radxa/radxa-cm-projects/README.md

## About

Welcome to the Radxa Computer on Module projects, this repo contains the carrier board design files released by Radxa as well as the community projects.

## CM Series

| CM Series | Description | Projects |
| --- | --- | --- |
| [Radxa CM3](https://rock.sh/cm3) | Computer on Module based on RK3566, compatible with Raspberry Pi CM4 | [CM3 Projects](./cm3/README.md) |
| [Radxa CM3I](https://rock.sh/cm3i) | Computer on Module based on RK3568(J) with industrial grade options | [CM3I Projects](./cm3i/README.md) |
| [Radxa CM4](https://rock.sh/cm4) | Computer on Module based on RK3676(J), compatible with Raspberry Pi CM4 | [CM4 Projects](./cm4/README.md) |
| [Radxa CM5](https://rock.sh/cm5) | Computer on Module based on RK3588S, compatible with Raspberry Pi CM4 | [CM5 Projects](./cm5/README.md) |

## NX Series

| NX Series | Description | Projects |
| --- | --- | --- |
| [Radxa CM3S](https://rock.sh/cm3s) | Computer on Module based on RK3566 in SODIMM form factor, compatible with Raspberry Pi CM3/CM3+ | [CM3S Projects](./cm3s/README.md) |
| [Radxa NX5](https://rock.sh/nx5) | Computer on Module based on RK3588S in SODIMM form factor | [NX5 Projects](./nx5/README.md) |
