radxa/radxa-cm-projects/cm5/README.md

## Apply for Radxa CM5

Radxa is donating some free [Radxa CM5](hhttps://rock.sh/cm5) to open source hardware projects.

## How to apply

Send a new PR to this repository on GitHub, append your application table(sort Project Name). Radxa team will review/ask questions/discuss about the project detail. If the project is interesting or welcomed by the community, we will approve it. Radxa Team will contact the developer for the further sample shipping&development etc.

## CM5 projects list:

| Project Name | CM5 Model | Hardware(Carrier Board) | Software | Notes |
|---|---|---|---|---|
| Argo | Radxa CM5 Max (16GB RAM, 128GB eMMC) | Custom Raspberry Pi–focused Carrier PCB | Ubuntu/Android | For testing with custom Raspi-focused Carrier PCB |
