radxa/radxa-cm-projects/cm3i/README.md

## Apply for Radxa CM3I

Radxa is donating some free [Radxa CM3I](https://rock.sh/cm3i) to open source hardware projects.

## How to apply

Send a new PR to this repository on GitHub, append your application table(sort Project Name). Radxa team will review/ask questions/discuss about the project detail. If the project is interesting or welcomed by the community, we will approve it. Radxa Team will contact the developer for the further sample shipping&development etc.

## CM3I projects list:

| Project Name | CM3 Model | Hardware(Carrier Board) | Software | Notes |
| --- | --- | --- | --- | ----- |
| Radxa E25 | RM118-D4E32 | [E25 Carrier Board Design](./radxa-e25/README.md) | [OpenWRT](https://https://github.com/ophub/flippy-openwrt-actions) | |
| Radxa CM3I IO Board  |  | [CM3I IO Board Design](./radxa-cm3i-io-board/README.md) |  | |
