radxa/radxa-cm-projects/nx5/radxa-nx5-io-board/README.md

# HW Design for Radxa NX5 IO board

- radxa_nx5_io_board_v1.4.DSN: io board schematic, use Orcad 16.6 or later to view it. You can download a free copy viewer [here](https://www.orcad.com/downloads/orcad-viewer)(Windows only).
- radxa_nx5_io_board_v1.4.pcb: io board layout, use Pads 2.5VX or later to view it. You can find a free copy viewer [here](https://community.sw.siemens.com/s/article/PADS-Viewers)(Windows only).

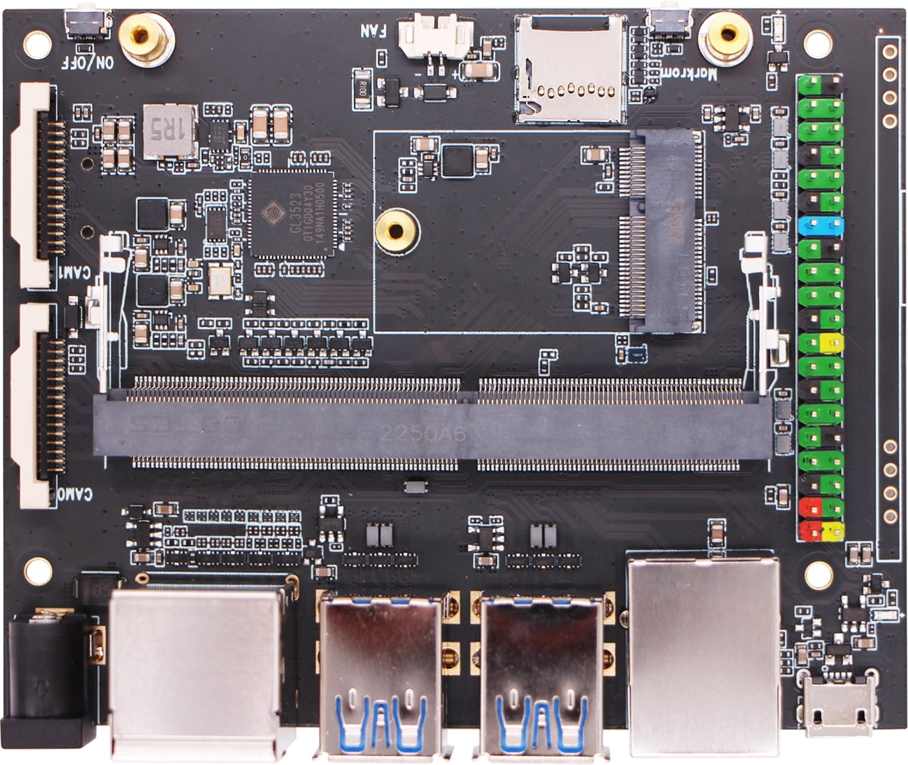
[picture p2: nx5/radxa-nx5-io-board/radxa_nx5_io_board.jpg]
Radxa NX5 IO Board
