radxa/radxa-cm-projects/cm3/radxa-cm3-io-board/README.md

# HW Design for Radxa CM3 IO board

- radxa_cm3_io_board_v1330.DSN: io board schematic, use Orcad 16.6 or later to view it. You can download a free copy viewer [here](https://www.orcad.com/downloads/orcad-viewer)(Windows only).
- radxa_cm3_io_board_v1330.pcb: io board layout, use Pads 2.5VX or later to view it. You can find a free copy viewer [here](https://community.sw.siemens.com/s/article/PADS-Viewers)(Windows only).

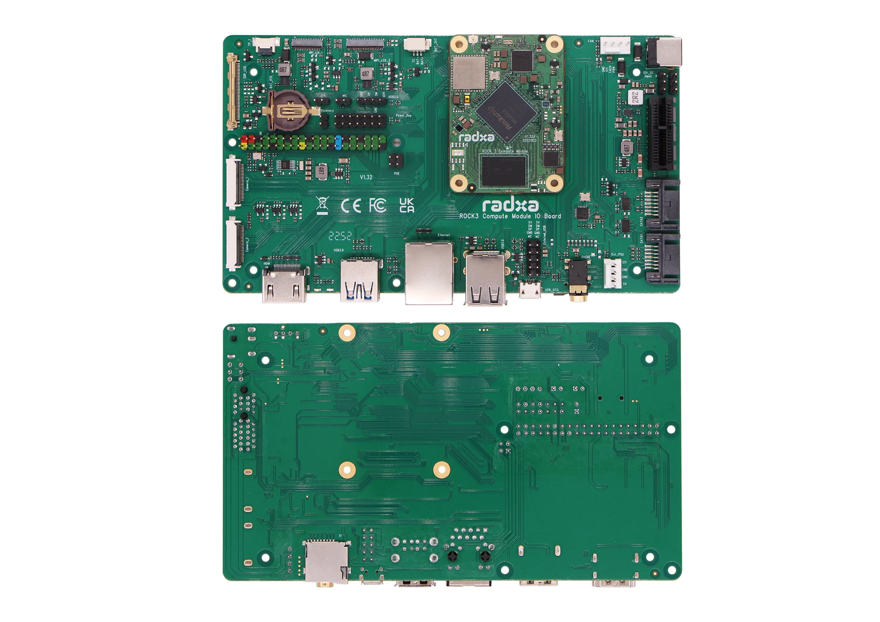
[picture p3: cm3/radxa-cm3-io-board/radxa_cm3_io_board.jpg]
Radxa CM3 IO Board
