radxa/radxa-cm-projects/cm3i/radxa-cm3i-io-board/README.md

# HW Design for Radxa CM3I IO board

- radxa_cm3i_io_board_v1.4.DSN: io board schematic, use Orcad 16.6 or later to view it. You can download a free copy viewer [here](https://www.orcad.com/downloads/orcad-viewer)(Windows only).
- radxa_cm3i_io_board_v1.4.pcb: io board layout, use Pads 2.5VX or later to view it. You can find a free copy viewer [here](https://community.sw.siemens.com/s/article/PADS-Viewers)(Windows only).

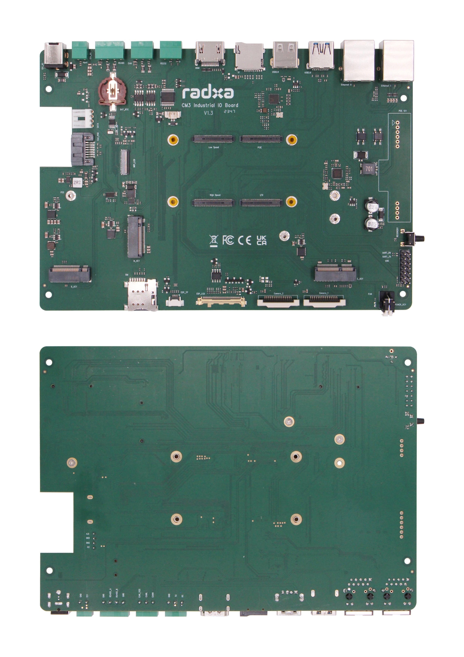
[picture p4: cm3i/radxa-cm3i-io-board/radxa_cm3i_io_board.jpg]
Radxa CM3I IO Board
