radxa/radxa-cm-projects/cm3i/radxa-e25/README.md

# HW Design for Radxa E25 Carrier Board

- Radxa_E25_V14_20220117.DSN: board schematic, use Orcad 16.6 or later to view it. You can download a free copy viewer [here](https://www.orcad.com/downloads/orcad-viewer)(Windows only).
- Radxa_E25_V1.4_20220119-padsvx.pcb: board layout PCB, use Pads 2.5VX or later to view it. You can find a free copy viewer [here](https://community.sw.siemens.com/s/article/PADS-Viewers)(Windows only).
- Radxa_E25_V1.4_20220119-pads2005.asc: board layout PCB in ASCII format, import to PADs 2005 to view it.
- Radxa_E25_V1.4_20220119.PcbDoc: board layout PCB, use Altium Designer to view it.

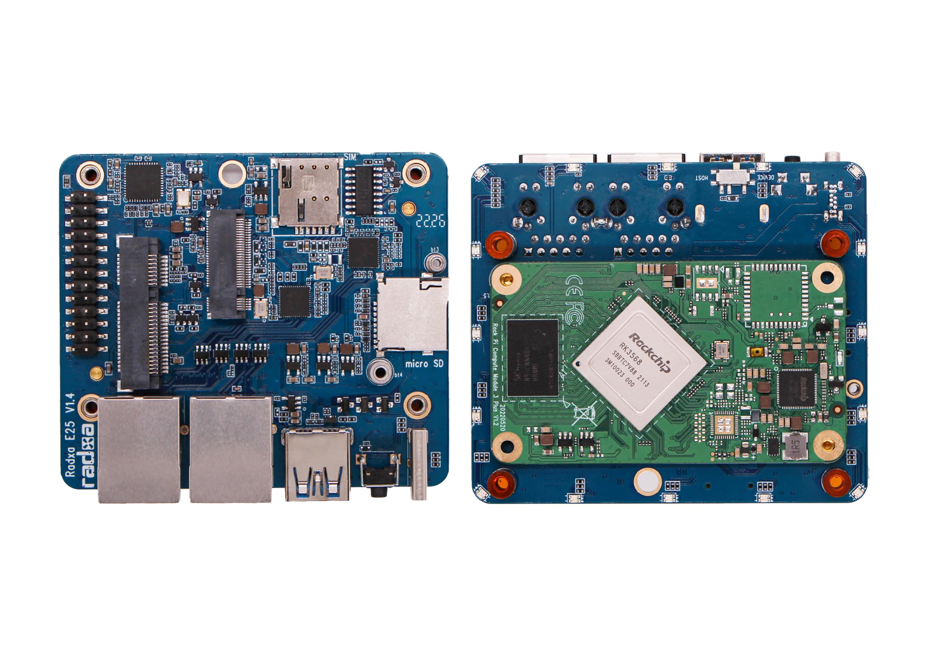
[picture p5: cm3i/radxa-e25/radxa_e25.jpg]
Radxa E25
