radxa/radxa-cm-projects/cm3s/radxa_cm3s_io_board/README.md

# HW Design for Radxa CM3S IO board

- radxa_cm3s_io_board_v1510.DSN: io board schematic, use Orcad 16.6 or later to view it. You can download a free copy viewer [here](https://www.orcad.com/downloads/orcad-viewer)(Windows only).
- radxa_cm3s_io_board_v1510.pcb: io board layout, use Pads 2.5VX or later to view it. You can find a free copy viewer [here](https://community.sw.siemens.com/s/article/PADS-Viewers)(Windows only).

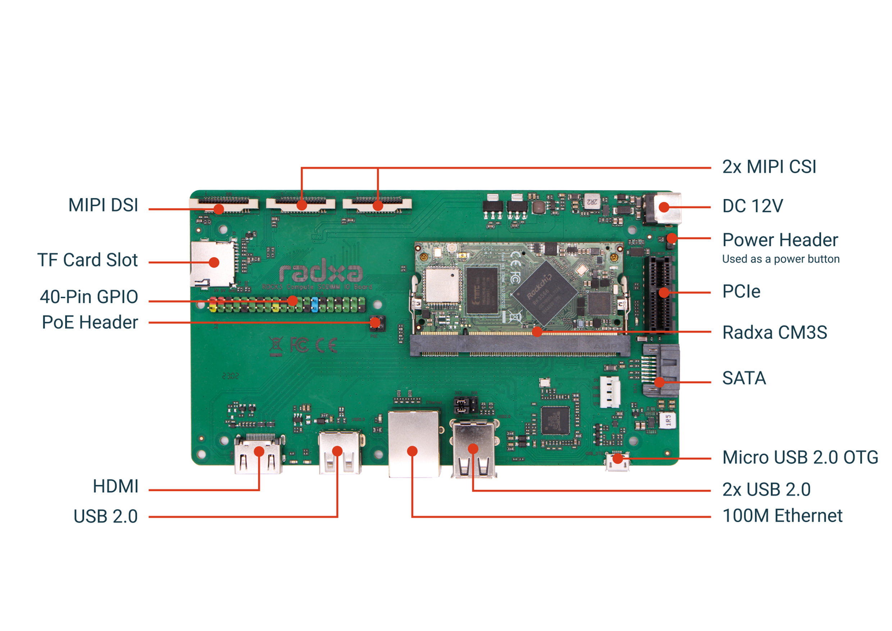
[picture p6: cm3s/radxa_cm3s_io_board/radxa_cm3s_io_board.jpg]
Radxa CM3S IO Board
