radxa/radxa-cm-projects/cm5/radxa-cm5-io-board/README.md

# HW Design for Radxa CM5 IO board

- radxa_cm5_io_board_v2200.DSN: io board schematic, use Orcad 16.6 or later to view it. You can download a free copy viewer [here](https://www.orcad.com/downloads/orcad-viewer)(Windows only).
- radxa_cm5_io_board_v2200.pcb: io board layout, use Pads 2.5VX or later to view it. You can find a free copy viewer [here](https://community.sw.siemens.com/s/article/PADS-Viewers)(Windows only).

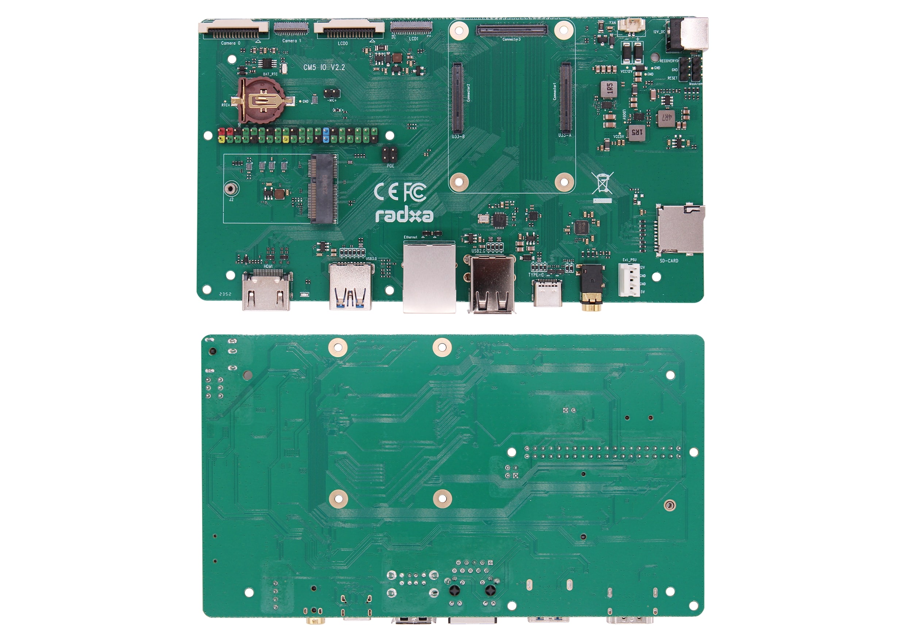
[picture p7: cm5/radxa-cm5-io-board/radxa_cm5_io_board.jpg]
Radxa CM5 IO Board
