radxa/radxa-cm-projects/cm4/README.md

## Apply for Radxa CM4

Radxa is donating some free [Radxa CM4](hhttps://rock.sh/cm4) to open source hardware projects.

## How to apply

Send a new PR to this repository on GitHub, append your application table(sort Project Name). Radxa team will review/ask questions/discuss about the project detail. If the project is interesting or welcomed by the community, we will approve it. Radxa Team will contact the developer for the further sample shipping&development etc.

## CM4 projects list:

| Project Name | CM4 Model | Hardware(Carrier Board) | Software | Notes |
| --- | --- | --- | --- | --- |
