radxa/radxa-cm-projects/cm3s/README.md

## Apply for Radxa CM3S

Radxa is donating some free [Radxa CM3S](https://rock.sh/cm3s) to open source hardware projects.

## How to apply

Send a new PR to this repository on GitHub, append your application table(sort Project Name). Radxa team will review/ask questions/discuss about the project detail. If the project is interesting or welcomed by the community, we will approve it. Radxa Team will contact the developer for the further sample shipping&development etc.

## CM3S projects list:

| Project Name | CM3S Model | Hardware(Carrier Board) | Software | Notes |
| --- | --- | --- | --- | --- |
