radxa/radxa-cm-projects/nx5/README.md

## Apply for Radxa NX5

Radxa is donating some free [Radxa NX5](https://rock.sh/nx5) to open source hardware projects.

## How to apply

Send a new PR to this repository on GitHub, append your application table(sort Project Name). Radxa team will review/ask questions/discuss about the project detail. If the project is interesting or welcomed by the community, we will approve it. Radxa Team will contact the developer for the further sample shipping&development etc.

## NX5 projects list:

| Project Name | NX5 Model | Hardware(Carrier Board) | Software | Notes |
| --- | --- | --- | --- | --- |
