radxa/radxa-cm-projects/cm4/radxa-cm4-io-board/radxa_cm4_io_bom_v1.10.xlsx

子物料名称 | 子物料规格型号描述 | 数量 | 装配位置
RJ45座 | DIP 母座 千兆网 带POE功能 18PIN 21.5*16*13.7mm HRK1-1B71PG536A1BB-1R 带指示灯 无弹片 左绿右黄 镀镍 HULYN(惠兴力) ROHS | 1 | J6
RJ45座 | DIP 母座 千兆网 带POE功能 18PIN 21.5*16*13.7MM LPJG0926HENL 带指示灯 无弹片 左绿右黄 镀镍 LINK-PP(连普) ROHS | 1 | J6
DC座 | DIP 6PIN DC-044A-A250 内孔Φ6mm 铁芯Φ2.5mm 9.93*11.7*H7.2mm XUNPU(讯普) ROHS | 1 | J24
USB2.0母座 | DIP USB2.0母座 双层 卷边无定位柱 黑色胶芯 17.5x14.6xH15.7mm 90度弯脚 弯脚固定间距15.4mm 铜壳 BUSF082B1N12438L 耐高温 BVT-LINK(兴联精密) ROHS | 1 | J13
排座 | DIP 排针座 2*2PIN 180度 2.54mm脚距 中间朔高2.5mm 针长一端6.1mm 另一端3.0mm 黑色 PH2.54 2*02P L=11.6/3.0 S/T 国意英 ROHS | 1 | J7
排座 | DIP 排针座 1*2PIN 180度 2.0mm脚距 中间朔高2.0mm 针长一端3.9mm 另一端2.8mm 方针 黑色 ZX-PZ2.0-1-2PZZ Megastar(兆星) ROHS | 2 | J18,J19
排座 | DIP 排针座 1*2PIN 180度 2.54mm脚距 中间朔高2.5mm 针长一端6.1mm 另一端3.0mm 黑色 PH2.54 1*2P L=11.6/3.0 国意英 ROHS | 1 | J2
排座 | DIP 排针座 1*3PIN 180度 2.54mm脚距 中间朔高2.5mm 针长一端6.1mm 另一端3.0mm 材质LCP 黑色 PH2.54 1*3P L=11.6/3.0 国意英 ROHS | 1 | J22
排座 | DIP 排针座 1*4PIN 180度 无定位柱 2.54mm脚距 针长一端8.3mm 另一端3.5mm 小4PIN 白色 M2545V-4P XFCN(兴飞) ROHS | 1 | J4
排座 | DIP 排针座 2*20PIN 180度 2.54mm脚距 中间朔高2.5mm 针长一端6.1mm 另一端3.0mm 彩色 PH-A-40D-A6C3-D-RGB 闻川 ROHS | 1 | J11
排座 | DIP 排针座 2*20PIN 180度 2.54mm脚距 中间朔高2.5mm 针长一端6.1mm 另一端3.0mm 彩色 PH2.54 2*20P 彩印 L=11.6/3.0 国意英 ROHS | 1 | J11
排座 | DIP 排针座 2*7PIN 180度 2.54mm脚距 中间朔高2.5mm 针长一端6.1mm 另一端3.0mm 黑色 PH2.54 2*7P L=11.6/3.0 S/T 国意英 ROHS | 1 | J17
PCBA | RC126 V1.104 Radxa CM4 IO Board | 1
PCB板 | RC126 V1.10 160*90*1.6mm FR-4 4层板 表面沉金处理 哑光绿油 白色丝印 ROHS | 1
贴片电阻 | SMD 0201 0R 1/20W ±5% ROHS | 29 | R26,R27,R178,R214,R223,R231,R233,R237,R252,R273,R274,R276,R284,R293,R294,R295,R296,R297,R320,R328,R346,R347,R348,R349,R279,R357,R226,R217,R232
贴片电阻 | SMD 0201 100K 1/20W ±1% ROHS | 26 | R5,R6,R176,R182,R185,R202,R206,R236,R257,R305,R315,R319,R321,R329,R330,R331,R332,R333,R334,R335,R336,R337,R338,R339,R344,R355
贴片电阻 | SMD 0201 100R 1/20W ±5% ROHS | 1 | R304
贴片电阻 | SMD 0201 10K 1/20W ±1% ROHS | 21 | R8,R9,R11,R12,R209,R211,R212,R240,R250,R251,R261,R262,R270,R271,R303,R323,R351,R358,R72,R327,R210
贴片电阻 | SMD 0201 150K 1/20W ±1% ROHS | 1 | R249
贴片电阻 | SMD 0201 15K 1/20W ±1% ROHS | 1 | R247
贴片电阻 | SMD 0201 1K 1/20W ±1% ROHS | 6 | R14,R19,R208,R246,R322,R350
贴片电阻 | SMD 0201 2.2K 1/20W ±5% ROHS | 1 | R291
贴片电阻 | SMD 0201 22R 1/20W ±1% ROHS | 10 | R2,R29,R109,R228,R234,R256,R258,R259,R260,R265
贴片电阻 | SMD 0201 232K 1/20W ±1% ROHS | 3 | R187,R285,R287
贴片电阻 | SMD 0201 2M 1/20W ±5% ROHS | 2 | R340,R341
贴片电阻 | SMD 0201 3.3K 1/20W ±1% ROHS | 1 | R281
贴片电阻 | SMD 0201 3.3R 1/20W ±5% ROHS | 1 | R115
贴片电阻 | SMD 0201 340R 1/20W ±1% ROHS | 1 | R354
贴片电阻 | SMD 0201 4.7K 1/20W ±5% ROHS | 2 | R3,R7
贴片电阻 | SMD 0201 470R 1/20W ±5% ROHS | 2 | R316,R317
贴片电阻 | SMD 0201 49.9K 1/20W ±1% ROHS | 2 | R290,R318
贴片电阻 | SMD 0201 5.1K 1/20W ±5% ROHS | 1 | R177
贴片电阻 | SMD 0201 510K 1/20W ±1% ROHS | 1 | R289
贴片电阻 | SMD 0201 510R 1/20W ±5% ROHS | 4 | R238,R253,R221,R227
贴片电阻 | SMD 0201 51K 1/20W ±1% ROHS | 1 | R205
贴片电阻 | SMD 0201 7.5K 1/20W ±5% ROHS | 1 | R175
贴片电阻 | SMD 0201 75R 1/20W ±5% ROHS | 1 | R201
贴片电阻 | SMD 0201 8.2K 1/20W ±1% ROHS | 1 | R179
贴片电阻 | SMD 0402 0R 1/16W ±5% ROHS | 1 | R254
贴片电阻 | SMD 0603 2R 1/10W ±5% ROHS | 2 | R244,R245
陶瓷电容 | SMD 0201 100NF 25V X5R ±20% ROHS | 61 | C1,C79,C90,C144,C146,C148,C152,C154,C158,C159,C163,C168,C169,C171,C174,C175,C178,C180,C181,C184,C186,C188,C191,C193,C194,C197,C199,C204,C205,C206,C208,C210,C212,C214,C215,C218,C220,C221,C222,C225,C226,C228,C230,C231,C235,C236,C238,C240,C243,C249,C250,C251,C252,C253,C254,C269,C271,C282,C298,C83,C162
陶瓷电容 | SMD 0201 100PF 50V NPO ±5% ROHS | 4 | C286,C293,C201,C242
陶瓷电容 | SMD 0201 10NF 10V X5R ±20% ROHS | 4 | C284,C289,C291,C296
陶瓷电容 | SMD 0201 12PF 50V COG ±5% ROHS | 1 | C187
陶瓷电容 | SMD 0201 1UF 10V X5R ±20% ROHS | 9 | C150,C151,C196,C247,C248,C270,C277,C283,C290
陶瓷电容 | SMD 0201 2.2NF 25V X7R ±10% ROHS | 1 | C155
陶瓷电容 | SMD 0201 220NF 25V X5R ±10% ROHS | 1 | C77
陶瓷电容 | SMD 0201 220PF 50V NPO ±5% ROHS | 2 | C257,C258
陶瓷电容 | SMD 0201 22PF 50V NPO ±5% ROHS | 2 | C160,C217
陶瓷电容 | SMD 0201 680PF 50V X7R ±10% ROHS | 4 | C287,C288,C294,C295
陶瓷电容 | SMD 0201 82PF 50V COG ±2% ROHS | 2 | C279,C280
陶瓷电容 | SMD 0402 10UF 10V X5R ±20% ROHS | 11 | C190,C192,C203,C207,C209,C227,C229,C233,C234,C237,C239
陶瓷电容 | SMD 0402 4.7UF 10V X5R ±20% ROHS | 6 | C202,C241,C244,C272,C273,C274
陶瓷电容 | SMD 0603 10UF 10V X5R ±10% ROHS | 9 | C167,C176,C179,C182,C183,C185,C172,C285,C292
陶瓷电容 | SMD 0603 2.2UF 50V X5R ±10% ROHS | 1 | C177
陶瓷电容 | SMD 0603 22UF 10V X5R ±20% ROHS | 19 | C78,C106,C107,C153,C156,C157,C164,C198,C200,C213,C216,C255,C275,C278,C297,C211,C219,C223,C224
陶瓷电容 | SMD 0805 22UF 25V X5R ±20% ROHS | 4 | C84,C89,C161,C256
肖特基二极管 | SMD 编带 DO-214AC SS34 CJ(江苏长电/长晶) ROHS | 1 | D24
肖特基二极管 | SMD 编带 DO-214AC SS54 晶导微电子 ROHS | 1 | D4
肖特基二极管 | SMD 编带 SOD-323 B5819WS CJ(江苏长电/长晶) ROHS | 1 | D6
肖特基二极管 | SMD 编带 SOD-523 SD103AX CJ(江苏长电/长晶) ROHS | 1 | D8
肖特基二极管 | SMD 编带 SOT-23 BAT54C 30V 0.2A CJ(江苏长电/长晶) ROHS | 1 | D29
发光二极管 | SMD 编带 0603 发绿光 单色 mcd=150 IF=20mA 无色散光 EY-TB0603GC-010F 恩域光电 ROHS | 1 | LED3
发光二极管 | SMD 编带 0603 发红光 单色 mcd=150 IF=20mA 无色散光 EY-PB0603RC-010F 恩域光电 ROHS | 1 | LED2
三极管 | SMD 编带 SOT-23 S8050 NPN CJ(江苏长电/长晶) ROHS | 2 | Q18,Q23
MOS管 | SMD 编带 SOT23-3 AO3401A P沟道 AOS ROHS | 2 | Q12,Q24
MOS管 | SMD 编带 SOT-23-3L AO3416 N沟道 AOS ROHS | 1 | Q21
MOS管 | SMD 编带 SOT-323 2SK3018 N沟道 CJ(江苏长电/长晶) ROHS | 4 | Q2,Q3,Q19,Q20
MOS管 | SMD 编带 SOT-23 WPM2083-3/TR P沟道 WILLSEMI(韦尔) ROHS | 3 | Q1,Q17,Q22
MOS管 | SMD 编带 SOT-23 WPM2015-3/TR P沟道 WILLSEMI(韦尔) ROHS | 3 | Q1,Q17,Q22
MOS管 | SMD 编带 SOT-323 WNM2021-3/TR N沟道 WILLSEMI(韦尔) ROHS | 2 | Q13,Q25
ESD管 | SMD 编带 DFN2510-10L BTRD10A01 4Line 0.1pF B-TRON(比创达) ROHS | 4 | U34,U35,U18,U19
ESD管 | SMD 编带 0402 BTR04G02 B-TRON(比创达) ROHS | 43 | D2,D3,D7,D9,D10,D11,D12,D14,D15,D16,D17,D18,D19,D20,D21,D22,D23,D25,D26,D27,D28,D31,D32,D33,D34,D35,D36,D37,D38,D39,D40,D41,D42,D43,D44,D45,D46,D47,D48,D49,D50,D51,D52
TVS管 | SMD 编带 SOD-123 SMF18A 晶导微电子 ROHS | 1 | D5
TVS管 | SMD SOD-123FL SMF5.0CA 晶导微电子 ROHS | 1 | D1
贴片功率电感 | SMD 带屏蔽 2.5x2x1.2mm 1UH 4A ±20% RHP252012T-1R0MT 仁芯微 ROHS | 2 | L22,L29
贴片功率电感 | SMD 带屏蔽 2.5x2.0x1.26mm 1UH 3.4A ±30% RXWHJ252012-1R0NT 仁芯微 ROHS | 2 | L22,L29
贴片功率电感 | SMD 带屏蔽 3x3x1.5mm 4.7UH 3.5A ±20% RHP3015T-4R7MT 仁芯微 ROHS | 1 | L20
贴片功率电感 | SMD 带屏蔽 3x3x1.55mm 4.7UH 1.9A ±20% RXWHJ3015-4R7MT 仁芯微 ROHS | 1 | L20
贴片功率电感 | SMD 带屏蔽 4x4x2mm 4.7UH 3.3A ±20% RXWHJ4020-4R7MT 仁芯微 ROHS | 1 | L21
贴片功率电感 | SMD 带屏蔽 5.4*5.2*1.8mm 4.7UH 3.5A ±20% RXWSHC0520-4R7M 仁芯微 ROHS | 1 | L15
贴片功率电感 | SMD 带屏蔽 7.2x6.6x5mm 2.2UH 8A ±20% RXWSHC0650-2R2M 仁芯微 ROHS | 1 | L2
共模电感 | SMD BCMEF122P900H 90R 6PIN 带ESD ±25% B-TRON(比创达) ROHS | 4 | L16,L17,L18,L19
共模电感 | SMD BCMF122P900H 90R 4PIN 不带ESD ±5% B-TRON(比创达) ROHS | 4 | FB8,L23,L24,L31
贴片磁珠 | SMD 0201 FB120R 1A MPZ0603S121HT000 ±25% ROHS | 6 | FB14,FB15,FB16,FB17,FB21,R31
贴片磁珠 | SMD 0402 FB120R 2A ±25% BLM15PX121SN1D muRata(村田) ROHS | 10 | FB1,FB3,FB4,FB5,FB9,FB22,FB23,FB24,FB25,FB26
贴片磁珠 | SMD 0603 FB120R 2A ±25% PZ1608U121-2R0TF Sunlord(顺络) ROHS | 1 | FB2
贴片磁珠 | SMD 1206 FB60R 5A ±25% HCB3216KF-600T50 TAI-TECH(台庆) ROHS | 2 | R17,R18
IC | SMD ADC/DAC-专用型 ES8388 QFN-28 Everest-semi(顺芯) ROHS | 1 | U27
IC | SMD DC-DC NB679GD-Z QFN-12 MPS(芯源) ROHS | 1 | U10
IC | SMD DC-DC SY8113BADC TSOT23-6 silergy(矽力杰) ROHS | 2 | U13,U29
IC | SMD USB限流 SY6280AAC 2A SOT23-5 silergy(矽力杰) ROHS | 1 | U25
IC | SMD USB转换芯片 FUSB302MPX MLP-14 onsemi(安森美) ROHS | 1 | U36
IC | SMD 功率电子开关 FPF2595UCX WLCSP12 onsemi(安森美) ROHS | 1 | U37
IC | SMD 降压转换器 TMI3112H SOT23-5 TMI(拓尔微) ROHS | 2 | U26,U30
IC | SMD 升压 SY7203DBC DFN-10(3x3) silergy(矽力杰) ROHS | 1 | U21
IC | SMD 实时时钟(RTC) TCS8563-MH MSOP-8 TCS(汤诚) ROHS | 1 | U22
IC | SMD 音频功率放大器 TCS7191A_MH MSOP-8 TCS(汤诚) ROHS | 2 | U31,U32
石英晶振 | SMD 编带 无源 3215 32.768KHz 12.5PF ±20ppm TAITIEN XDMCZLNDDD-32.768KHz ROHS | 1 | Y3
石英晶振 | SMD 有源 3225 27MHz 3.3V ±10ppm 晶灏 3N27.000E33YCG ROHS | 1 | Y1
电池座 | SMD 电池座 2PIN 15.4*14.2*4.1mm BS-12-B2AA002 MYOUNG(美阳) ROHS | 1 | J23
TYPEC座 | SMD 母座 2*12PIN 双排 8.94x7.9xH3.2mm 带定位柱 不锈钢 BUSF242B3N11677 BVT-LINK(兴联精密) ROHS | 1 | J15
USB3.0母座 | SMD USB3.0母座 单层 直边无定位柱 蓝色胶芯 14.5*13*H6.8mm 90度直边 直脚固定间距12.6mm U231-091N-4BLRA00-F 星坤 鱼叉脚 脚长2.7mm ROHS | 1 | USB1
TF卡座 | SMD XKTF-N02-N 14.7*14.8*H1.95mm 9PIN 不锈钢 XKB(星坤) ROHS | 1 | J8
HDMI座 | SMD A座 19PIN 180度 卧贴 12.1*15*6.05mm 镀镍 脚距14.5mm 长款 短脚1.2mm 916000-000004 闻川 ROHS | 1 | J5
HDMI座 | SMD A座 19PIN 180度 卧贴 12.1*15*6.05mm 镀镍 脚距14.5mm 长款 常规2.2mm BHDF192B1N11361SR BVT-LINK(兴联精密) ROHS | 1 | J5
耳机插座 | SMD PJ-342CB-TG-SMT 6PIN 外孔Φ6.0mm 内孔Φ3.6mm 前插后贴 14*6.4*H4.5MM 黑色 镀金铜头 XKB(星坤) ROHS | 1 | J25
FPC座 | SMD 翻盖式下接触 卧式 15PIN 180度 1.0mm脚距 H2.0 FPC-1.0FX-15PWCR-H20 XUNPU(讯普) ROHS | 2 | J9,J10
FPC座 | SMD 上下接触 卧式 31PIN 0.3mm脚距 后翻盖H1.0 FH35C-31S-0.3SHW(50) 镀金 广濑 ROHS | 1 | J16
FPC座 | SMD 下接触 卧式 39PIN 0.3mm脚距 后翻盖H1.0 FH35C-39S-0.3SHW(50) 镀金 广濑 ROHS | 1 | U20
连接座 | SMD 公座 2*15PIN 180度 7.5*2.7mm 0.4mm脚距 GY0037P030 黑色 闻川 ROHS | 1 | J12_1
连接座 | SMD 公座 2*17PIN 180度 8.3*2.7 0.4mm脚距 GY0037P034 黑色 闻川 ROHS | 1 | J12
连接座 | SMD 母座 1*2PIN 90度 立贴 1.25mm脚距 白色 12508-2AB 闻川 ROHS | 1 | J14
连接座 | SMD 母座 2*50PIN 180度 0.4mm脚距 黑色 DF40C-100DS-0.4V(51) HRS(广濑) ROHS | 3 | J3,connector_2,connector_1
连接座 | SMD 母座 75PIN 180度 0.5mm脚距 M.2 M KEY H8.5 黑色 APCI0164-P001A LOTES ROHS | 1 | J30
表贴螺母 | SMD 编带 M2 通孔 一端∅5mm 高6.6mm 另一端∅2.5mm 高1.5mm 总高8.8mm (带定位台阶φ2.5mm 高度0.7mm 贴高温胶纸) 适配H8.5高M.2座 铜 镀锡 DDSMT20241011288 ROHS | 1 | HOLE2
