radxa/radxa-cm-projects/nx5/radxa-nx5-io-board/radxa_nx5_io_board_v1.4_BOM.xlsx

BOM层级 | 子项物料编码 | 物料名称 | 规格型号 | 标准用量 | 位置号 | 原厂料号 | 品牌 | 原厂料号2 | 品牌2
0 | HHH01.00078 | 机板 | RC121 NX5 IO V1.401 电子物料清单 (RC121-V1.401) | 1
.1 | A1J04.00001 | HDMI座 | DIP DP+HDMI座 BVT-LINK BHDM39B1N1289 38PIN 18.05*18.10*H19.30mm 有定位柱 不锈钢 无卷边 针长2.5mm ROHS | 1 | J6 | BHDM39B1N1289 | BVT-LINK
.1 | A1J11.00001 | DC座 | DIP 3PIN DS-210-B 内孔Φ6.3mm 铁芯Φ2.0mm 10.9*9.0*14.2mm 协佳 ROHS | 1 | J13 | DS-210-B | 协佳
.1 | A1J02.00007 | USB3.0母座 | DIP USB3.0母座 双层 卷边无定位柱 蓝色胶芯 17.5*14.5*H15.5mm 90度弯脚 弯脚固定间距15.6mm 不锈钢 5001-C01010013 文章济美 ROHS | 2 | J11,J12 | 5001-C01010013 | 文章济美
.1 | A1J03.00002 | RJ45座 | DIP 母座 千兆网 带POE功能 18PIN 21.5*16*13.7MM LPJG0926HENL 镀镍 带指示灯 无弹片 左绿右黄 LP ROHS | 1 | J4 | LPJG0926HENL | LP
.1 | A1J01.00012 | 排座 | DIP 排针座 2*20PIN 180度 2.54mm脚距 中间朔高2.5mm 针长一端6.1mm 另一端3mm 彩色 PH2.54 2*20P 彩印 L=11.6/3.0 ROHS | 1 | CON1 | PH2.54 2*20P 彩印 L=11.6/3.0 | 国意英
.1 | TPT01.00117 | PCBA | RC121 NX5 IO V1.401 电子物料清单 (RC121-V1.401) | 1
..2 | A1P01.00256 | PCB板 | RC121 V1.4 110.00*160.10 /2 H1.6mm TG150 FR-4 6层板 沉金1U" 内外铜厚1oz 哑光黑油 白色丝印 ROHS | 1
..2 | A1R01.00027 | 贴片电阻 | SMD 0201 0R 1/20W ±5% ROHS | 2 | R145，R953 | RTT01000JTH | RALEC
..2 | A1R01.00024 | 贴片电阻 | SMD 0201 22R 1/20W ±5% ROHS | 5 | R138,R139,R140,R141,R142 | RC-01W220JT | FH
..2 | A1R01.00073 | 贴片电阻 | SMD 0201 499R 1/20W ±1% ROHS | 8 | R95101,R95102,R95103,R95104,R95106,R95107,R95108,R95109 | RC-01W4990FT | FH
..2 | A1R01.00074 | 贴片电阻 | SMD 0201 4.53K 1/20W ±1% ROHS | 2 | R114,R116 | RTT014531FTH | RALEC
..2 | A1R01.00014 | 贴片电阻 | SMD 0201 4.7K 1/20W ±5% ROHS | 1 | R95121 | RC-01W472JT | FH
..2 | A1R01.00075 | 贴片电阻 | SMD 0201 6.8K 1/20W ±5% ROHS | 1 | R95195 | RC-01W682JT | FH
..2 | A1R01.00086 | 贴片电阻 | SMD 0201 8.2K 1/20W ±1% ROHS | 1 | R95055 | RC-01W8201FT | FH
..2 | A1R01.00012 | 贴片电阻 | SMD 0201 10K 1/20W ±5% ROHS | 11 | R102,R104,R105,R106,R107,R108，R124,R127，R99，R144，R951 | RTT01103JTH | RALEC | RC-01W103JT | FH
..2 | A1R01.00087 | 贴片电阻 | SMD 0201 20K 1/20W ±5% ROHS | 1 | R103 | RC-01W203JT | FH
..2 | A1R01.00061 | 贴片电阻 | SMD 0201 47K 1/20W ±1% ROHS | 1 | R95051 | RC0201FR-0747KL | YAGEO | RTT014702FTH | RALEC
..2 | A1R01.00006 | 贴片电阻 | SMD 0201 100K 1/20W ±5% ROHS | 6 | R95,R96,R97,R98，R95056,R95057 | RC-01W104JT | FH | RTT01104JTH | RALEC
..2 | A1R01.00088 | 贴片电阻 | SMD 0201 390K 1/20W ±5% ROHS | 1 | R95054 | RC-01W394JT | FH
..2 | A1R01.00089 | 贴片电阻 | SMD 0201 510K 1/20W ±5% ROHS | 1 | R95048 | RC-01W514JT | FH
..2 | A1R01.00090 | 贴片电阻 | SMD 0201 1M 1/20W ±5% ROHS | 1 | R101 | RTT01105JTH | RALEC
..2 | A1R01.00030 | 贴片电阻 | SMD 0402 0R 1/16W ±5% ROHS | 9 | R126,R95180,R95204，R75,R78，R95202，R95059,R95206,R95207 | RC-02000JT | FH
..2 | A1R01.00049 | 贴片电阻 | SMD 0402 3.3R 1/16W ±5% ROHS | 1 | R95046 | RHC-02U3R3JT | FH
..2 | A1R01.00078 | 贴片电阻 | SMD 0402 330R 1/16W ±5% ROHS | 2 | R76,R77 | RC-02W331JT | FH
..2 | A1R01.00067 | 贴片电阻 | SMD 0402 1K 1/16W ±5% ROHS | 1 | R95097 | RC-02K102JT | FH | 0402WGJ0102TCE | UNIOHM
..2 | A1R01.00079 | 贴片电阻 | SMD 0402 1.2K 1/16W ±5% ROHS | 2 | R95105,R95116 | RTT02122JTH | RALEC
..2 | A1R01.00080 | 贴片电阻 | SMD 0402 1.8K 1/16W ±5% ROHS | 2 | R95095,R95098 | 0402WGJ0182TCE | UNI-ROYAL
..2 | A1R01.00041 | 贴片电阻 | SMD 0402 2.2K 1/16W ±5% ROHS | 1 | R95203 | RTT02222JTH | RALEC
..2 | A1R01.00051 | 贴片电阻 | SMD 0402 4.7K 1/16W ±5% ROHS | 12 | R5,R6,R7,R8,R61,R65,R66,R132,R133,R95189,R95190,R95227 | 0402WGJ0472TCE | UNI-ROYAL
..2 | A1R01.00034 | 贴片电阻 | SMD 0402 10K 1/16W ±5% ROHS | 6 | R9,R95094,R95096，R95191，R95198，R95205 | RC-02W103JT | FH
..2 | A1R01.00039 | 贴片电阻 | SMD 0402 18K 1/16W ±5% ROHS | 1 | R95192 | RTT02183JTH | RALEC
..2 | A1R01.00082 | 贴片电阻 | SMD 0402 20K 1/16W ±5% ROHS | 1 | R110 | RC-02K203JT | FH
..2 | A1R01.00083 | 贴片电阻 | SMD 0402 22K 1/16W ±1% ROHS | 2 | R125,R95200 | RC-02W2202FT | FH
..2 | A1R01.00047 | 贴片电阻 | SMD 0402 27K 1/16W ±5% ROHS | 2 | R95111,R95112 | RC-02W273JT | FH
..2 | A1R01.00053 | 贴片电阻 | SMD 0402 47K 1/16W ±5% ROHS | 7 | R95100,R95110,R95115,R95117,R95118，R57,R60 | RTT02473JTH | RALEC
..2 | A1R01.00032 | 贴片电阻 | SMD 0402 100K 1/16W ±5% ROHS | 4 | R95119,R95120，R95171,R95197 | RC-02W104JT | FH
..2 | A1R01.00031 | 贴片电阻 | SMD 0402 100K 1/16W ±1% ROHS | 4 | R111,R123,R95199，R112 | RTT021003FTH | RALEC | RC-02W1003FT | FH
..2 | A1R01.00084 | 贴片电阻 | SMD 0402 1M 1/16W ±5% ROHS | 1 | R500 | RC-02W105JT | FH
..2 | A1R01.00058 | 贴片电阻 | SMD 0603 0R 1/10W ±5% ROHS | 1 | R94 | RS-03000JT | FH | RTT03000JTP | RALEC
..2 | A1R01.00085 | 贴片电阻 | SMD 1206 0.1R 1/4W ±5% ROHS | 1 | R95060 | RTT06R10JTP | RALEC
..2 | A1C01.00141 | 陶瓷电容 | SMD 0201 10PF 50V NPO ±5% ROHS | 2 | C83,C84 | 0201N100J500CT | Walsin(华新科)
..2 | A1C01.00044 | 陶瓷电容 | SMD 0201 100NF 16V X7R ±10% ROHS | 40 | C68,C69,C70,C71,C72,C73,C74,C75,C77,C78,C79,C80,C85,C86,C87,C88,C89,C93,C94,C95,C96,C97,C98,C99,C100，C54,C55，C90495，C81,C90425,C300,C90473,C90476,C90477,C90478,C90479,C90485,C90486,C90526,C90527 | GRM033Z71C104KE14D | muRata
..2 | A1C01.00082 | 陶瓷电容 | SMD 0201 220NF 16V X5R ±20% ROHS | 8 | C90461,C90462,C90463,C90464,C90465,C90466,C90467,C90468 | C0201X5R224M160NTJ | EYANG
..2 | A1C01.00020 | 陶瓷电容 | SMD 0201 1UF 16V X5R ±20% ROHS | 3 | C76,C82，C101 | CL03A105MO3NRNH | SAMSUNG
..2 | A1C01.00174 | 陶瓷电容 | SMD 0201 1UF 10V X5R ±10% ROHS | 1 | C90426 | C0603X5R105KDTS | DARFON(达方)
..2 | A1C01.00156 | 陶瓷电容 | SMD 0402 100PF 50V NPO ±5% ROHS | 4 | C104,C119,C90529，C90472 | CC0402JRNPO9BN101 | YAGEO
..2 | A1C01.00001 | 陶瓷电容 | SMD 0402 100NF 16V X5R ±20% ROHS | 19 | C106,C121,C90422,C90533，C103,C118,C90428,C90531，C124,C90195，C2,C3,C4,C5,C6,C10,C53，C56,C57 | CL05A104MO5NNNC | SAMSUNG
..2 | A1C01.00048 | 陶瓷电容 | SMD 0402 220NF 16V X5R ±10% ROHS | 1 | C90523 | 0402X224K160NT | FH
..2 | A1C01.00002 | 陶瓷电容 | SMD 0402 1UF 16V X5R ±20% ROHS | 3 | C90418,C90419，C90469 | CL05A105MO5NNNC | SAMSUNG | CL05A105KO5NNNC | SAMSUNG
..2 | A1C01.00049 | 陶瓷电容 | SMD 0402 1UF 6.3V X5R ±20% ROHS | 1 | C90482 | 0402X105M6R3NT | FH
..2 | A1C01.00031 | 陶瓷电容 | SMD 0402 4.7UF 16V X5R ±20% ROHS | 2 | C122,C123 | CL05A475MO5NUNC | SAMSUNG(三星)
..2 | A1C01.00025 | 陶瓷电容 | SMD 0402 10UF 10V X5R ±20% ROHS | 3 | C90,C91,C92 | CL05A106MP5NUNC | SAMSUNG
..2 | A1C01.00051 | 陶瓷电容 | SMD 0603 100NF 50V X7R ±10% ROHS | 1 | C90521 | 0603B104K500CT | Walsin
..2 | A1C01.00016 | 陶瓷电容 | SMD 0603 10UF 16V X5R ±20% ROHS | 10 | C7,C8,C9,C107,C108,C90194,C90483,C90484,C90528，C90496 | CL10A106MO8NQNC | SAMSUNG
..2 | A1C01.00052 | 陶瓷电容 | SMD 0805 100NF 16V X7R ±10% ROHS | 1 | C63 | CC0805KRX7R7BB104 | YAGEO
..2 | A1C01.00053 | 陶瓷电容 | SMD 0805 22UF 16V X5R ±20% ROHS | 4 | C90474,C90475,C90522,C90524 | CL21A226MOQNNNE | SAMSUNG
..2 | A1C01.00054 | 陶瓷电容 | SMD 0805 22UF 6.3V X5R ±20% ROHS | 7 | C105,C120,C90532，C102,C117,C90530，C58 | CL21A226MQQNNNE | SAMSUNG
..2 | A1C01.00055 | 陶瓷电容 | SMD 1206 10UF 25V X5R ±20% ROHS | 2 | C90414,C90415 | CL31A106KAHNNNE | SAMSUNG
..2 | A1C01.00056 | 陶瓷电容 | SMD 1206 10UF 16V X5R ±10% ROHS | 1 | C90427 | 1206X106K160NT | FH
..2 | A1D03.00002 | 发光二极管 | SMD编带 0603 发绿光 单色 mcd=150 IF=20mA 无色散光 ROHS | 1 | LED705 | EY-TB0603GC-010F | 恩域光电
..2 | A1D03.00001 | 发光二极管 | SMD 编带 0603 发蓝光 单色 mcd=150 IF=20mA 无色散光 EY-TB0603BC-010F 恩域光电 ROHS | 1 | LED706 | EY-TB0603BC-010F | 恩域光电
..2 | A1D02.00010 | 肖特基二极管 | SMD 编带 SOD-123 B5819W 长电 ROHS | 2 | D5001,D1 | B5819W | 长电
..2 | A1D02.00005 | 肖特基二极管 | SMD 编带 SOD-323 B5819WS 晶导微 ROHS | 3 | D5005,D5007，D90010 | B5819WS | 晶导微
..2 | A1D02.00012 | 肖特基二极管 | SMD 编带 DO-214AA SMBJ5A 晶导微 ROHS | 1 | D90007 | SMBJ5A | 晶导微
..2 | A1D02.00015 | ESD管 | SMD 编带 SON10 ESD73034D-10/TR 4Line 双向TVS VRWM=3.3V 0.2pF 33W WILLSEMI(韦尔) ROHS | 5 | ED4815,ED4816,ED8124,ED8125,ED8126 | ESD73034D-10/TR | WILLSEMI(韦尔)
..2 | A1D02.00014 | ESD管 | SMD 编带 DFN1006-2L ESD5451N-2/TR 双向 VRWM=5V 17.5pF 80W WILLSEMI(韦尔) ROHS | 7 | ED4817,ED4818,ED4819,ED4820,ED8127，ED4807,ED8128 | ESD5451N-2/TR | WILLSEMI(韦尔)
..2 | A1D02.00016 | ESD管 | SMD 编带 DFN1006-2L ESD5341N USB,HDMI,±20kv(接触放电),峰值脉冲电流4A Will(韦尔) ROHS | 7 | D6,D7,D8,D9,D10,D11,D12 | ESD5341N | Will(韦尔)
..2 | A1D02.00017 | ESD管 | SMD 编带 SOT-23 ESD5302F WILLSEMI(韦尔) ROHS | 1 | U90030 | ESD5302F | WILLSEMI(韦尔)
..2 | A1D02.00018 | ESD管 | SMD 编带 SON10 TPD4E05U06DQAR 4Line VRWM=5V 0.5pF 40W TI ROHS | 6 | U27,U28,U29,U31,U32,U33 | TPD4E05U06DQAR | TI
..2 | A1D01.00007 | MOS管 | SMD 编带 SOT-323 2SK3018 N沟道 长晶 ROHS | 11 | Q18,Q19,Q9529,Q9530,Q9532,Q9533,Q9538,Q9539,Q9554,Q9556，Q9557 | 2SK3018 | 长晶
..2 | A1D01.00002 | 三极管 | SMD编带 SOT-723 MMBT3904M NPN ROHS | 1 | Q955 | MMBT3904M | CJ
..2 | A1D01.00010 | MOS管 | SMD编带 SOT23-3 AOS AO3416 N沟道 ROHS | 1 | Q9518 | AO3416 | AOS
..2 | A1D01.00011 | MOS管 | SMD编带 SOT-323 WNM6002-3/TR N沟道 ROHS | 1 | Q9534 | WNM6002-3/TR | WILLSEMI(韦尔)
..2 | A1L01.00011 | 贴片功率电感 | SMD 带屏蔽 3*3*1.2mm 1UH 5.4A ±20% WPN3012H1R0MT Sunlord(顺络) ROHS | 3 | L2,L4,L90015 | WPN3012H1R0MT | Sunlord(顺络)
..2 | A1L01.00029 | 贴片功率电感 | SMD 带屏蔽 5.4*5.2*1.8mm 1.5UH 10A ±20% SICP0520N-1R5M-AN1W 联振 ROHS | 1 | L5001 | SICP0520N-1R5M-AN1W | 联振
..2 | A1L09.00007 | 贴片磁珠 | SMD 0402 FB120R 1.3A UPZ1005D121-1R3TF ±25% ROHS | 1 | FB1 | UPZ1005D121-1R3TF | Sunlord
..2 | A1L03.00002 | 共模电感 | SMD WCM2012F2SF-900T04 90R 4PIN ±5% TAI-TECH(台庆) ROHS | 5 | FB2,FB3,FB4,FB5，FB6605 | WCM2012F2SF-900T04 | TAI-TECH(台庆)
..2 | A1L03.00014 | 共模电感 | SMD TCM0605T-080-2P-T201 8Ω 4PIN 100MHZ ±5% TDK ROHS | 9 | U4106,U90104,U90105,U90106,U90107,U90108,U90109,U90110,U90111 | TCM0605T-080-2P-T201 | TDK
..2 | A1I01.00037 | IC | SMD DCDC MP8759GD-Z MPS QFN12 ROHS | 1 | U90086 | MP8759GD-Z | MPS
..2 | A1I01.00022 | IC | SMD 电平转换 UM3204H CSP-12 ROHS | 7 | U3,U4,U5,U6,U7,U8,U14 | UM3204H | 上海英联
..2 | A1I01.00038 | IC | SMD 3.0HUB GL3523_OTY30 QFN76 GENESYS(创惟) ROHS | 1 | U24 | GL3523_OTY30 | GENESYS(创惟)
..2 | A1I01.00133 | IC | SMD Flash MX25L4006EZUI-12G 4Mb 3V 8-USON 2*3*0.6mm MXIC ROHS | 1 | U25 | MX25L4006EZUI-12G | MXIC
..2 | A1I01.00040 | IC | SMD 降压 ETA3521 SOT563 钰泰 ROHS | 3 | U26,U37,U90103 | ETA3521 | 钰泰
..2 | A1I01.00017 | IC | SMD USB限流 SY6280AAC SOT23-5 ROHS | 4 | U30,U34,U90094,U90096 | SY6280AAC | silergy(矽力杰)
..2 | A1I01.00016 | IC | SMD LDO PT5108E23E-18 SOT23-5 Powtech ROHS | 1 | U36 | PT5108E23E-18 | Powtech
..2 | A1Y01.00005 | 石英晶振 | SMD编带 无源 3225 25MHz 12PF ±10ppm ROHS | 1 | X2 | 3S25.000E12UCG | 晶灏
..2 | A1J08.00013 | Micro USB座 | SMD Micro USB座 单层 无定位柱 黑色胶芯 8*6.6*H2.6mm 90度 7.75mm脚距 2UB2141－000111F 信音 前插后贴 ROHS | 1 | J9803 | 2UB2141－000111F | 信音
..2 | A1J01.00008 | FPC座 | SMD 下接触 立式 2*15PIN 180度 1.0mm脚距 胶厚3mm 白色卡扣 FPC1030-15S-TAG ROHS | 2 | J9809,J9810 | FPC1030-15S-TAG | 金胜博业
..2 | A1J01.00042 | 连接座 | SMD 母座 75PIN 180度 M.2 E KEY H4.2mm 0.5mm脚距 APCI0108-P001A 黑色 LOTES ROHS | 1 | U13 | APCI0108-P001A | LOTES
..2 | A1J02.00008 | TF卡座 | SMD 碩方 TF-008 11.25*11.35*H1.35mm 不锈钢 ROHS | 1 | J9813 | TF-008 | 碩方
..2 | A1J01.00015 | 连接座 | SMD Foxconn AS0AA826-EASB0-7H 260PIN 0.5mm脚距 DDR4-SODIMM-socket 9.2H STD ROHS | 1 | U1 | AS0AA826-EASB0-7H | Foxconn
..2 | A1K01.00003 | 轻触开关 | SMD 3PIN 1档 带定位柱 4.5*3.35*H3.4mm TS-018B ROHS | 2 | SW9208,SW9209 | TS45AB535A20 | 超洋电子
..2 | A1J01.00028 | 连接座 | SMD 母座 1*2PIN 90度 立贴 1.25mm脚距 5001—WF0125B—02R1-00 白色 文章济美 ROHS | 1 | U90087 | 5001—WF0125B—02R1-00 | 文章济美
..2 | A2S02.00104 | 铜柱 | 铜柱 M2.5*∮4.0*2+1.5*∮2.5 铜镀镍 编带 | 1 | U13-H
