radxa/radxa-cm-projects/cm3/radxa-cm3-io-board/radxa_cm3_io_board_v1330_BOM.xlsx

Sheet: 树形单据体
BOM层级 | 子项物料编码 | 物料名称 | 规格型号 | 标准用量 | 位置号 | 原厂料号 | 品牌
0 | HHH01.00013 | 机板 | RC119 CM3 IO 电子物料清单_V1.33 无WIFI蓝牙 无EMMC 无DDR (RC119-V1.33-R0D0E0W0S0) | 1
.1 | TPT01.00026 | PCBA | RC119 CM3 IO 电子物料清单_V1.33 无WIFI蓝牙 无EMMC 无DDR (RC119-V1.33-R0D0E0W0S0) | 1
..2 | A1P01.00145 | PCB板 | RC119 CM3 IO V1.33 160*90*1.6mm FR-4 4层板 表面沉金处理 哑光绿油 白色丝印 ROHS | 1
..2 | 1.1R.0402000R161J | 贴片电阻 | SMD 0402 0R 1/16W ±5% ROHS | 26 | R1，R5，R7，R25，R28，R35，R82，R98，R114，R120，R132，R135，R142，R143，R177，R207，R209，R222，R223，R9210,R220, R179 ,R183, R87,R88,R79 | RC-02000JT | FH
..2 | 1.1R.040203R3161J | 贴片电阻 | SMD 0402 3.3R 1/16W ±5% ROHS | 1 | R147 | RHC-02U3R3JT | FH
..2 | 1.1R.0402022R161J | 贴片电阻 | SMD 0402 22R 1/16W ±5% ROHS | 12 | R11,R21,R22,R23,R24,R50,R66,R140,R141,R214,R215,R99 | RC-02W220JT | FH
..2 | 1.1R.0402100R161J | 贴片电阻 | SMD 0402 100R 1/16W ±5% ROHS | 6 | R45,R46,R48,R49,R167,R168 | RC-02W101JT / RTT02101JTH | FH / RALEC
..2 | 1.1R.0402510R161J | 贴片电阻 | SMD 0402 510R 1/16W ±5% ROHS | 2 | R3，R9 | RC-02W511JT | FH
..2 | 1.1R.0402001K161J | 贴片电阻 | SMD 0402 1K 1/16W ±5% ROHS | 4 | R54,R91,R164, ,R191 | RC-02W102JT / 0402WGJ0102TCE | FH / UNIOHM
..2 | 1.1R.040202K2161J | 贴片电阻 | SMD 0402 2.2K 1/16W ±5% ROHS | 5 | R100，R101,R34，R175，R180 | RTT02222JTH | RALEC
..2 | 1.1R.040202R7161F | 贴片电阻 | SMD 0402 2.7K 1/16W ±1% ROHS | 1 | R102 | 0402WGF2701TCE | 厚声
..2 | 1.1R.040203K3161J | 贴片电阻 | SMD 0402 3.3K 1/16W ±5% ROHS | 4 | R42,R115,R119,R127 | 0402WGJ0332TCE | 厚声
..2 | 1.1R.040204K7161J | 贴片电阻 | SMD 0402 4.7K 1/16W ±5% ROHS | 3 | R84,R89,R90 | RC-02W472JT / 0402WGJ0472TCE | FH / UNIOHM
..2 | 1.1R.040205K1161F | 贴片电阻 | SMD 0402 5.1K 1/16W ±1% ROHS | 1 | R152 | 0402WGF5101TCE | 厚声
..2 | 1.1R.040208K2161J | 贴片电阻 | SMD 0402 8.2K 1/16W ±5% ROHS | 1 | R154 | 0402WGJ0822TCE | 厚声
..2 | 1.1R.0402010K161J | 贴片电阻 | SMD 0402 10K 1/16W ±5% ROHS | 35 | R13,R32,R33,R39,R41,R47,R51,R53,R59,R60,R63,R68,R69,R70,R71,R72,R73,R74,R94,R96,R107,R113,R118,R149,R165,R173,R181,R188,R194,R195,R203,R204,R205,R210,R212 | RC-02W103JT / RTT02103JTH | FH / RALEC
..2 | 1.1R.0402012K161J | 贴片电阻 | SMD 0402 12K 1/16W ±5% ROHS | 4 | R75,R76,R77,R78 | RC-02W123JT | FH
..2 | 1.1R.0402015K161J | 贴片电阻 | SMD 0402 15K 1/16W ±5% ROHS | 2 | R57,R193 | 0402WGJ0153TCE | 厚声
..2 | 1.1R.0402022K161J | 贴片电阻 | SMD 0402 22K 1/16W ±5% ROHS | 2 | R144,R213 | 0402WGJ0223TCE | 厚声
..2 | 1.1R.0402024K161J | 贴片电阻 | SMD 0402 24K 1/16W ±5% ROHS | 2 | R17,R160 | RC-02W243JT | FH(风华)
..2 | 1.1R.040249K9161F | 贴片电阻 | SMD 0402 49.9K 1/16W ±1% ROHS | 1 | R18 | RTT024992FTH | RALEC
..2 | 1.1R.0402051K161J | 贴片电阻 | SMD 0402 51K 1/16W ±5% ROHS | 1 | R161 | RC-02W513JT | FH
..2 | 1.1R.0402100K161F | 贴片电阻 | SMD 0402 100K 1/16W ±1% ROHS | 1 | R151 | RC-02W1003FT | FH
..2 | 1.1R.0402100K161J | 贴片电阻 | SMD 0402 100K 1/16W ±5% ROHS | 13 | R12,R14,R37,R43,R52,R65,R105,R106,R156,R158,R163,R187,R200 | RC-02W104JT | FH
..2 | 1.1R.0402150K161F | 贴片电阻 | SMD 0402 150K 1/16W ±1% ROHS | 2 | R58,R190 | RC-02W1503FT | FH(风华)
..2 | 1.1R.0402232K161F | 贴片电阻 | SMD 0402 232K 1/16W ±1% ROHS | 2 | R15,R157 | RC-02W2323FT | FH
..2 | 1.1R.0402001M161J | 贴片电阻 | SMD 0402 1M 1/16W ±5% ROHS | 1 | R221 | RC-02W105JT | FH
..2 | 1.1R.0603000R101J | 贴片电阻 | SMD 0603 0R 1/10W ±5% ROHS | 5 | R162，R170，R197,R62,R9212 | RS-03000JT | FH
..2 | 1.1R.0805002R081J | 贴片电阻 | SMD 0805 2R 1/8W ±5% ROHS | 4 | R55,R56,R189,R192 | 0805W8J020JT5E | 厚声
..2 | 1.1R.0402022R164J | 贴片排阻 | SMD 0402*4 22R 1/16W ±5% ROHS | 1 | RP1 | 4D02WGJ0220TCE | 厚声
..2 | 1.1C.0402120050AJ | 陶瓷电容 | SMD 0402 12PF 50V NPO ±5% ROHS | 1 | C123 | 0402CG120J500NT | FH
..2 | 1.1C.0402220050AJ | 陶瓷电容 | SMD 0402 22PF 50V NPO ±5% ROHS | 2 | C12,C148 | C0402C0G220J500NTB | EYANG
..2 | 1.1C.0402560050AJ | 陶瓷电容 | SMD 0402 56PF 50V NPO ±5% ROHS | 2 | C84,C85 | 0402CG560J500NT | 风华
..2 | 1.1C.0402103025MM | 陶瓷电容 | SMD 0402 10NF 25V X5R ±20% ROHS | 9 | C31,C32,C33,C34,C110,C112,C113,C114,C35 | 0402B103K250NT | FH
..2 | 1.1C.0402104016MM | 陶瓷电容 | SMD 0402 100NF 16V X5R ±20% ROHS | 59 | C3，C5，C6，C8，C9，C11，C14，C19，C28，C30，C38，C39，C42，C43，C44，C47，C63，C68，C69，C75，C76，C79，C80，C86，C87，C88，C94，C98，C101，C106，C107，C111，C125，C126，C131，C135，C138，C139，C141，C145，C146，C150，C153，C158，C173,C36,C52,C49，C53，C55，C57，C62，C89，C159，C164，C165，C167，C172, C70 | CL05B104KO5NNNC | SAMSUNG
..2 | 1.1C.0402104050MM | 陶瓷电容 | SMD 0402 100NF 50V X5R ±20% ROHS | 3 | C133,C140,C152 | CL05B104KB54PNC | 三星
..2 | 1.1C.0402224025MM | 陶瓷电容 | SMD 0402 220NF 25V X5R ±20% ROHS | 1 | C129 | CC0402KRX5R8BB224 | YAGEO
..2 | 1.1C.040201U010MM | 陶瓷电容 | SMD 0402 1UF 10V X5R ±20% ROHS | 14 | C1,C45,C48,C64,C65,C71,C81,C82,C91,C95,C99,C143,C144,C176 | CL05A105KP5NNNC | 三星
..2 | 1.1C.06034U7010MM | 陶瓷电容 | SMD 0603 4.7UF 10V X5R ±20% ROHS | 4 | C59,C60,C169,C170 | 0603X475K100NT | FH
..2 | 1.1C.060322U010MM | 陶瓷电容 | SMD 0603 22UF 10V X5R ±20% ROHS | 11 | C127,C130,C136,C137,C157,C83,C92,C93,C96,C97,C100 | CL10A226MP8NUNE | SAMSUNG
..2 | 1.1C.080522U010MM | 陶瓷电容 | SMD 0805 22UF 10V X5R ±20% ROHS | 10 | C7,C13,C20,C21,C22,C37,C149,C154,C155,C156 | CL21A226MPQNNNE | 三星
..2 | 1.1C.080522U025MM | 陶瓷电容 | SMD 0805 22UF 25V X5R ±20% ROHS | 4 | C132,C134,C142,C151 | CL21A226MAYNNNE | SAMSUNG
..2 | 1.1C.08052U2050MK | 陶瓷电容 | SMD 0805 2.2UF 50V X5R ±10% ROHS | 2 | C51,C161 | GRM21BR61H225KA73L | muRata(村田)
..2 | 1.1C.120610U025MM | 陶瓷电容 | SMD 1206 10UF 25V X5R ±20% ROHS | 3 | C10,C27,C147 | CL31A106KAHNNNE | 三星
..2 | 1.1D.A0631010DW00 | 发光二极管 | SMD 编带 0603 发红光 单色 mcd=150 IF=20mA 无色散光 ROHS | 1 | LED3 | EY-PB0603RC-010F | 恩域光电
..2 | 1.1D.A0633010DW00 | 发光二极管 | SMD 编带 0603 发绿光 单色 mcd=150 IF=20mA 无色散光 ROHS | 1 | LED4 | EY-TB0603GC-010F | 恩域光电
..2 | 1.1D.EAEBTR04G020 | ESD管 | SMD 编带 0402 BTR04G02 ROHS | 51 | D3,D4,D5,D6,D7,D8,D9,D10,D11,D12,D14,D15,D16,D17,D18,D19,D20,D21,D22,D23,D24,D25,D26,D27,D30,D31,D32,D33,D34,D35,D36,D37,D38,D39,D40,D41,D48,D49,ED1,ED2,ED3,ED4,ED8197,ED8198,ED9,ED10,ED11,ED12,ED13,ED14,ED15 | BTR04G02 | B-tron
..2 | 1.1D.EAEBTR04D300 | ESD管 | SMD 编带 0402 BTR04D3 ROHS | 4 | ED16,ED17,ED18,ED19 | BTR04D3 | B-tron
..2 | 1.1D.EAEESD5344D0 | ESD管 | SMD 编带 DFN2510-10L ESD5344D ROHS | 4 | U1,U2,U5,U6 | ESD5344D | WILLSEMI(韦尔)
..2 | 1.1D.9ALB5819WS00 | 肖特基二极管 | SMD 编带 SOD-323 B5819WS ROHS | 2 | D1,D42 | B5819WS | 晶导微
..2 | 1.1D.9ADSS3400000 | 肖特基二极管 | SMD 编带 DO_214AC SS34 ROHS | 2 | D13,D50 | SS34 | CJ
..2 | 1.1D.9ADSS5400000 | 肖特基二极管 | SMD 编带 DO_214AC SS54 ROHS | 2 | D45,D46 | SS54 | 晶导微
..2 | 1.1D.TAGSMFJ18A00 | TVS管 | SMD 编带 SOD123 SMFJ18A ROHS | 1 | D47 | SMFJ18A | 晶导微
..2 | 1.1D.8AFBAT54C000 | 双向二极管 | SMD 编带 SOT-23 BAT54C ROHS | 1 | D43 | BAT54C | CJ
..2 | 1.1D.VA1S8050000N | 三极管 | SMD 编带 SOT23 S8050 NPN ROHS | 4 | Q3,Q8,Q14,Q5 | S8050 | 长晶
..2 | 1.1D.MA72SK30180N | MOS管 | SMD 编带 SOT-323 2SK3018 N沟道 ROHS | 2 | Q15,Q16 | 2SK3018T106 | 罗姆
..2 | 1.1D.MAAWPM23010P | MOS管 | SMD 编带 SOT23-3 WPM2301-3/TR P沟道 ROHS | 1 | Q2 | WPM2301-3/TR | WILLSEMI(韦尔)
..2 | 1.1D.MAAWPM23413P | MOS管 | SMD 编带 SOT23-3 WPM2341-3/TR P沟道 ROHS | 1 | Q17 | WPM2341-3/TR | WILLSEMI(韦尔)
..2 | 1.1D.MA1WPM20153P | MOS管 | SMD 编带 SOT-23 WPM2015-3/TR P沟道 ROHS | 4 | Q4,Q6,Q7,Q13 | WPM2015-3/TR | WILLSEMI(韦尔)
..2 | 1.1D.MA7WNM20213N | MOS管 | SMD 编带 SOT-323 WNM2021-3/TR N沟道 ROHS | 1 | Q9 | WNM2021-3/TR | WILLSEMI(韦尔)
..2 | 1.1L.P04021211A0Y | 贴片磁珠 | SMD 0402 FB120R 1A 25% ROHS | 8 | FB2,FB3,FB4,L3,L4，R30，R31，R95 | PZ1005U121-1R0TF | Sunlord(顺络)
..2 | 1.1L.P06031212A0Y | 贴片磁珠 | SMD 0603 FB120R 2A 25% ROHS | 2 | FB1,FB5 | PZ1608U121-2R0TF | 顺络
..2 | 1.1L.P12060605A0Y | 贴片磁珠 | SMD 1206 FB60R 5A 25% ROHS | 2 | R148,R150 | HCB3216KF-600T50 | TAI-TECH(台庆)
..2 | 1.1L.I12P90H0914J | 共模电感 | SMD BCMF122P900H 90R 4PIN 不带ESD ±5% ROHS | 7 | L5,L6,L7,L8,L10,L11,L15 | BCMF122P900H | B-tron
..2 | 1.1L.A444114U730M | 功率电感 | SMD 带屏蔽 4.0*4.0*2.6mm 4.7UH 8A ±20% RXWSHC0420-4R7M ROHS | 4 | L2,L14,L1,L13 | RXWSHC0420-4R7M | 深圳仁芯微电子
..2 | 1.1L.A505022U2A0M | 功率电感 | SMD 带屏蔽 5*5*2mm 2.2UH 10A ±20% RXWSHC0520T-2R2M ROHS | 1 | L12 | RXWSHC0520T-2R2M | 深圳仁芯微电子
..2 | 1.1I.HYM8563TS000 | IC | SMD 时钟 HYM8563TS MSOP8 ROHS | 1 | U24 | HYM8563TS / TCS8563-HM | 武汉昊昱微 / 芯源
..2 | 1.1I.FE11S0000000 | IC | SMD HUB FE1.1S_QFN QFN24 ROHS | 1 | U17 | FE1.1S | Terminus
..2 | 1.1I.AP733112QL00 | IC | SMD LDO AP7331-12WG-7 1.2V SOT25 ROHS | 1 | U14 | AP7331-12WG-7 | DIODES(美台)
..2 | 1.1I.AP733118QN00 | IC | SMD LDO AP7331-18WG-7 1.8V SOT25 ROHS | 1 | U12 | AP7331-18WG-7 | DIODES(美台)
..2 | 1.1I.AP733128QQ00 | IC | SMD LDO AP7331-28WG-7 2.8V SOT25 ROHS | 1 | U15 | AP7331-28WG-7 | DIODES(美台)
..2 | 1.1I.PT5108E23E18 | IC | SMD LDO PT5108E23E-18 SOT-23-5 ROHS | 2 | U11,U35 | PT5108E23E-18 | Powtech
..2 | 1.1I.NB679GD00000 | IC | SMD DCDC NB679GD QFN12 ROHS | 1 | U27 | NB679GD | MPS
..2 | 1.1I.SY7203DBC000 | IC | SMD 升压 SY7203DBC DFN3X3-10 ROHS | 2 | U10,U34 | SY7203DBC | silergy(矽力杰)
..2 | 1.1I.SYB113B00000 | IC | SMD DCDC SY8113B SOT-23-6 ROHS | 2 | U7,U29 | SY8113B | silergy(矽力杰)
..2 | 1.1I.SY6280AAC000 | IC | SMD 限流 SY6280AAC SOT23-5 ROHS | 4 | U9,U18,U19,U20 | SY6280AAC | silergy(矽力杰)
..2 | 1.1I.FL72011Q0000 | IC | SMD USB3.0 SW FL7201-1Q0 WQFN20 ROHS | 2 | U8,U22 | FL7201-1Q0 | Fresco Logic
..2 | 1.1Y.K30932K712P2 | 石英晶振 | SMD 编带 无源 3215 32.768KHz 12.5PF ±20ppm ROHS | 1 | Y2 | SF32WK32768D31T002 | 泰晶
..2 | 1.1Y.K31012M00202 | 石英晶振 | SMD 编带 无源 3225 12MHz 20PF ±20ppm ROHS | 1 | Y1 | 3S12.000E20UCG | 晶灏
..2 | 1.1Y.K31027M00002 | 石英晶振 | SMD编带 有源 3225 27MHz 1.8V ±20ppm ROHS | 1 | U13 | 3N27.000F18YCG | 晶灏
..2 | 1.1J.B41R20000170 | 连接座 | SMD 母座 1*3PIN 90度 立贴 1.25MM脚距 白色 ROHS | 1 | BAT1 | 5001—WF0125B—3R1-00 | 文章济美
..2 | 1.1J.E6PJ3423R601 | 耳机插座 | SMD 6PIN 型号PJ-342B 内孔Φ3.6mm 外孔Φ6mm 14*6.4*H4.5MM 黑色 镀金铜头 前插后贴 ROHS | 1 | J8 | XJ-DR-PJ342B-00 | 协佳
..2 | 1.1J.H31912150654 | HDMI座 | SMD 19PIN A座 180度 卧贴 12.1*15*6.05mm 脚距14.5mm 度镍 ROHS | 1 | J1 | 916000-000004 | 闻川科技
..2 | 1.1J.733100567100 | USB座 | SMD 卷边 MICRO_USB 带定位柱 牛角型 脚间距6.6/7.2mm ROHS | 1 | J16 | 1131036CP | 协佳
..2 | 1.1J.K70R500000AB | FPC座 | SMD 上下接触 卧式 6PIN 0.5mm脚距 后翻盖H2.0 ROHS | 1 | J12 | 21-024-00601-5 | 协佳
..2 | 1.1J.K70R500011AB | FPC座 | SMD 上下接触 卧式 26PIN 0.5mm脚距 后翻盖H2.0 ROHS | 2 | J14,J15 | 5001-FCB0520-26R1-00 | 文章济美
..2 | 1.1J.K10R331PINAB | 连接座 | SMD FPC 上下接触 卧式 31PIN 0.3mm脚距 后翻盖H1.0镀金 FH35C-31S-0.3SHW(50) ROHS | 1 | LCD1 | FH35C-31S-0.3SHW(50) | 广濑
..2 | 1.1J.K10R339PINAB | 连接座 | SMD FPC 下接触 卧式 39PIN 0.3mm脚距 后翻盖H1.0镀金 FH35C-39S-0.3SHW(50) ROHS | 1 | U90074 | FH35C-39S-0.3SHW(50) | 广濑
..2 | 1.1J.K10R5IPEX0BB | 连接座 | SMD FPC 母座 下接触 卧式 40PIN 0.5mm间距 IPEX_20455-040E_receptacle 镀金 ROHS | 1 | J11 | 20455-040E | I-PEX
..2 | 1.1J.634050141251 | USB3.0母座 | SMD 单层 直边 无定位柱 90度弯角 蓝胶芯 鱼叉脚 14.5*13*H6.8mm 脚长2.7MM 直脚固定间距12.6mm ROHS | 1 | USB6 | 5001-01010011A | 文章济美
..2 | 1.1J.Z11R2SATA000 | 连接座 | SMD SATA公座 1*7PIN 三面包 卧贴 1.27mm脚距 带鱼叉插脚 ROHS | 2 | J7,J20 | BL-C07M-A2M1A2-G2L | 博隆
..2 | 1.1J.130000ZTF002 | TF卡座 | SMD 型号TFW09-HRJ-68B 14.75*14.5*H1.85mm ROHS | 1 | CN14A1 | TFW09-HRJ-68B | 文章济美
..2 | 1.1J.B20R4100DS01 | 连接座 | SMD 母座 2*50PIN 180度 0.4mm脚距 22.6x1.88x1.14mm DF40C-100DS-0.4V(51) 黑色 ROHS | 3 | J24,Connector1,Connector2 | DF40C-100DS-0.4V(51) | 广濑
..2 | 1.1J.ZCR12203V000 | 电池座 | SMD 母座 型号：CR1220-3V ROHS | 1 | U23 | CR1220-3V | 文章济美
.1 | 1.1J.G12R5M254500 | 连接座 | DIP 排针座 1*4PIN 180度 2.54MM脚距 不带定位柱 针长一端8.3mm 另一端3.5mm 型号:M2545V-4P ROHS | 1 | U28 | M2545V-4P | 兴飞
.1 | 1.1J.G12R54705300 | 连接座 | DIP 排针座 1*4PIN 180度 2.54MM脚距 带定位柱 针长一端7.5mm 另一端3.5mm 型号:470531000 ROHS | 1 | U26 | 470531000 | Molex
.1 | 1.1J.V10012507100 | 连接座 | DIP PCIE座 36PIN 180度直插 1MM脚距 25*7.4*H11.25mm 带定位柱 ROHS | 1 | J6 | WLPC-037D | 兴万联电子
.1 | 1.1J.G12R50603201 | 连接座 | DIP 排针座 1*2PIN 180度 2.54mm脚距 中间朔高2.5mm 针长一端6.1mm 另一端3mm 黑色 ROHS | 3 | J9,J10,J22 | PH2.54 1*2P L=11.6/3.0 180度 | 国意英
.1 | 1.1J.G12R56030201 | 连接座 | DIP 排针座 1*3PIN 180度 2.54MM脚距 中间朔高2.5mm 针长一端6.1mm 另一端3mm 黑色 ROHS | 2 | U31,U32 | PH2.54 1*3P L=11.6/3.0 | 国意英
.1 | 1.1J.G12R56030202 | 连接座 | DIP 排针座 1*4PIN 180度 2.54MM脚距 中间朔高2.5mm 针长一端6.1mm 另一端3mm 黑色 ROHS | 1 | U36 | PH2.54 1*4P L=11.6/3.0 | 国意英
.1 | 1.1J.G22R56030200 | 连接座 | DIP 排针座 2*5PIN 180度 2.54MM脚距 中间朔高2.5mm 针长一端6.1mm 另一端3mm ROHS | 1 | J18 | PH2.54 2*5P L=11.6/3.0 S/T | 国意英
.1 | 1.1J.G22R56030201 | 连接座 | DIP 排针座 2*7PIN 180度 2.54MM脚距 中间朔高2.5mm 针长一端6.1mm 另一端3mm ROHS | 1 | U30 | PH2.54 2*7P L=11.6/3.0 S/T | 国意英
.1 | 1.1J.D5044BS00620 | DC座 | DIP 5PIN DS-044BS 内孔Φ6mm 铁芯Φ2MM 11.6*10.2*H7.3mm ROHS | 1 | U37 | DS-044BS | 协佳
.1 | 1.1J.522101171415 | USB2.0母座 | DIP 双层 卷边 无定位柱 90度弯角 黑胶芯 17.5*14.4*H15.6mm 弯脚固定间距15.6mm 铜壳 ROHS | 1 | J17 | XJ-DR-USB2.0AF90-02 | 协佳电子
.1 | 1.1J.G22R50603200 | 连接座 | DIP 排针座 2*2PIN 180度 2.54MM脚距 中间朔高2.5mm 针长一端6.1mm 另一端3mm 黑色 ROHS | 1 | J4 | PH2.54 2*2P L=11.6/3.0 S/T | 深圳国意英电子
.1 | 1.1J.G22R506032AX | 连接座 | DIP 排针座 2*20PIN 180度 2.54MM脚距 中间朔高2.5mm 针长一端6.1mm 另一端3mm 彩色 ROHS | 1 | CON1 | PH2.54 2*20P 彩印 L=11.6/3.0 S/T | 深圳国意英电子
.1 | 1.1J.R40821161374 | RJ45座 | DIP 18PIN 21.5*16*13.7MM 镀镍 千兆网 带POE功能 带灯 无弹片 ROHS | 1 | J3 | LPJG0926HENL | LINK-PP

Sheet: BOM联副产品信息
序号 | 主产品物料编码 | 主产品物料名称 | 类型 | 联副产品编码 | 物料名称 | 辅助属性 | BOM版本 | 单位 | 数量 | 倒冲领料 | 成本权重 | 生效日期 | 失效日期
