radxa/radxa-cm-projects/cm5/radxa-cm5-io-board/radxa_cm5_io_board_v2200_2d_bottom.dxf

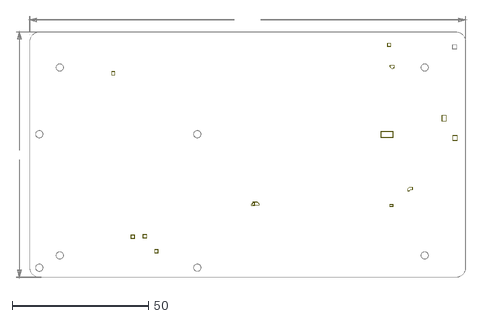
[picture p8: CAD file, 2024-03-13]
cm5/radxa-cm5-io-board/radxa_cm5_io_board_v2200_2d_bottom.dxf
165.6 x 96.3
