radxa/radxa-cm-projects/nx5/radxa-nx5-io-board/radxa_nx5_io_board_v1.4_2d_top.dxf

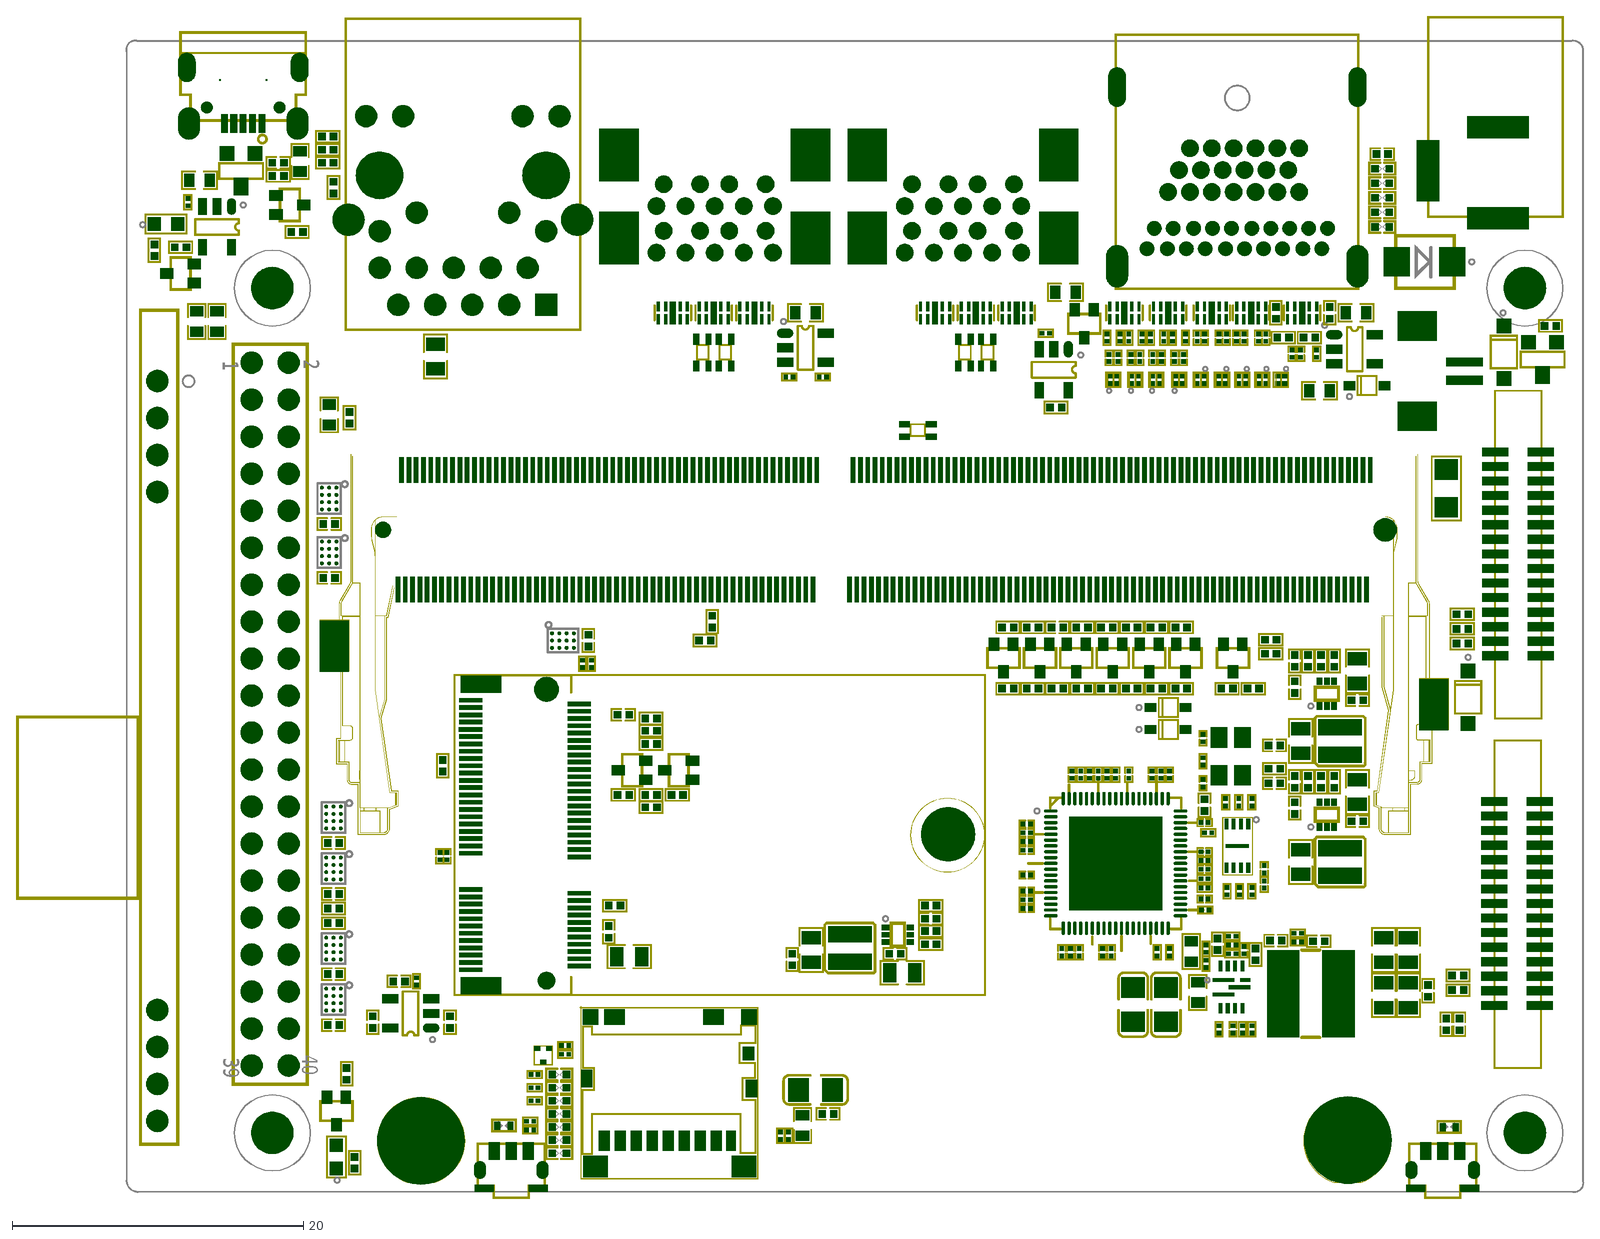
[picture p9: CAD file, 2024-05-17]
nx5/radxa-nx5-io-board/radxa_nx5_io_board_v1.4_2d_top.dxf
1
2
39
40
