radxa/radxa-cm-projects/(list of files, cad)

Other CAD files:
cm3/radxa-cm3-io-board/radxa_cm3_io_board_v1330_bottom_2d.dxf
cm3i/radxa-cm3i-io-board/radxa_cm3i_io_board_bottom_v1.4.dxf
cm4/radxa-cm4-io-board/radxa_cm4_io_2d_dxf_bottom_v1.10.dxf
