radxa/radxa-cm-projects/(threads)

Thread 21 (2022-01-30):

Cannot make ethernet to work

bfgelectronics, 2022-01-30:
Ive got my Radxa CM3 and i flashed on a sd card the debian and ubuntu servers images for the E23 board.
When i power up the E23 carrier board with the CM3 attached , the led from the CM3 starts blinking up , but when i connect the ethernet cable on one of the ethernet ports, the amber let lights up and blinks, but it isnt detected by my router. If i insert the same cable on the other ethernet port , the green led lights up and same beheaviour.
I tryed connecting directly a ethernet port to my laptop and it seems that it the laptop tryes to connect , but after a few seconds, it disconects and the process repeats.

TLDR: I tryed using the images for the e23 boards and ethernet is not working

tomek-szczesny, 2022-01-30:
The fact your laptop tries to connect but it fails might either mean misconfiguration (or lack of sane configuration), or something wrong with a cable.
I'd assume the drivers are fine, and since it's not a prototype carrier board anymore (I think?), I'd rule out design errors.

bfgelectronics, 2022-01-30:
Thanks for the answer @tomek-szczesny the cable is fine. Also since the e23 board has no video out, i couldnt make any configuration, i just downloaded the 2 mentioned images, burned them to a sd card, and tryed them.

tomek-szczesny, 2022-01-30:
I can't help you any more than that, I'm still waiting for my unit, and the carrier board I'm designing isn't ready yet :)

Perhaps it'd be better idea to ask for directions on Radxa forum instead.

Good luck with your project! :)

Thread 22 (2022-01-31):

Cannot open PCB

yaqwsx, 2022-01-31:
When I try to open the file `CM3_IO_V1.1_20211208.pcb` in PADs Viewer, I get error message: "Unable to load design, cannot open "Downloads/Layout/Layout.lyt". The layout file is missing - it has the extension .lyt".

Note that Downloads is the directory where I downloaded the PCB. I don't know PADs, but is it possible that you omit to include some files? The same problem appears when I clone the repository.

jack-ma, 2022-02-02:
I will check this after the holiday(8th, Feb).

yaqwsx, 2022-02-10:
Hi, any update on this?

jack-ma, 2022-02-10:
I just downloaded the VX viewer standard version.

PADSViewerVX.2.10.zip

Extract and install it, find

`C:\MentorGraphics\PADSVX.2.10Viewer\SDD_HOME\Programs\powerpcbviewer.exe`

and open it. You will see the viewer.

User the viewer and open the `CM3_IO_V1.1_20211208.pcb`, I have no problem opening it.

tomek-szczesny, 2022-02-10:
Perhaps a pdf export of pcb layout could be possible? For us Linux users, you know. :)

tomek-szczesny, 2022-02-28:
> Am I the only one who cannot open the schematics? If you can open it, could you tell me what I do wrong?

You mean the PCB layout, right? Schematics work for me, as these are available in pdf. The PCB layout is not that important to me, but it would be a nice touch to export that to pdf as well.

jack-ma, 2022-02-28:
@yaqwsx I reproduced on a clean installation Windows 10 PC. I have no problem opening the .pcb file with `C:\MentorGraphics\PADSVX.2.10Viewer\SDD_HOME\Programs\powerpcbviewer.exe`. First double click to launch powerpcbviewer, then use File->Open to open the .pcb file. It works just fine.

yaqwsx, 2022-03-01:
My bad; I was using Pads Browser instead of Pads Viewer. Thank you for your assistance.

Closed 2022-03-01.

Thread 23 (2022-02-26):

Update using RPI CM4 carrier

Consti10, 2022-02-26:
Hello,

The radxca cm3 has finally arrived (thank you !). As a first step, I've tried updating the firmware.
I installed the board into my rpi carrier and try to follow these steps:
https://wiki.radxa.com/Rock3/installusb-install-radxa-cm3-rpi-cm4-io

But so far to no success. RKDevTool fails with the following message:
"Download boot fail":
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

Any ideas ? Maybe the board shipped without bootloader ?
The print on the board says Rock3 compute module  v1.1

Consti10, 2022-02-26:
I have no Idea why, but after clicking some buttons and trying it a couple of times following the tutorial, the flashing seems to have worked:
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

Now the green LED on the radxca CM3 is blinking, and the LEDs from the CM4 carrier board are
1) Red, solid on
2) green, blinking,
2 times fast, then a break.
aka ON pause OFF pause ON pasue OFF long pause

Consti10, 2022-02-26:
Any instructions how I can now access the cm4 either via ssh or adb shell ?

Consti10, 2022-02-26:
It would be generally nice to document:
If radxca cm3 is installed on CM4 carrier:

1) How to boot from sd card
2) How to boot from eMMC ( I assume the board has eMMC, any way to find out)

3) How to boot into bootloader & maskrom ( I think this is done using the buttons on the radxca cm3 itself)

Consti10, 2022-02-26:
4) What exactly is the effect of jumping
GLOBAL_EN

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

on rpi cm4 carrier and why is it generally needed o get any activity when Radxca CM3 is installed onto RPI CM4 carrier.

yaqwsx, 2022-02-28:
I was able to flash the CM3 successfully. To be honest, first-time flashing failed, but all consecutive flashes were successful (I use rktool on Linux). The picture with the jumper is misleading, you need to press the button on the board. No jumpers are needed.

jack-ma, 2022-02-28:
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

Boot order for RK356x maskrom is fixed: SPI -> eMMC -> SD/MMC0. In u-boot SPL, the default boot order is:

    u-boot,spl-boot-order = &sdmmc0, &sdhci, &nandc0, &spi_nand, &spi_nor

So after u-boot SPL is loaded, u-boot in microSD card is first to load and run, then emmc.

> 4. What exactly is the effect of jumping GLOBAL_EN

GLOBAL_EN is to trigger boot(like power button) for CM3 v1.1 version. It connects to pwr_on signal of PMU. For future CM3 version(v1.2 and later), an automatic trigger circuit is added to the CM, so manual trigger is no longer required in the future.

Consti10, 2022-02-28:
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

Thanks for the info.
So this means if I want to boot from SD Card, I just need to put the SD card (with flashed image) in and trigger.
And to boot from eMMC, just remove the SD card and trigger ?

Still wondering why I don't get anything from the board once it is running. Aka the green LED on the board is flashing constantly, and I cannot access the typical adb shell.

jack-ma, 2022-02-28:
> So this means if I want to boot from SD Card, I just need to put the SD card (with flashed image) in and trigger. And to boot from eMMC, just remove the SD card and trigger ?

Yes.

> Still wondering why I don't get anything from the board once it is running. Aka the green LED on the board is flashing constantly, and I cannot access the typical adb shell.

Is there anything on the HDMI? I just checked, adb is not enabled by default.

Consti10, 2022-02-28:
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

I have not. Is ssh enabled by default ?

jack-ma, 2022-03-01:
Yes, ssh is enabled by default.

Consti10, 2022-03-30:
Now that I have a display at hand, I can confirm my board is working. As well as ethernet in the rpi official cm4 carrier.

Closed 2022-03-30.

Thread 24 (2022-04-27):

Cockpit NAS server

StuartIanNaylor, 2022-04-27:
Cockpit https://cockpit-project.org/ can make a great webconsole and basic NAS setup with container support.
It would be so great to get a carrier that has 1x Sata onboard as with the 5x m.2 sata boards avail x6 sata provides some interesting options for raid 0, 0+1, 10, 5, 6

The pcie2.1 m.2 is not really of interest as 2.5gb ethernet will still likely bottleneck throughput where it would be great to see 5gbe but wifi can be routed as its very likely many networks will already contain a router.
As said even though just 1 sata that does increase valid RAID options considerably if no 5gbe then 2.5gbe with a single USB3 OTG.

Also would be great to be powered by standard 12v barrel than PD with onboard connectors for a couple of SATA power strings.
Maybe the USB2.0 are of interest but apart from that a minimal NAS focused carrier where a collection of cockpit modules can be configured ready in images for ubuntu/debian.

Thread 44 (2023-10-12):

Radxa Rock3 Compute Module IO board in Altium

daverathbone, 2023-10-12:
Hi Radxa team,

You have kindly placed the schematic and PCB layout for the Radxa Rock3 Compute Module IO board Ver1.3 in Altium
In this repro. You gave the schematic with the schematic lib and the PCB layout without the PCB lib?
Please is there any chance of having the PCB lib as it would be ideal to use your design with the footprints.
For new Radxa projects based on your I/O board as working reference.
Many thanks if you could do this.

Thread 56 (2025-07-30):

Altium CM3 IO pcbdoc file is actually the CM3 Industrial

thurstinn, 2025-07-30:
cm3\radxa-cm3-io-board\altium\radxa_cm3_io_board_v1330_pcb_layout.PrjPcb\radxa_cm3_io_board_v1330_pcb_layout.PcbDoc

The above file when opened in Altium contains the PCB layout of the CM3 Industrial IO board not the standard one. I can't find the files for the standard IO board.

Also there are only schematic library files in the folder: cm3\radxa-cm3-io-board\altium\radxa_cm3_io_board_v1330_schematic.PrjPcb
There are no footprint libraries to be found.
