radxa/radxa-cm-projects/cm4/radxa-cm4-io-board/radxa_cm4_io_schematic_v1.10.pdf

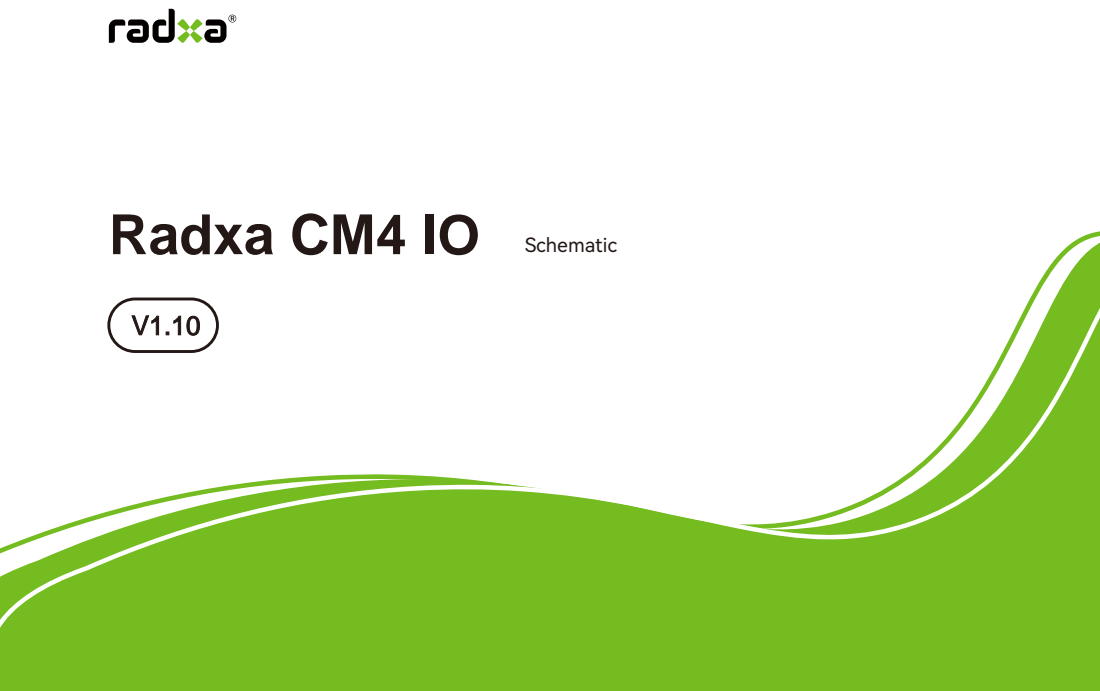
[picture p10: page 1]
Radxa CM4 IO; Schematic

# 02 Table of Content 03 Block Diagram

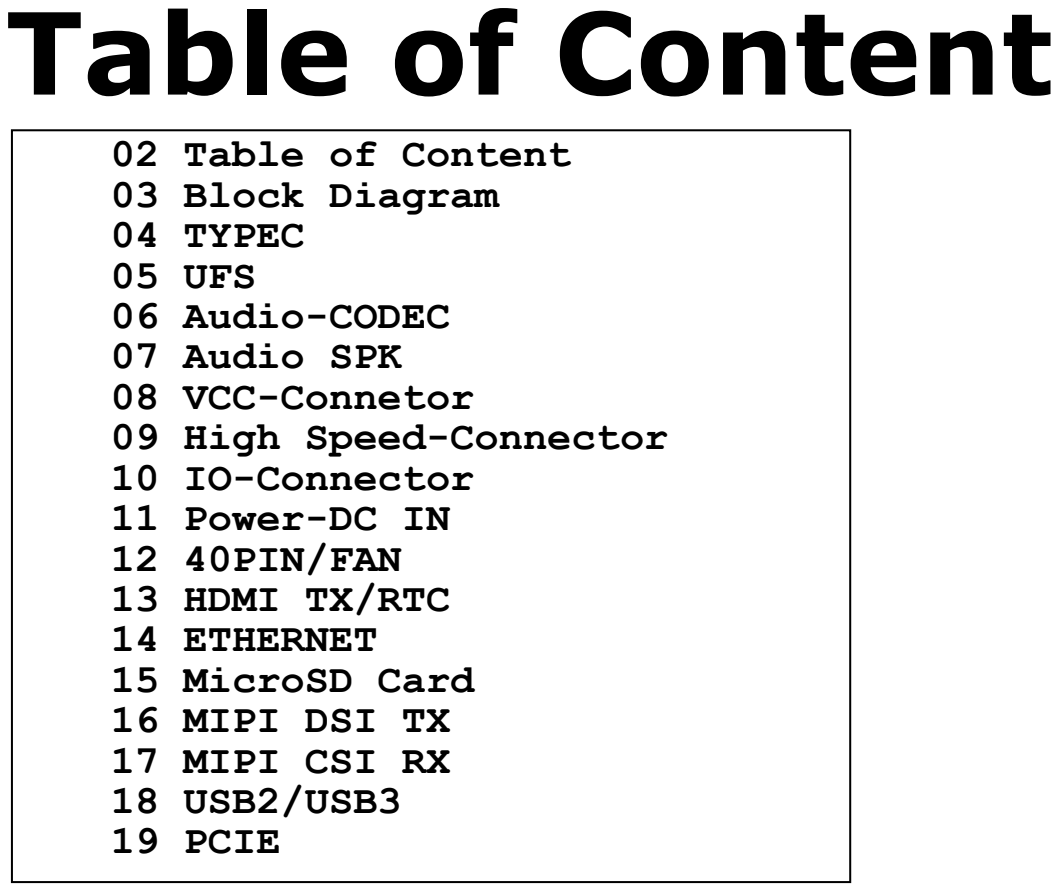
[picture p11: page 2]
Size; REV; Date:; Sheet; Title:; Page Name:; 02 Table of Content; Wednesday, August 06, 2025; 19 Size

Table of Content

04 TYPEC
05 UFS
06 Audio-CODEC
07 Audio SPK
08 VCC-Connetor
09 High Speed-Connector
10 IO-Connector
11 Power-DC IN
12 40PIN/FAN
13 HDMI TX/RTC
14 ETHERNET
15 MicroSD Card
16 MIPI DSI TX
17 MIPI CSI RX
18 USB2/USB3
19 PCIE

# 12V_OUT 5V_OUT

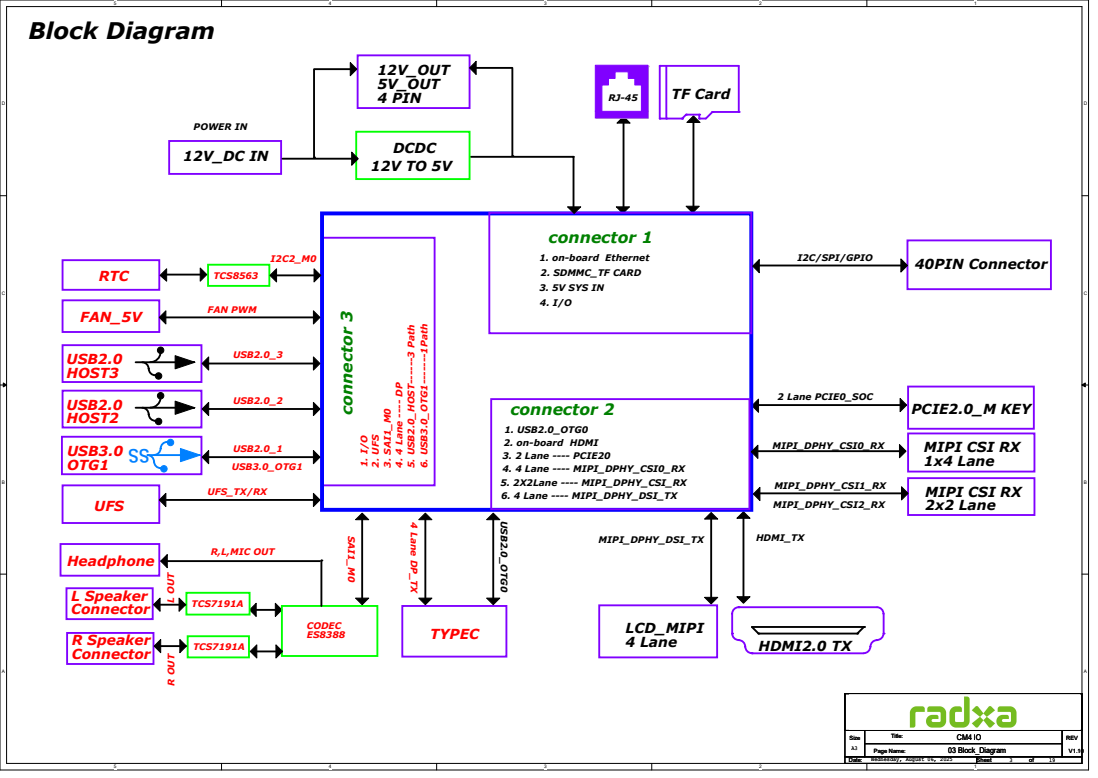
[picture p12: page 3]
HDMI2.0 TX; 4 PIN; 1. I/O 2. UFS; 4. 4 Lane ⁻⁻⁻⁻ DP 5. USB2.0_HOST⁻⁻⁻⁻⁻⁻3 Path 6. USB3.0_OTG¹⁻⁻⁻⁻⁻⁻⁻¹Path connector 3; 3. SAI1_M⁰; FAN_5V; USB3.0; OTG1; Block Diagram; 1. USB2.0_OTG0; 4. 4 Lane ---- MIPI_DPHY_CSI0_RX; connector 1; 5. 2X2Lane ---- MIPI_DPHY_CSI_RX 6. 4 Lane ---- MIPI_DPHY_DSI_TX; 2. on-board HDMI; connector 2; 3. 2 Lane ---- PCIE20; TF Card; DCDC; RTC; LCD_MIPI 4 Lane; 40PIN Connector; TYPEC; PCIE2.0_M KEY; Headphone; R Speaker Connector; UFS; MIPI_DPHY_DSI_TX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

1. on-board Ethernet
2. SDMMC_TF CARD
3. 5V SYS IN

MIPI CSI RX
1x4 Lane
2x2 Lane

R,L,MIC OUT R OUT L OUT

# Type-C PORT

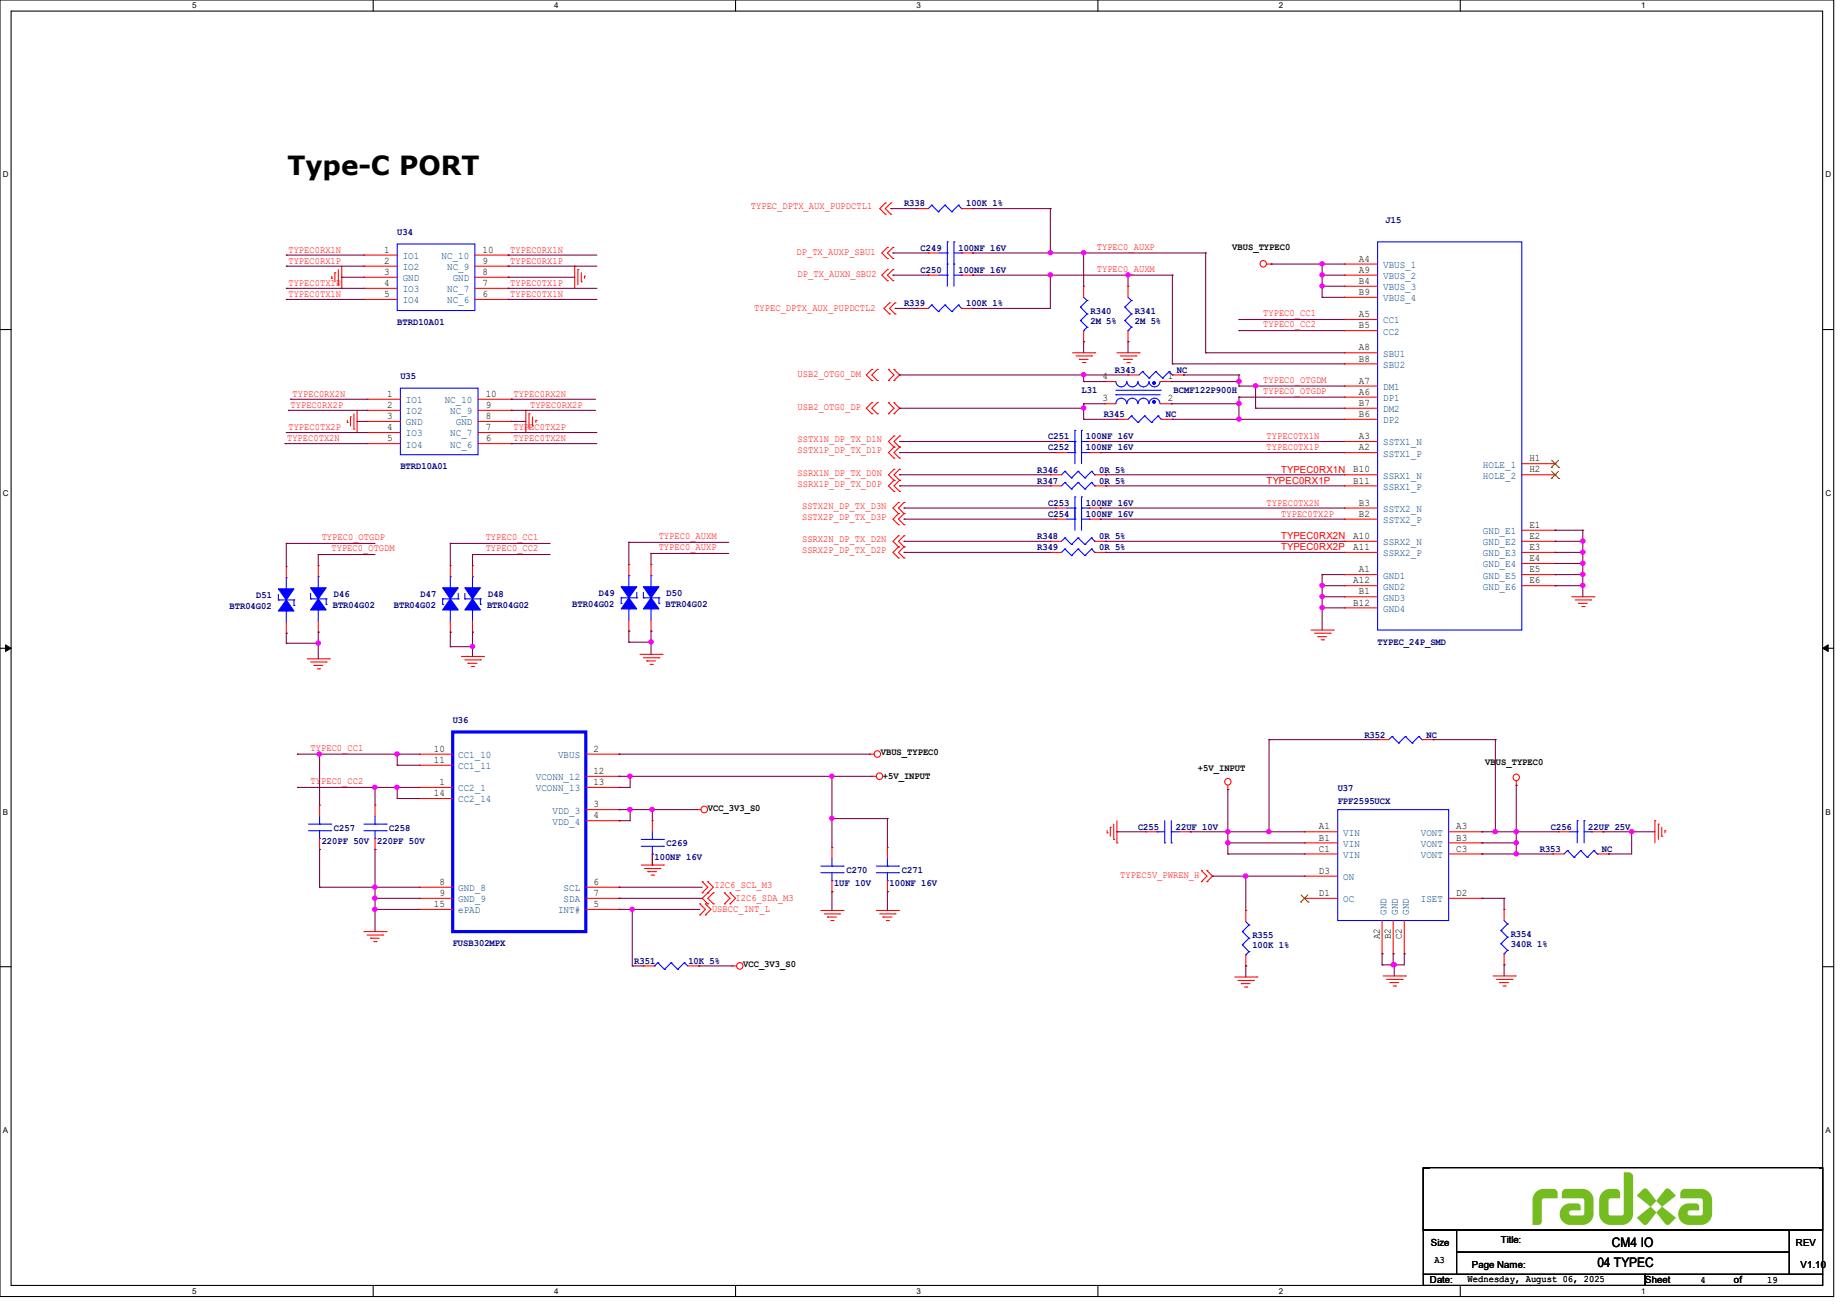
[picture p13: page 4]

# UFS

# UFS POWER

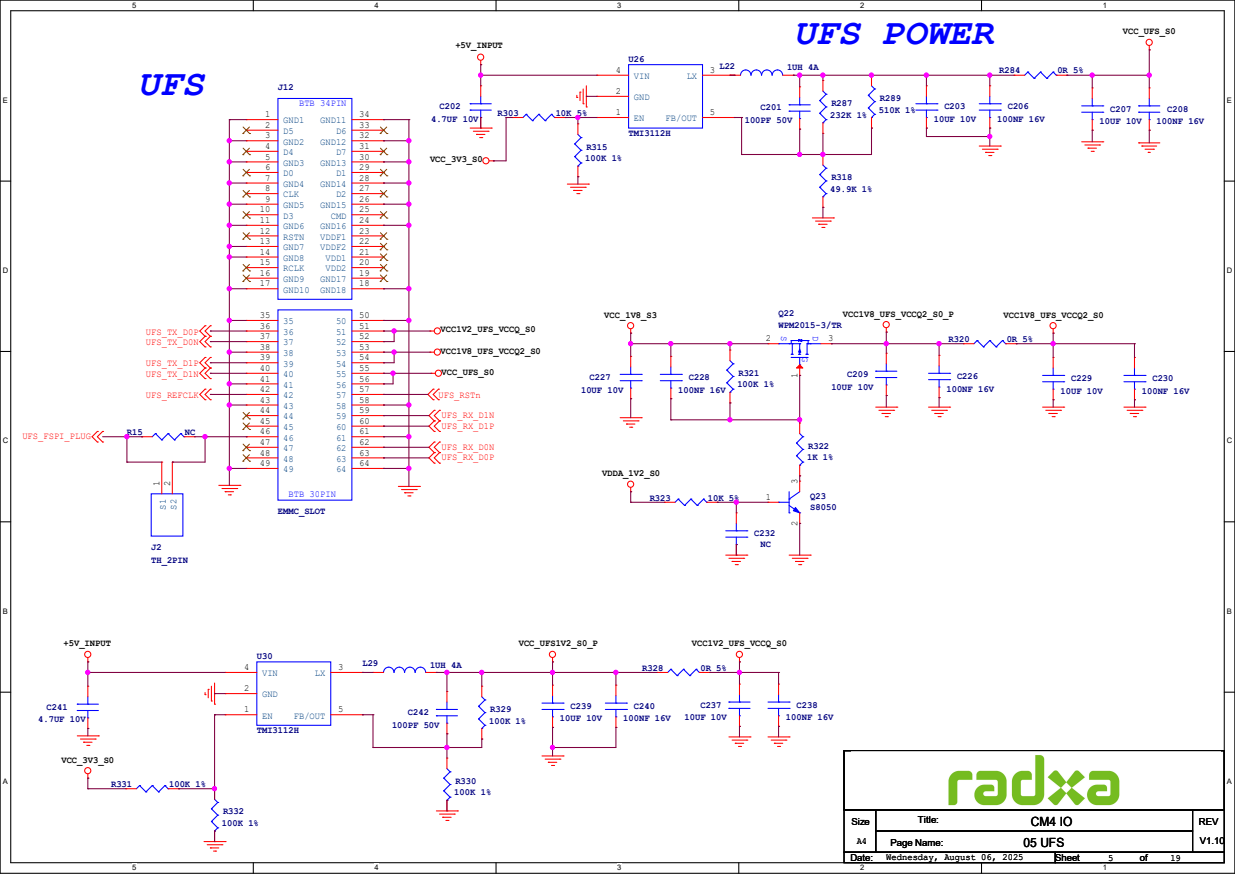
[picture p14: page 5]

# CODEC

3V3_S0 | VCCIO_CODEC | VCCA3V3_CODEC | 3V3_S0

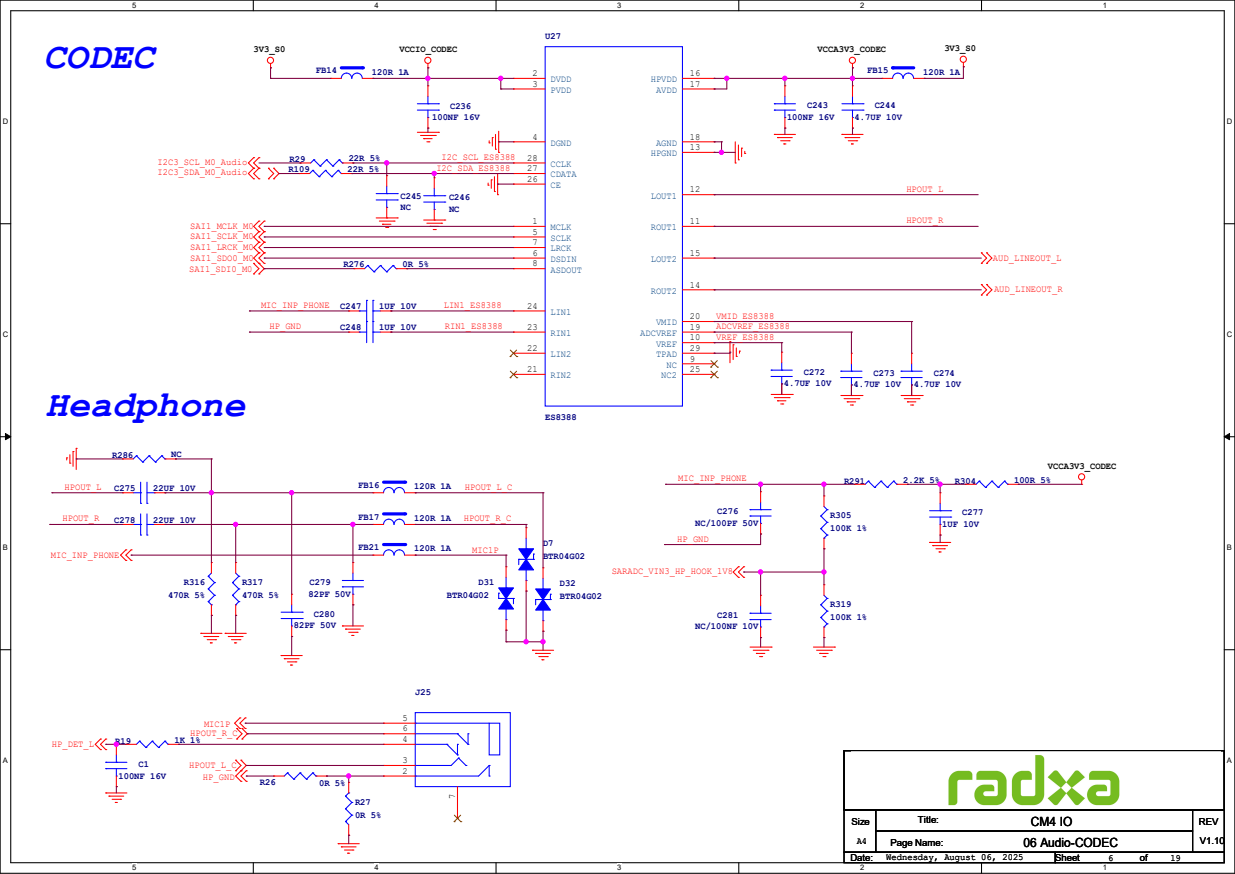
[picture p15: page 6]

# Speaker Output

5V_S0 | 5V_SPK_AMP

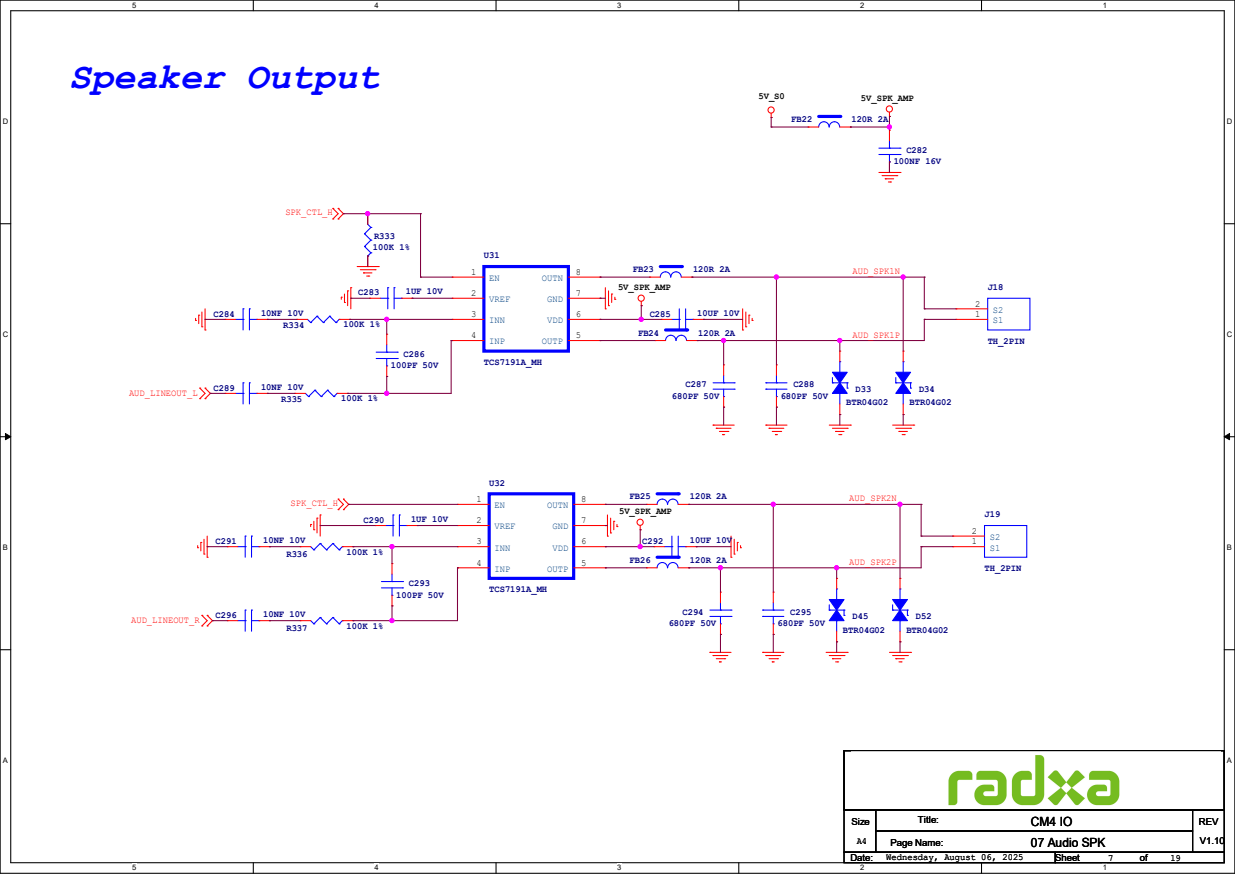
[picture p16: page 7]

AUD_SPK1P

AUD_SPK2N

AUD_SPK2P

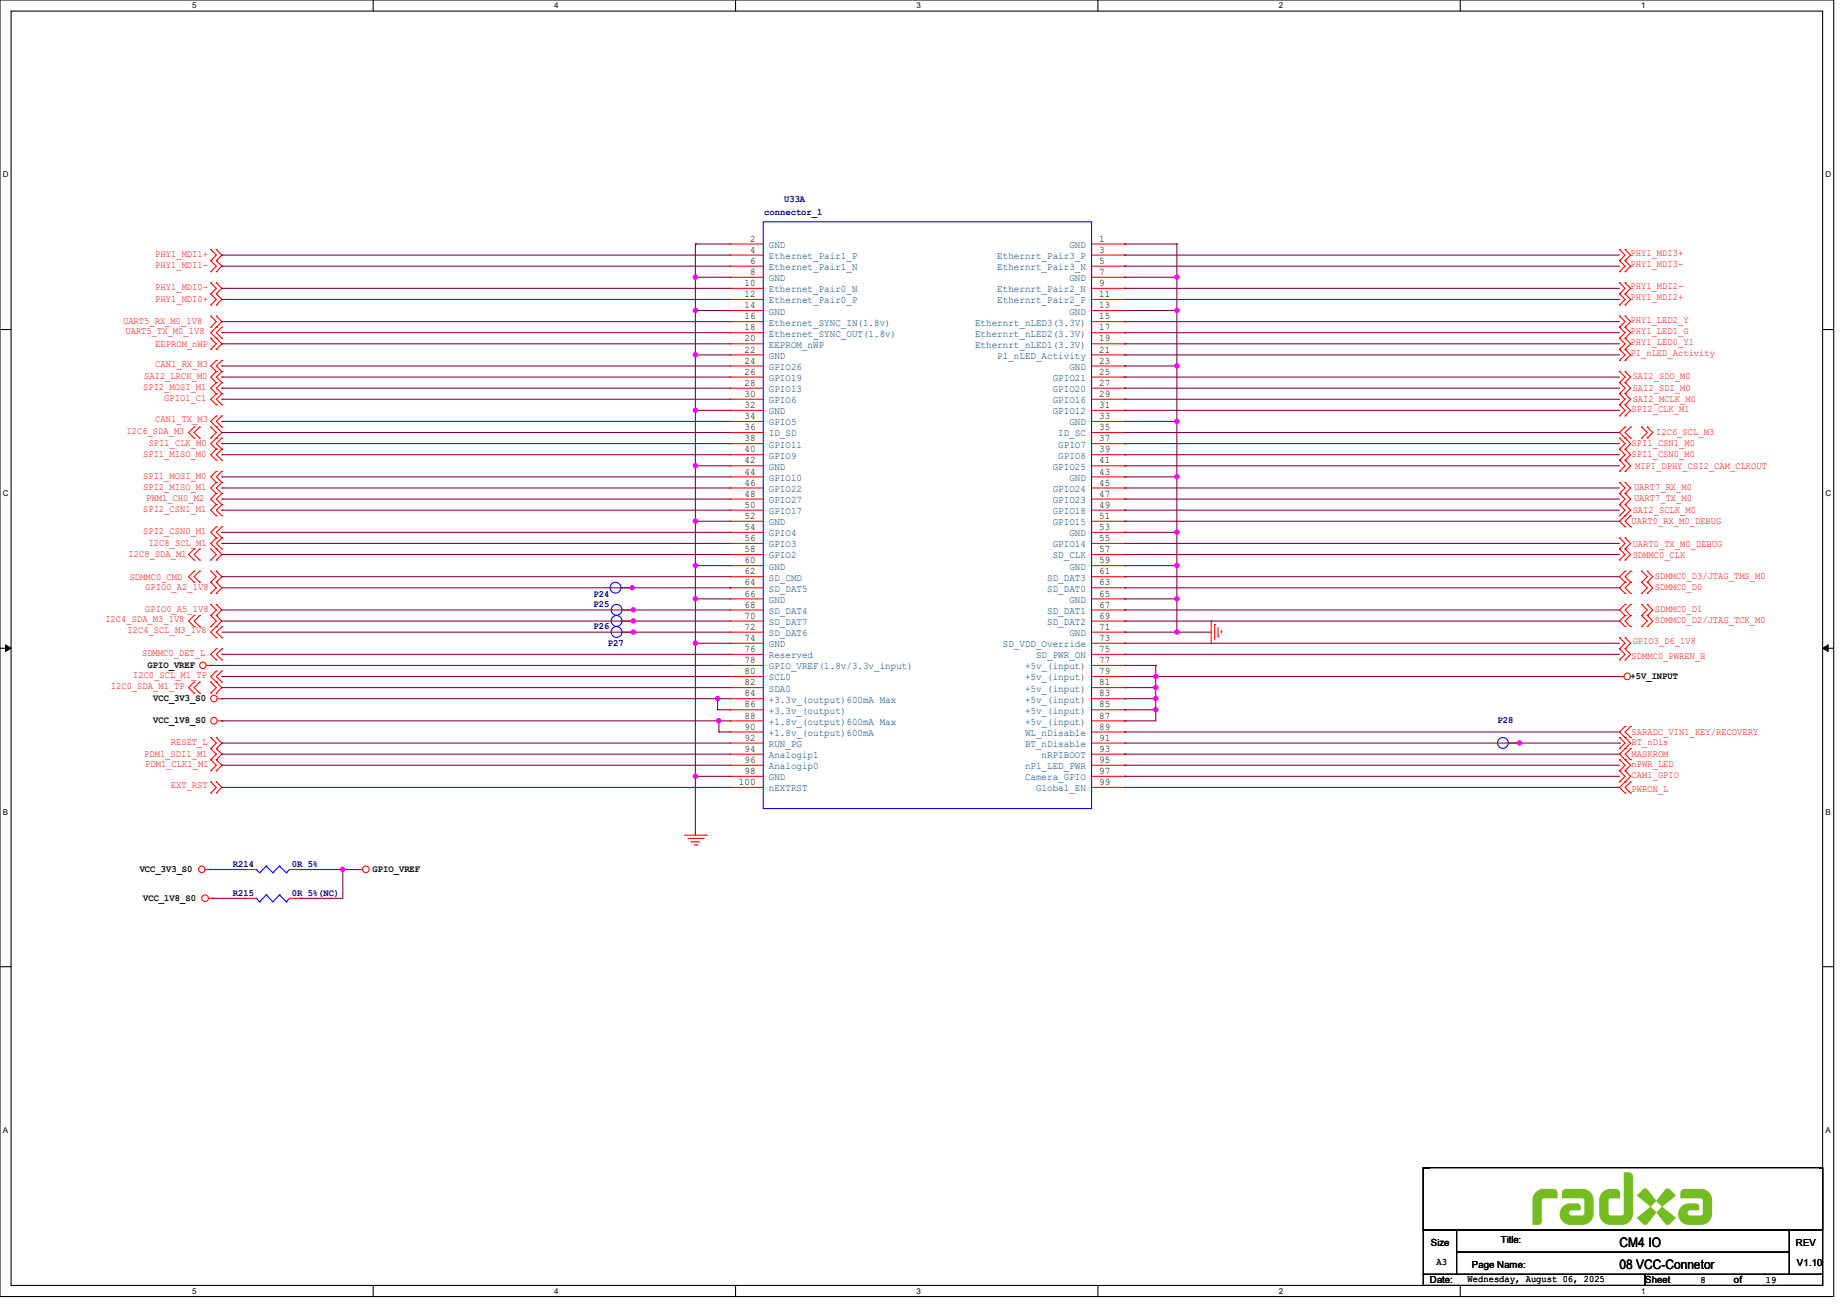
[picture p17: page 8]

Pcie_CLK_nREQ 102 | HOLE 201 | HOLE 202 | HOLE 203 | HOLE 204

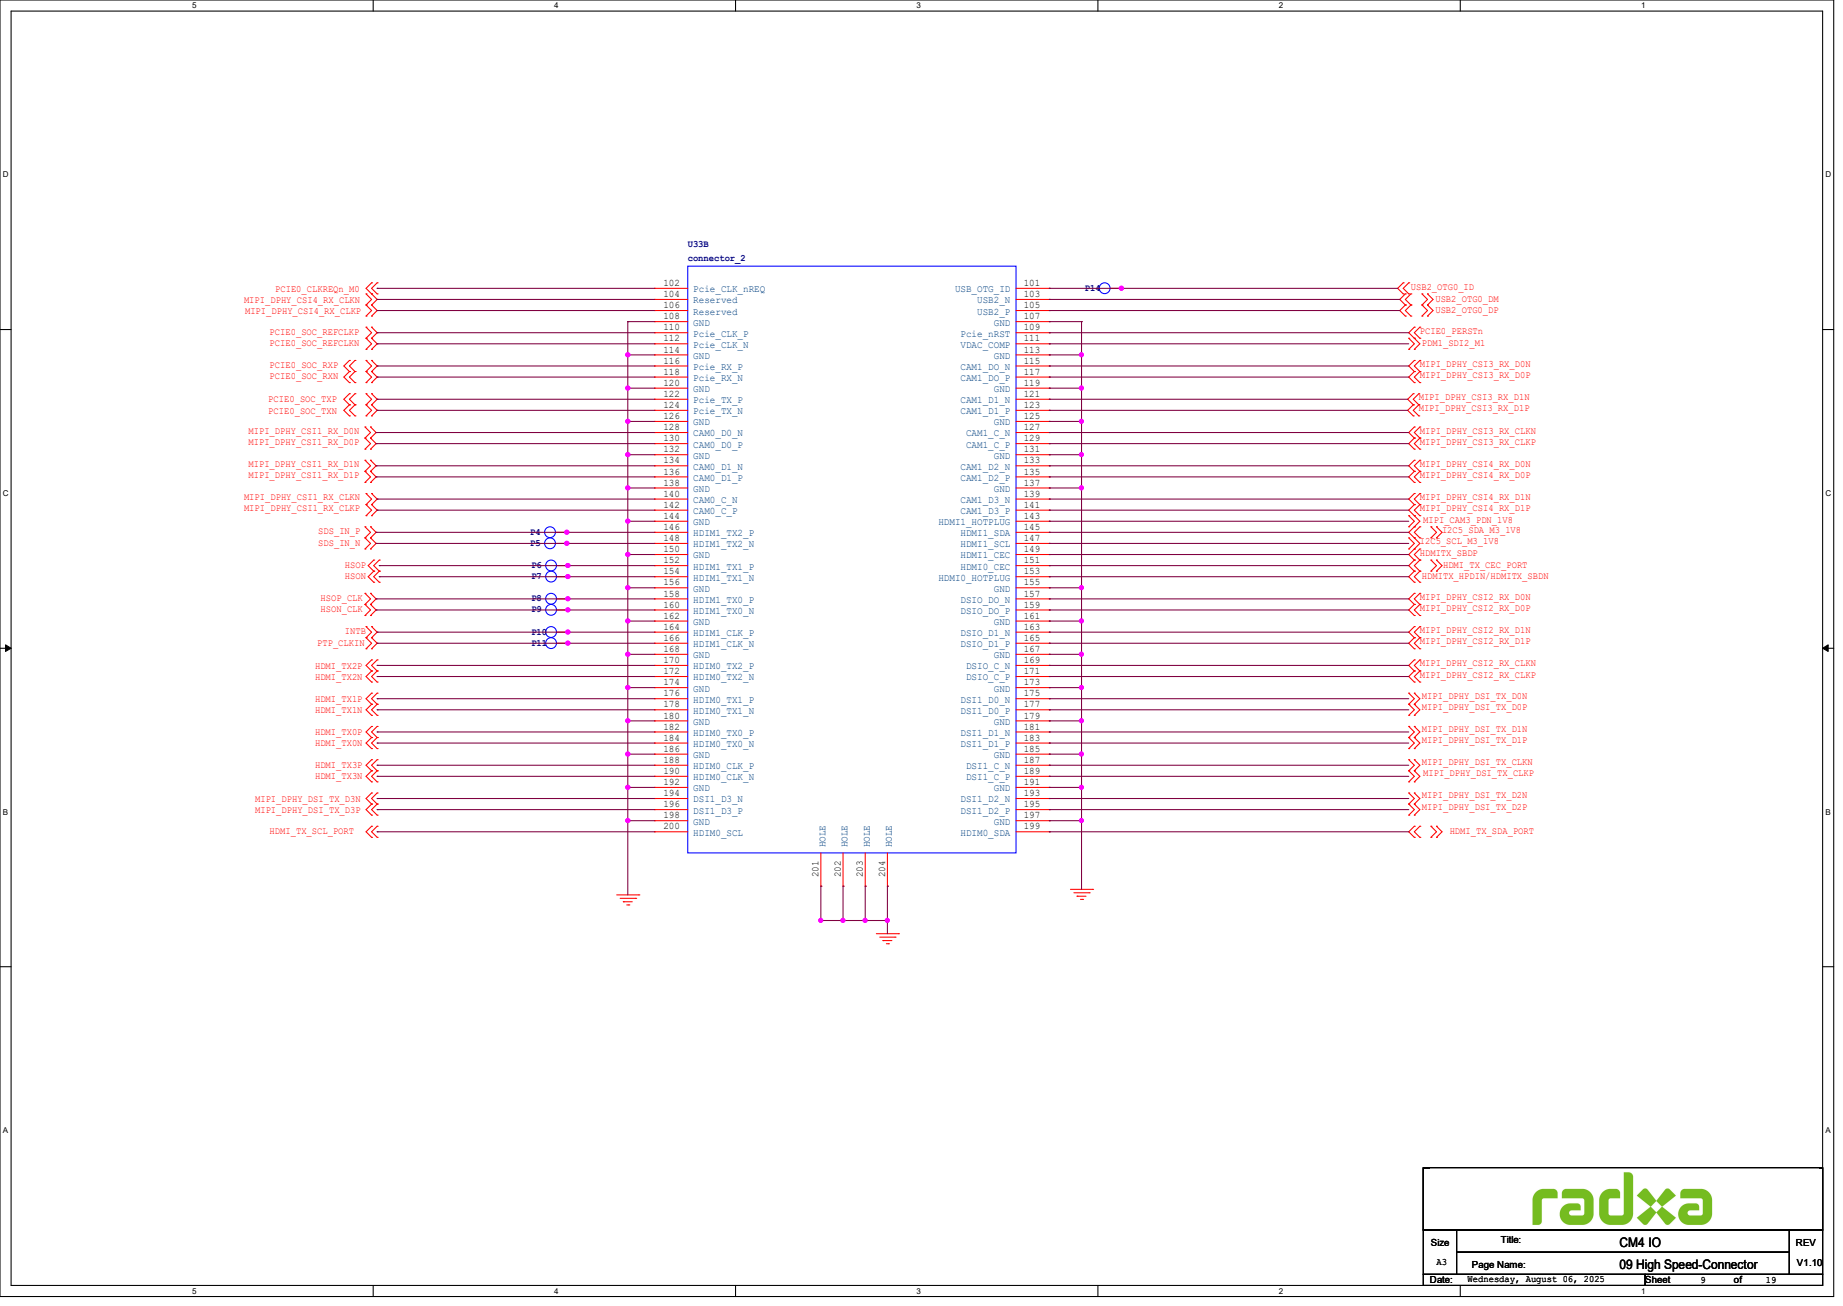
[picture p18: page 9]

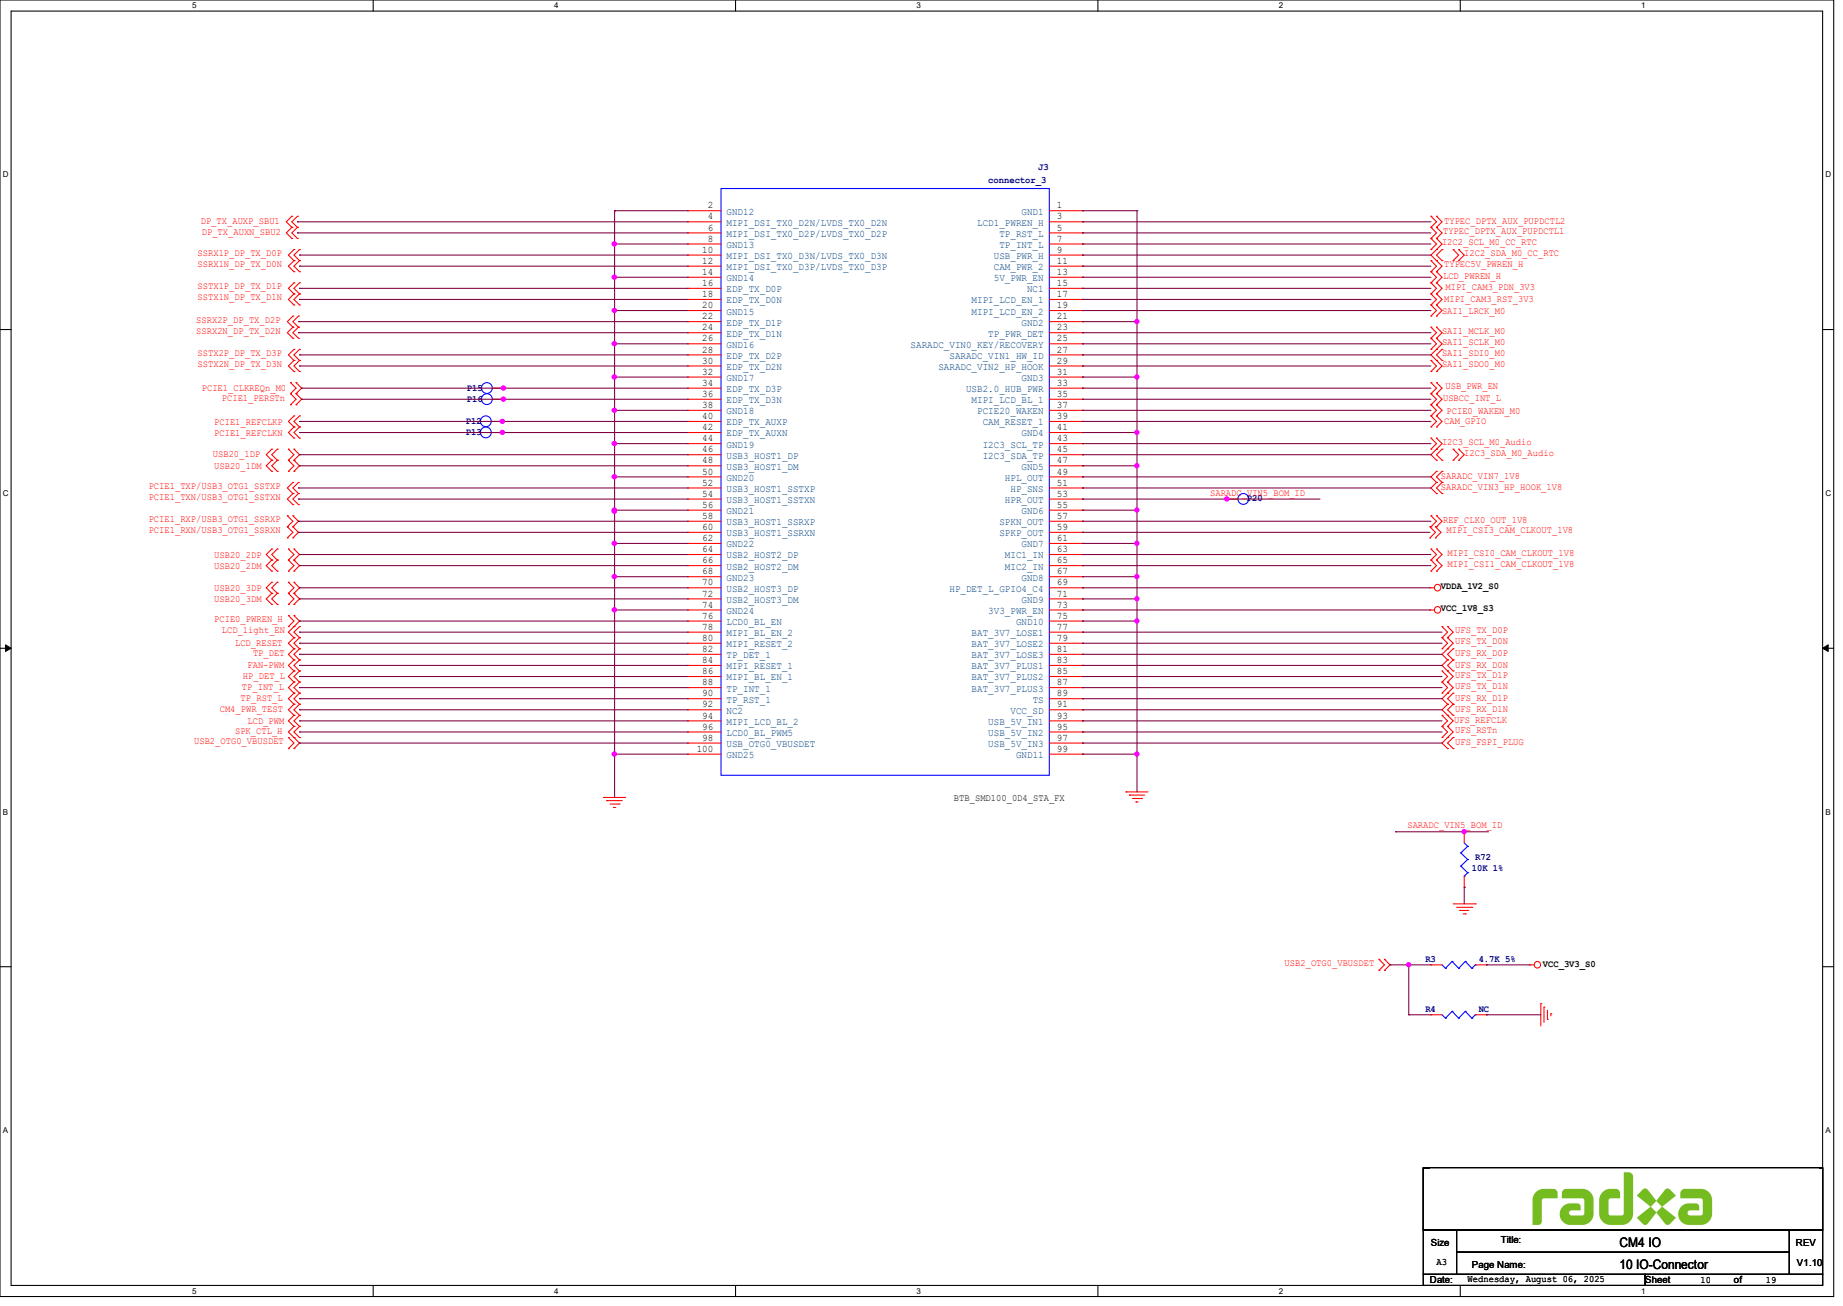
[picture p19: page 10]

# DC IN&SYSTEM Power

# 1 PG

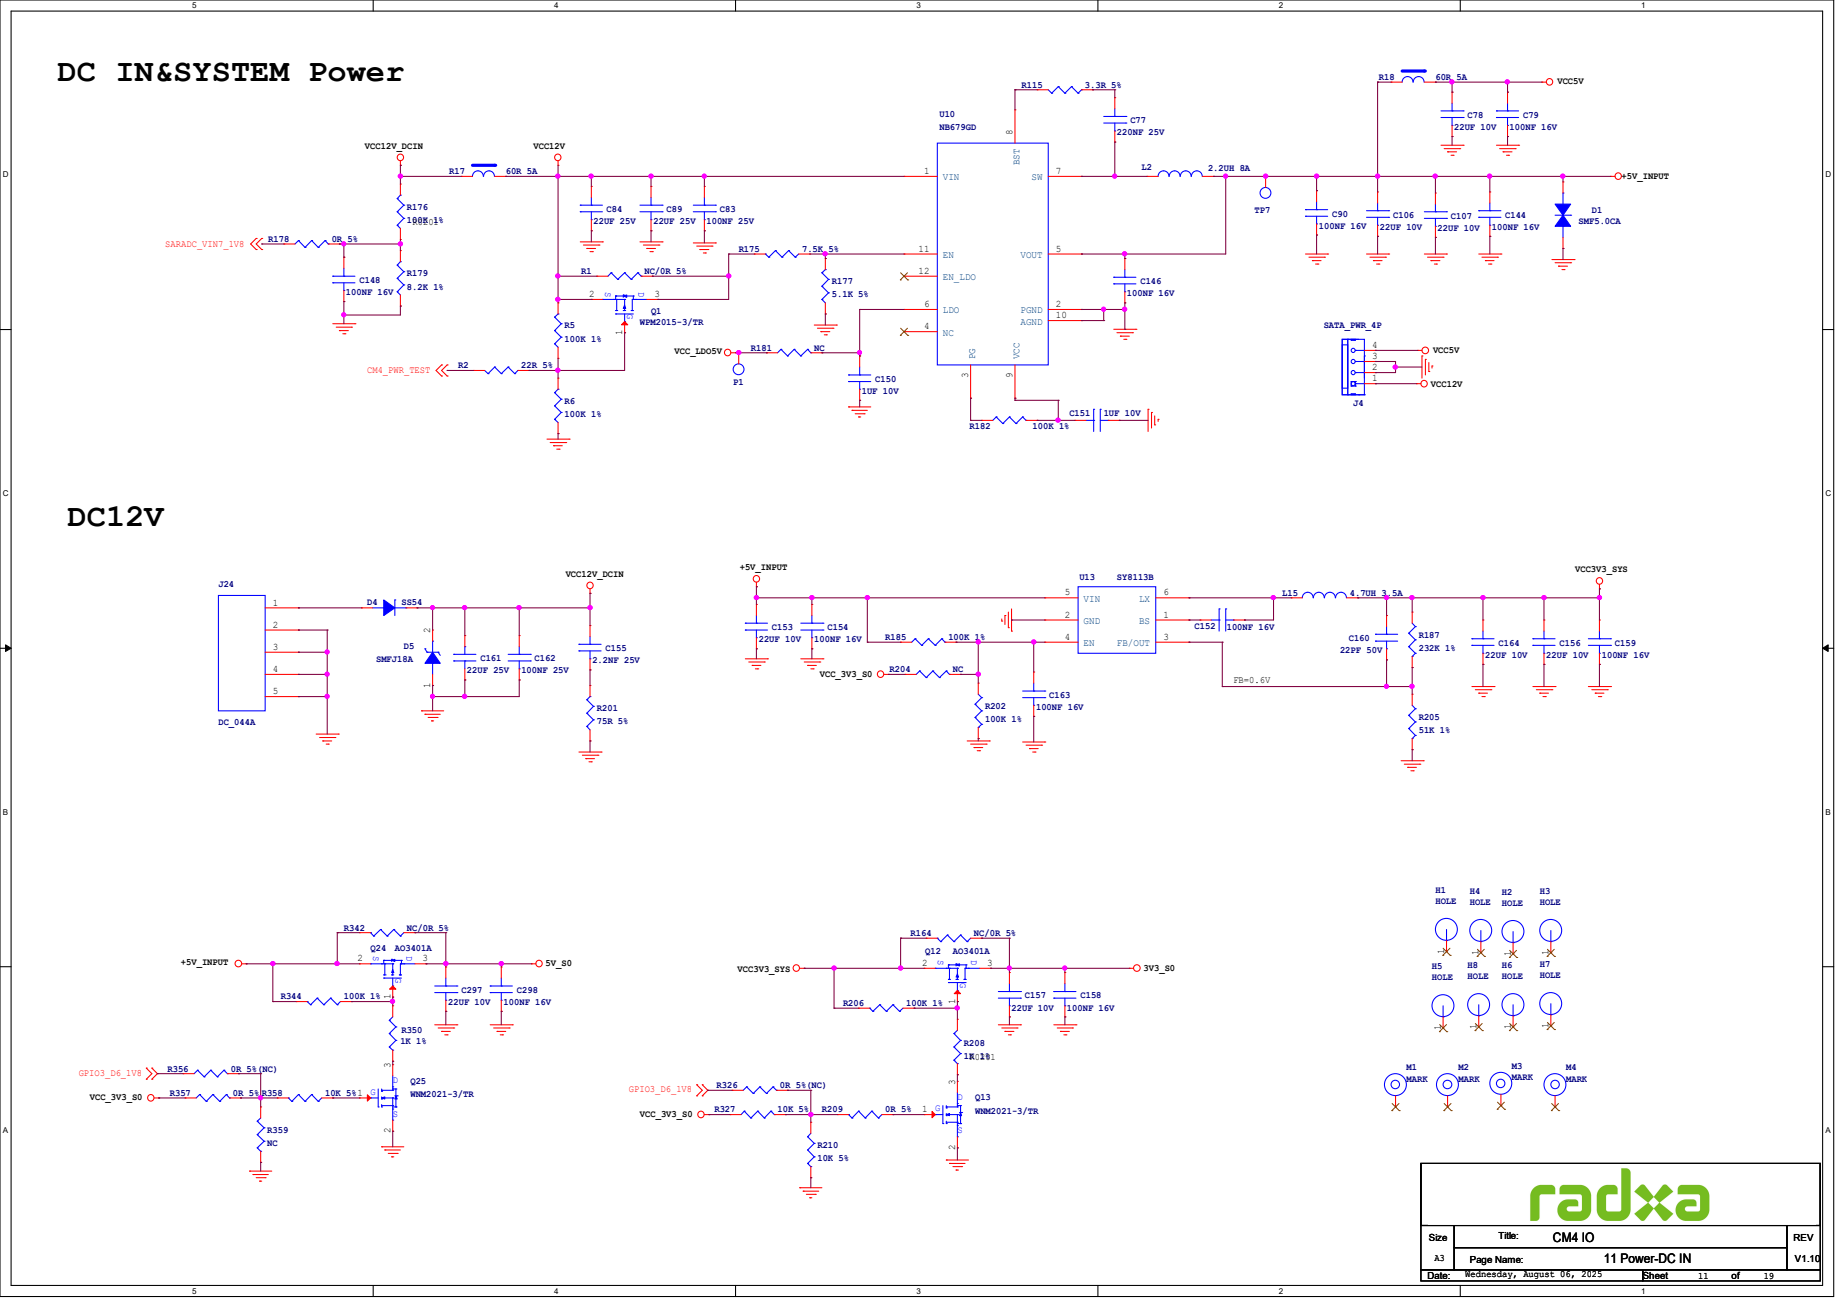
[picture p20: page 11]

# 40 PIN

VCC3V3_SYS | VCC5V

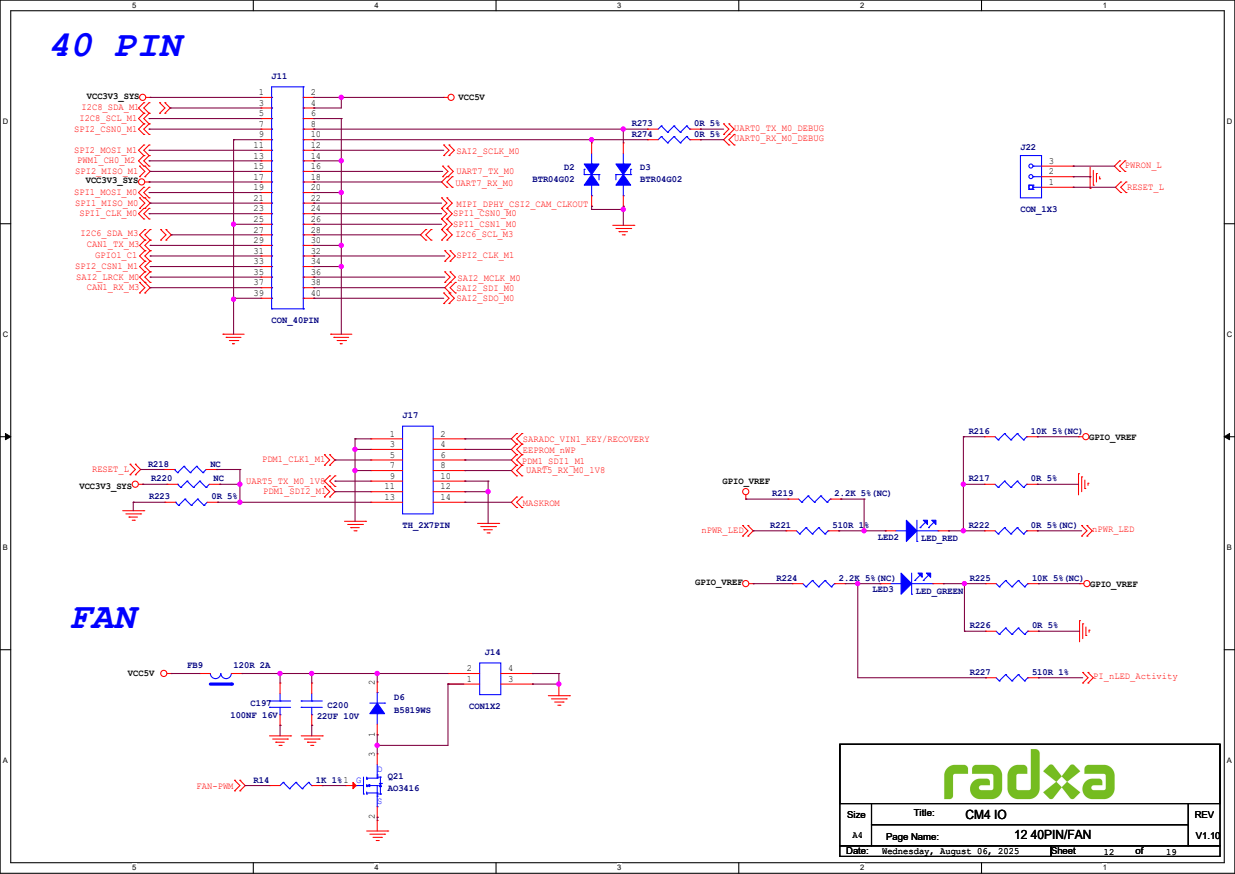
[picture p21: page 12]

# HDMI TX ARC/HPD HDMI

## HDMI_TX1N

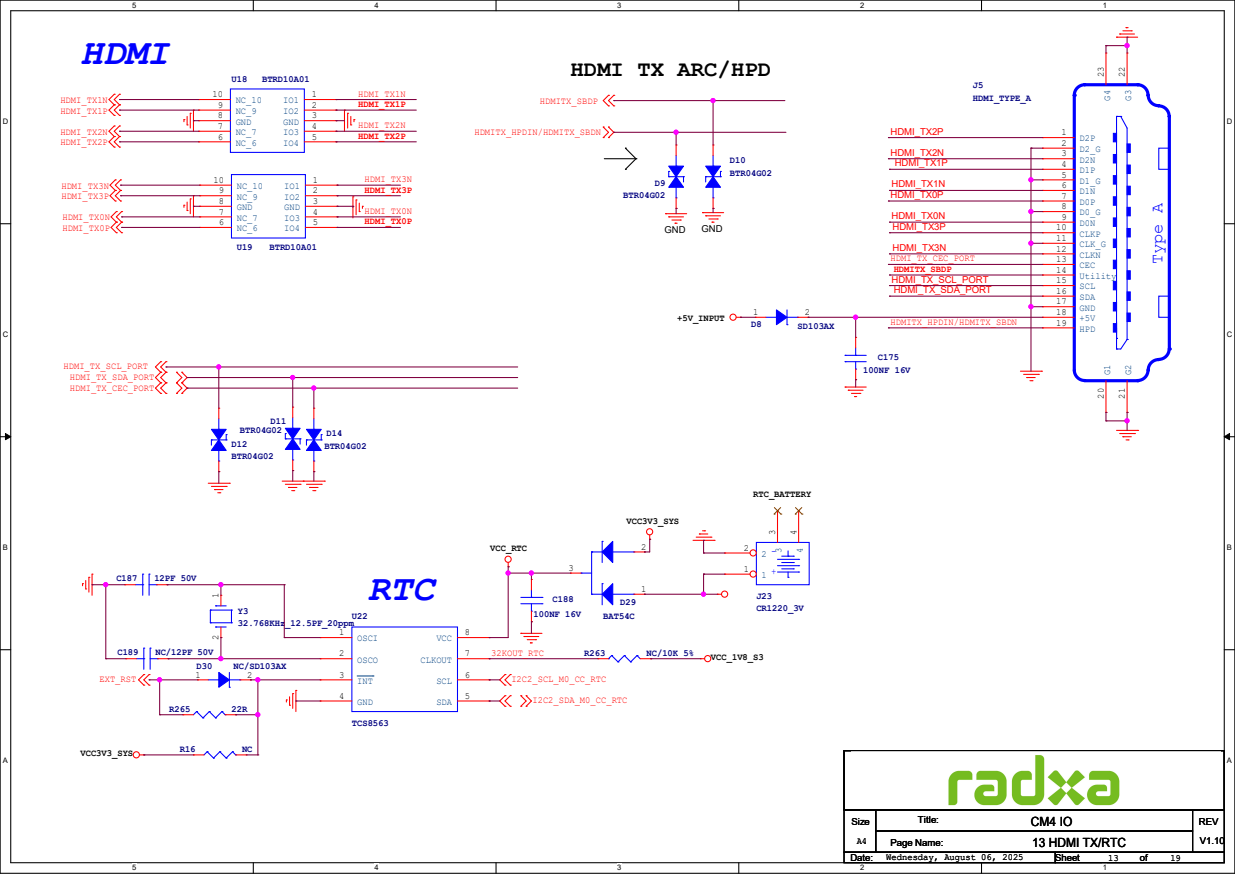
[picture p22: page 13]

# ETHERNET

## PHY_G_LED+

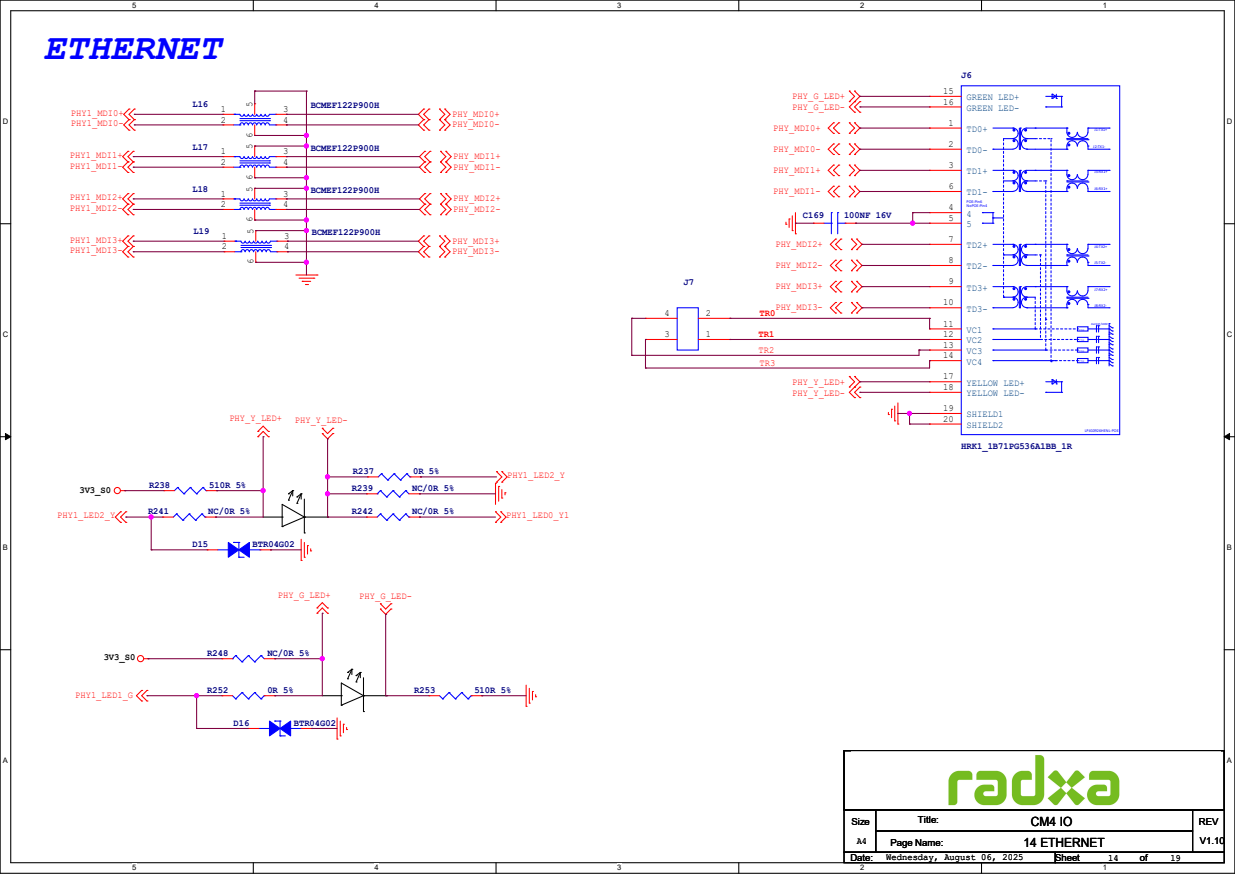
[picture p23: page 14]

# MicroSD Card

## SD_3V3

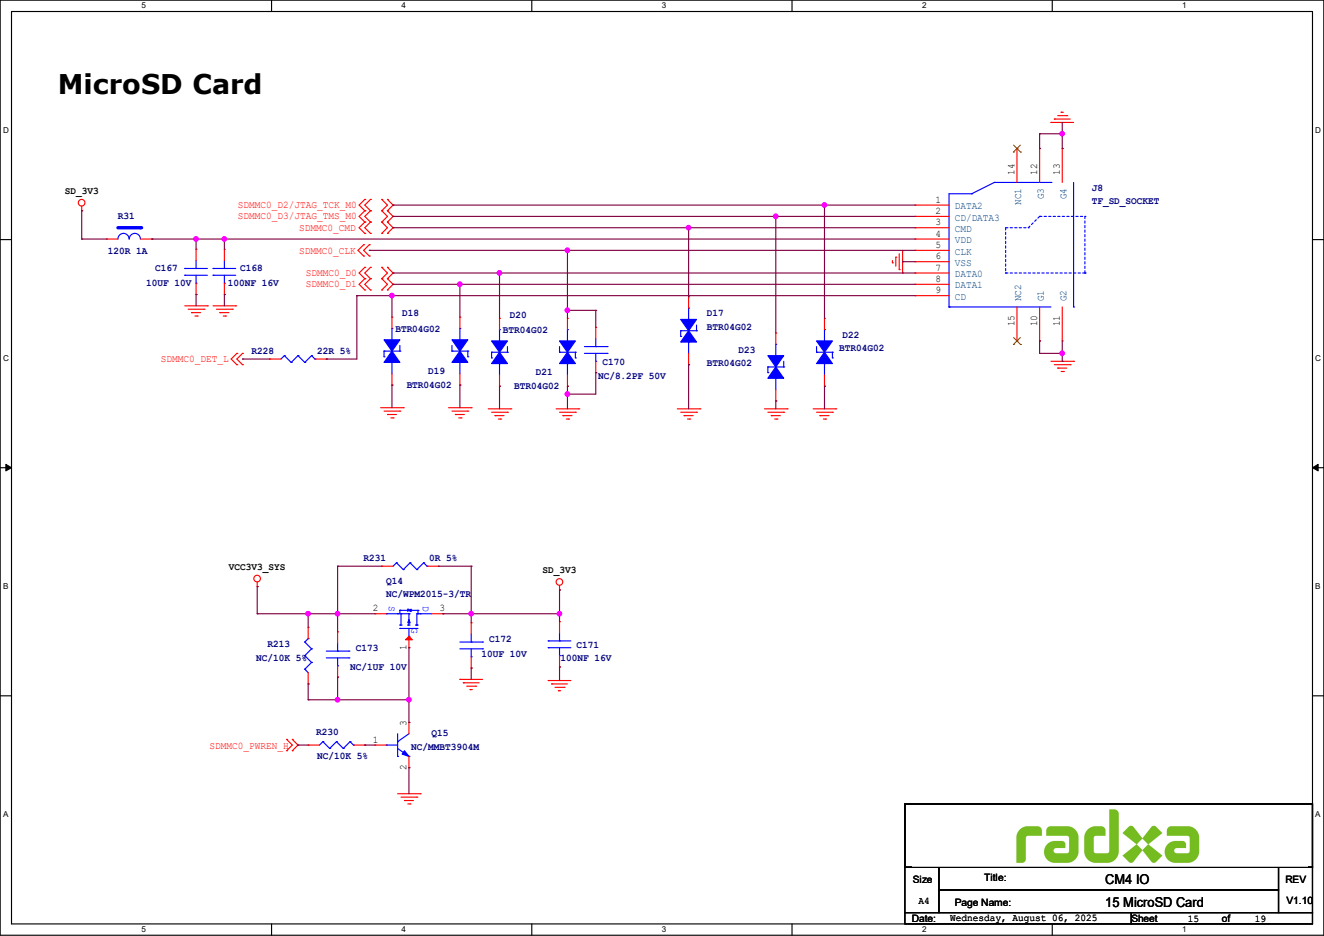
[picture p24: page 15]

4 5

# MIPI_LCD

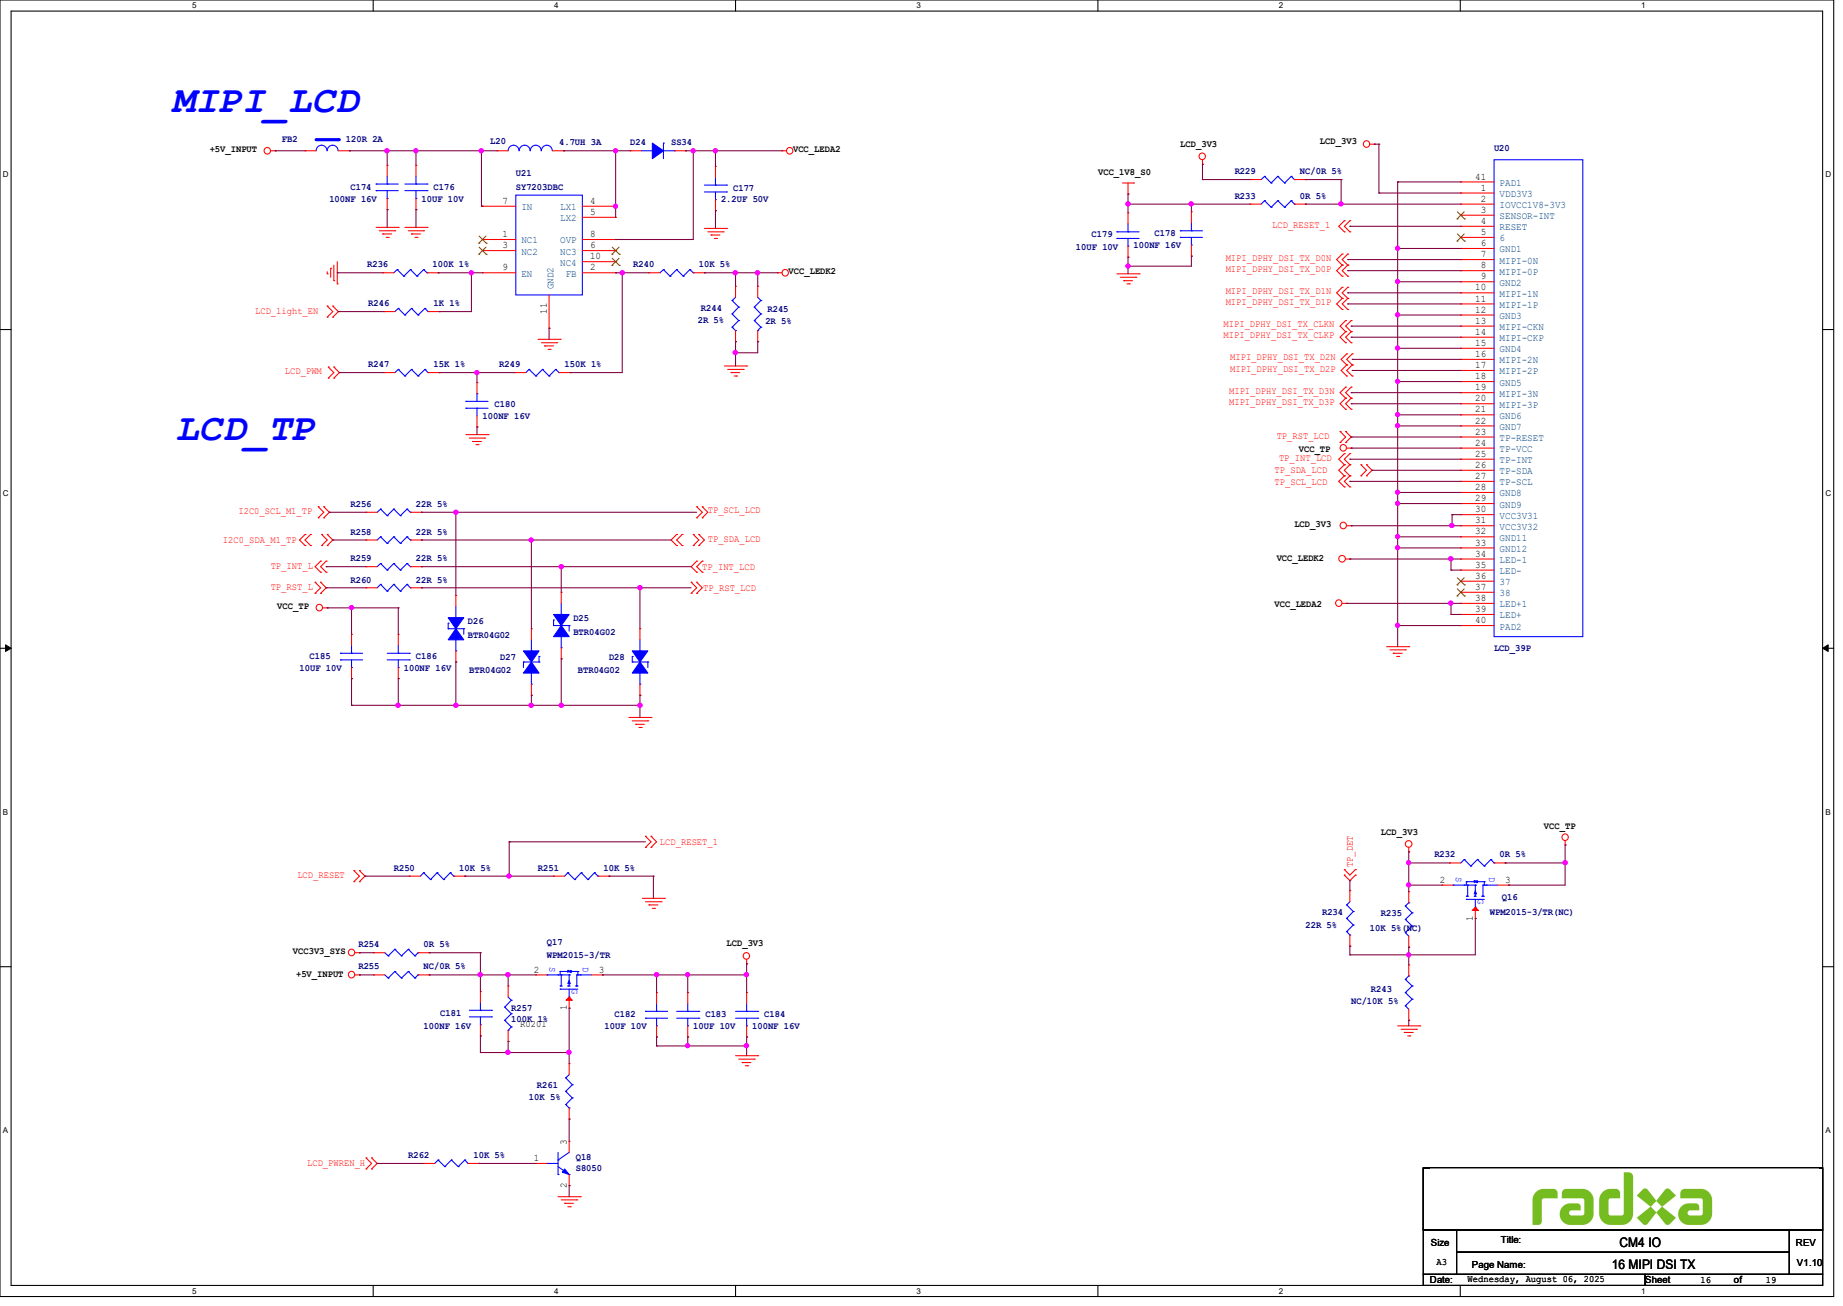
[picture p25: page 16]

MIPI_CSI2_RX 2Lanes | MIPI_CSI1_RX 2Lanes

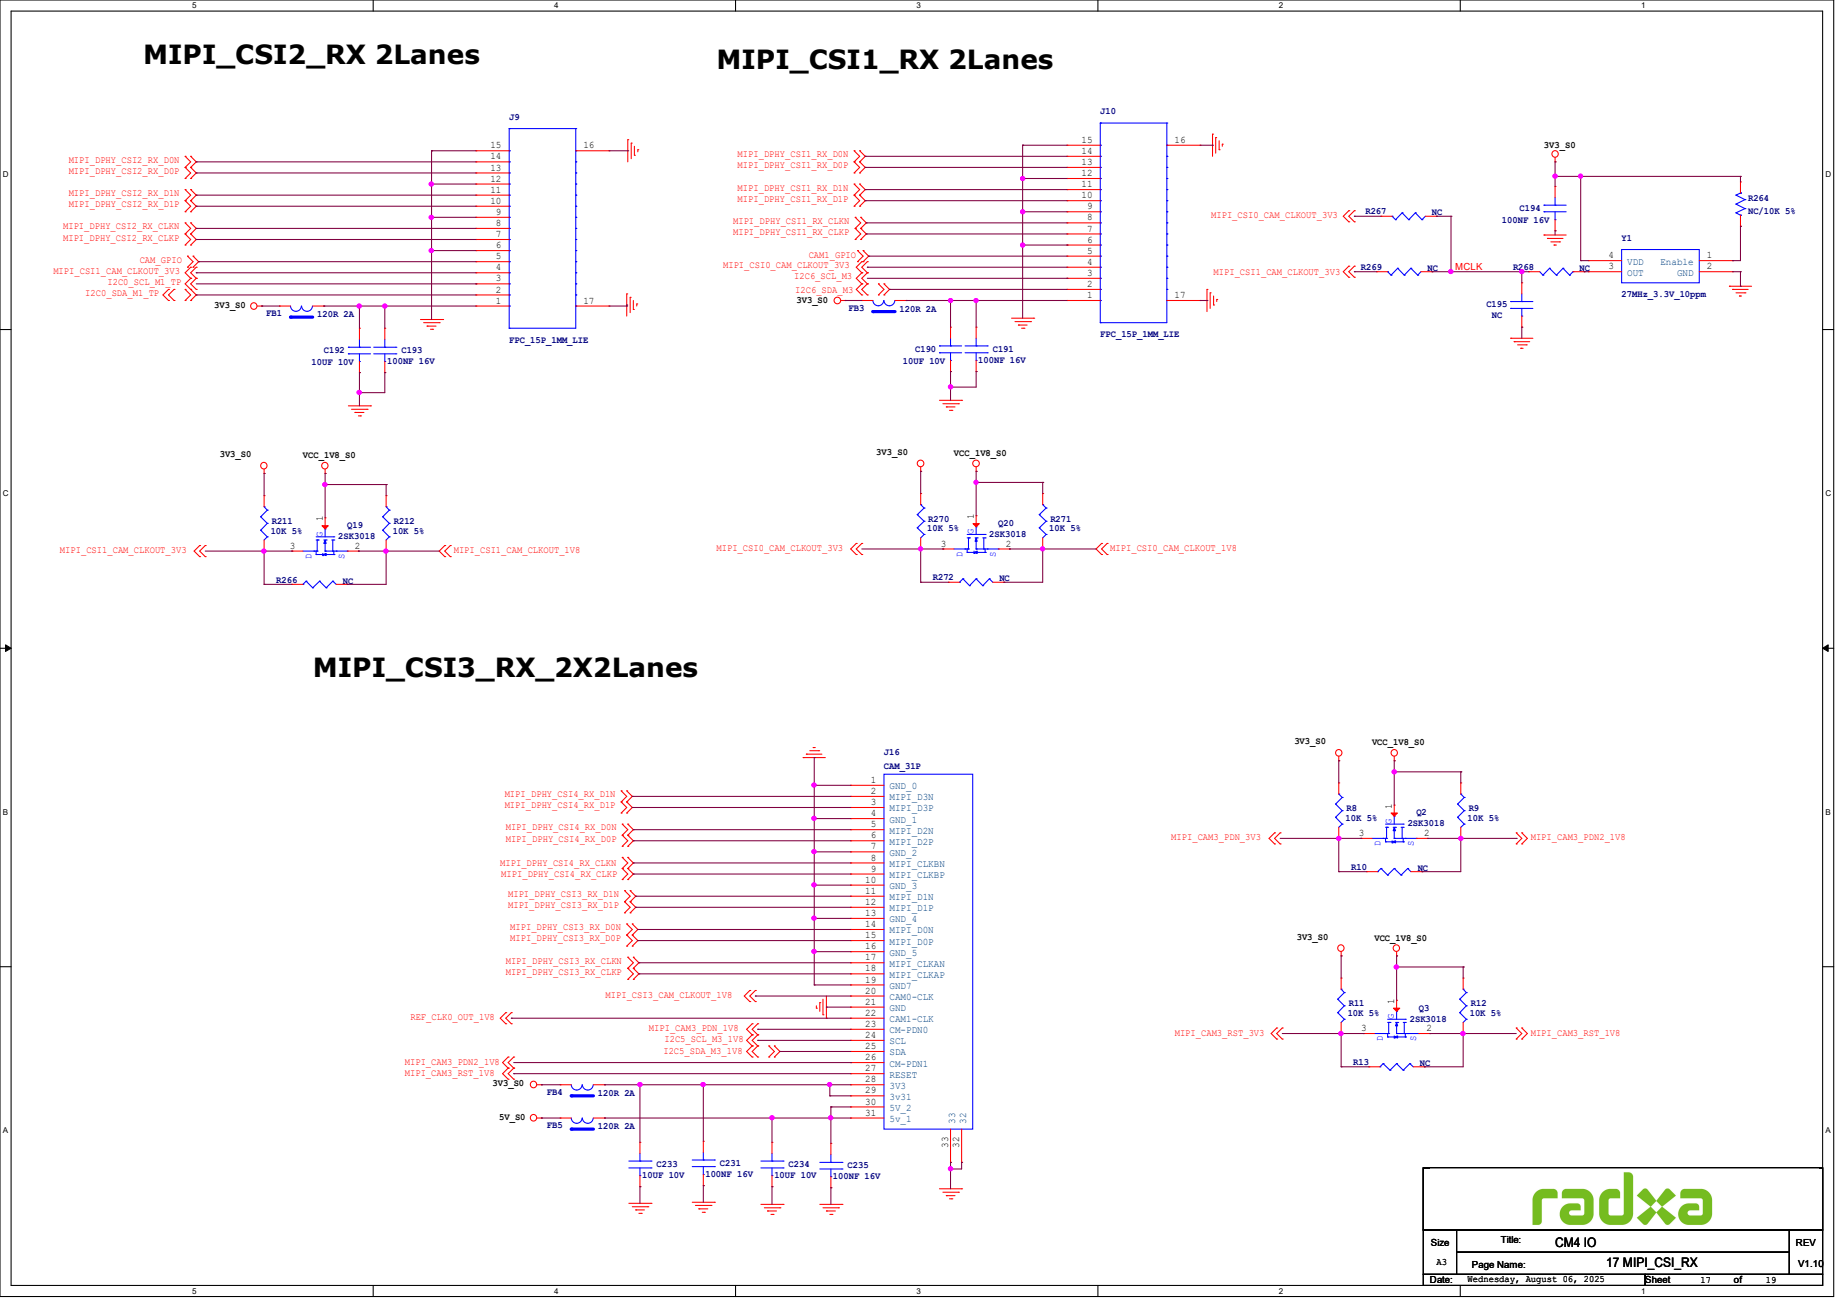
[picture p26: page 17]

# USB3.0

+5V_INPUT | 5V_USB_HOST

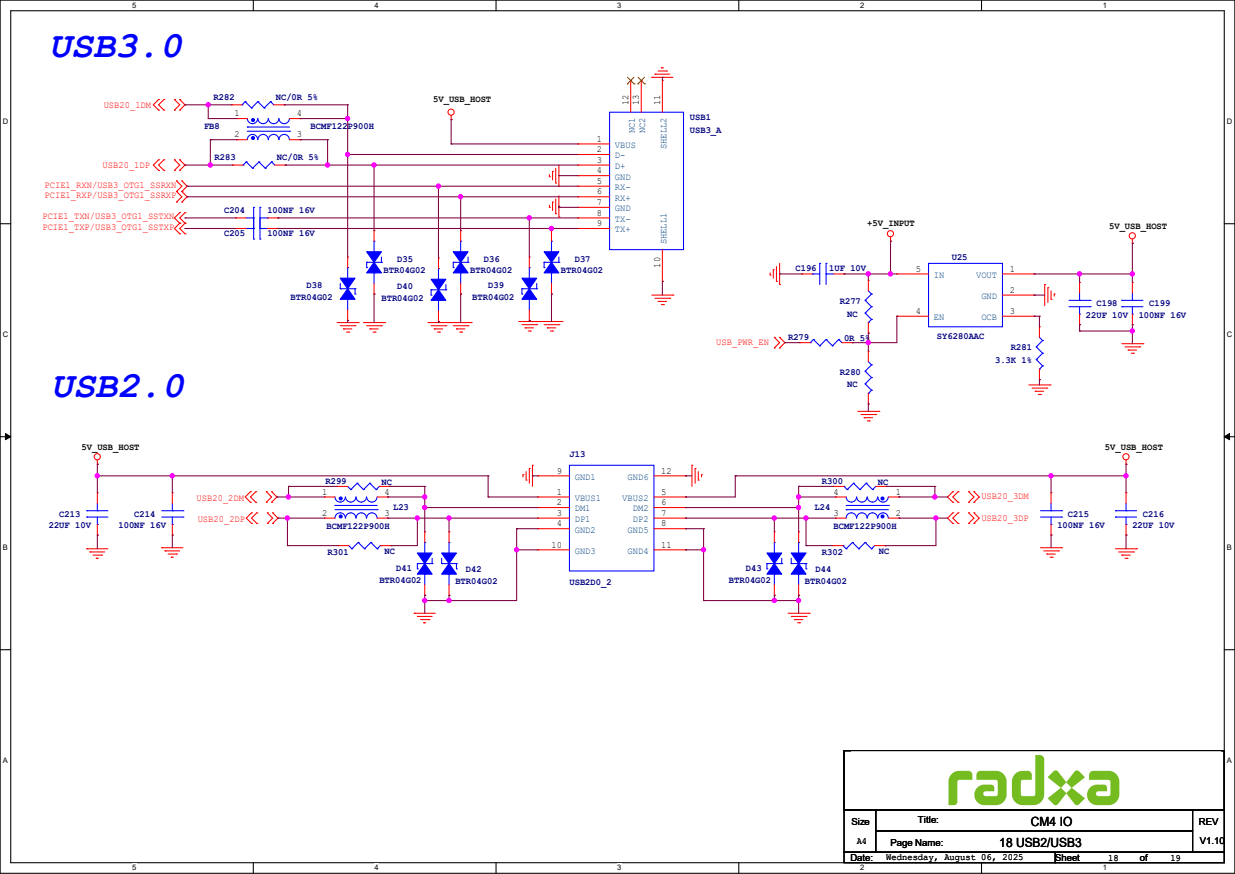
[picture p27: page 18]

# PCIe2.0 x 1 Lane

## 3V3_PCIE

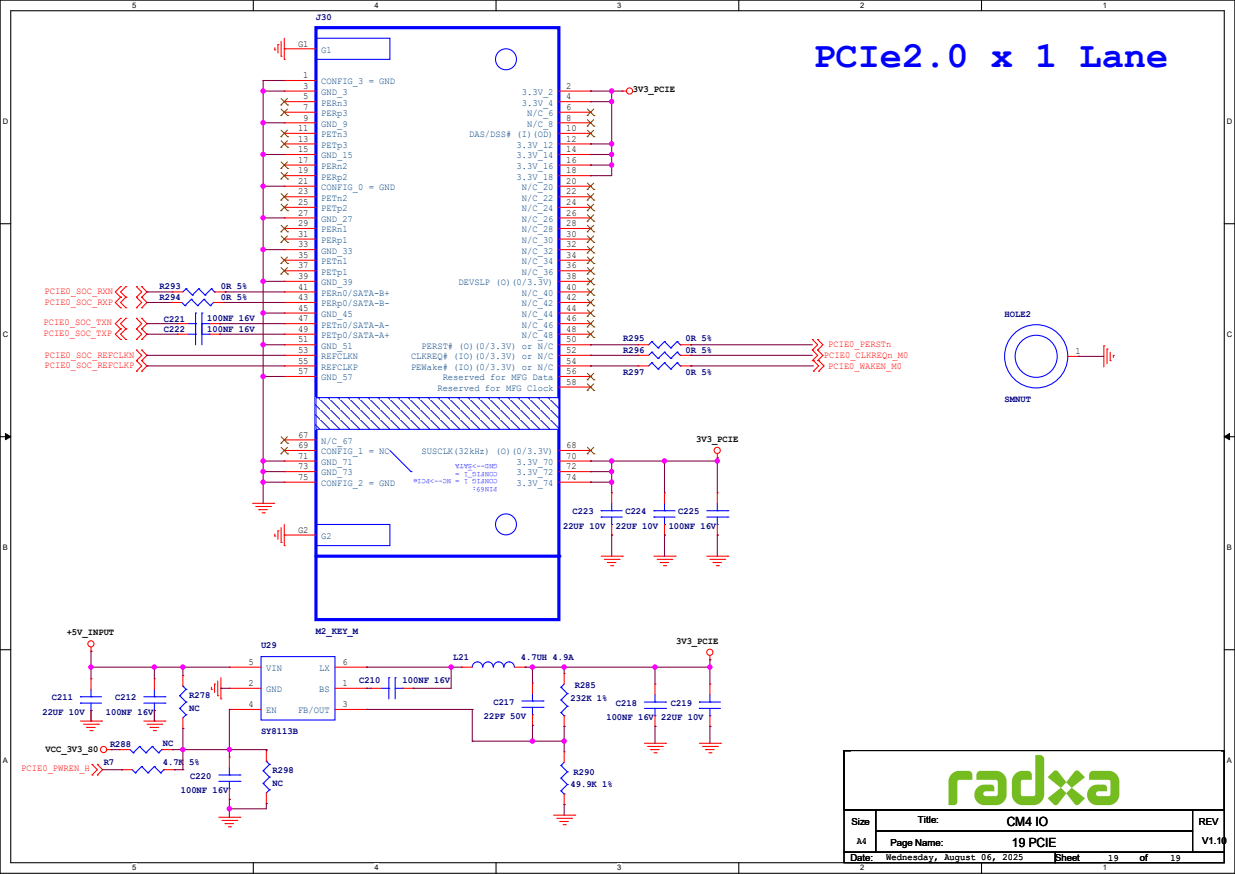
[picture p28: page 19]

PERST# (O)(0/3.3V) or N/C 50
CLKREQ# (IO)(0/3.3V) or N/C 52
PEWake# (IO)(0/3.3V) or N/C 54
Reserved for MFG Data
Reserved for MFG Clock
