radxa/radxa-cm-projects/nx5/radxa-nx5-io-board/radxa_nx5_io_board_v1.4_schematic.pdf

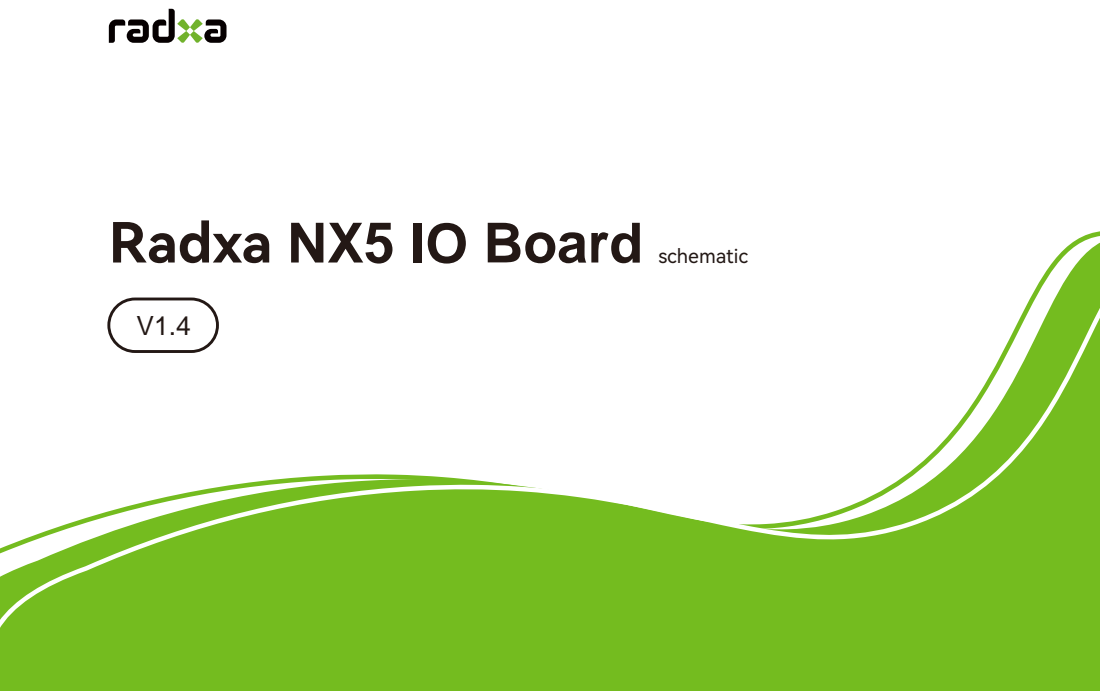
[picture p29: page 1]

Radxa NX5 IO Board schematic

5

4

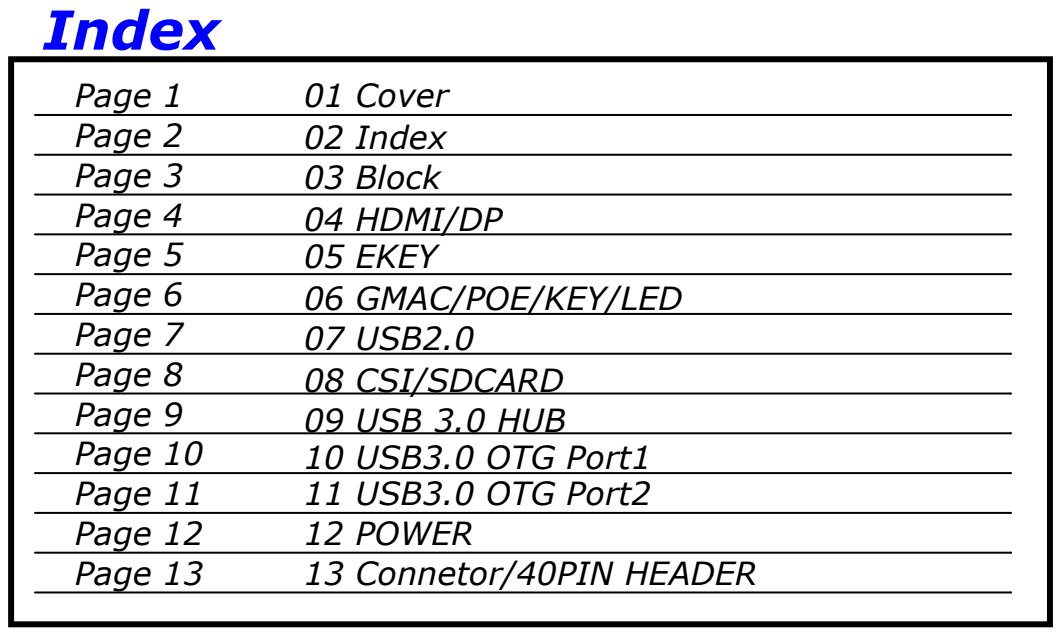
[picture p30: page 2]
Index; 01 Cover; Page 9; Page 5; 02 Index 03 Block; Page 1; 10 USB3.0 OTG Port1; Page 8; Page 7; Page 10; 11 USB3.0 OTG Port2; Page 6; Page 11; 06 GMAC/POE/KEY/LED; 04 HDMI/DP; Page 13; Page 2; Page 4; 12 POWER; 05 EKEY; 07 USB2.0; 09 USB 3.0 HUB; 13 Connetor/40PIN HEADER; Page 3; Page 12; 08 CSI/SDCARD; Size; REV; Date:; Sheet; Title:; Page Name:; 02.Index; Wednesday, May 15, 2024

Radxa NX5 IO Board

D D

# Block

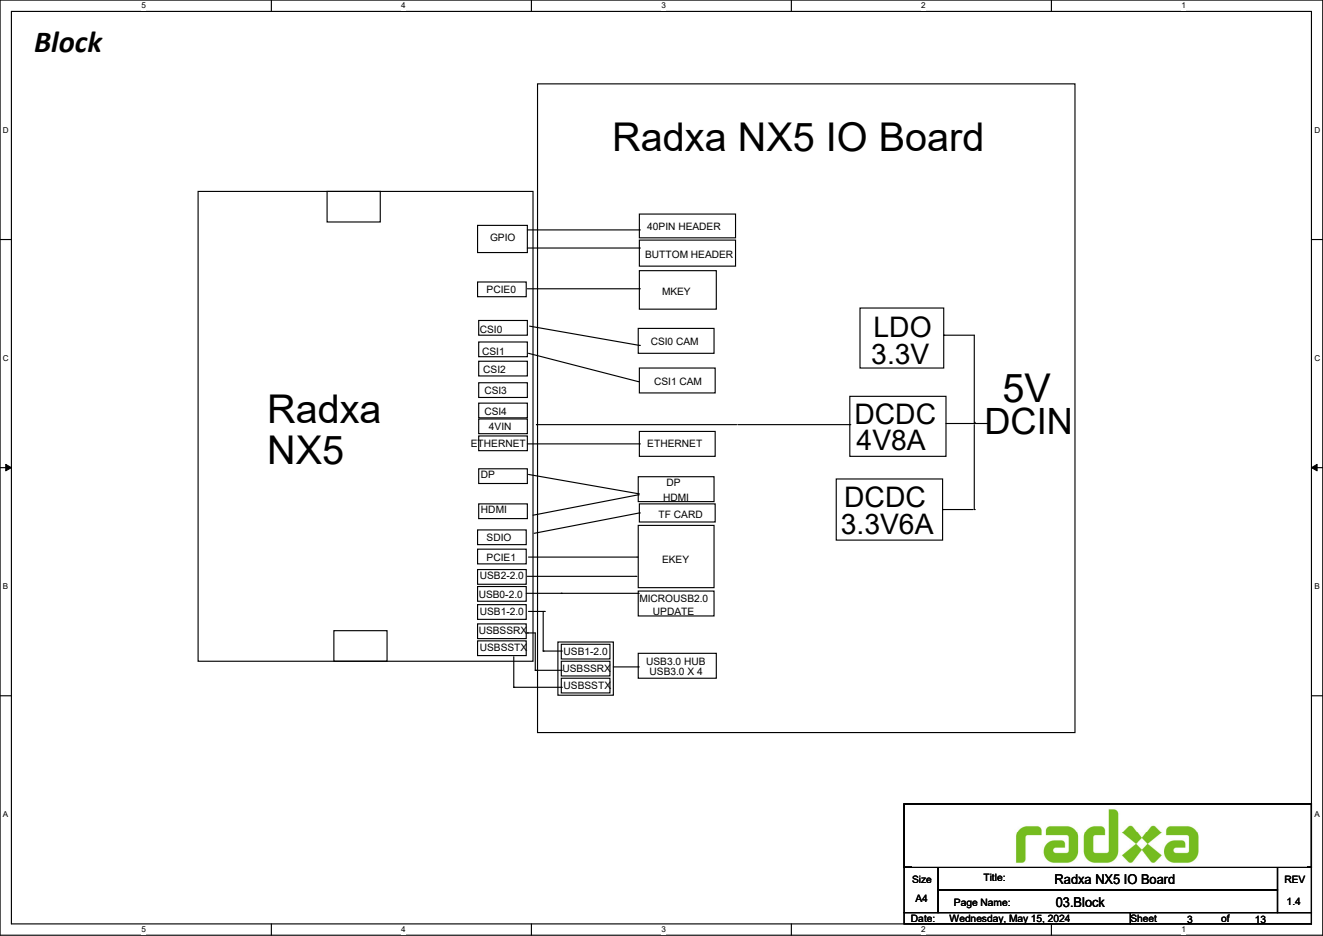
[picture p31: page 3]
USB0-2.0; USB1-2.0; USB2-2.0; MICROUSB2.0 UPDATE; USBSSRX; USBSSTX; USB3.0 HUB USB3.0 X 4; EKEY; Radxa NX5; HDMI; ETHERNET; CSI0; CSI1; CSI2; CSI3; CSI4; PCIE0; PCIE1; DCDC; DCIN 4V8A; DCDC 3.3V6A; DP HDMI; CSI1 CAM; CSI0 CAM; MKEY; BUTTOM HEADER; 40PIN HEADER; GPIO; SDIO; LDO 3.3V; TF CARD; 4VIN; Page Name:; 03.Block; Wednesday, May 15, 2024

Radxa NX5 IO Board

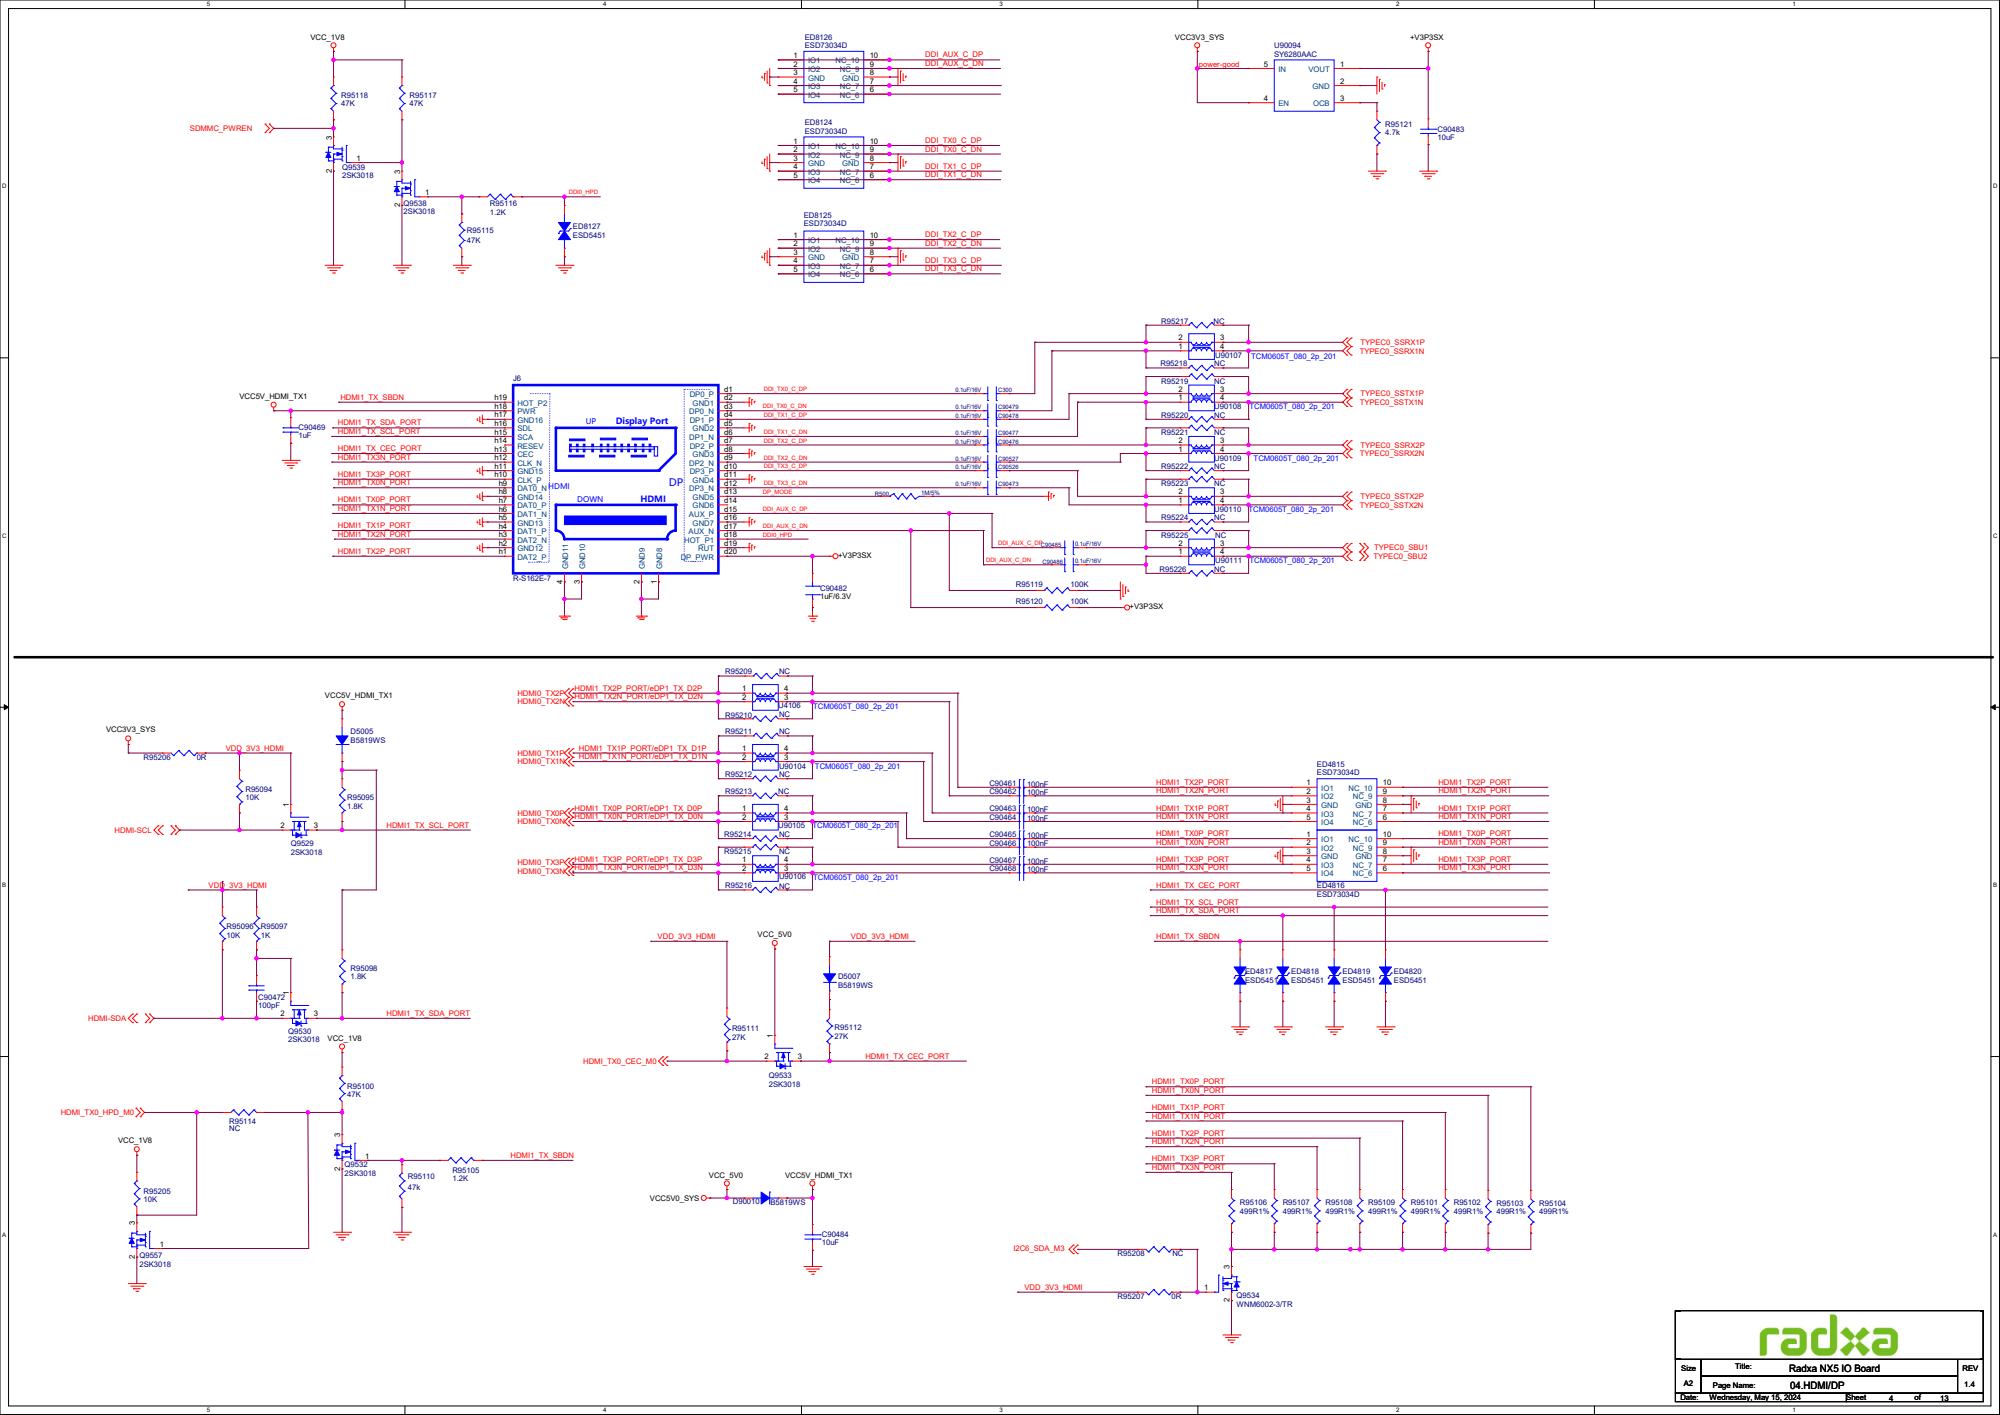
[picture p32: page 4]

D D

# VCC3V3_WF

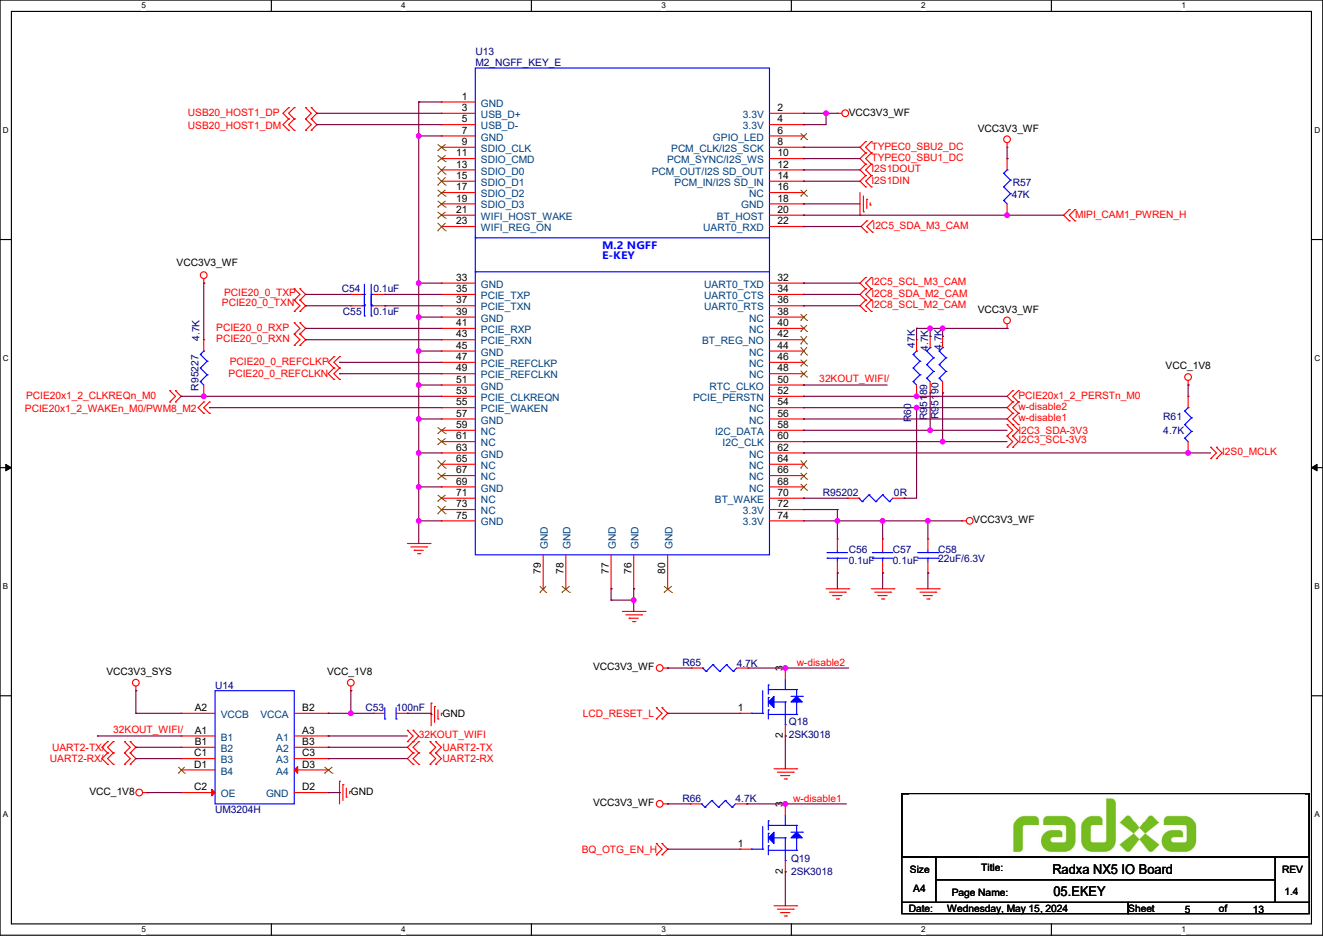
[picture p33: page 5]

D D

# VCC3V3_SYS

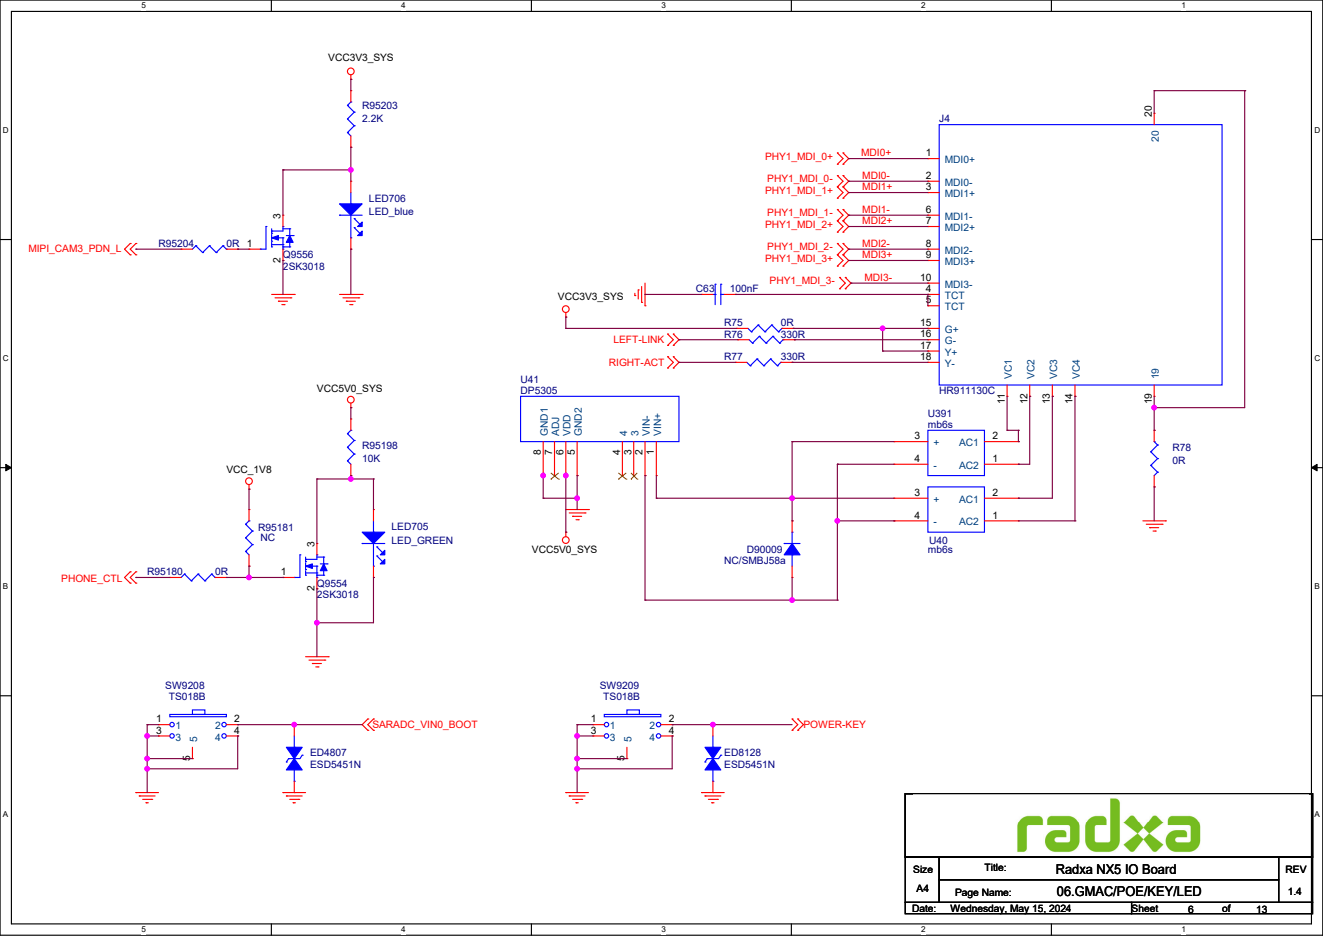
[picture p34: page 6]

D D

# VBUS VCC5V0_SYS

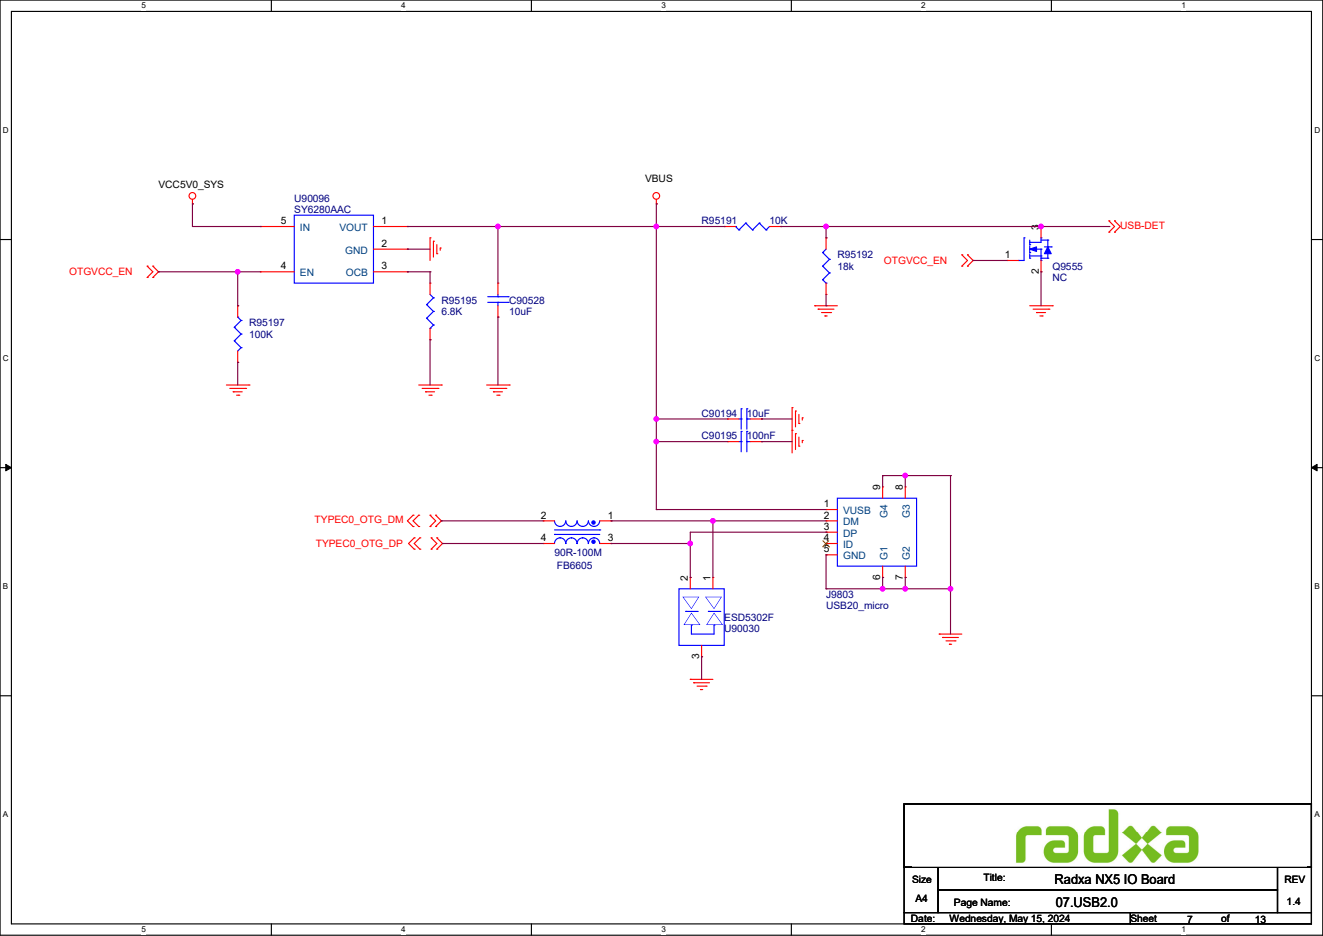
[picture p35: page 7]
TYPEC0_OTG_DM; TYPEC0_OTG_DP; USB-DET; OTGVCC_EN; Page Name:; 07.USB2.0; Wednesday, May 15, 2024; ESD5302F; U90096 SY6280AAC; OCB 3; GND 2; VOUT; J9803 USB20_micro; VUSB 1 DM 2 DP 3 ID 4 GND 5

D D

## VCC3V3_SYS

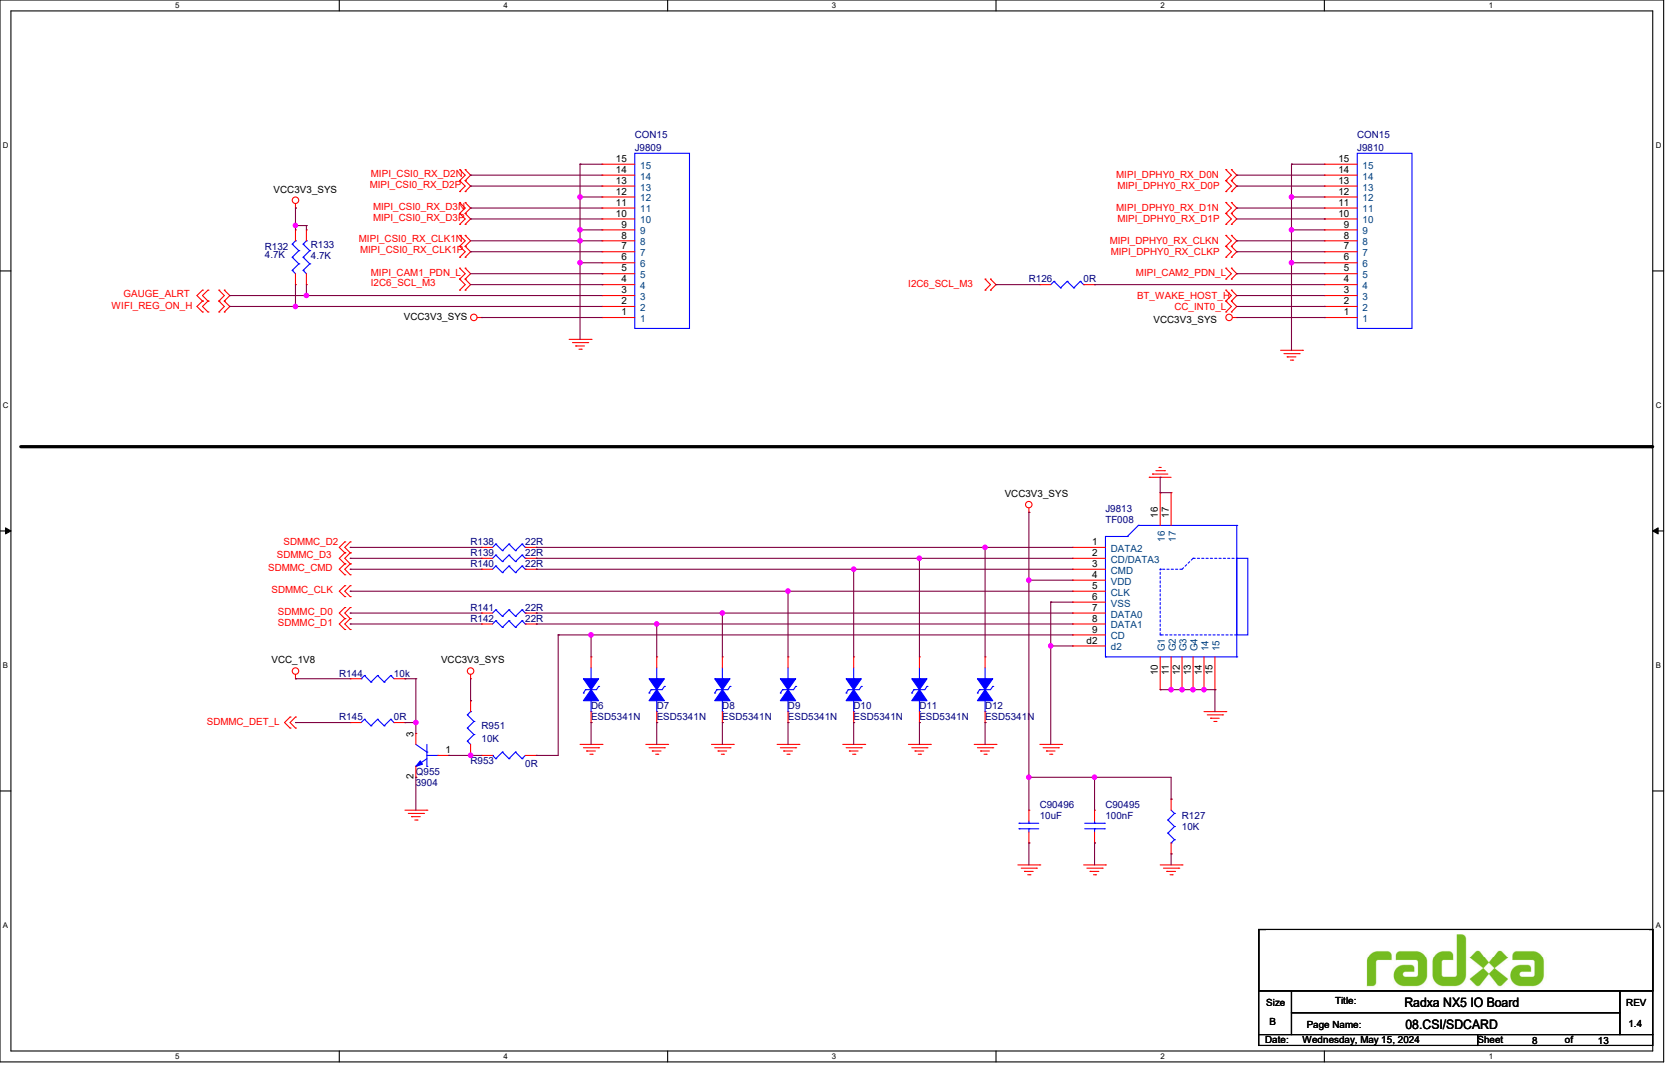
[picture p36: page 8]

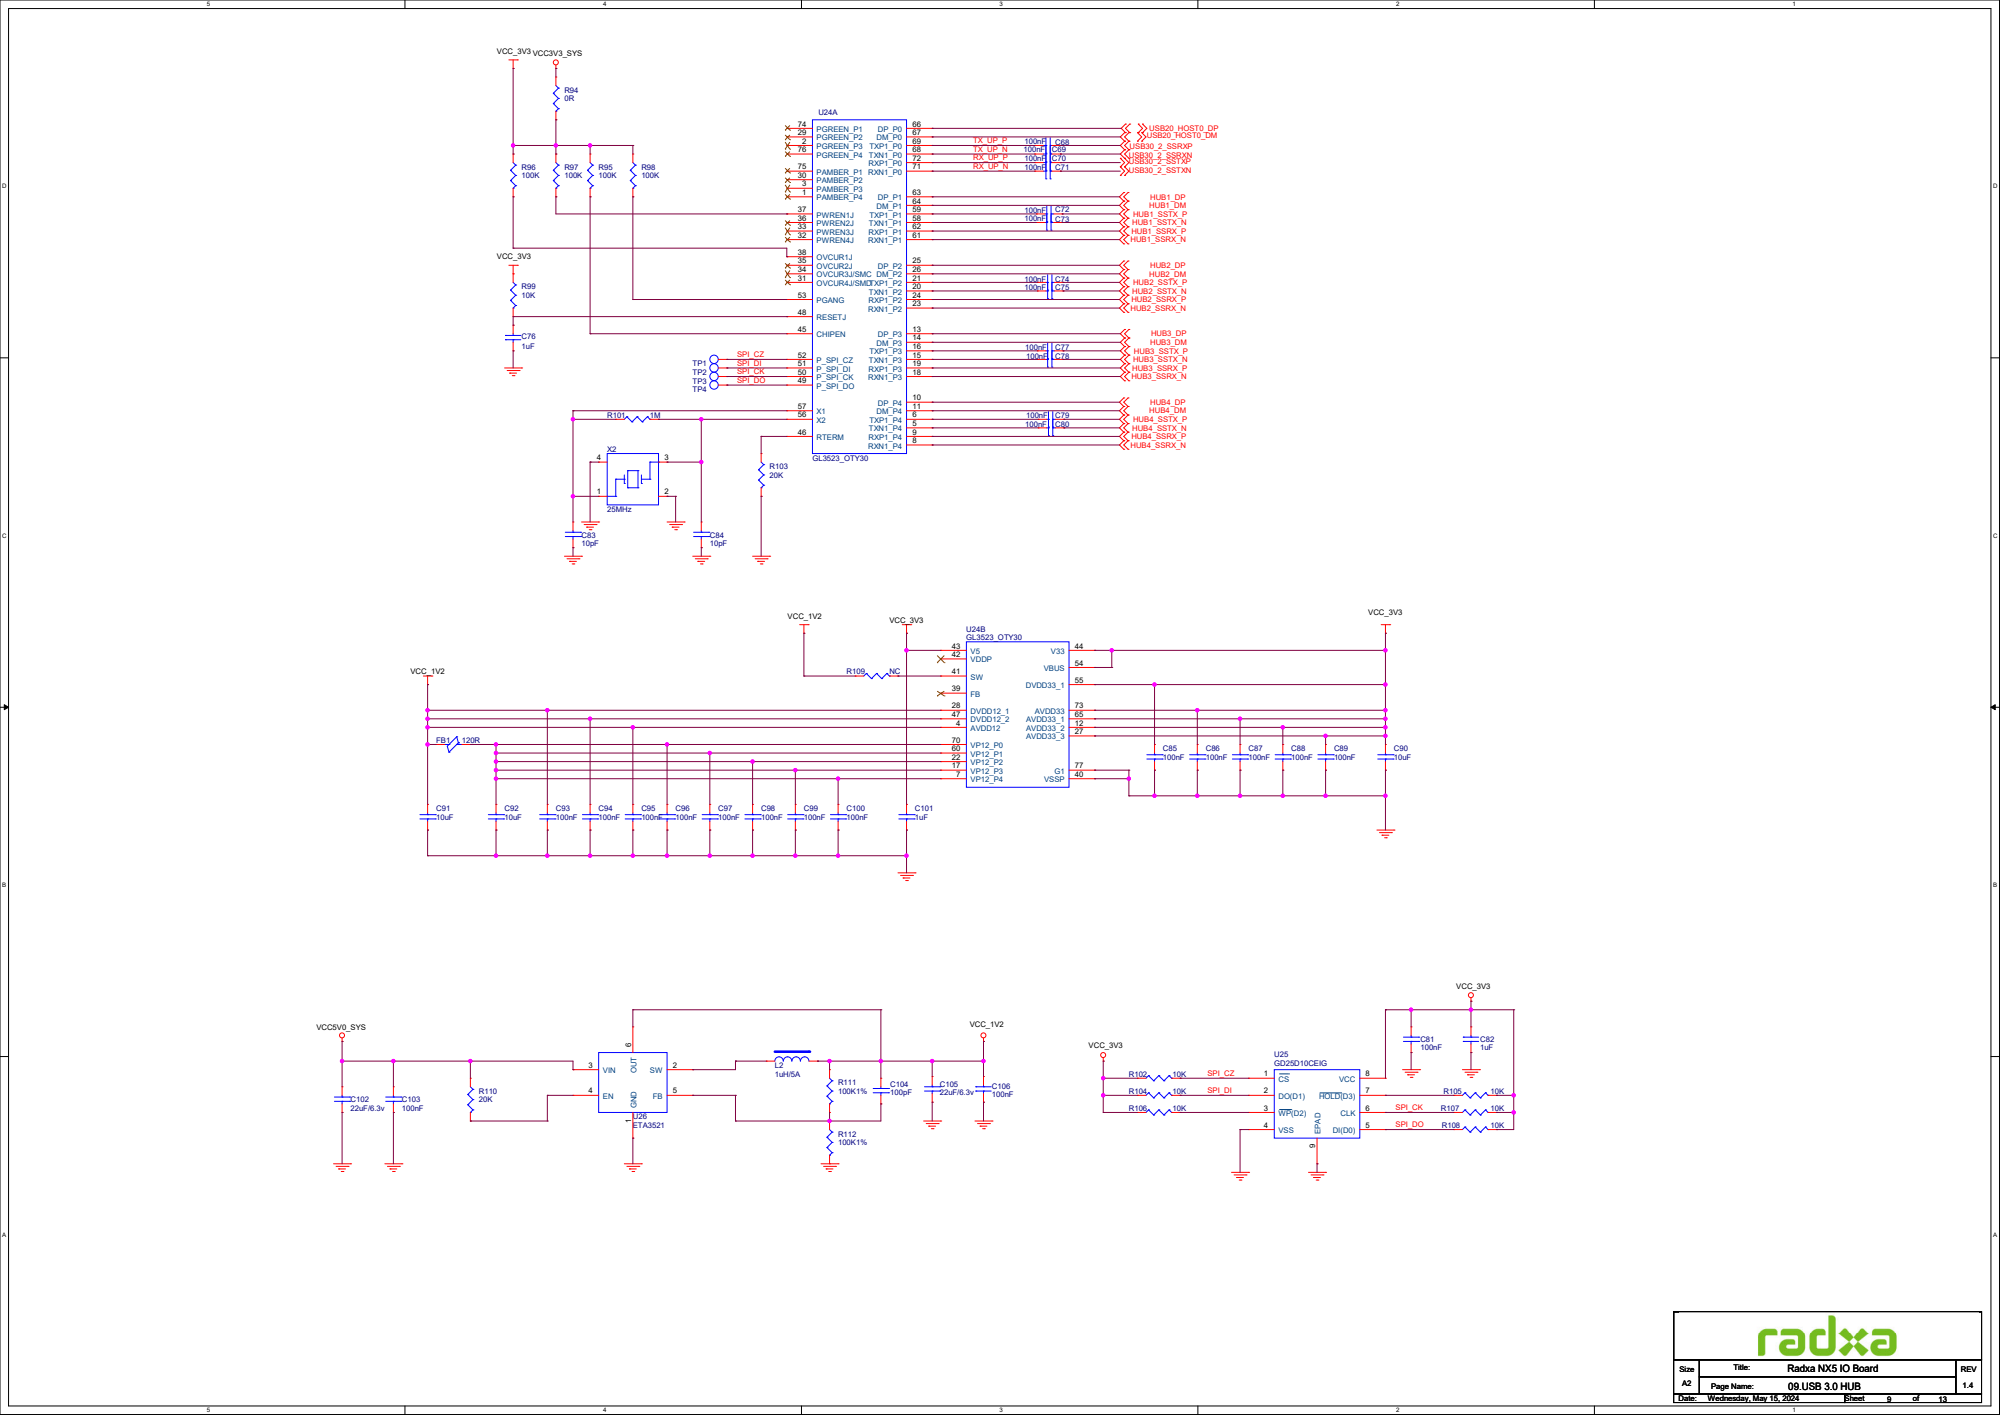
[picture p37: page 9]

D D

VCC5V0_SYS | USB5V_CON1

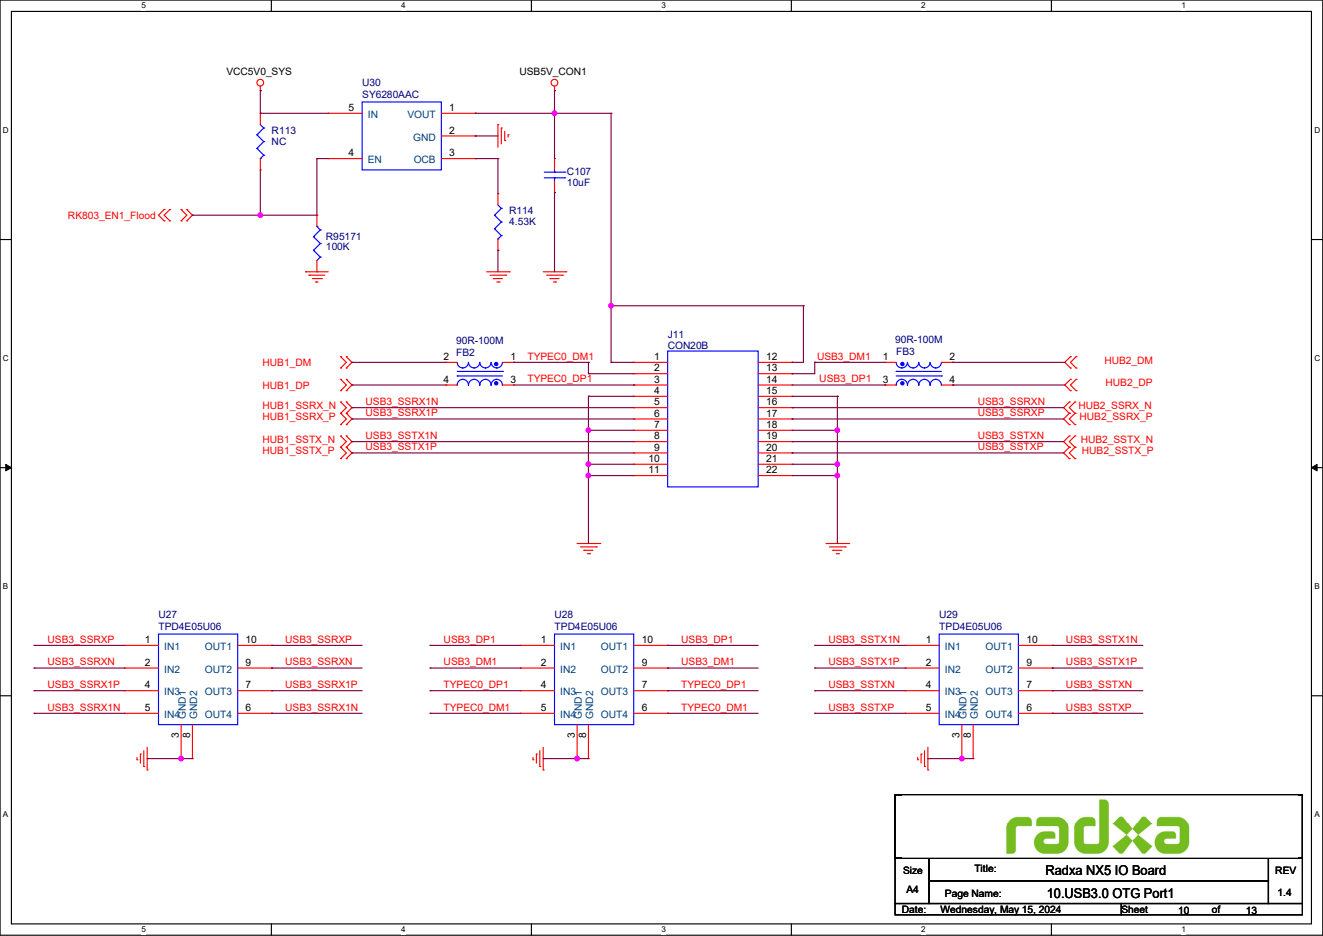
[picture p38: page 10]

D D

VCC5V0_SYS | USB5V-CON2

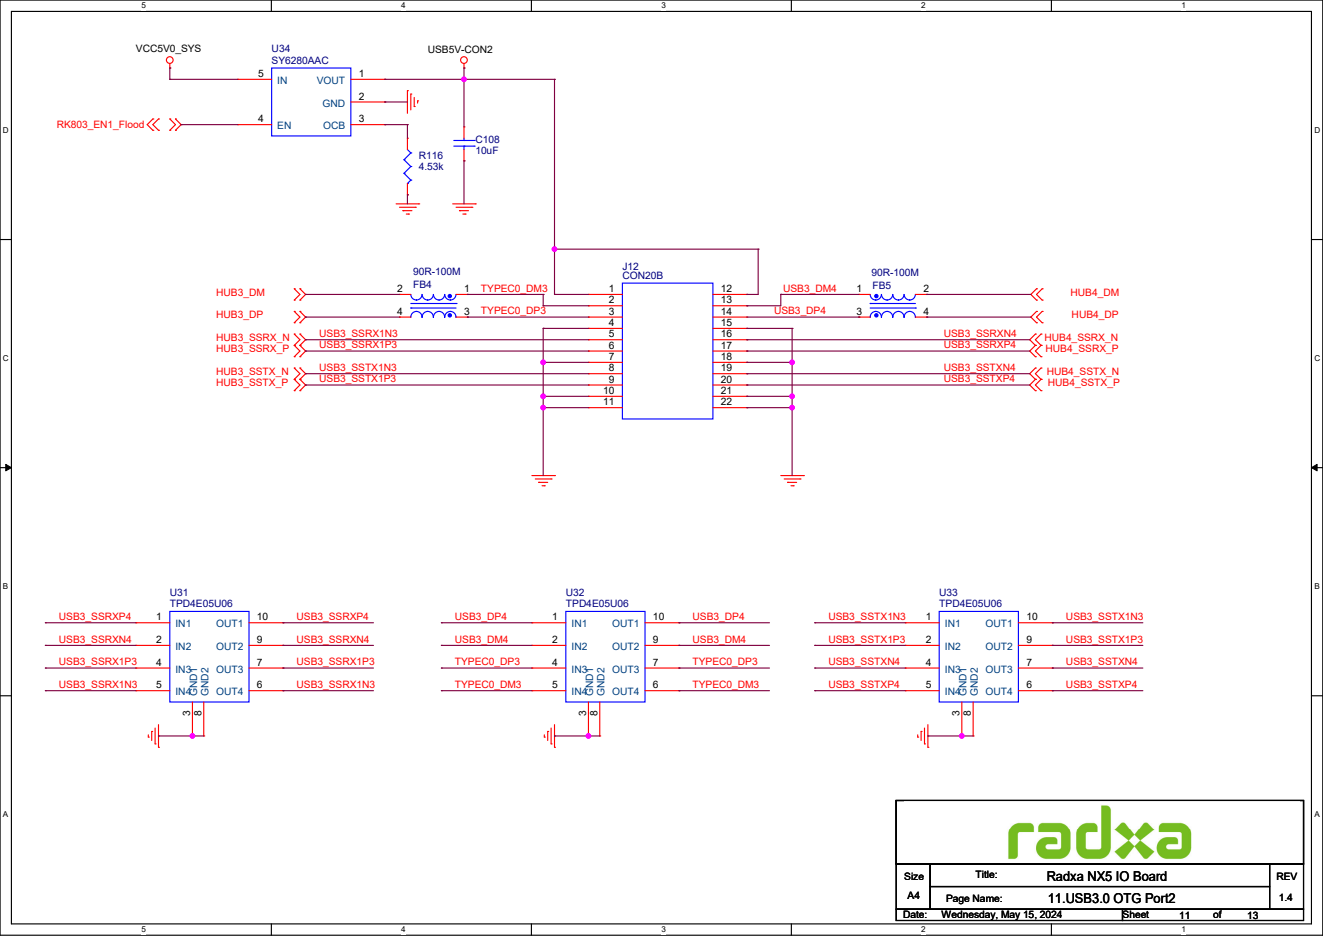
[picture p39: page 11]

## VCC5V0_SYS

## VCC5V0_SYS

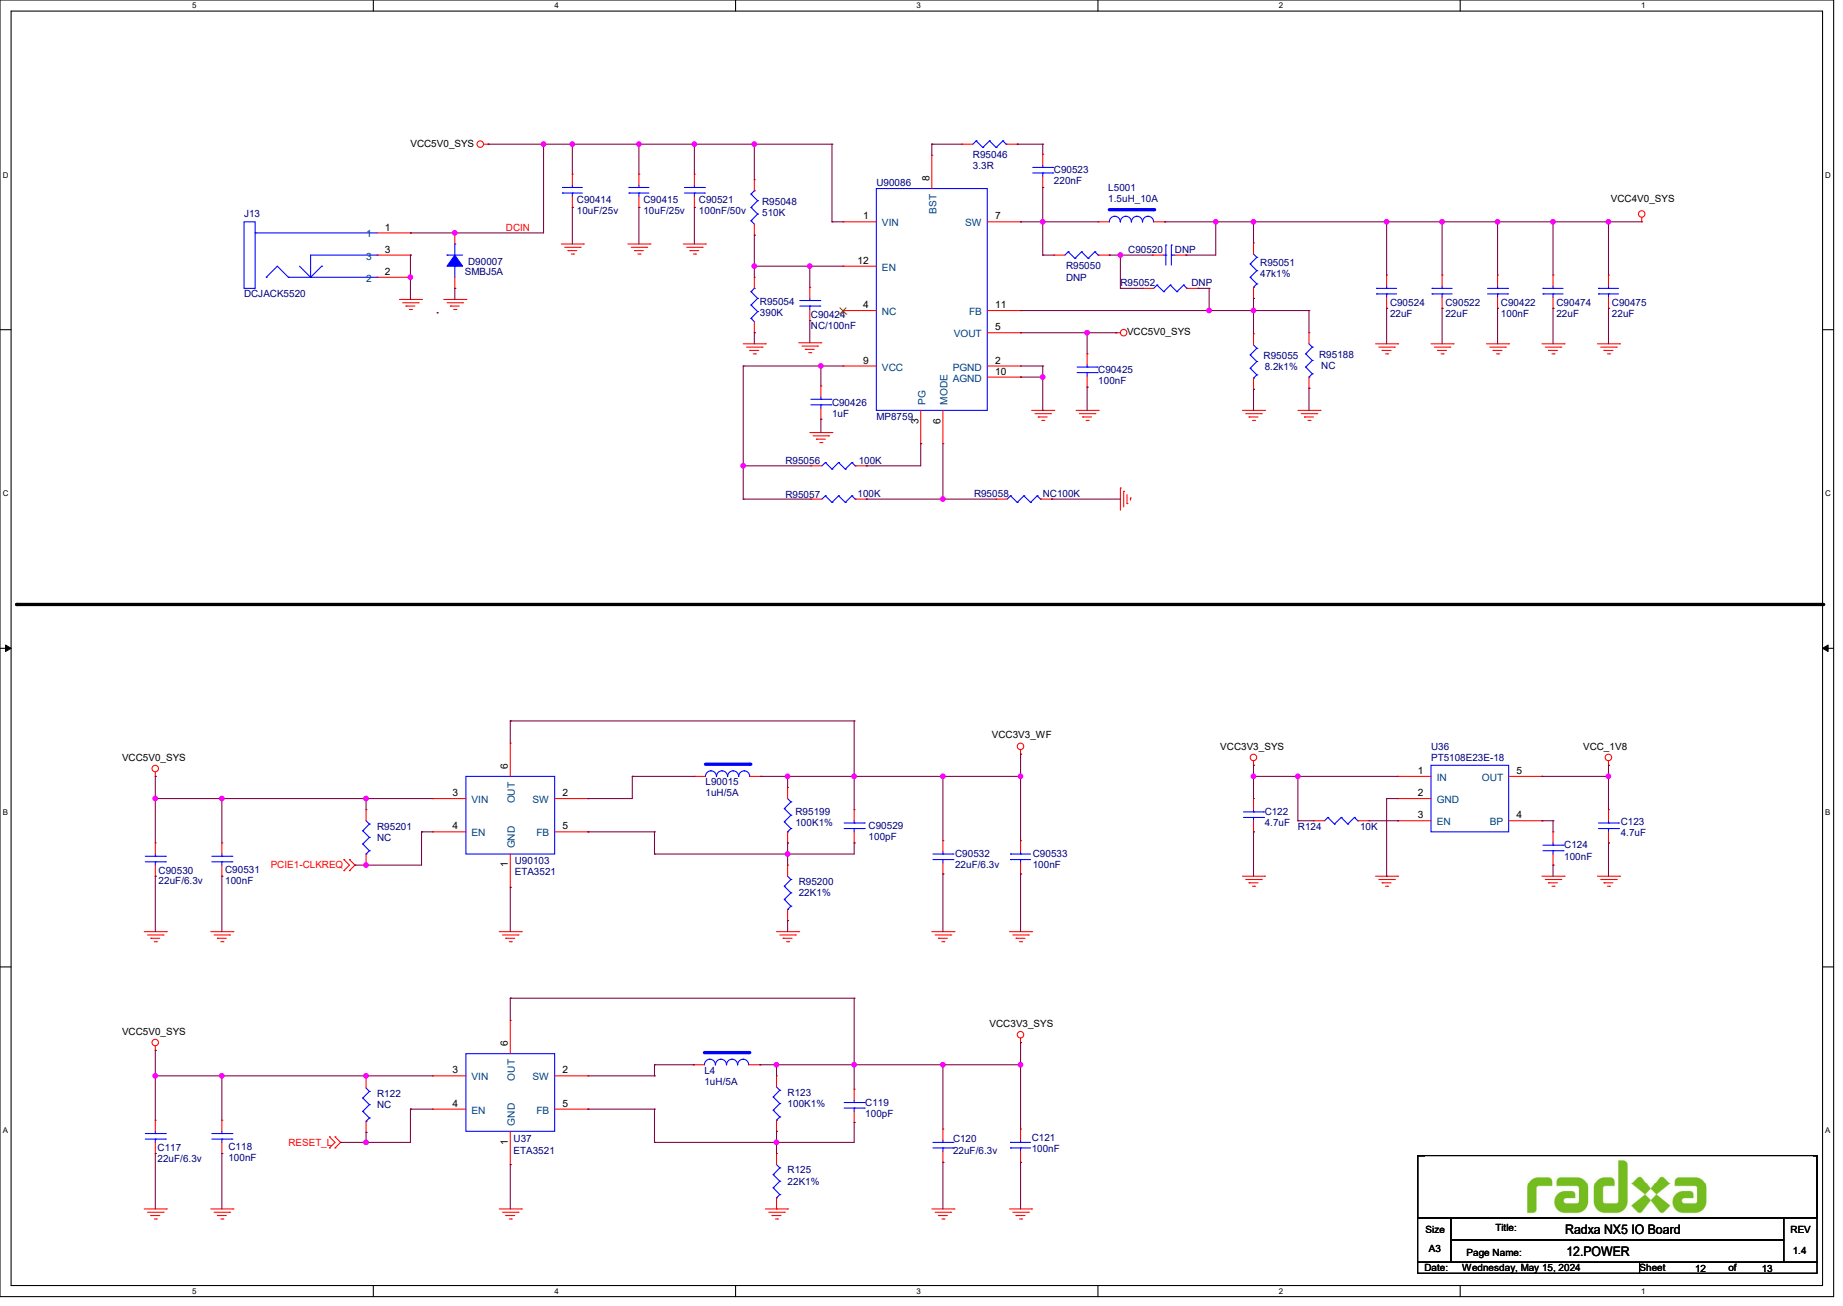
[picture p40: page 12]

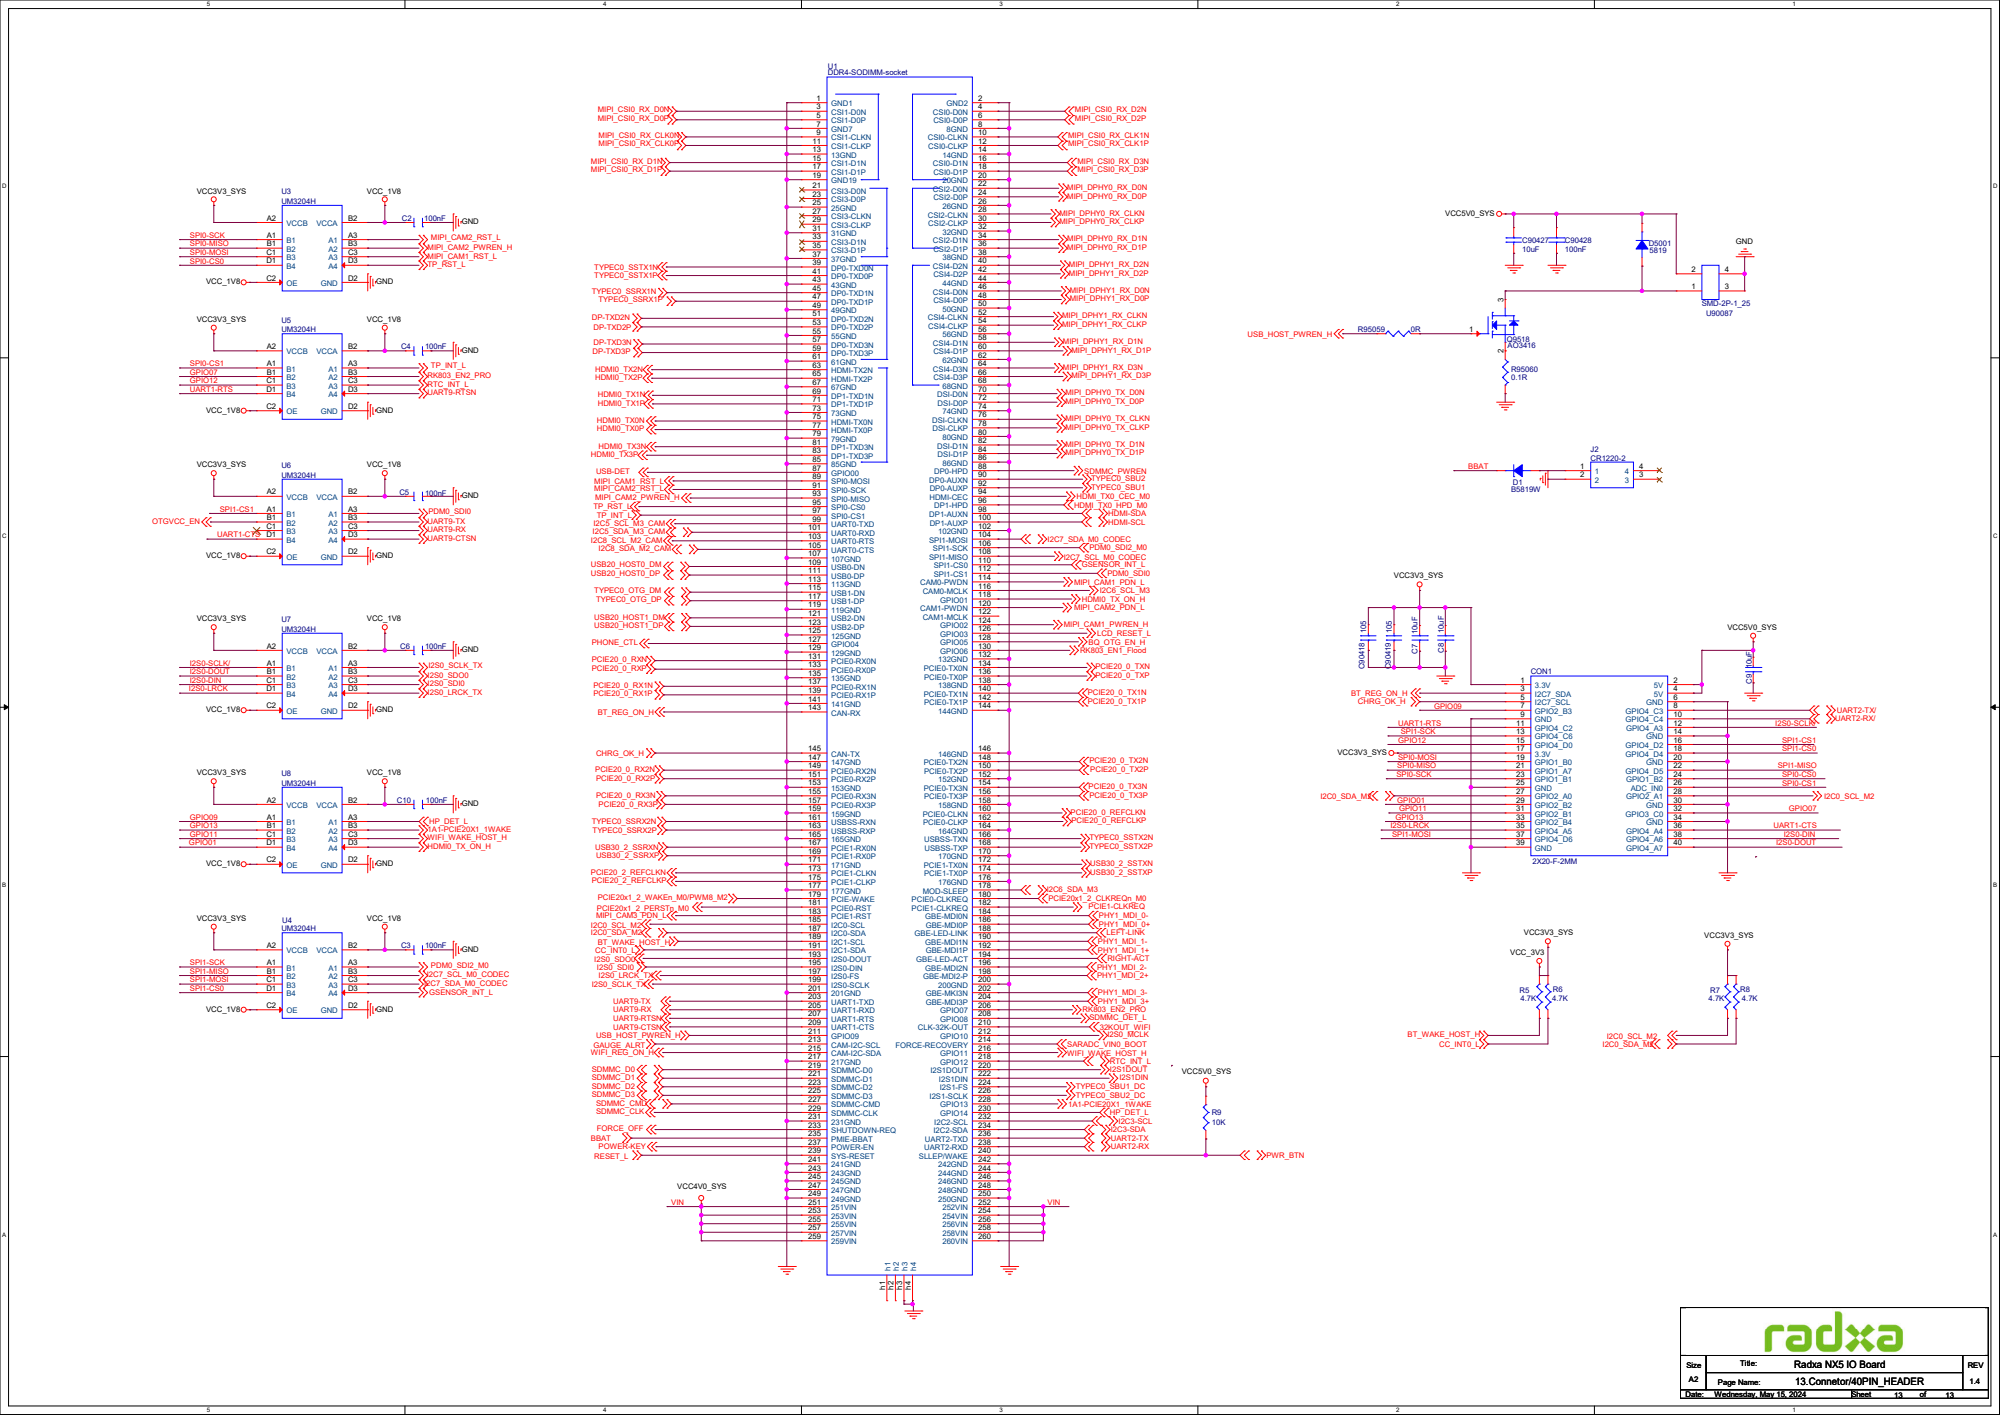
[picture p41: page 13]
