radxa/radxa-cm-projects/cm3i/radxa-cm3i-io-board/radxa_cm3i_io_board_schematic_v1.4.pdf

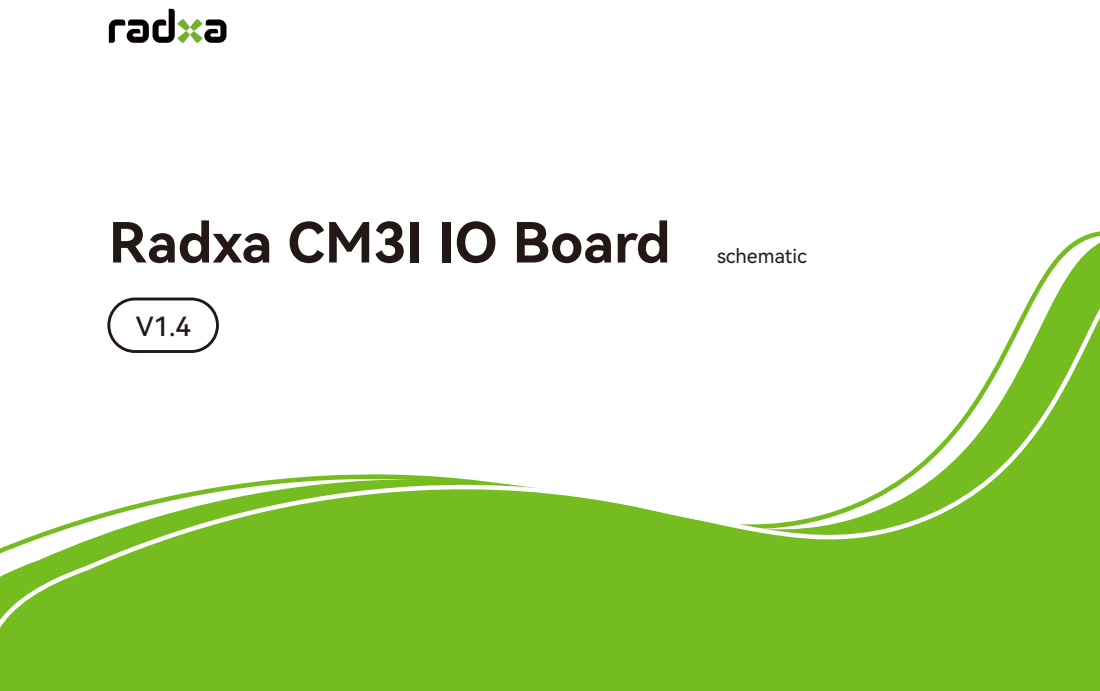
[picture p42: page 1]
schematic

Radxa CM3I IO Board

# 01.cover 02.Index and Notes

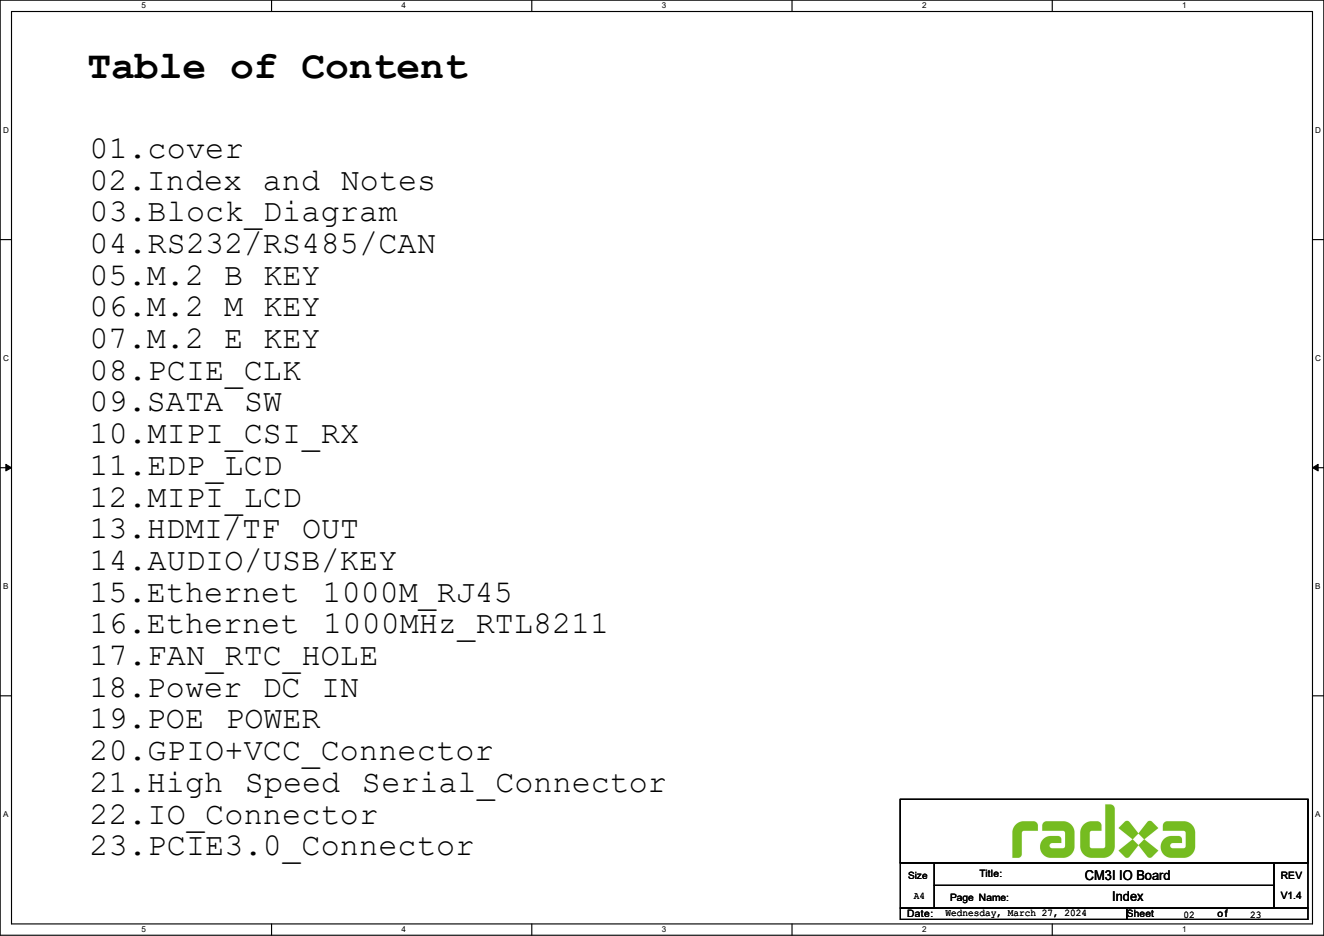
[picture p43: page 2]
03.Block_Diagram 04.RS232/RS485/CAN 05.M.2 B KEY 06.M.2 M KEY 07.M.2 E KEY 08.PCIE_CLK 09.SATA SW 10.MIPI_CSI_RX 11.EDP_LCD 12.MIPI_LCD 13.HDMI/TF OUT 14.AUDIO/USB/KEY 15.Ethernet 1000M_RJ45 16.Ethernet 1000MHz_RTL8211 17.FAN_RTC_HOLE 18.Power DC IN 19.POE POWER 20.GPIO+VCC_Connector 21.High Speed Serial_Connector 22.IO_Connector 23.PCIE3.0_Connector; Size; REV; Date:; Sheet; Title:; Page Name:; Index; CM3I IO Board A4; Wednesday, March 27, 2024

Table of Content

## SATA POWER

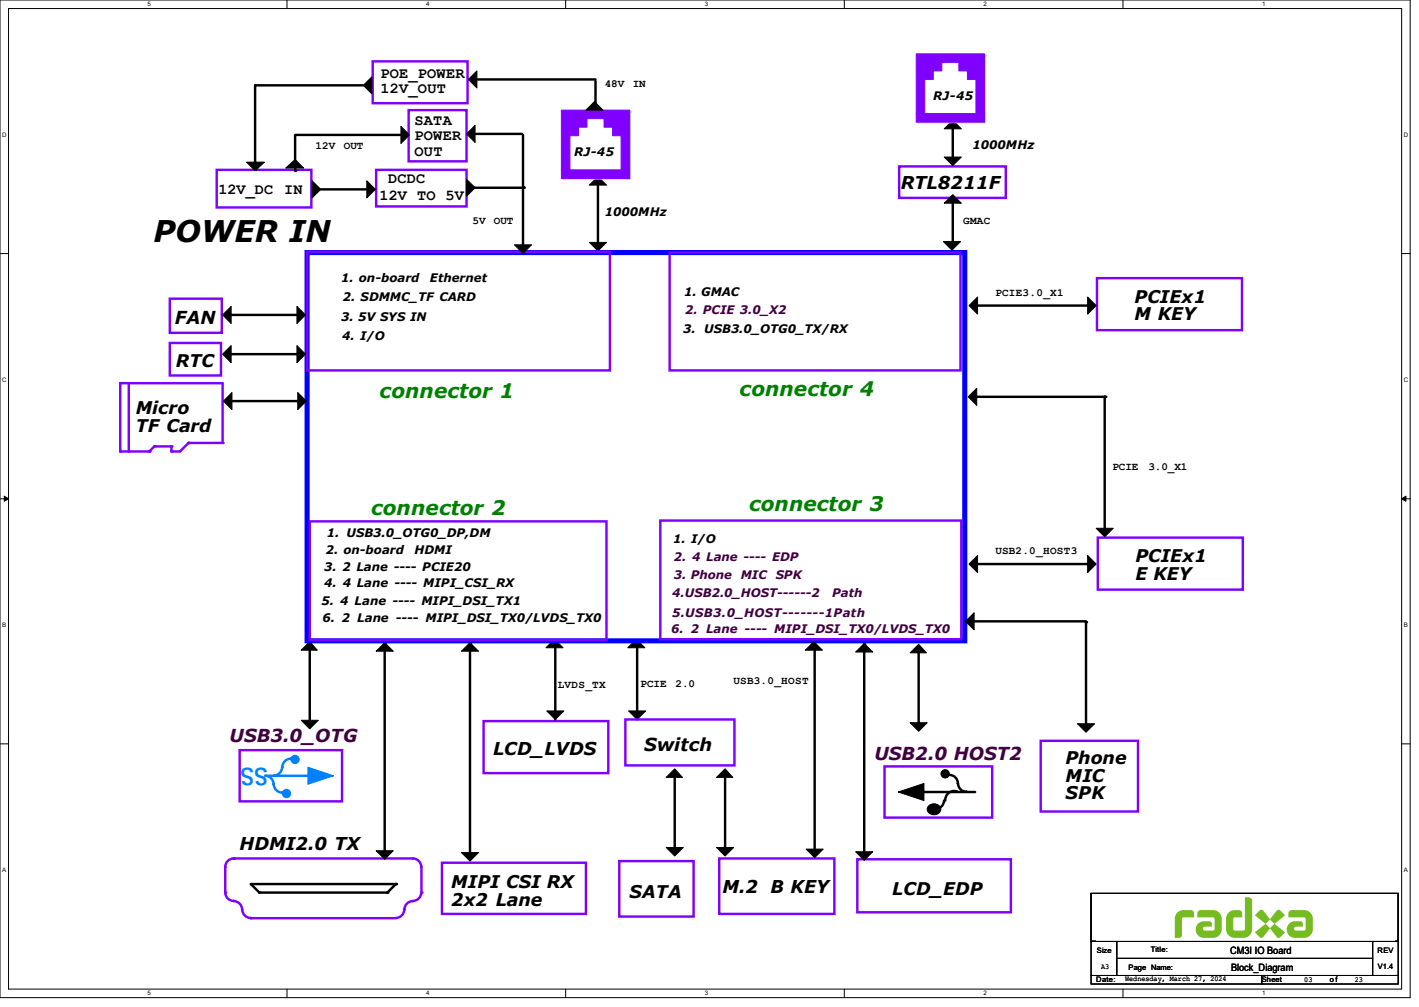
[picture p44: page 3]
HDMI2.0 TX; OUT; RTC; 4.USB2.0_HOST------2 Path; 1. I/O 2. 4 Lane ---- EDP; 6. 2 Lane ---- MIPI_DSI_TX0/LVDS_TX0; 5.USB3.0_HOST-------1Path; connector 3; 3. Phone MIC SPK; USB3.0_OTG; 1. USB3.0_OTG0_DP,DM; 4. 4 Lane ---- MIPI_CSI_RX; connector 1; 5. 4 Lane ---- MIPI_DSI_TX1 6. 2 Lane ---- MIPI_DSI_TX0/LVDS_TX0; 2. on-board HDMI; connector 2; 3. 2 Lane ---- PCIE20; Micro TF Card; DCDC; POWER IN; connector 4; LCD_LVDS; M.2 B KEY; LCD_EDP; PCIE 2.0; USB3.0_HOST LVDS_TX; USB2.0 HOST2; Phone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

1. on-board Ethernet
2. SDMMC_TF CARD
3. 5V SYS IN

MIPI CSI RX
2x2 Lane

RS232

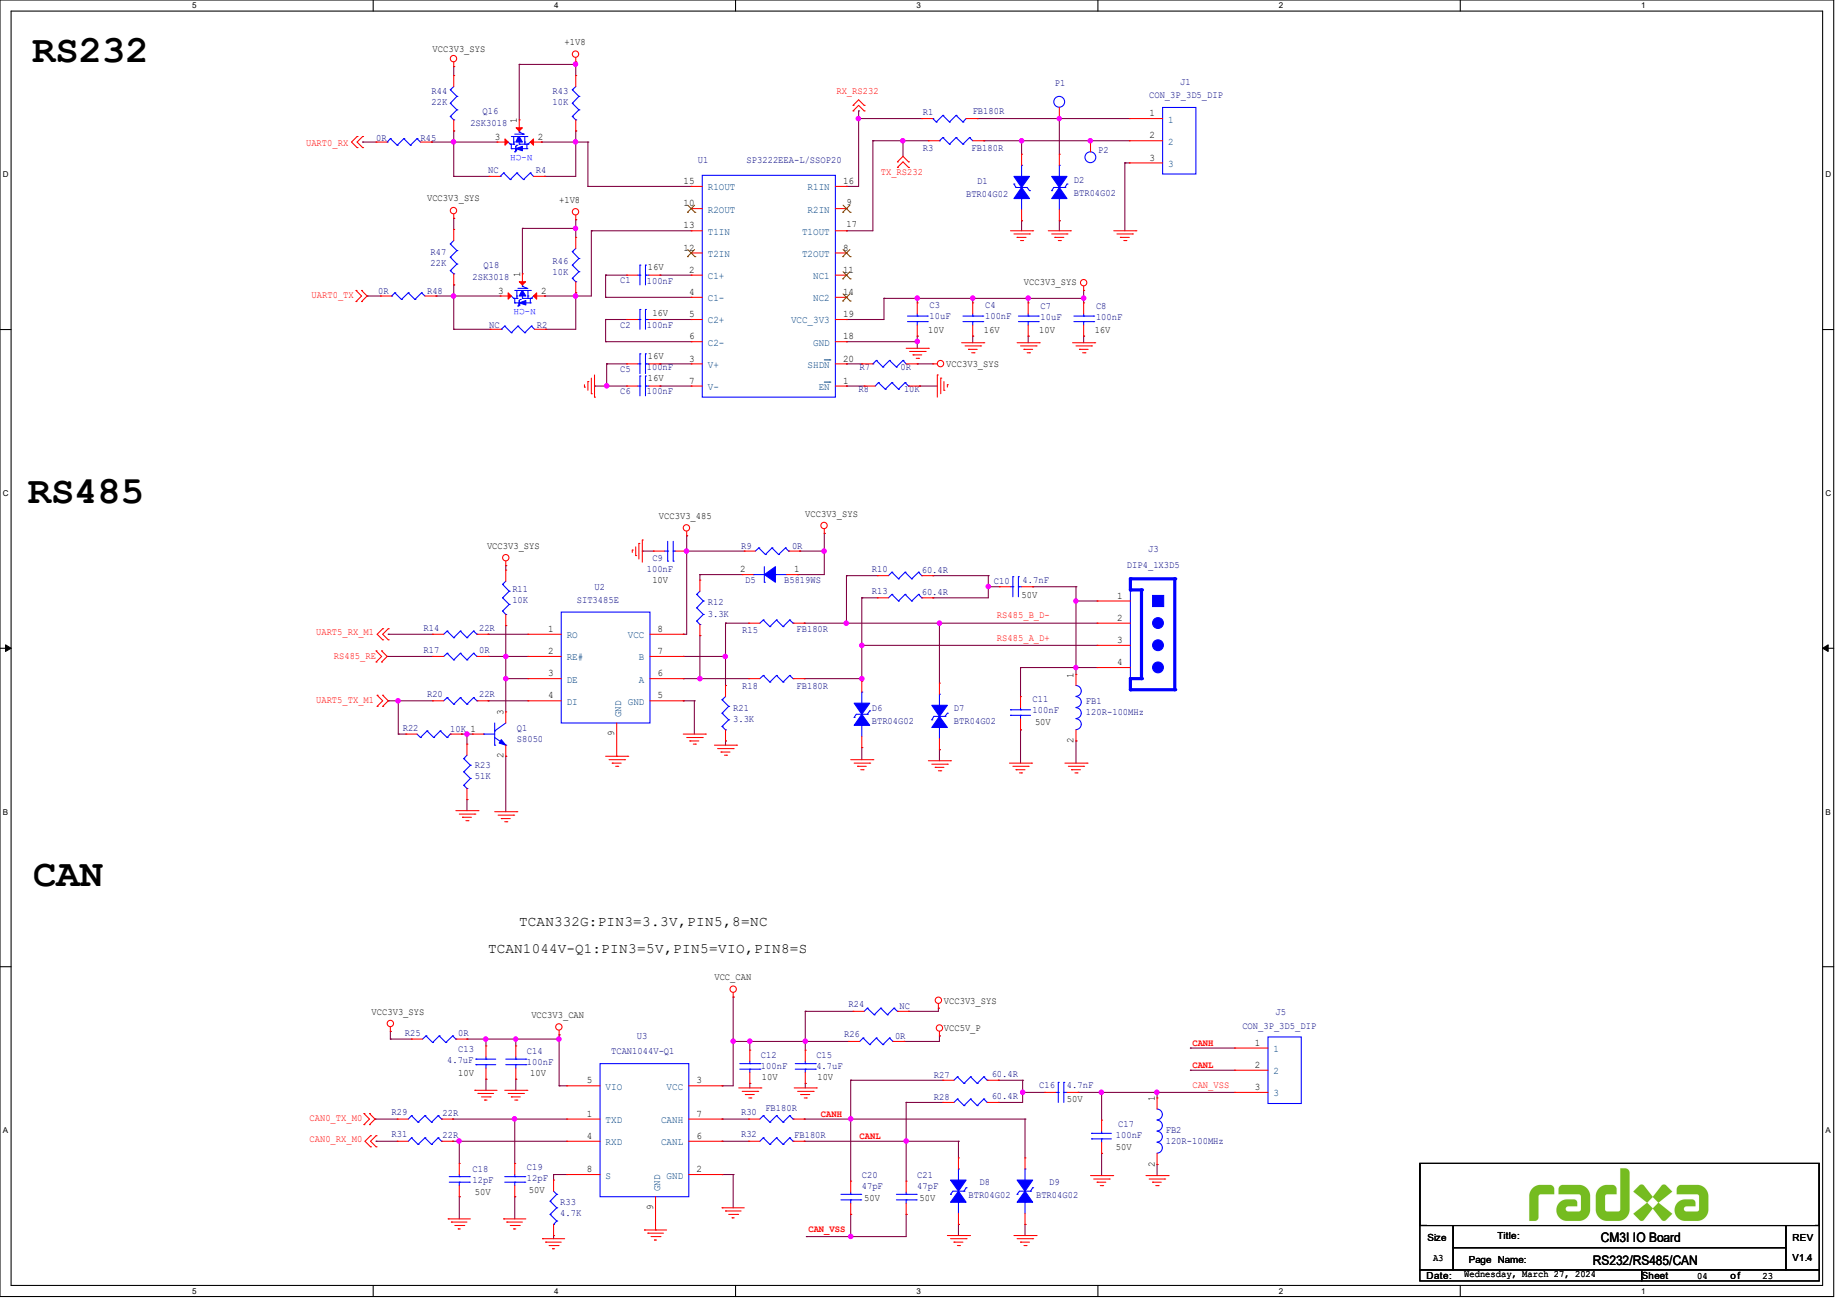
[picture p45: page 4]

# KEY B

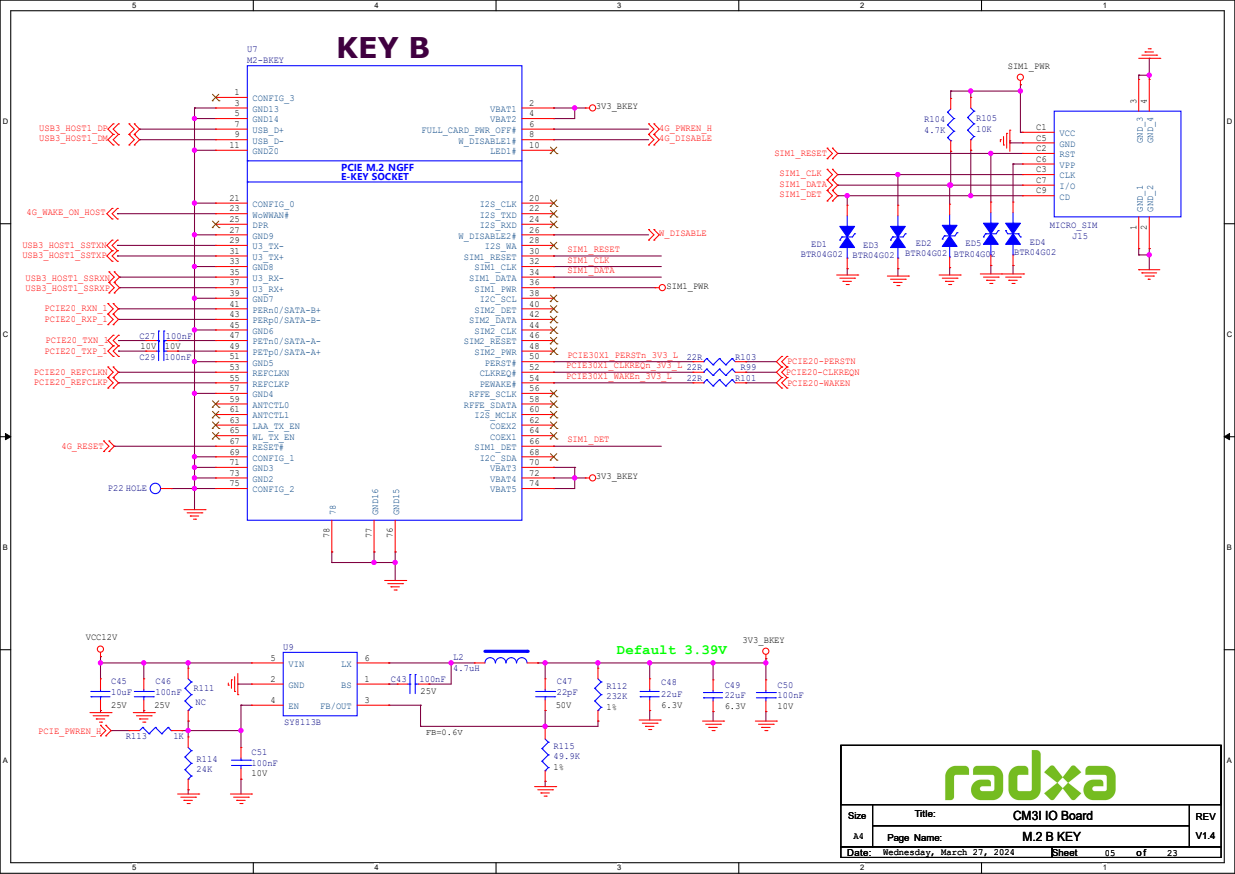
[picture p46: page 5]

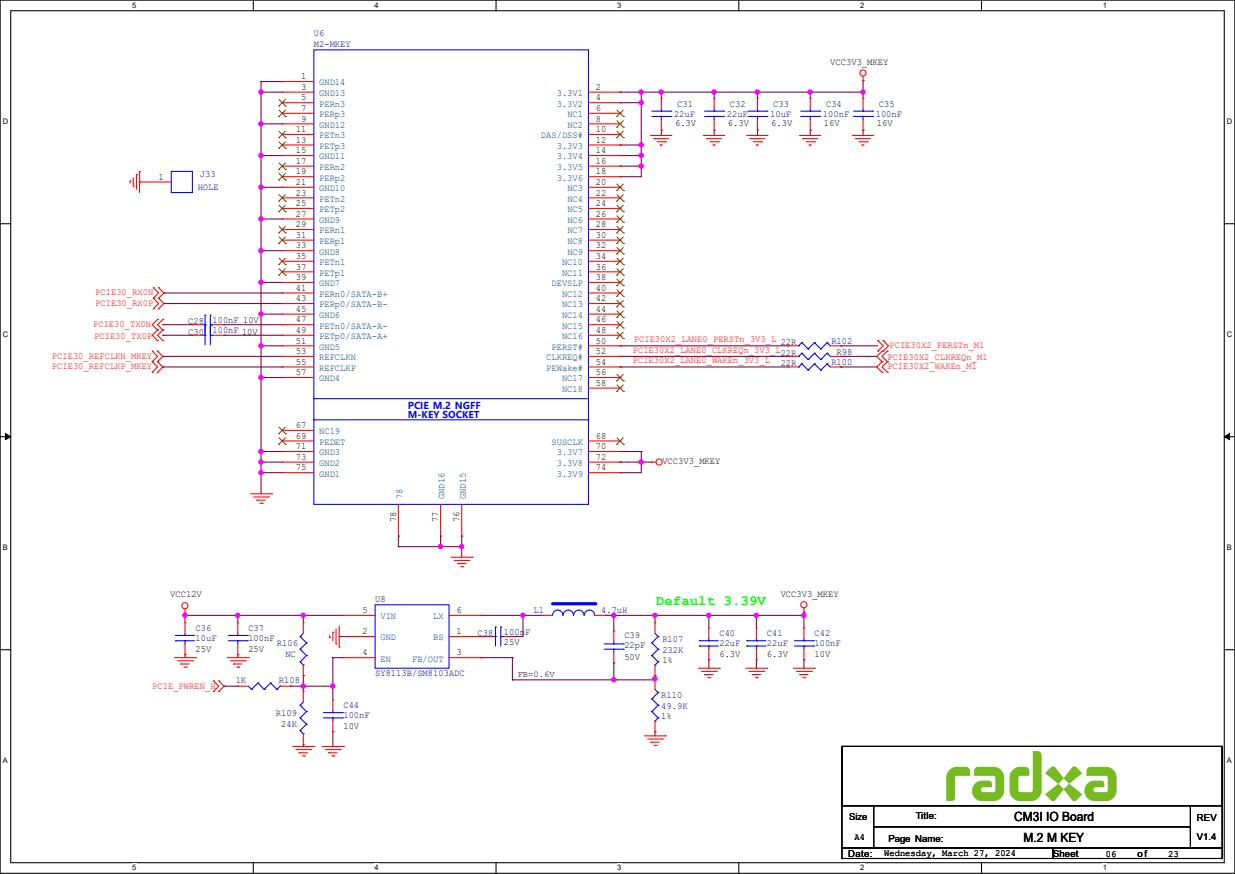
[picture p47: page 6]

# E KEY

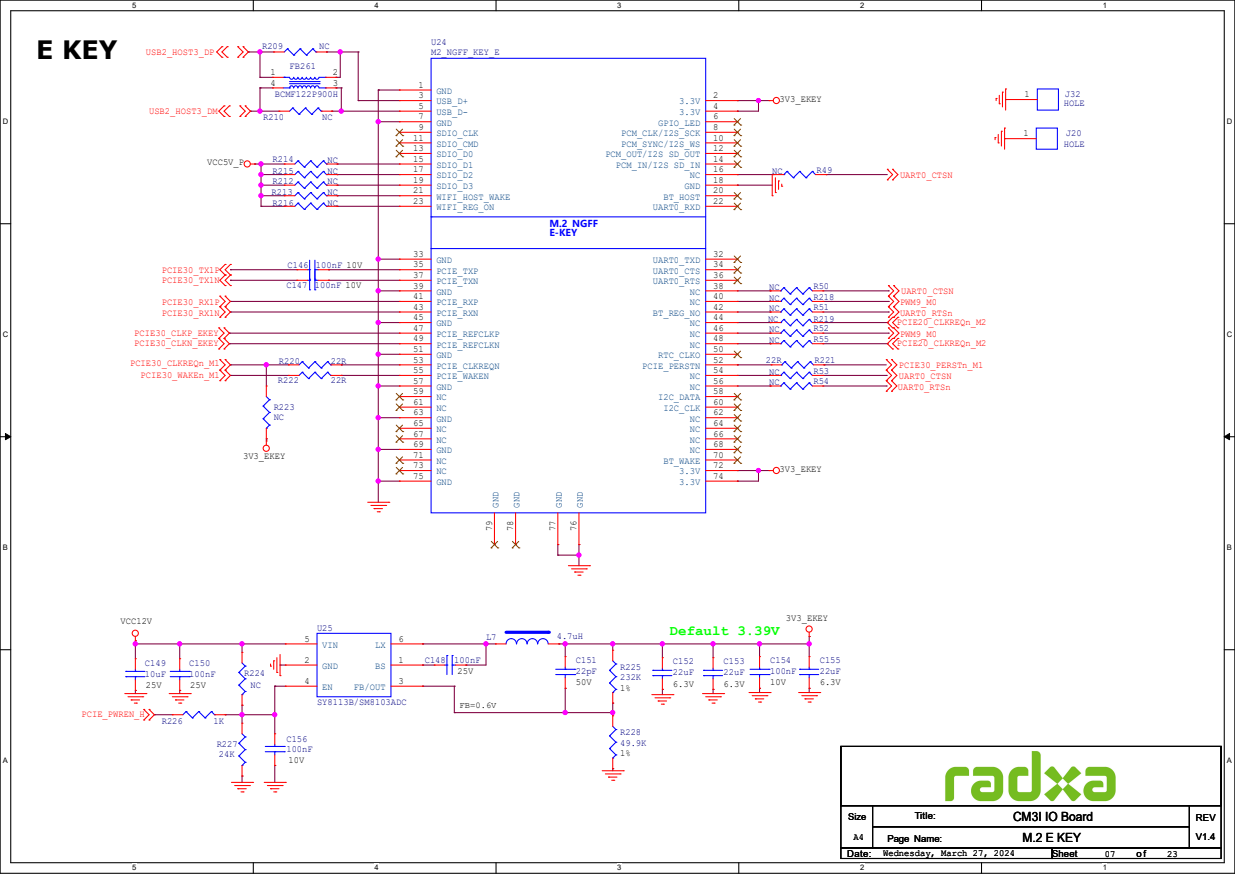
[picture p48: page 7]

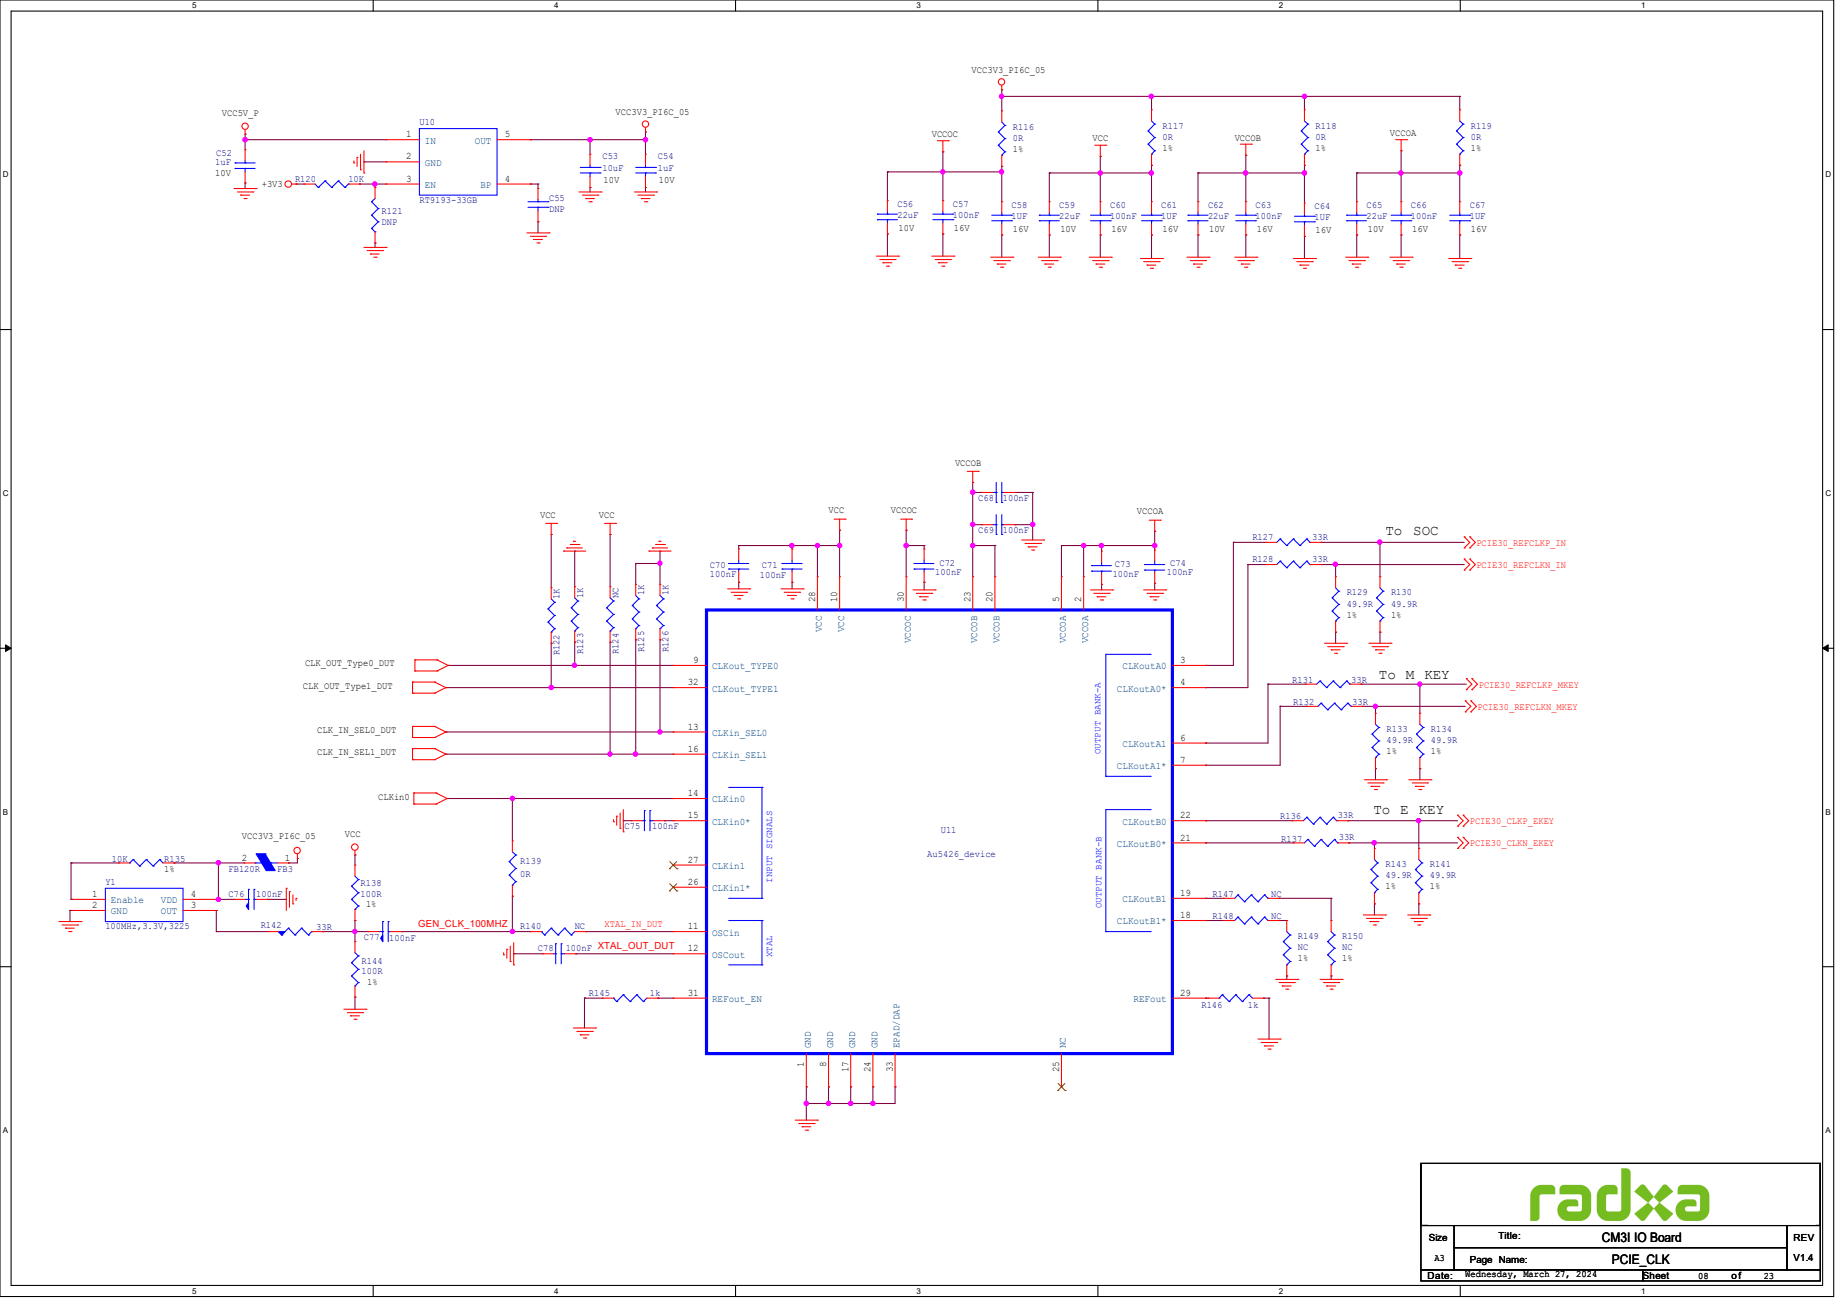
[picture p49: page 8]

# SATA3.0

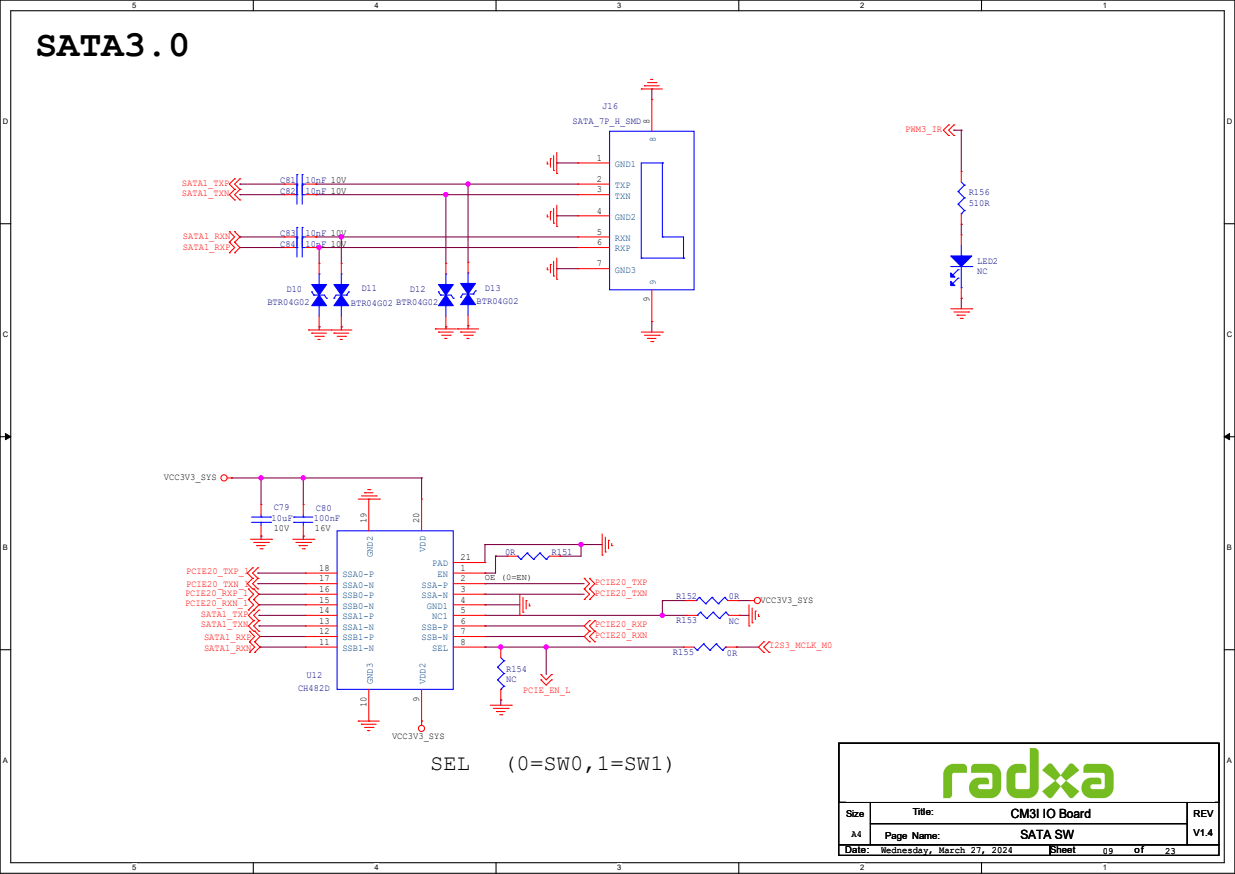
[picture p50: page 9]

MIPI_CSI_RX 2Lanes | MIPI_CSI_RX 2Lanes

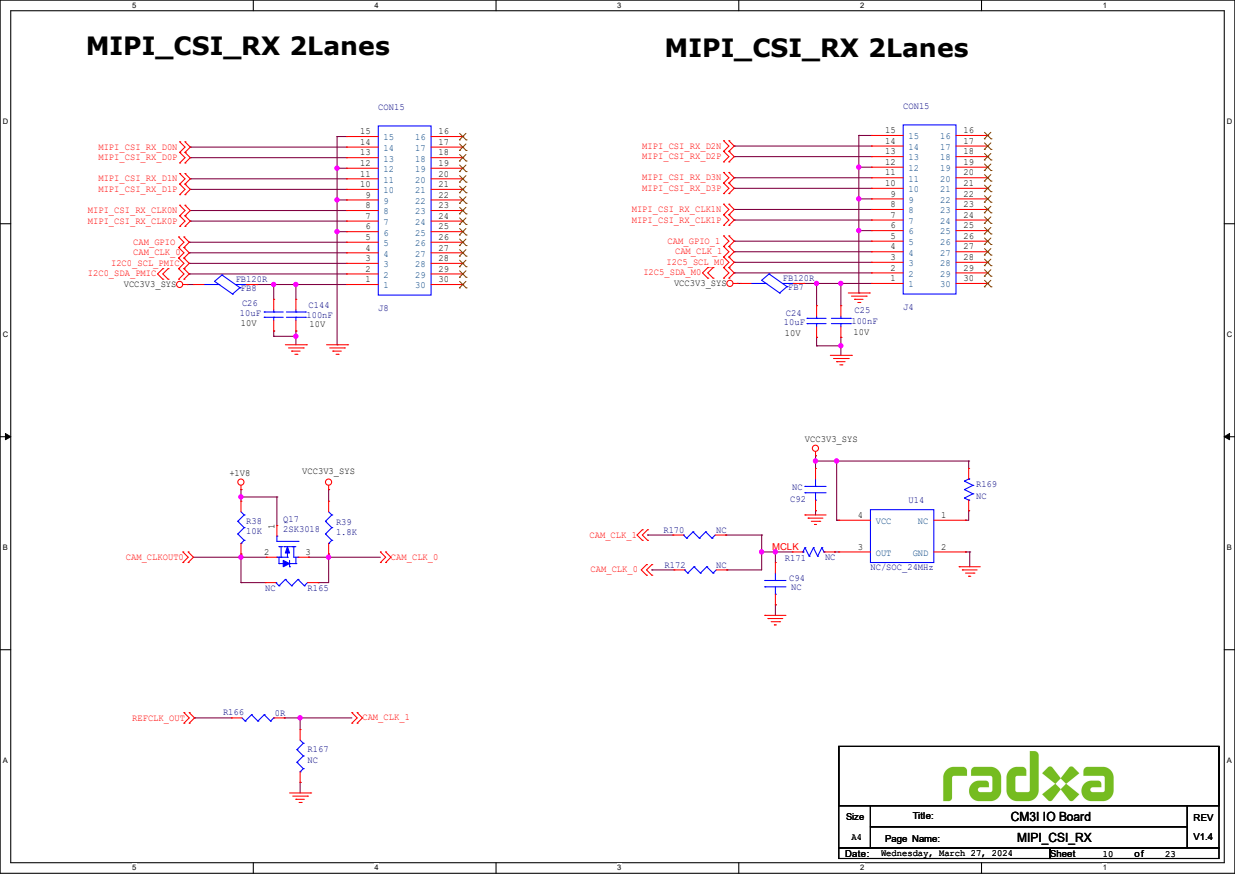
[picture p51: page 10]

# EDP40PIN EDP30PIN

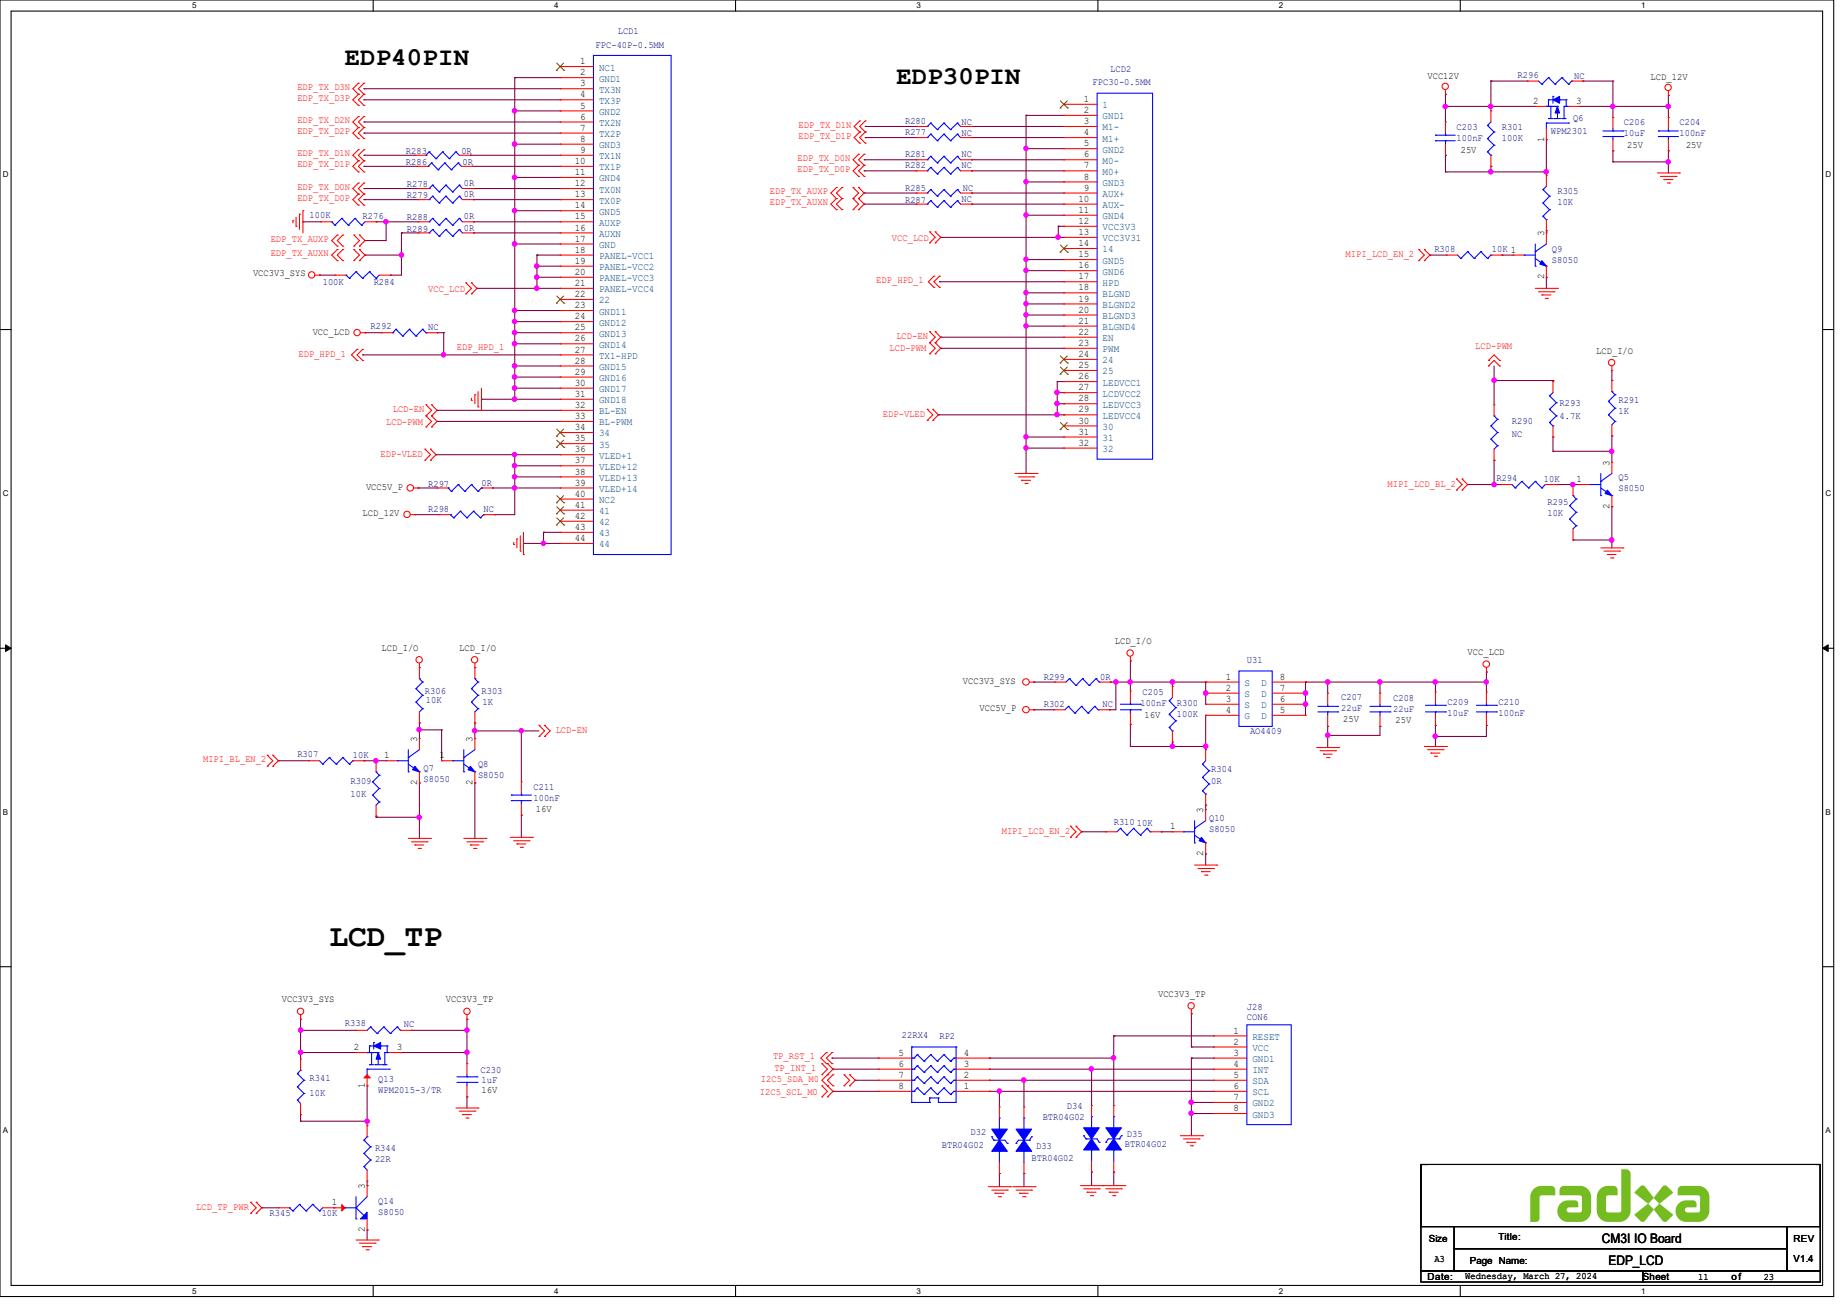
[picture p52: page 11]

# MIPI_LCD_TX0

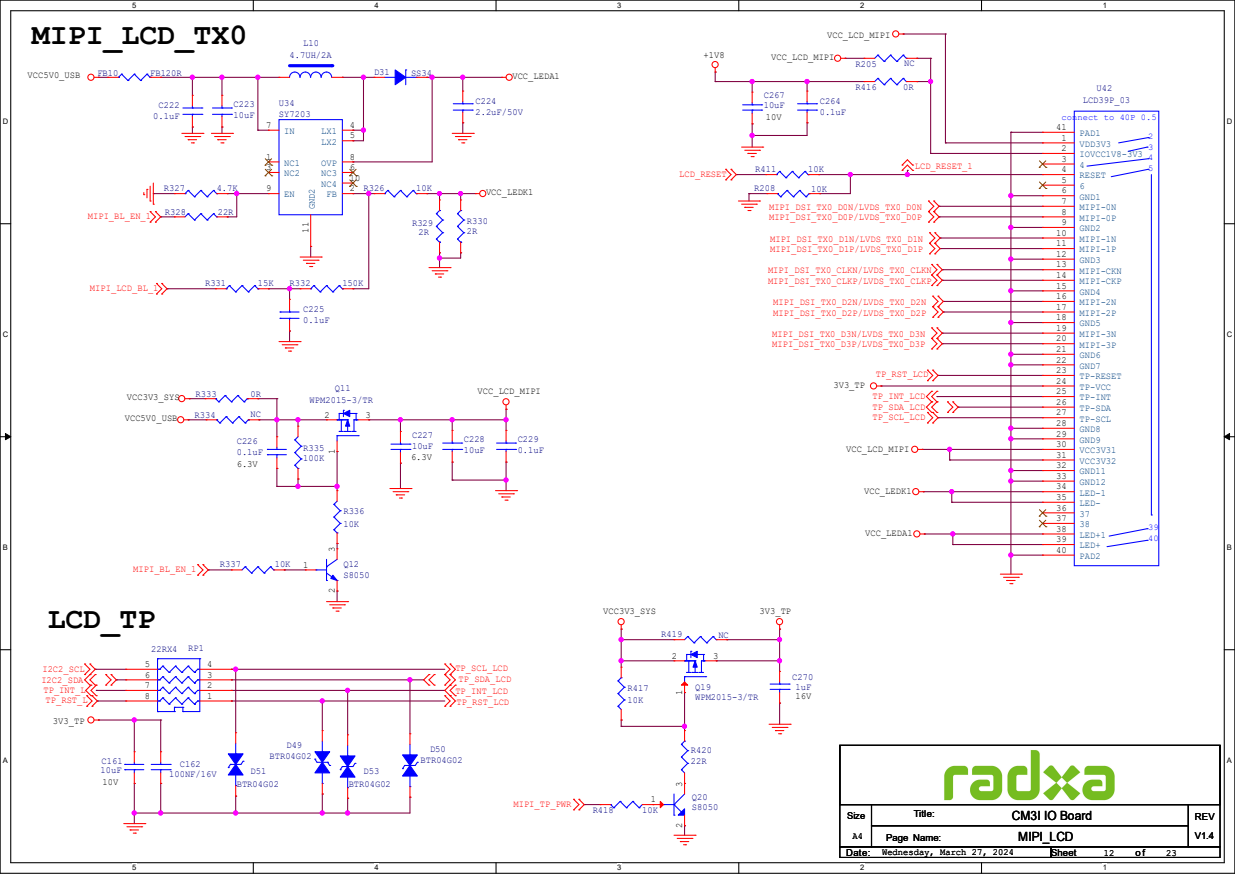
[picture p53: page 12]

HDMI2.0 TX | Cj<=0.4pF
19 20 | 21 23 | 22

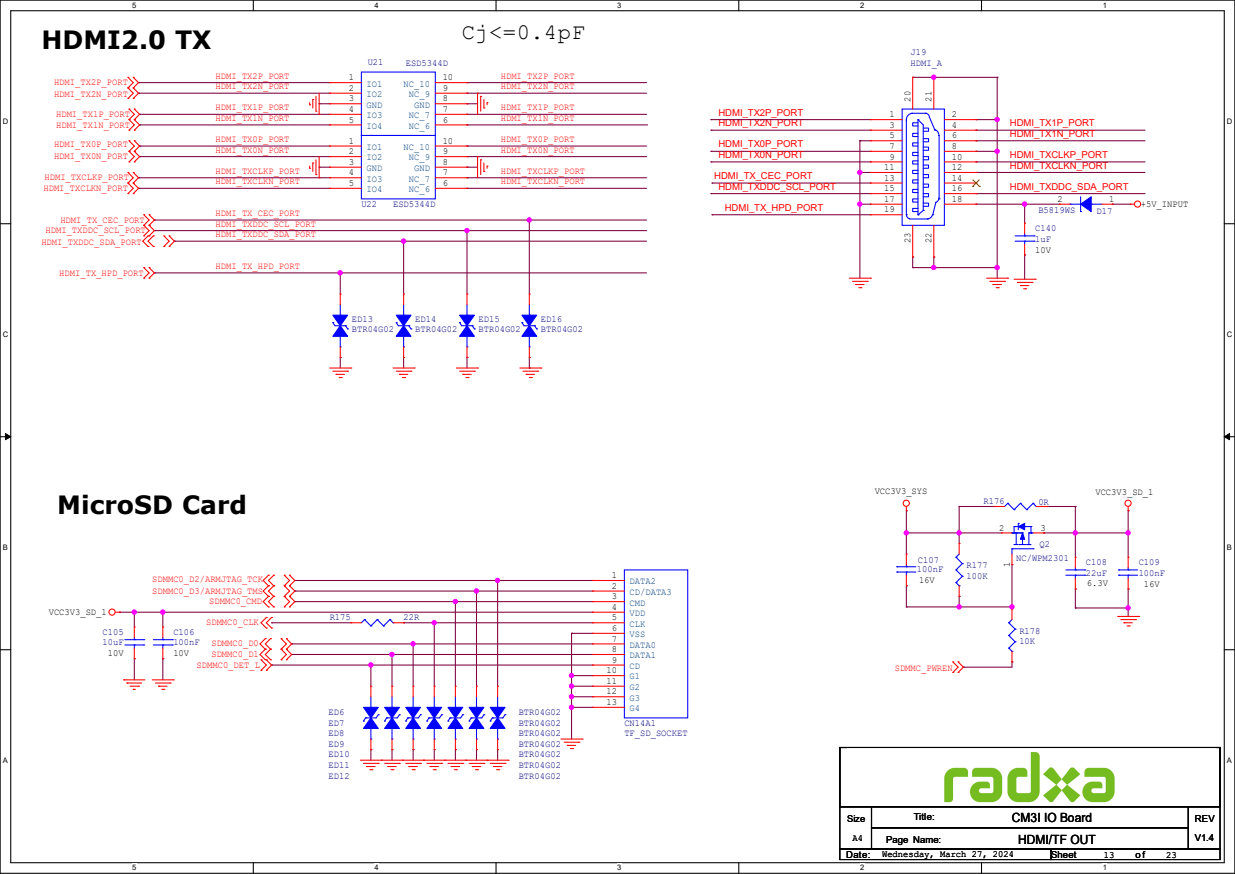
[picture p54: page 13]

# USB

# 9 SHELL1 10 SHELL2 11

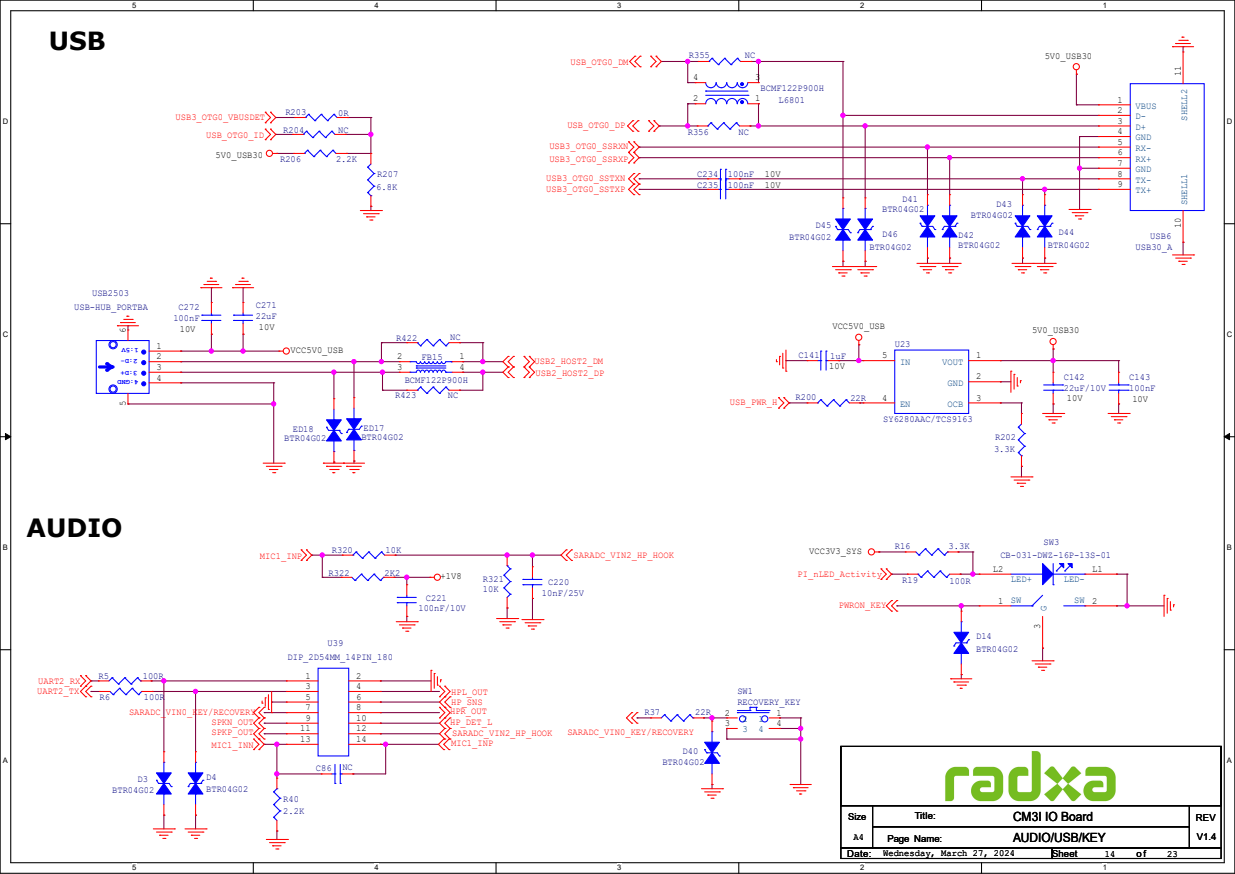
[picture p55: page 14]

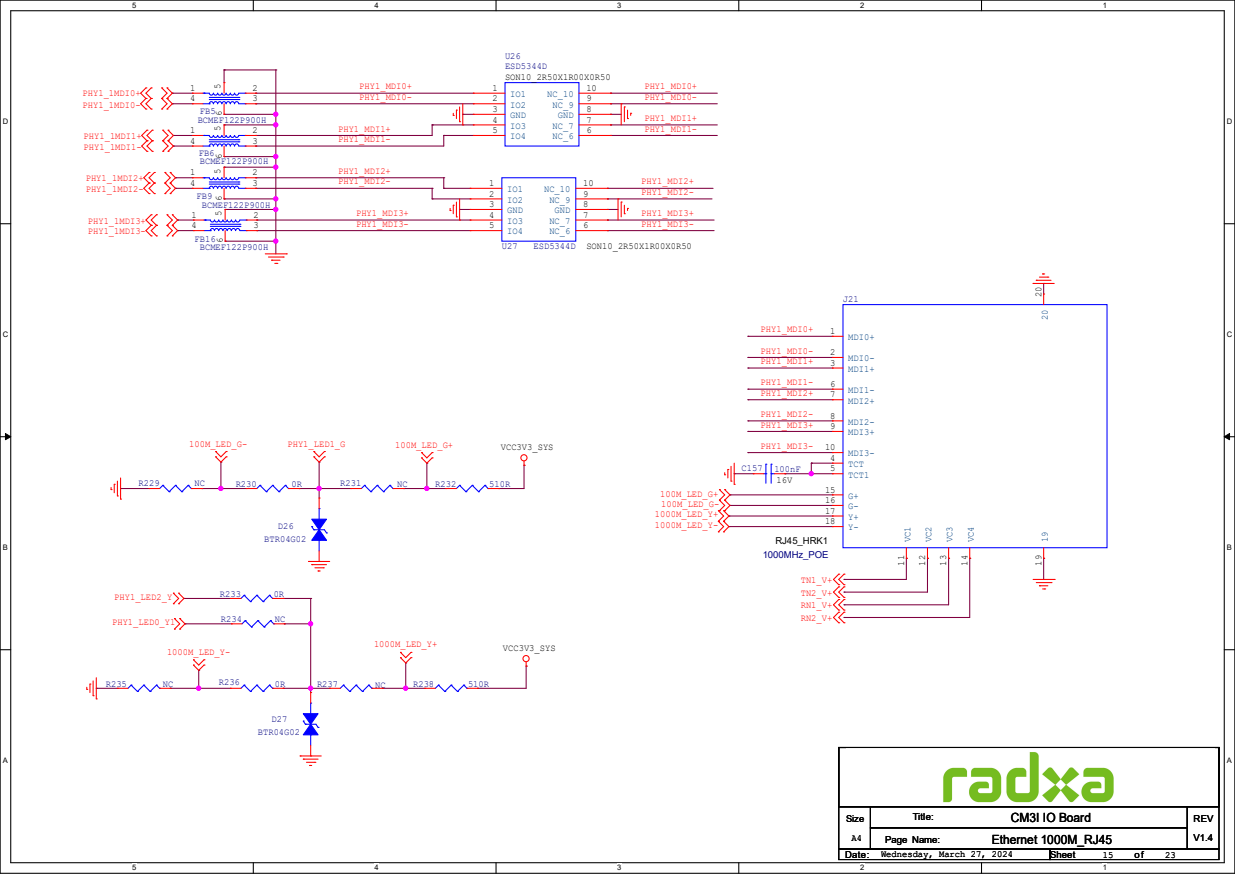
[picture p56: page 15]

# Giga PHY0

# PHY1_XTALIN PHY1_XTALIN

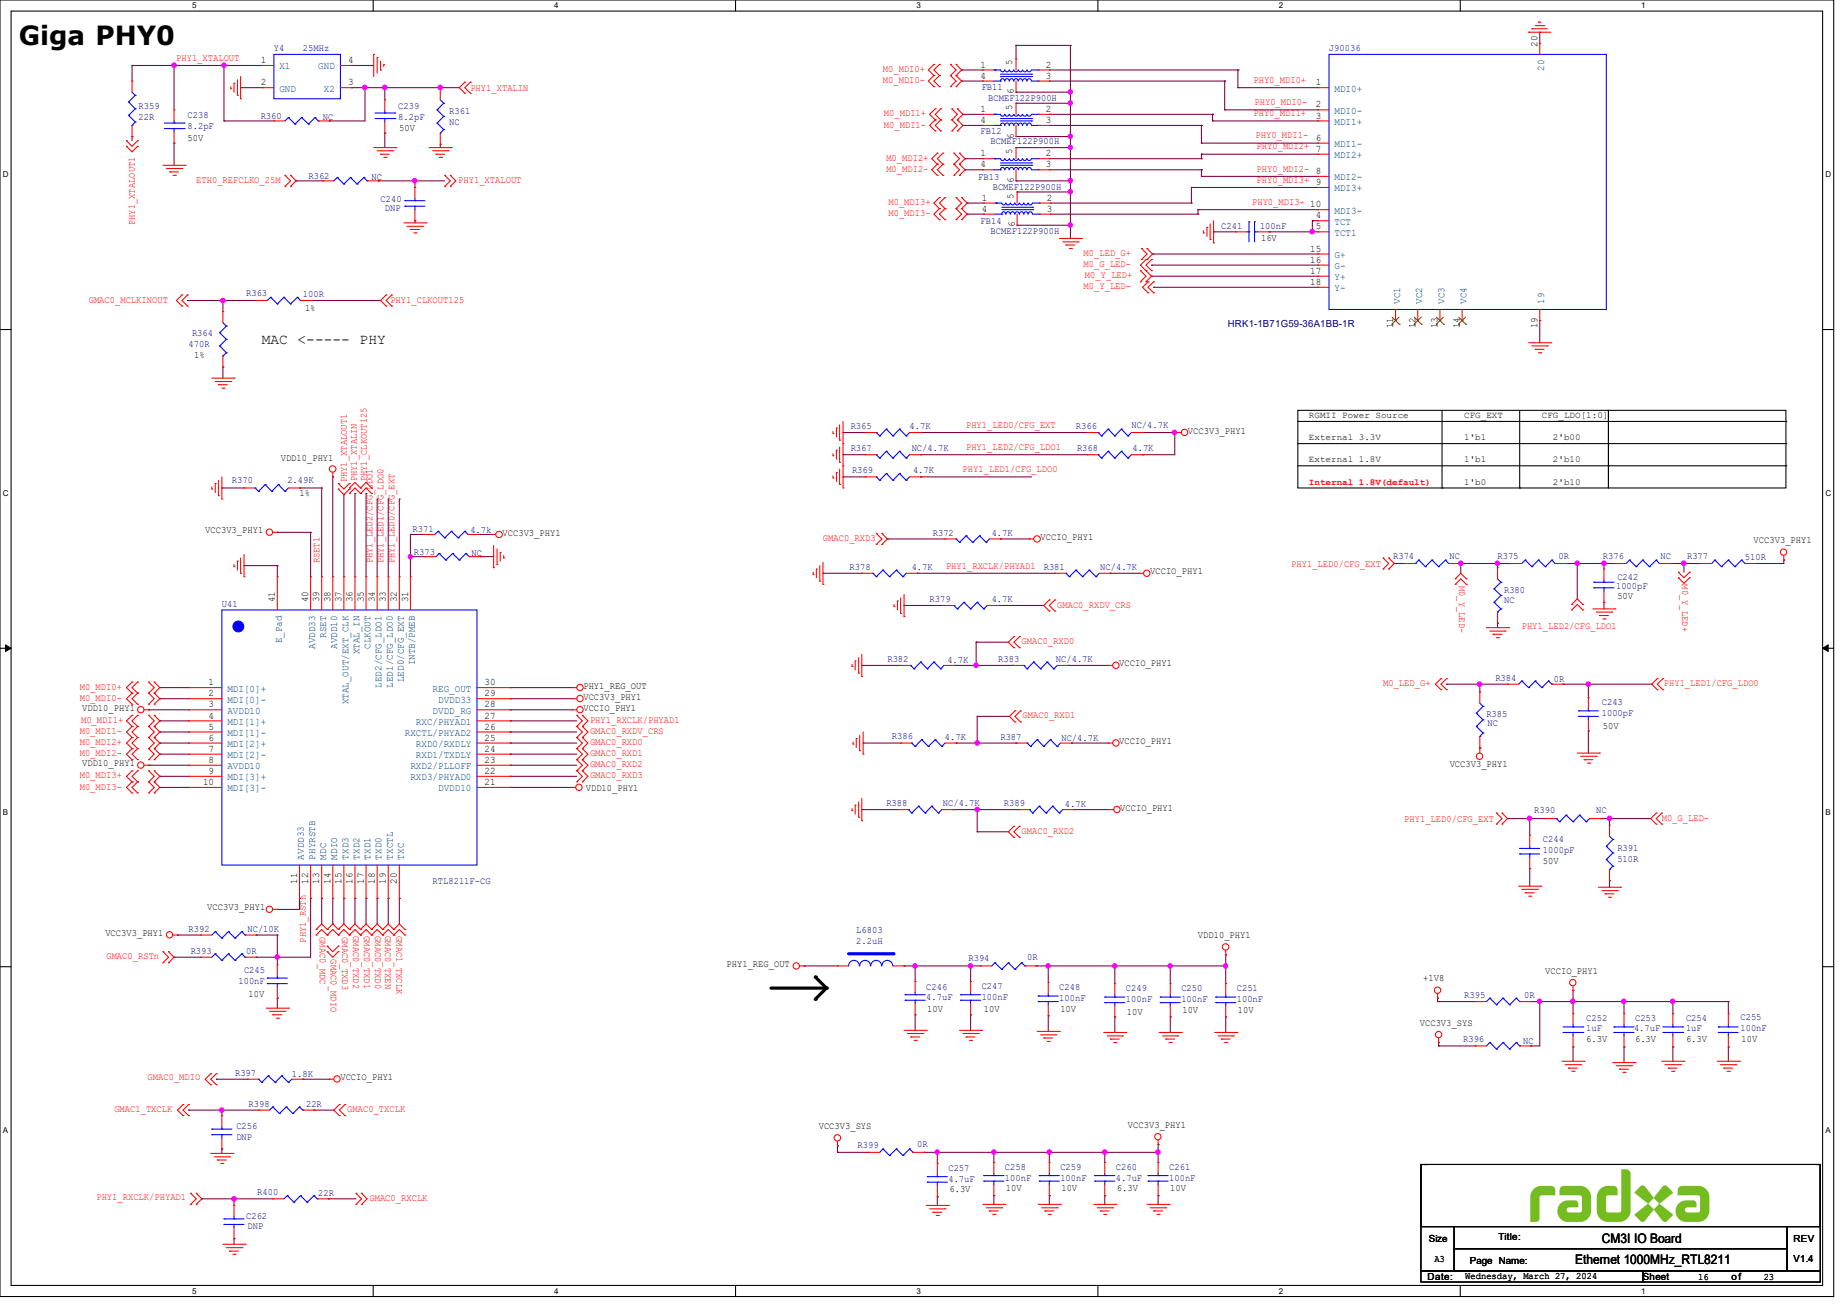
[picture p57: page 16]

30 INTB/PMEB 31 LED0/CFG_EXT 32 LED1/CFG_LDO0 33 LED2/CFG_LDO1 34 CLKOUT 35 XTAL_IN 36 XTAL_OUT/EXT_CLK 37 AVDD10 38 RSET 39 AVDD33 40 E_Pad 41

DVDD10 21 RXD3/PHYAD0 22 RXD2/PLLOFF 23 RXD1/TXDLY 24 RXD0/RXDLY 25 RXCTL/PHYAD2 26 RXC/PHYAD1 27 DVDD_RG

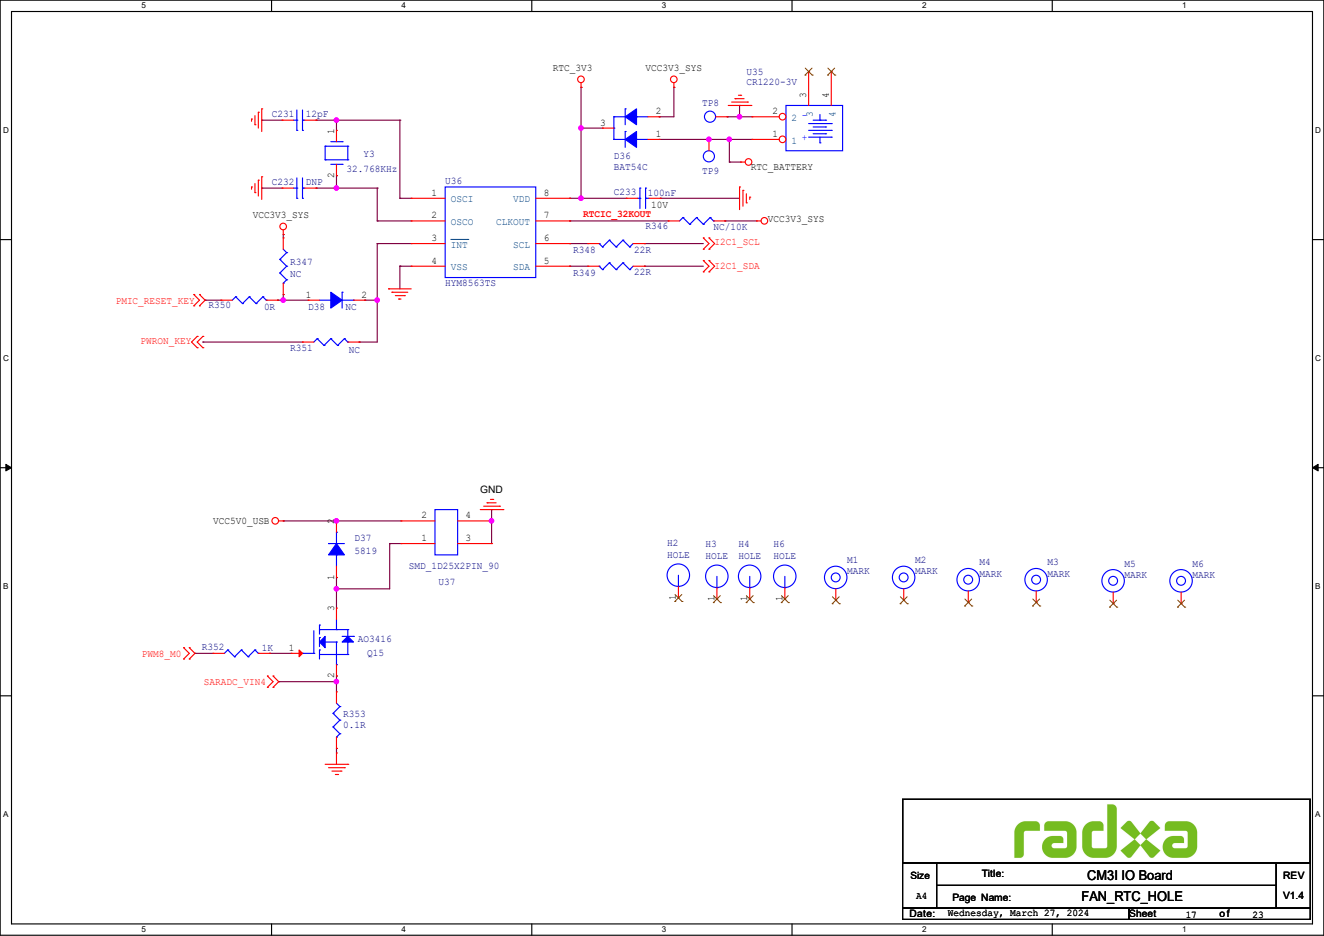
[picture p58: page 17]

# SYS Power

# 1 PG

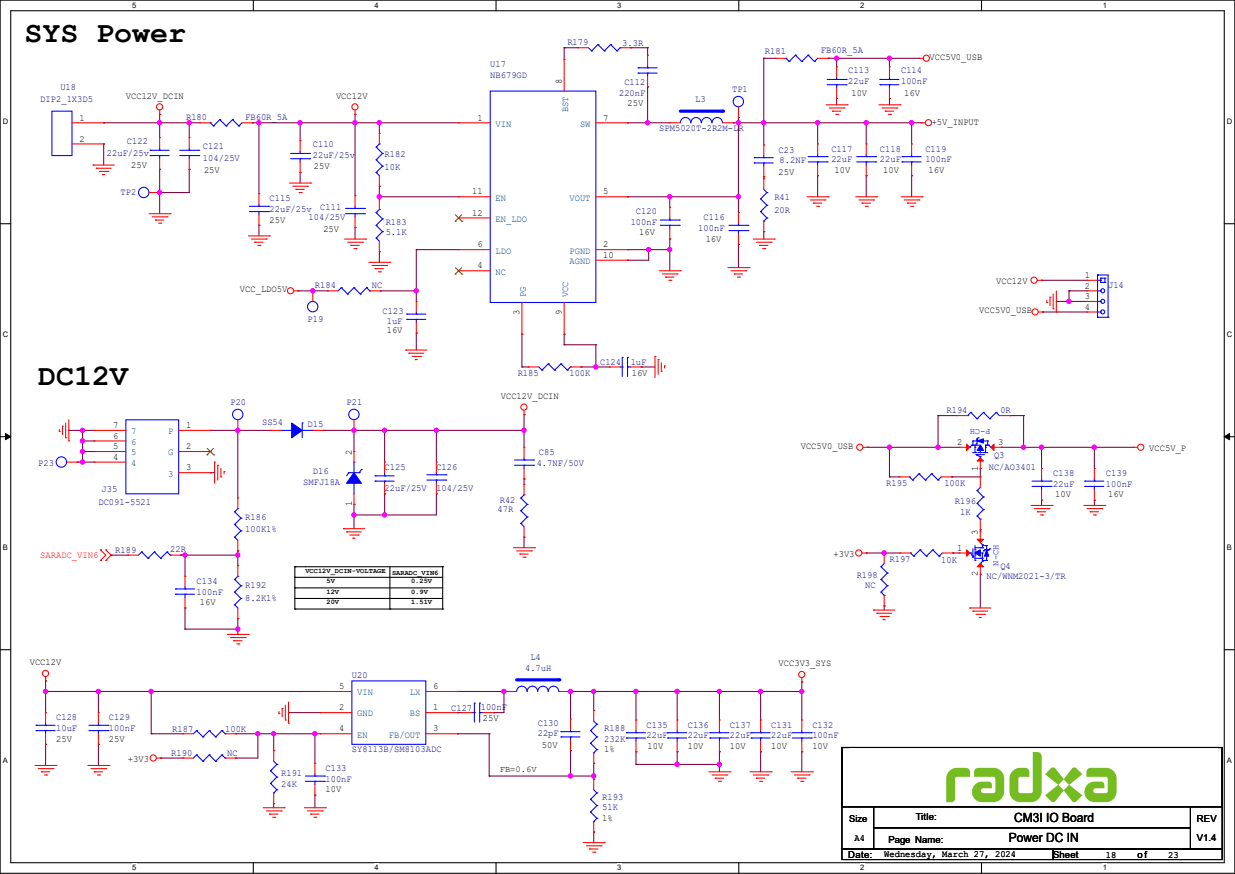
[picture p59: page 18]

SARADC_VIN6 VCC12V_DCIN-VOLTAGE
5V | 0.25V
12V | 0.9V
20V | 1.51V

## D28SMBJ58A

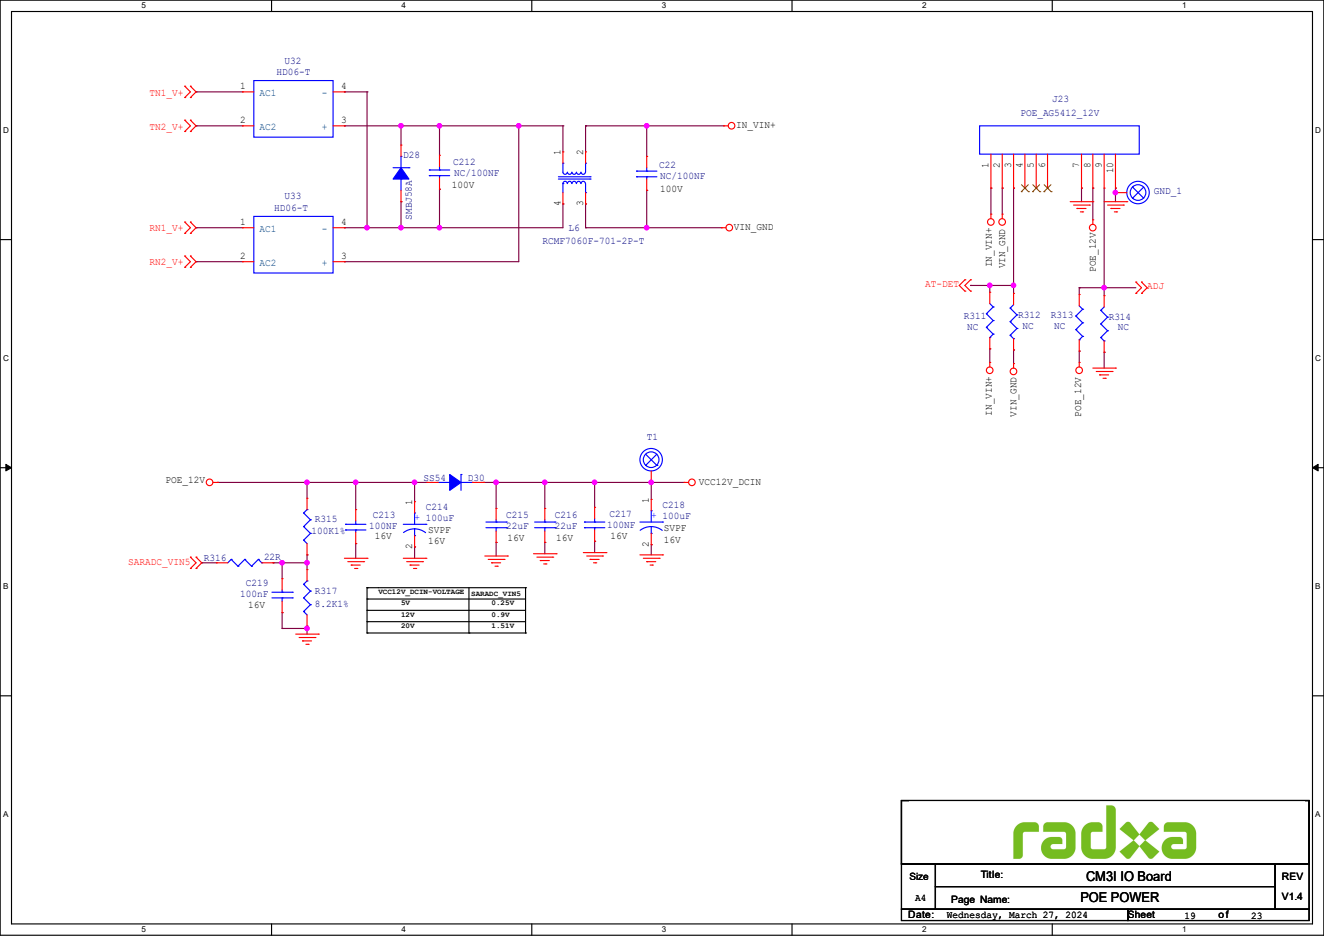
[picture p60: page 19]

SARADC_VIN5 VCC12V_DCIN-VOLTAGE
5V | 0.25V
12V | 0.9V
20V | 1.51V

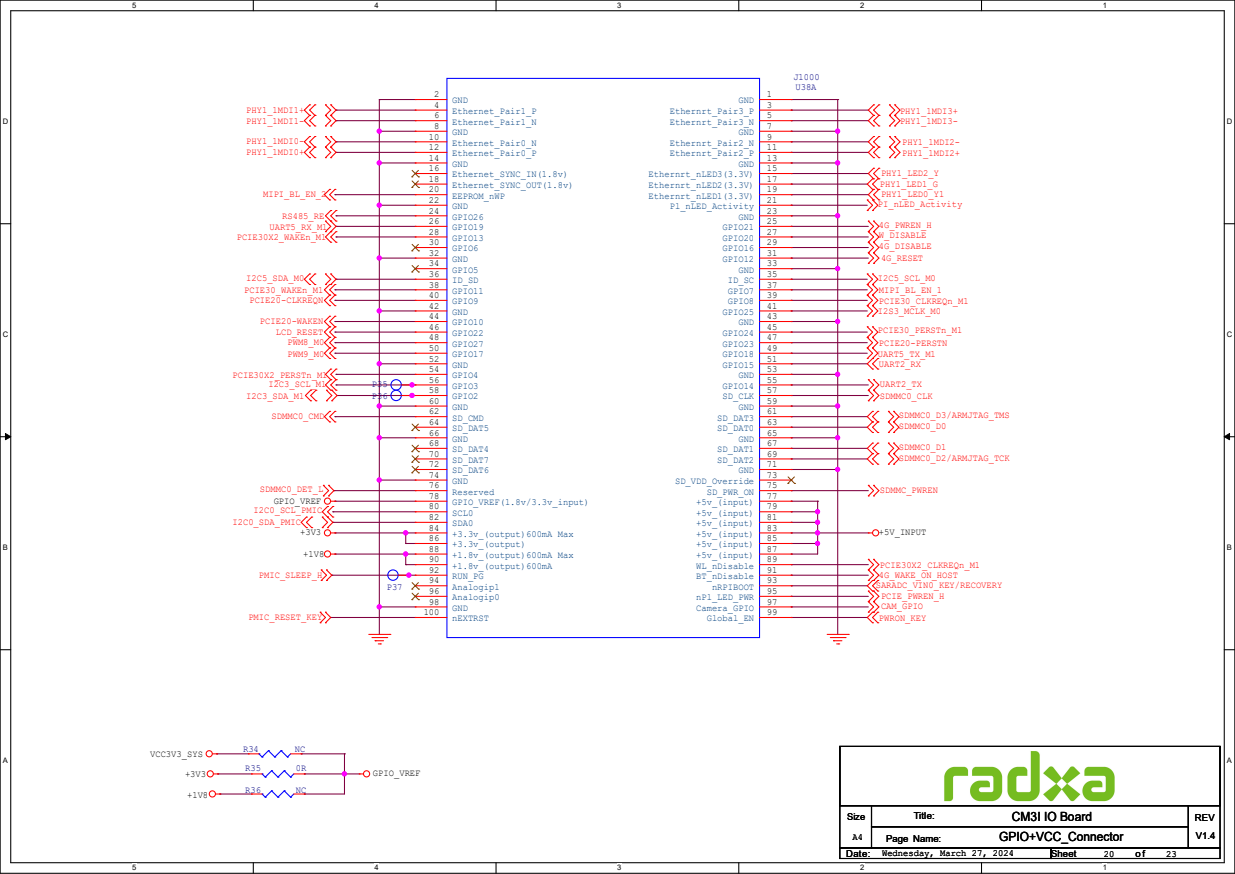
[picture p61: page 20]

102 | HOLE 201 | HOLE 202 | HOLE 203 | HOLE 204

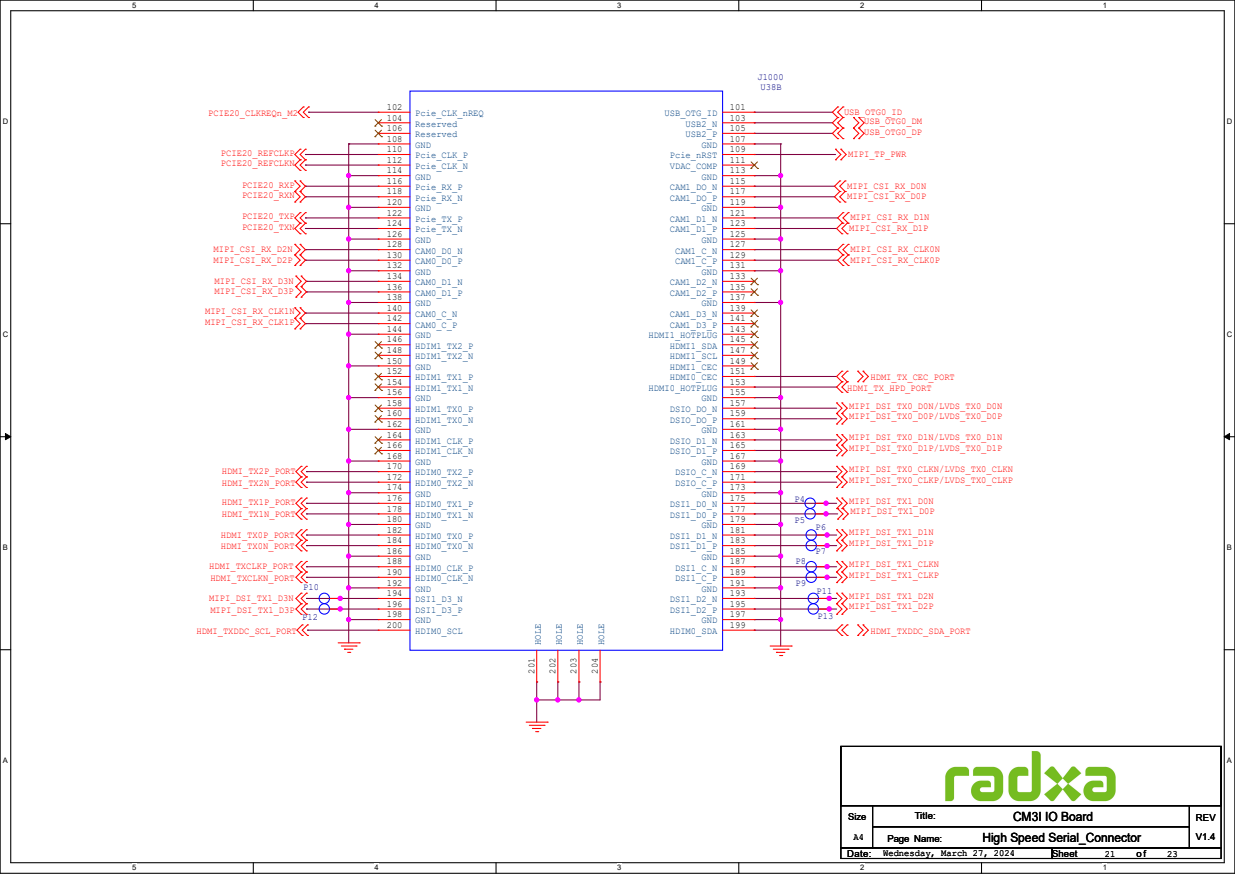
[picture p62: page 21]

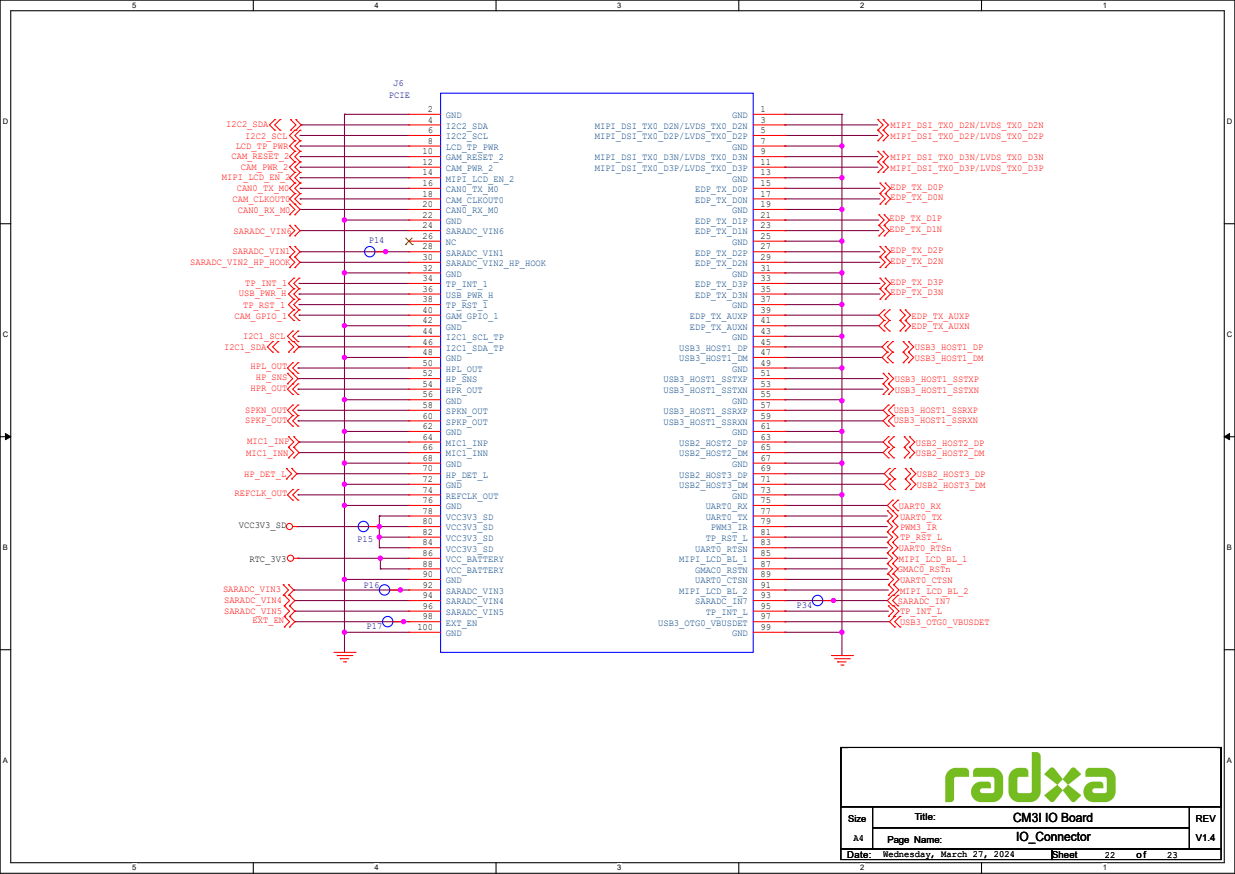
[picture p63: page 22]
RTC_3V3; VCC3V3_SD; MIPI_DSI_TX0_D2P/LVDS_TX0_D2P; MIPI_DSI_TX0_D2N/LVDS_TX0_D2N; MIPI_DSI_TX0_D3P/LVDS_TX0_D3P; MIPI_DSI_TX0_D3N/LVDS_TX0_D3N; USB3_HOST1_DP; USB3_HOST1_SSTXP USB3_HOST1_SSTXN; USB3_HOST1_DM; USB3_HOST1_SSRXP USB3_HOST1_SSRXN; USB2_HOST2_DP USB2_HOST2_DM; USB2_HOST3_DP USB2_HOST3_DM; EDP_TX_D0P EDP_TX_D0N; EDP_TX_D1P EDP_TX_D1N; EDP_TX_D2P EDP_TX_D2N; EDP_TX_D3P EDP_TX_D3N; EDP_TX_AUXP EDP_TX_AUXN; SARADC_VIN2_HP_HOOK; HPL_OUT HP_SNS HPR_OUT; SPKN_OUT SPKP_OUT; MIC1_INN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

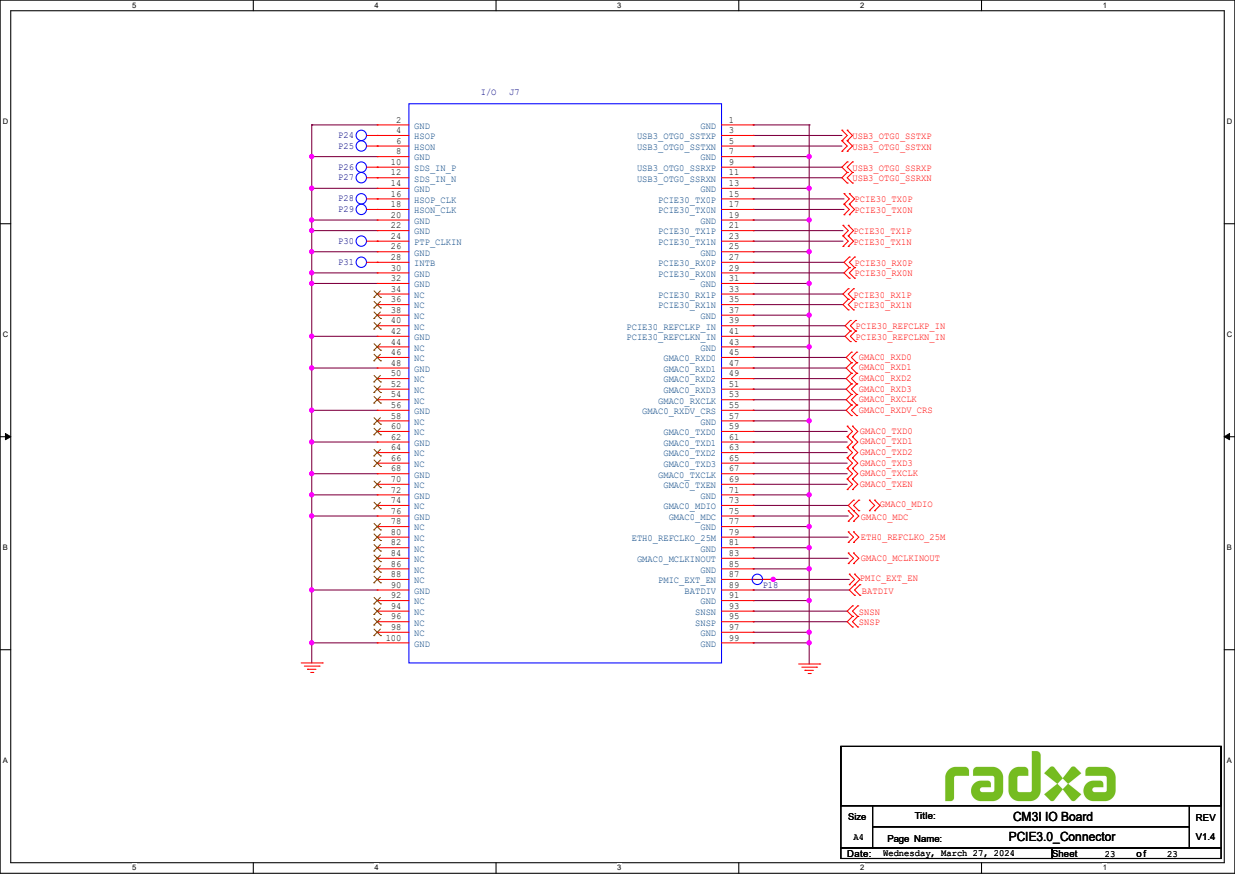
[picture p64: page 23]
