radxa/radxa-cm-projects/cm5/radxa-cm5-io-board/radxa_cm5_io_board_v2200_schematic.pdf

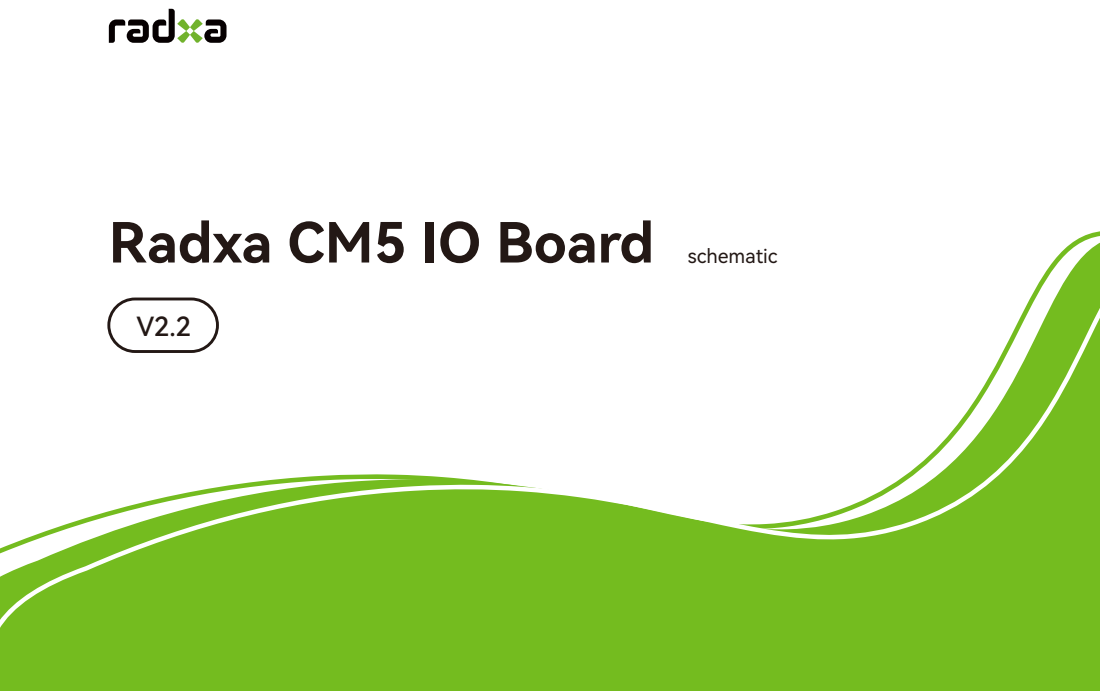
[picture p65: page 1]
schematic

Radxa CM5 IO Board

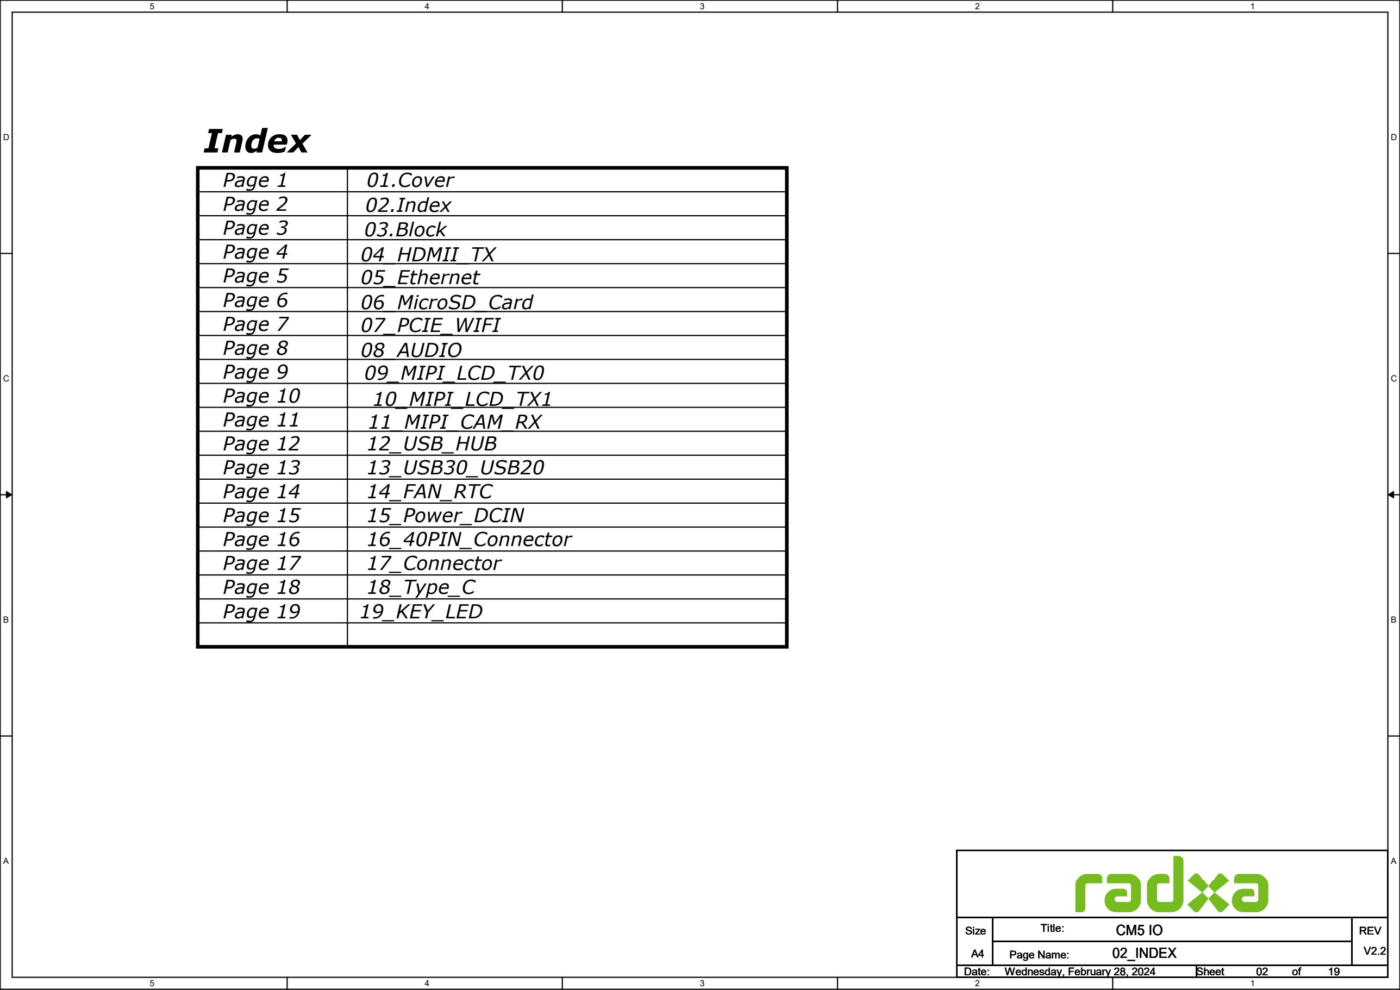
[picture p66: figure]
CIE_; WIFI; MIPI_; MII_; CIN; PIN_; Typ; Siz; Title

# Block Diagram

## DCDC

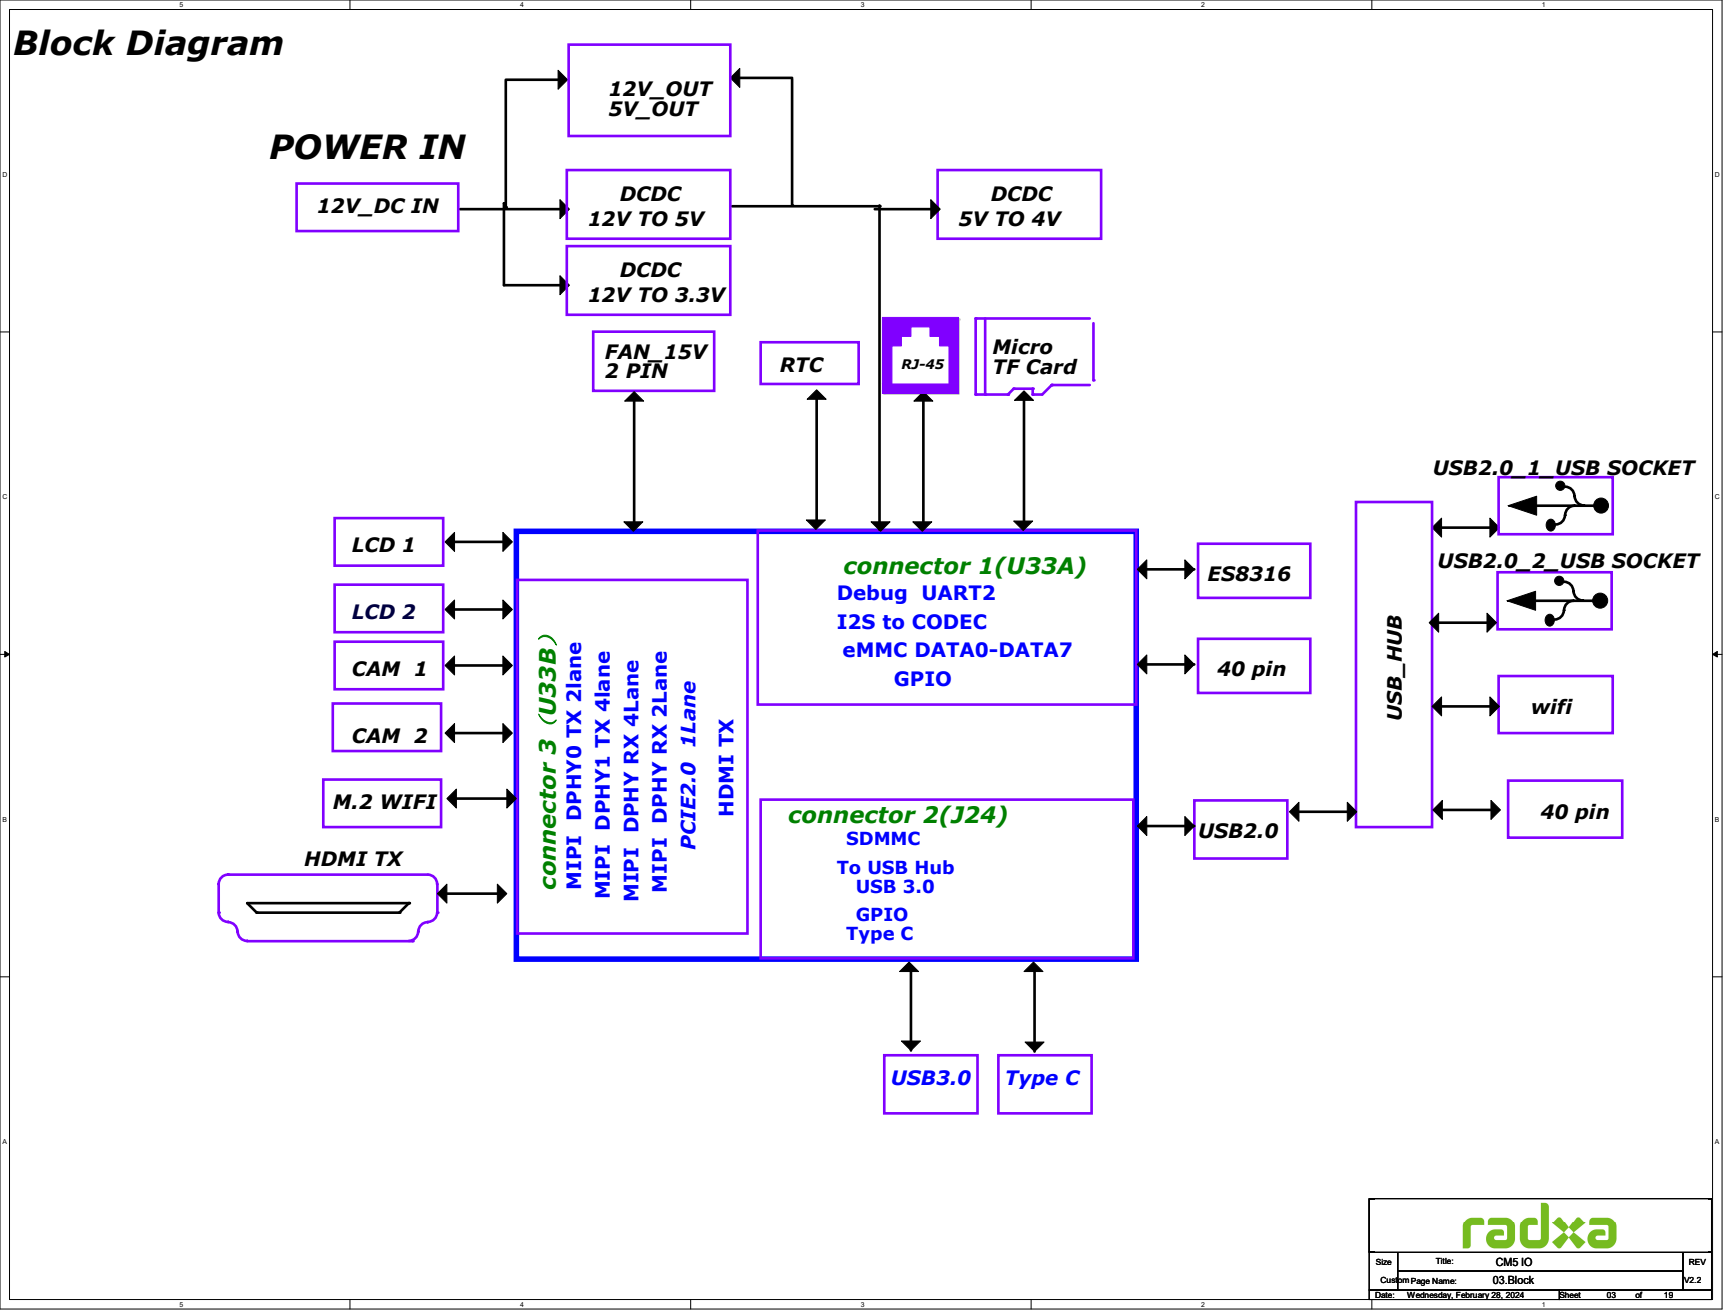
[picture p67: page 3]
M.2 WIFI; connector 1(U33A); LCD 1; USB2.0_1_USB SOCKET; HDMI TX; POWER IN; wifi; connector 2(J24); CAM 1; RTC; USB2.0; FAN_15V 2 PIN; USB2.0_2_USB SOCKET; CAM 2; 12V_OUT 5V_OUT; 40 pin; LCD 2; CIE2.0; MIPI D; eMMC DATA0-DATA7; Debug UART2 I2S to CODEC; GPIO; Type C; USB 3.0 GPIO; To USB Hub; SDMMC; USB3.0; DCDC; Micro; TF Card; Size; REV; Date:; Sheet; Title:; Page Name:; 03.Block; Custom; Wednesday, February 28, 2024

# HDMI TX

HDMI0_TX1P_PORT | HDMI0_TX1P_PORT | HDMI0_TX1P_PORT_C

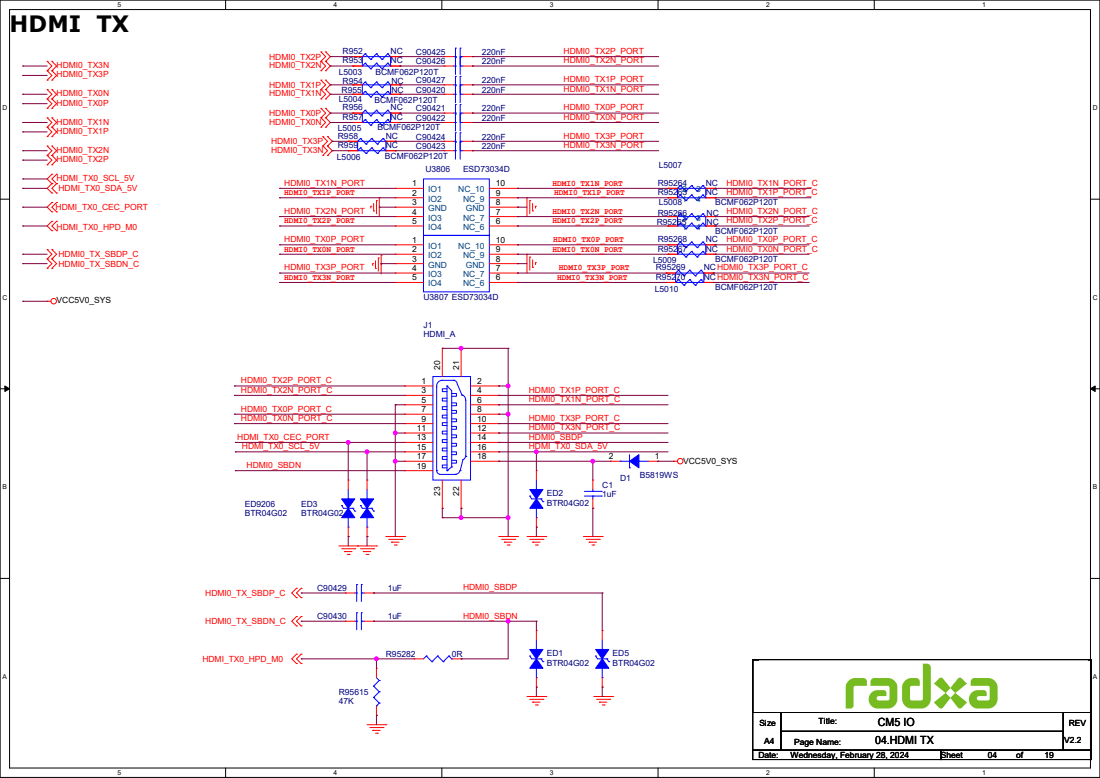
[picture p68: page 4]

RJ45

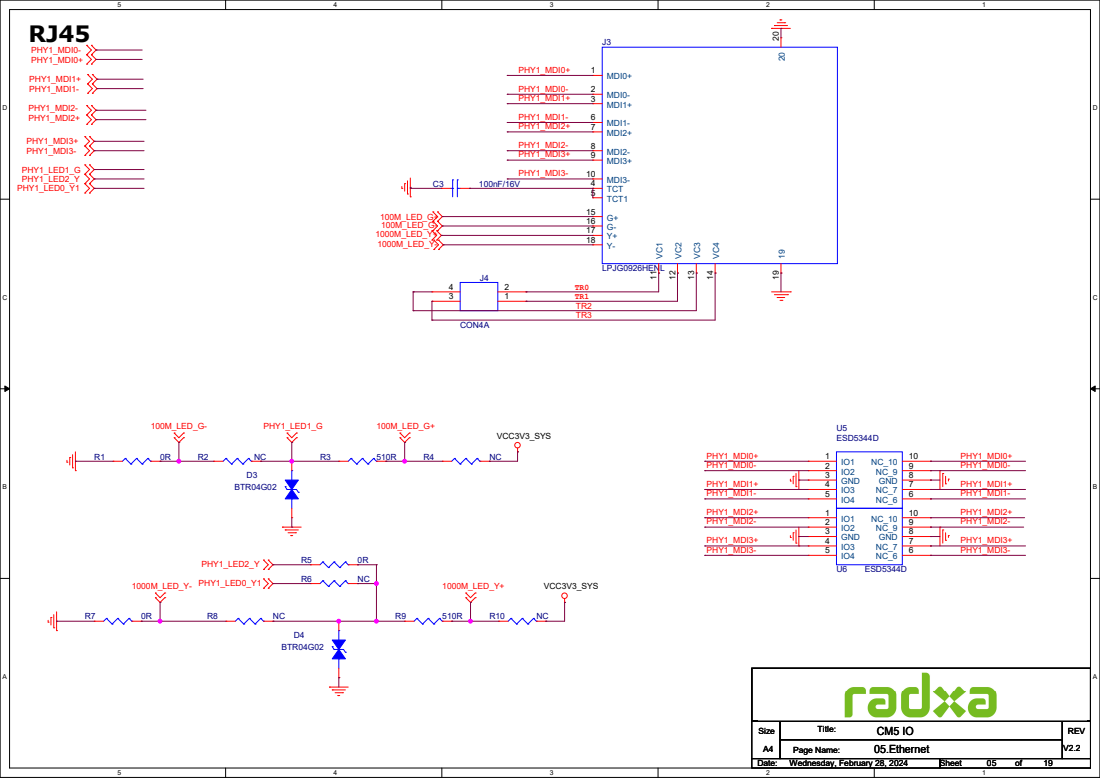
[picture p69: page 5]

# MicroSD Card

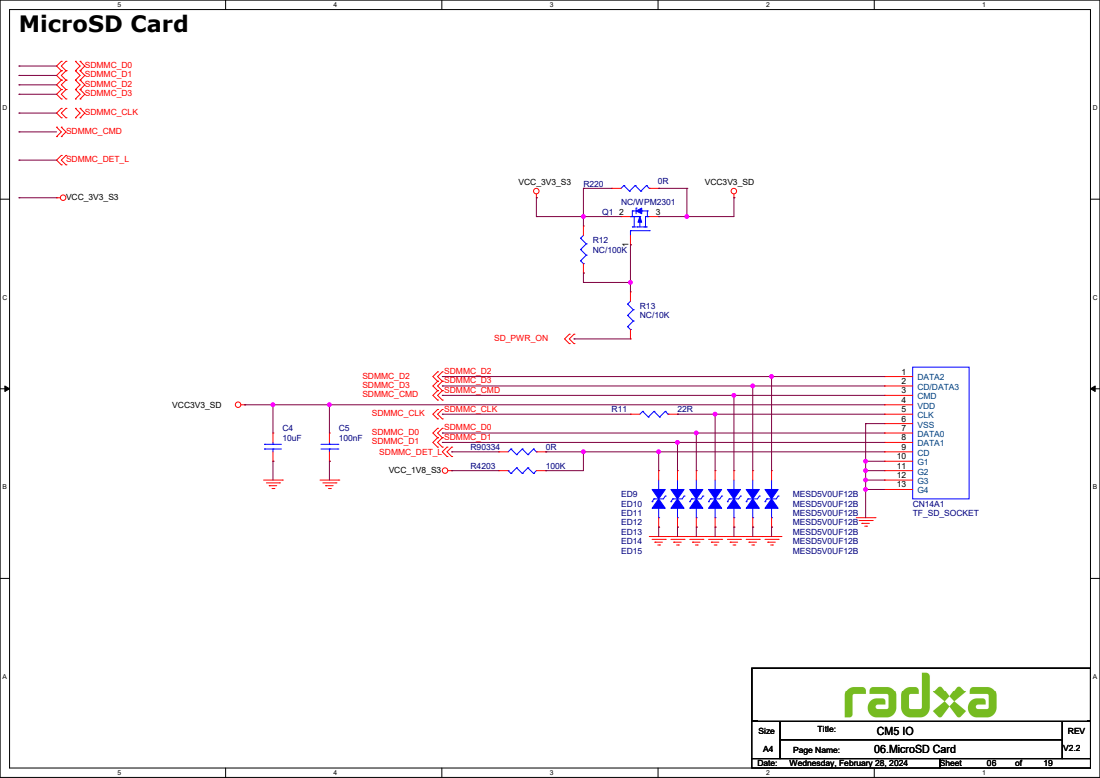
[picture p70: page 6]

# PCIE WIFI/BT MODULE

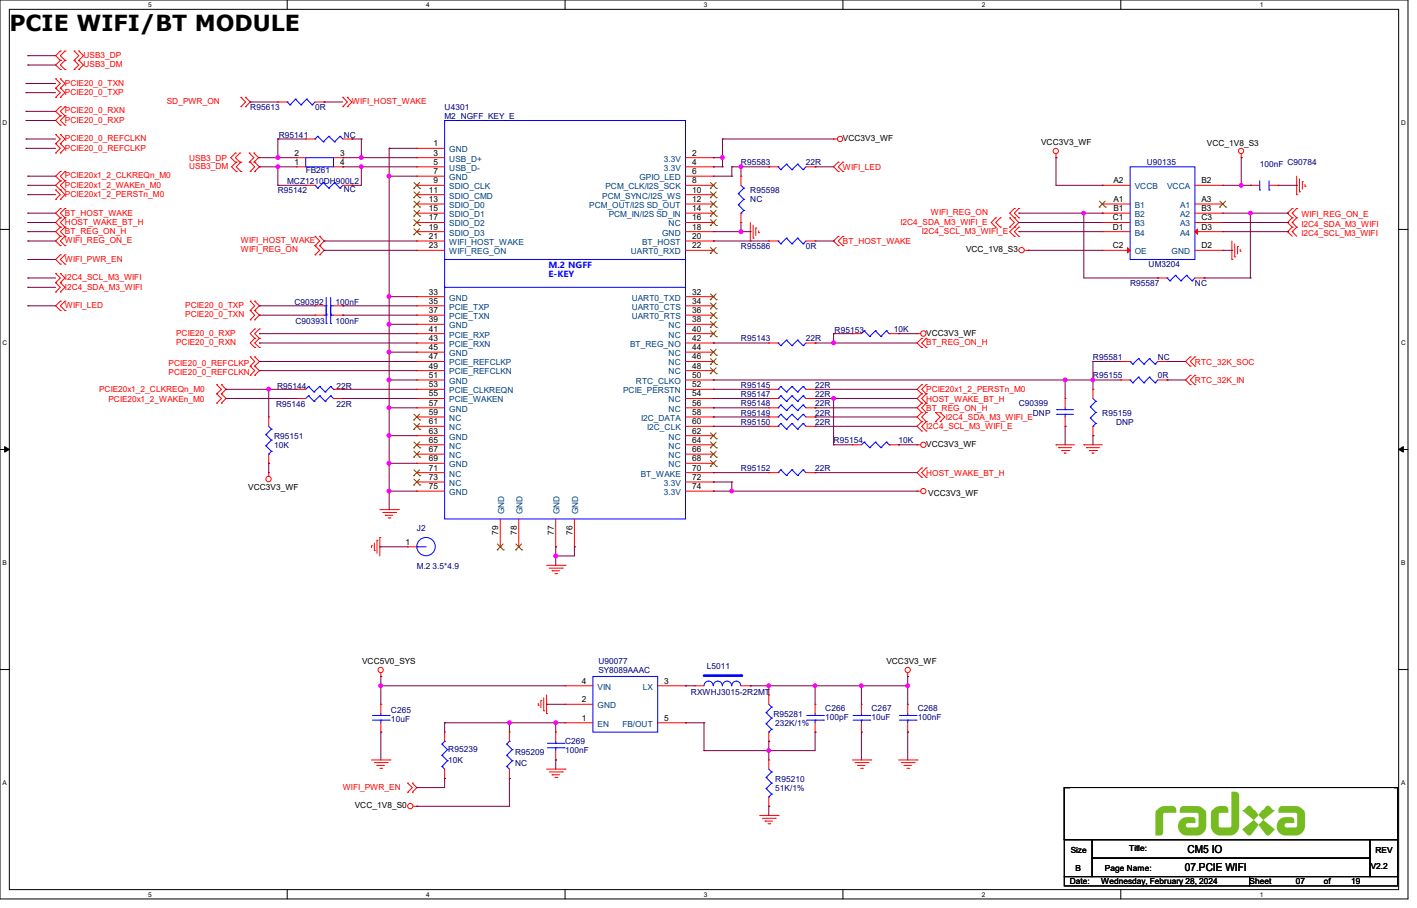
[picture p71: page 7]

# CODEC ES8316

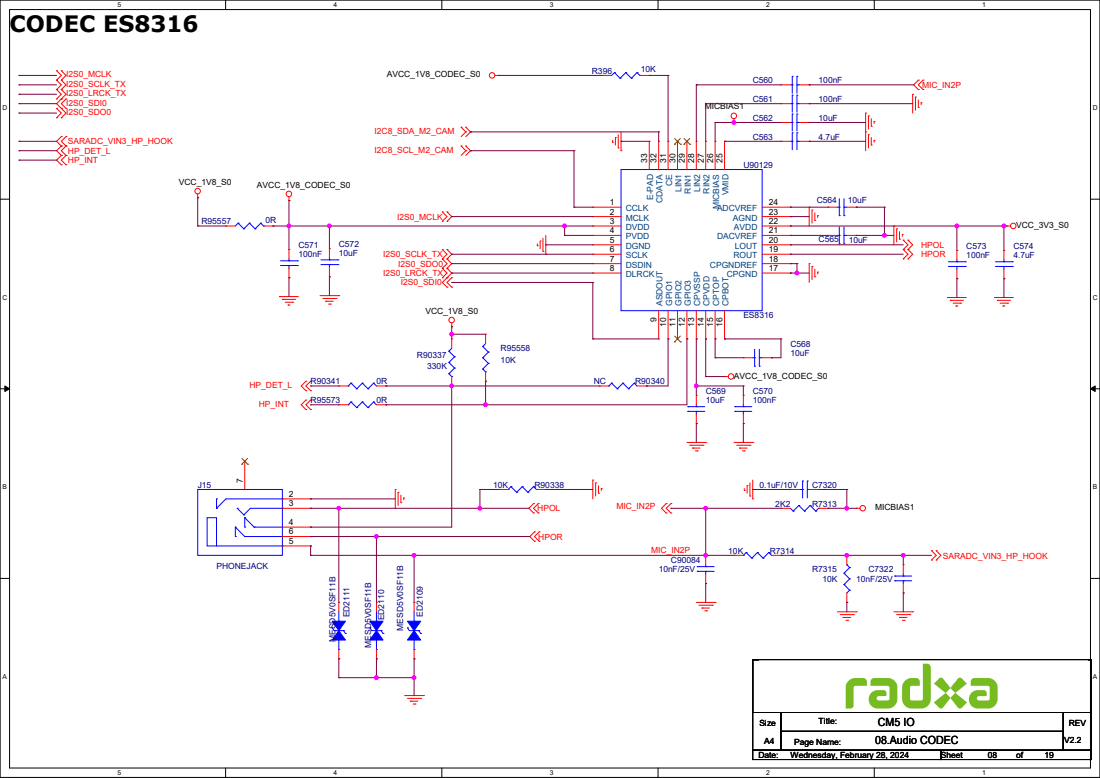
[picture p72: page 8]

# MIPI_DSI_TX 1

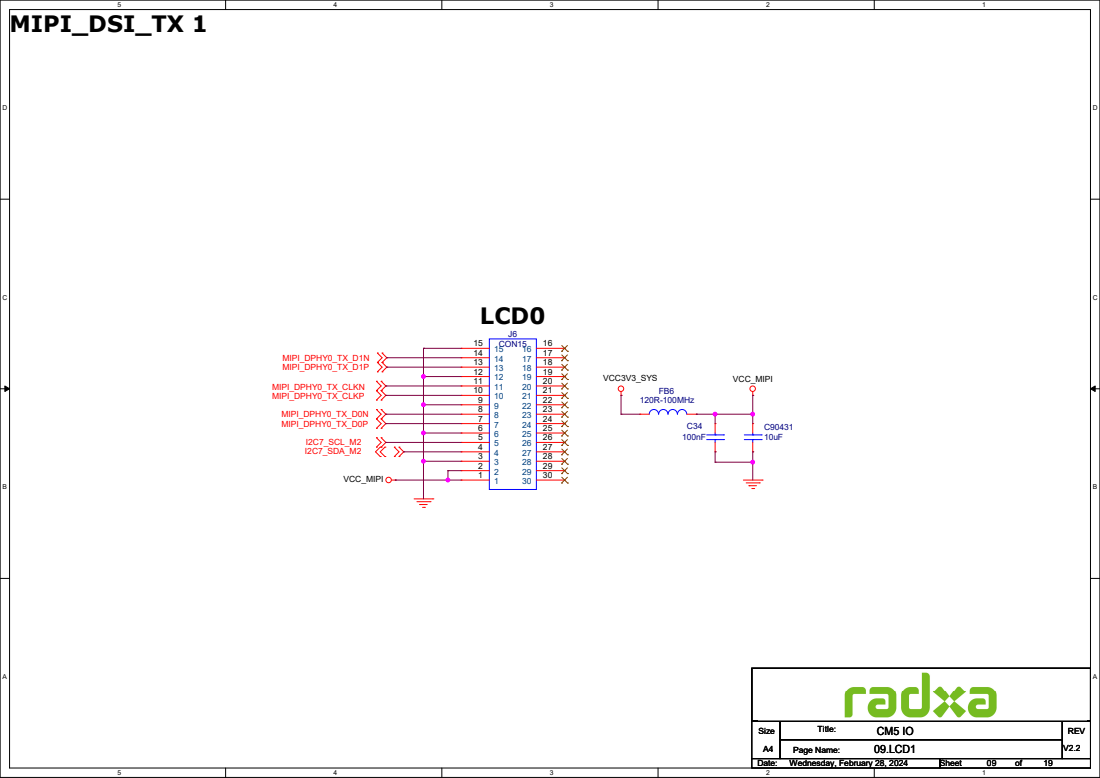
[picture p73: page 9]
LCD0; VCC3V3_SYS; VCC_MIPI; MIPI_DPHY0_TX_D1N MIPI_DPHY0_TX_D1P; MIPI_DPHY0_TX_CLKN MIPI_DPHY0_TX_CLKP; MIPI_DPHY0_TX_D0N MIPI_DPHY0_TX_D0P; I2C7_SCL_M2 I2C7_SDA_M2; Page Name:; 09.LCD1; Wednesday, February 28, 2024; J6 CON15; FB6 120R-100MHz

MIPI DPHY1 TX2 | LCD1

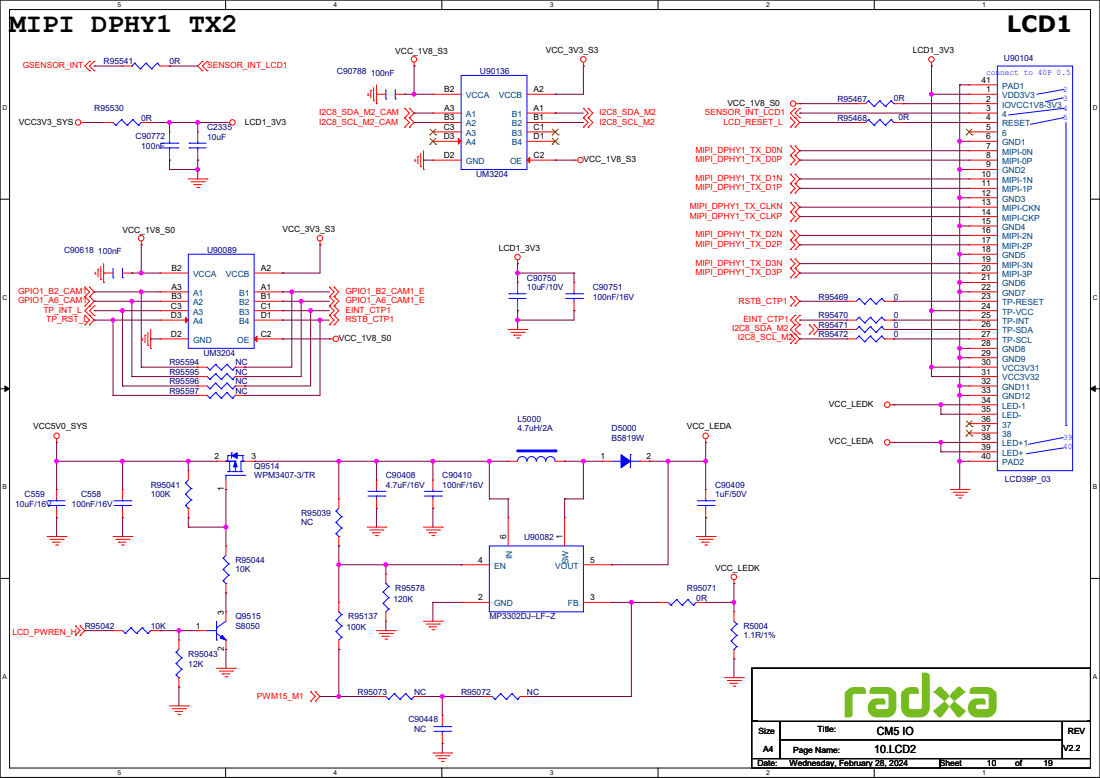
[picture p74: page 10]

# MIPI_CSI_RX

# Camera 1

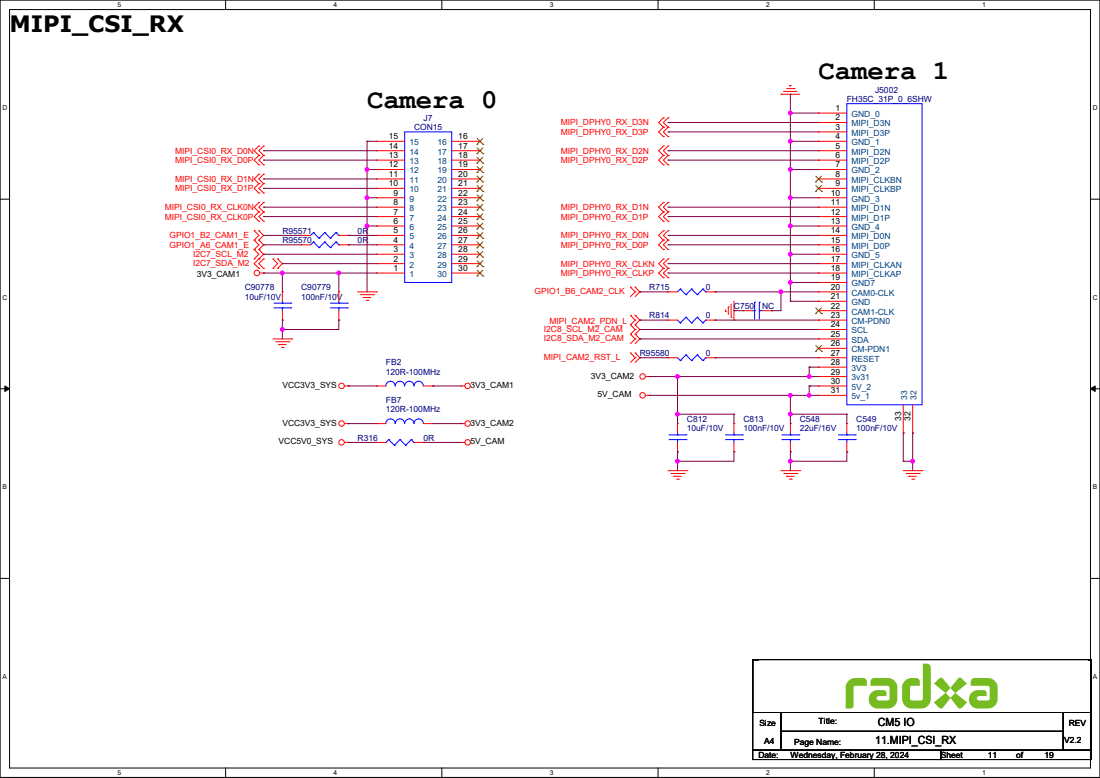
[picture p75: page 11]

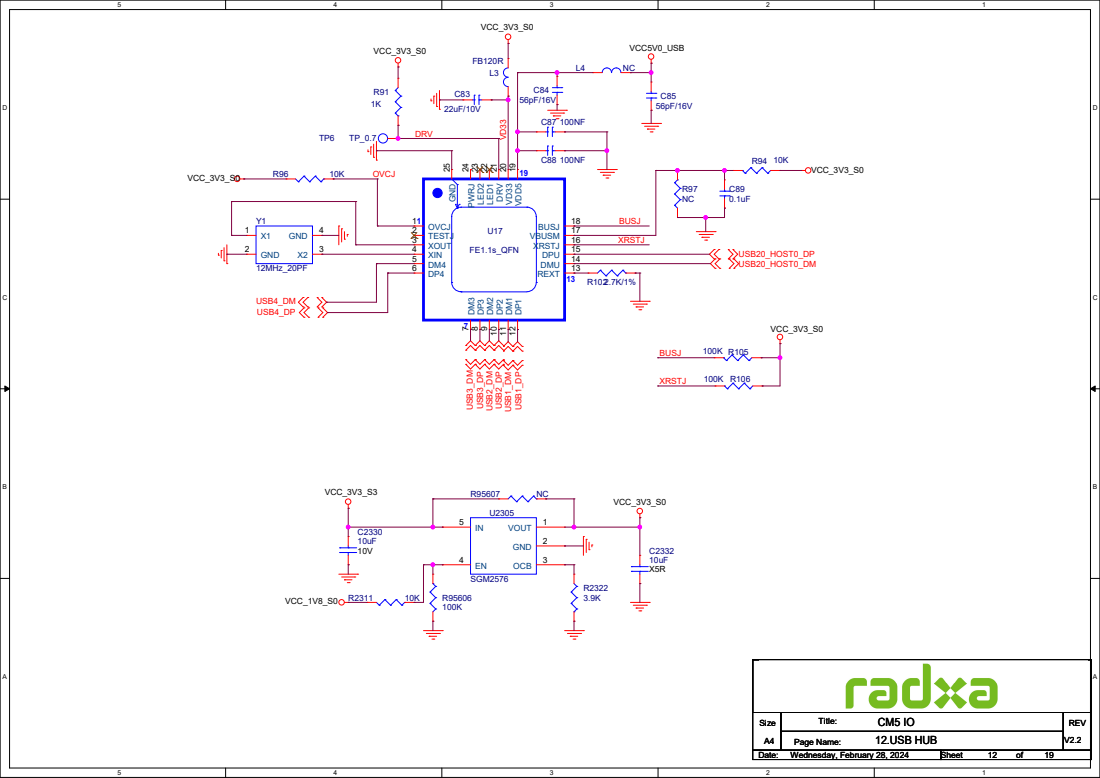
[picture p76: page 12]

# USB 3.0

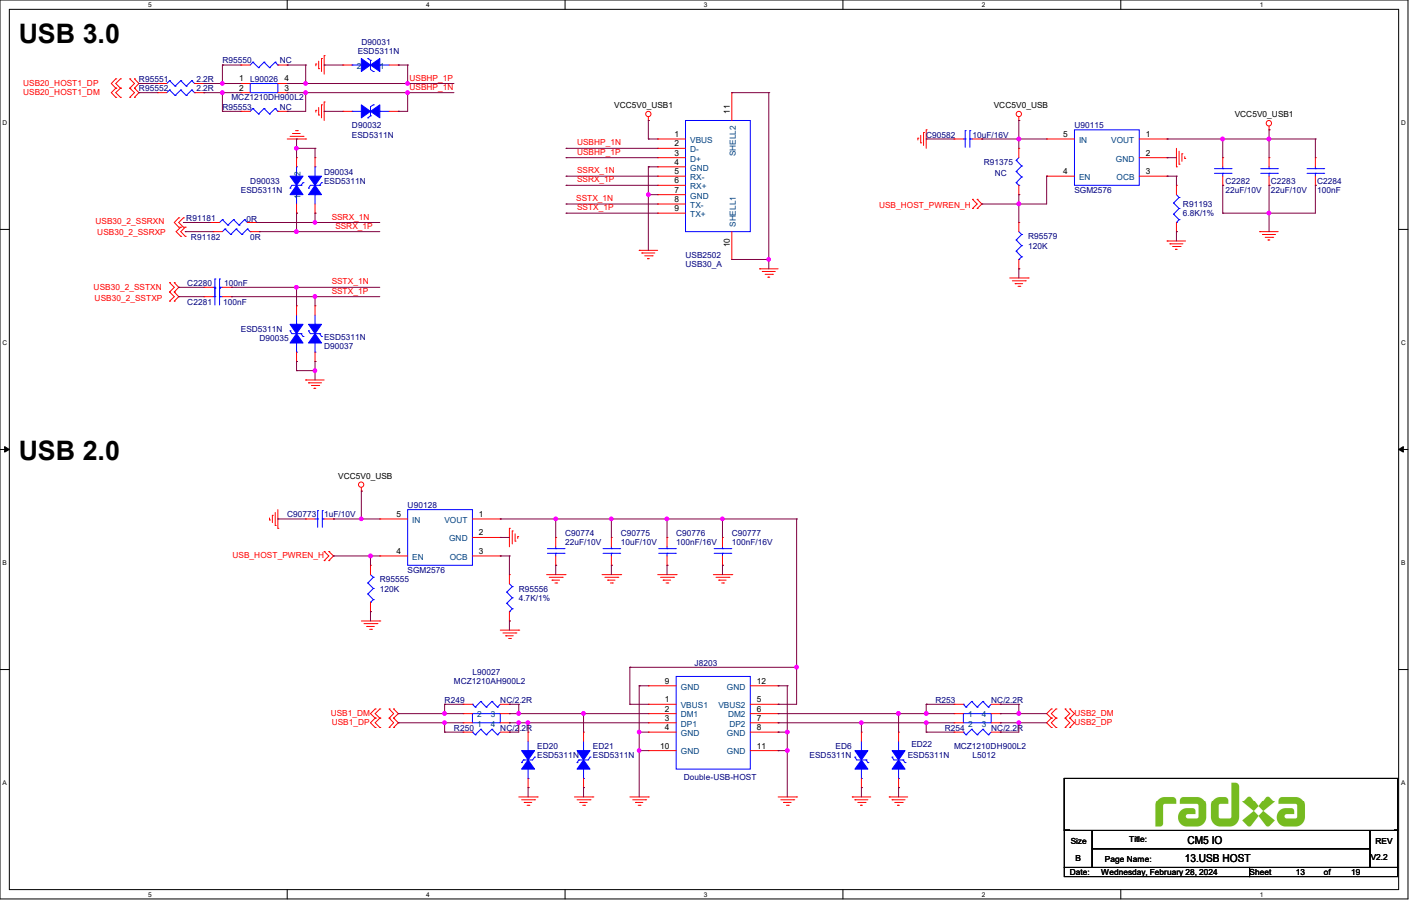
[picture p77: page 13]

# RTC

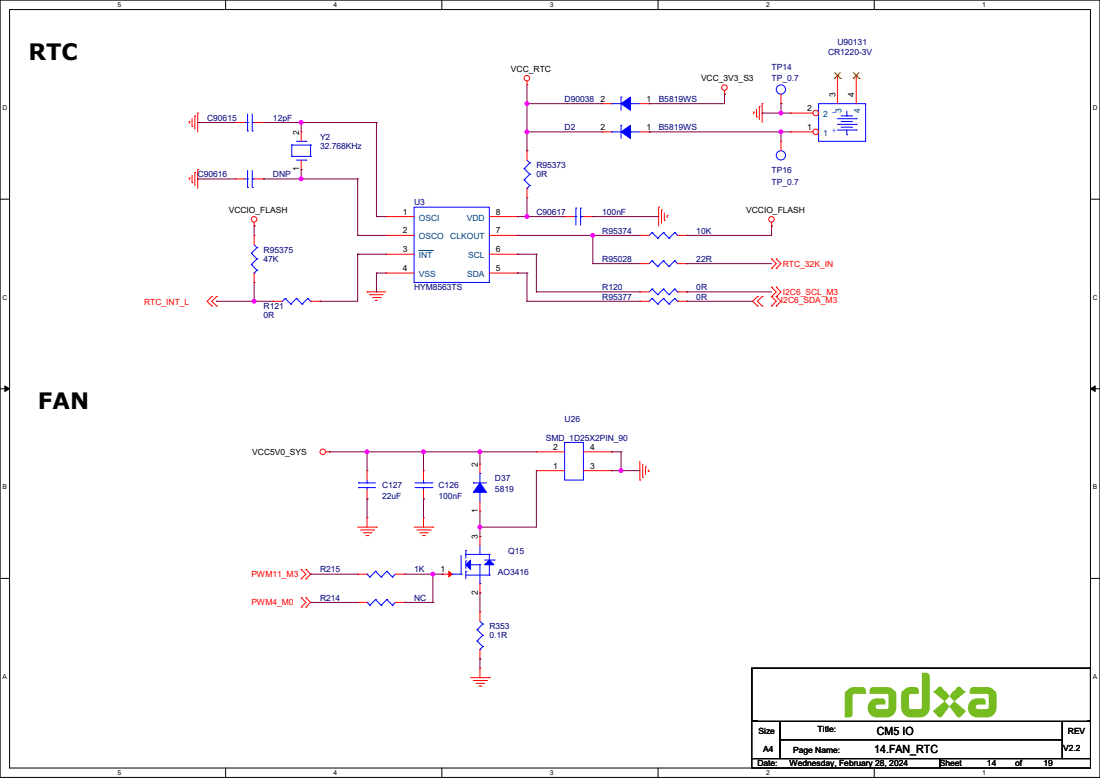
[picture p78: page 14]

# DC IN&SYSTEM Power

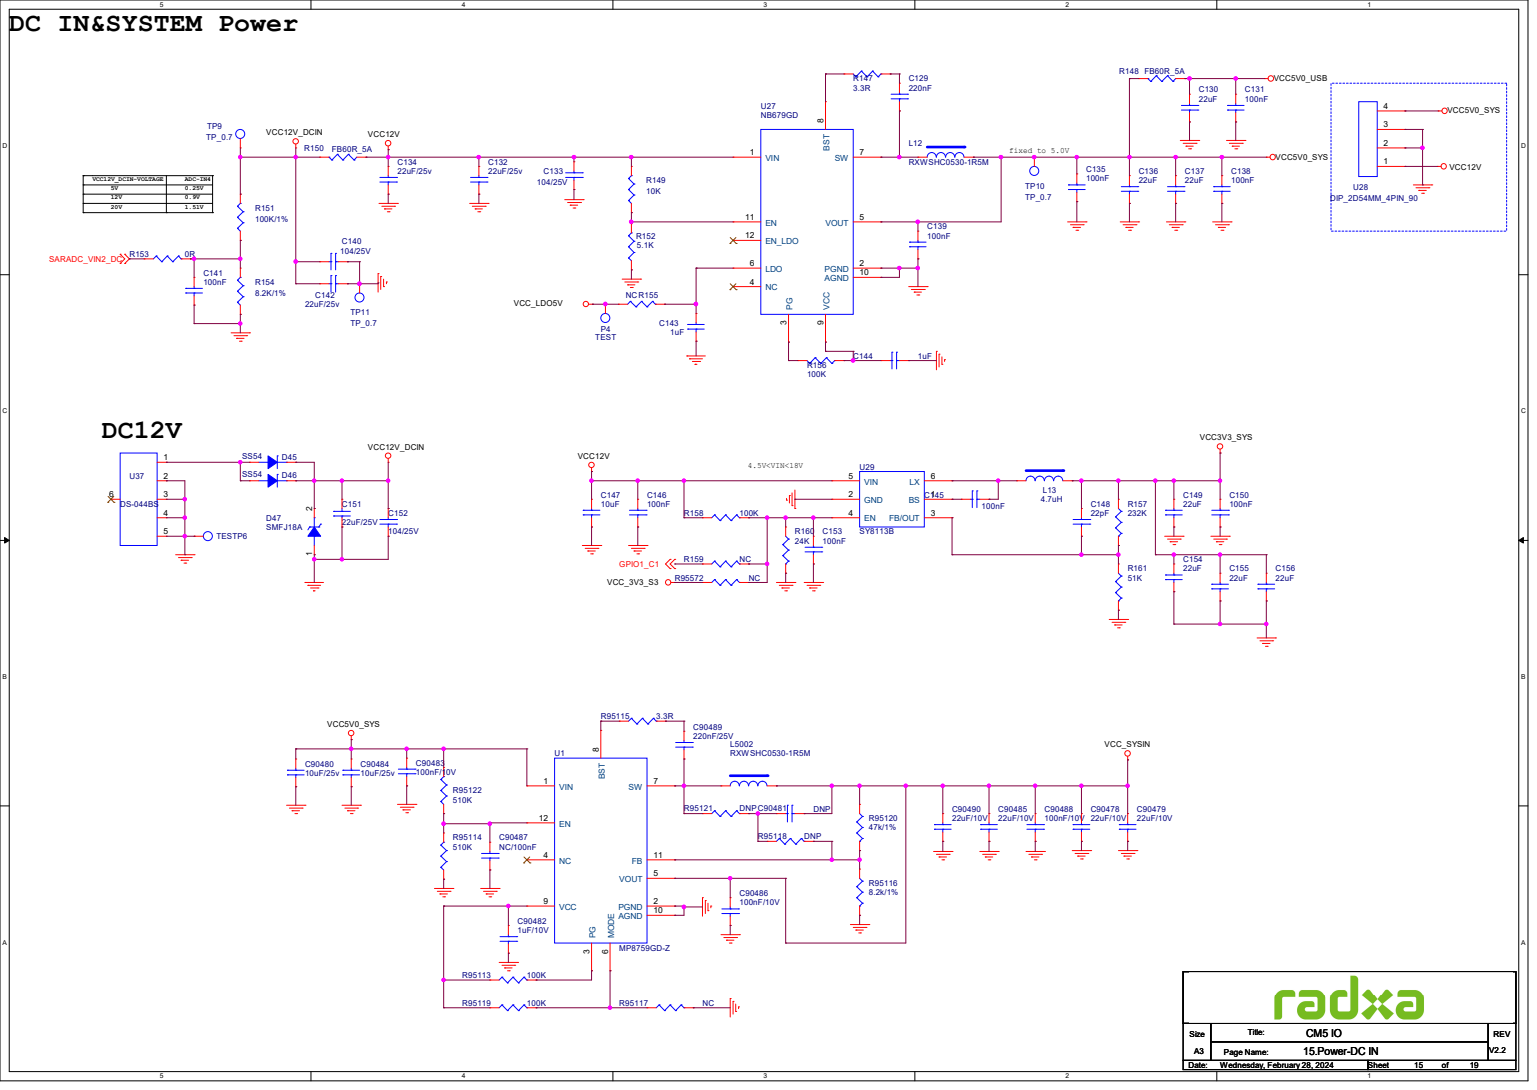
[picture p79: page 15]

VCC12V_DCIN-VOLTAGE | ADC-IN4
5V | 0.25V
12V | 0.9V
20V | 1.51V

# 40PIN Connector

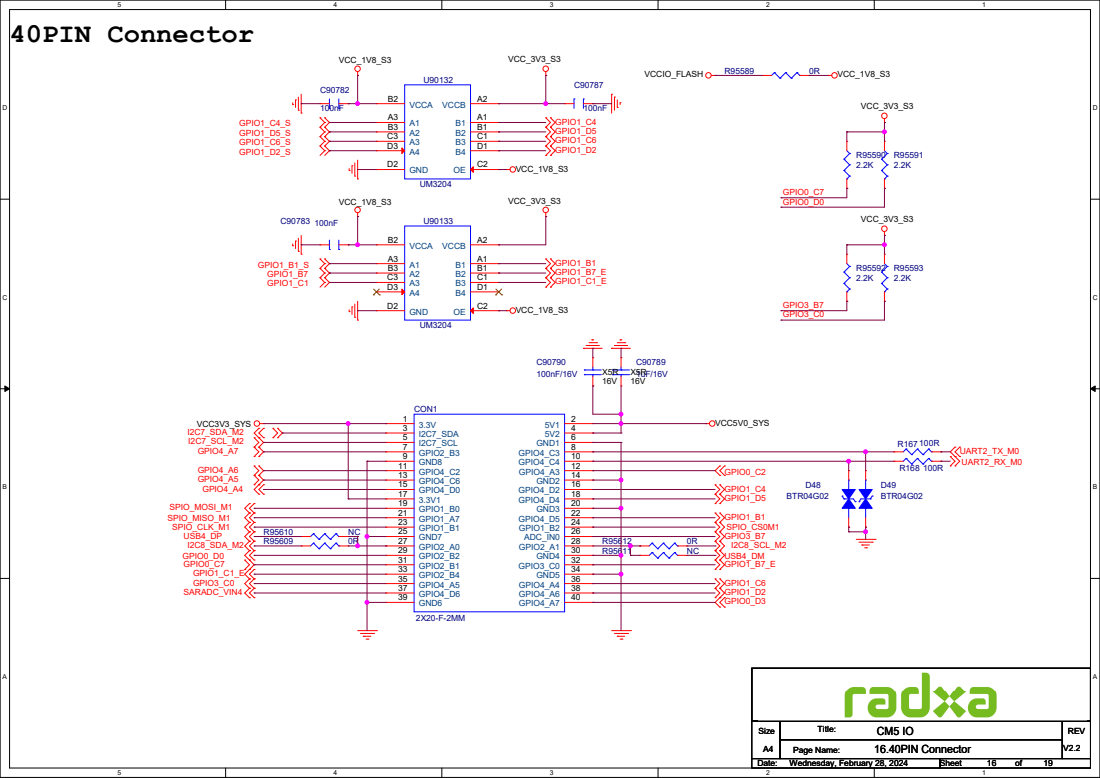
[picture p80: page 16]

1

0

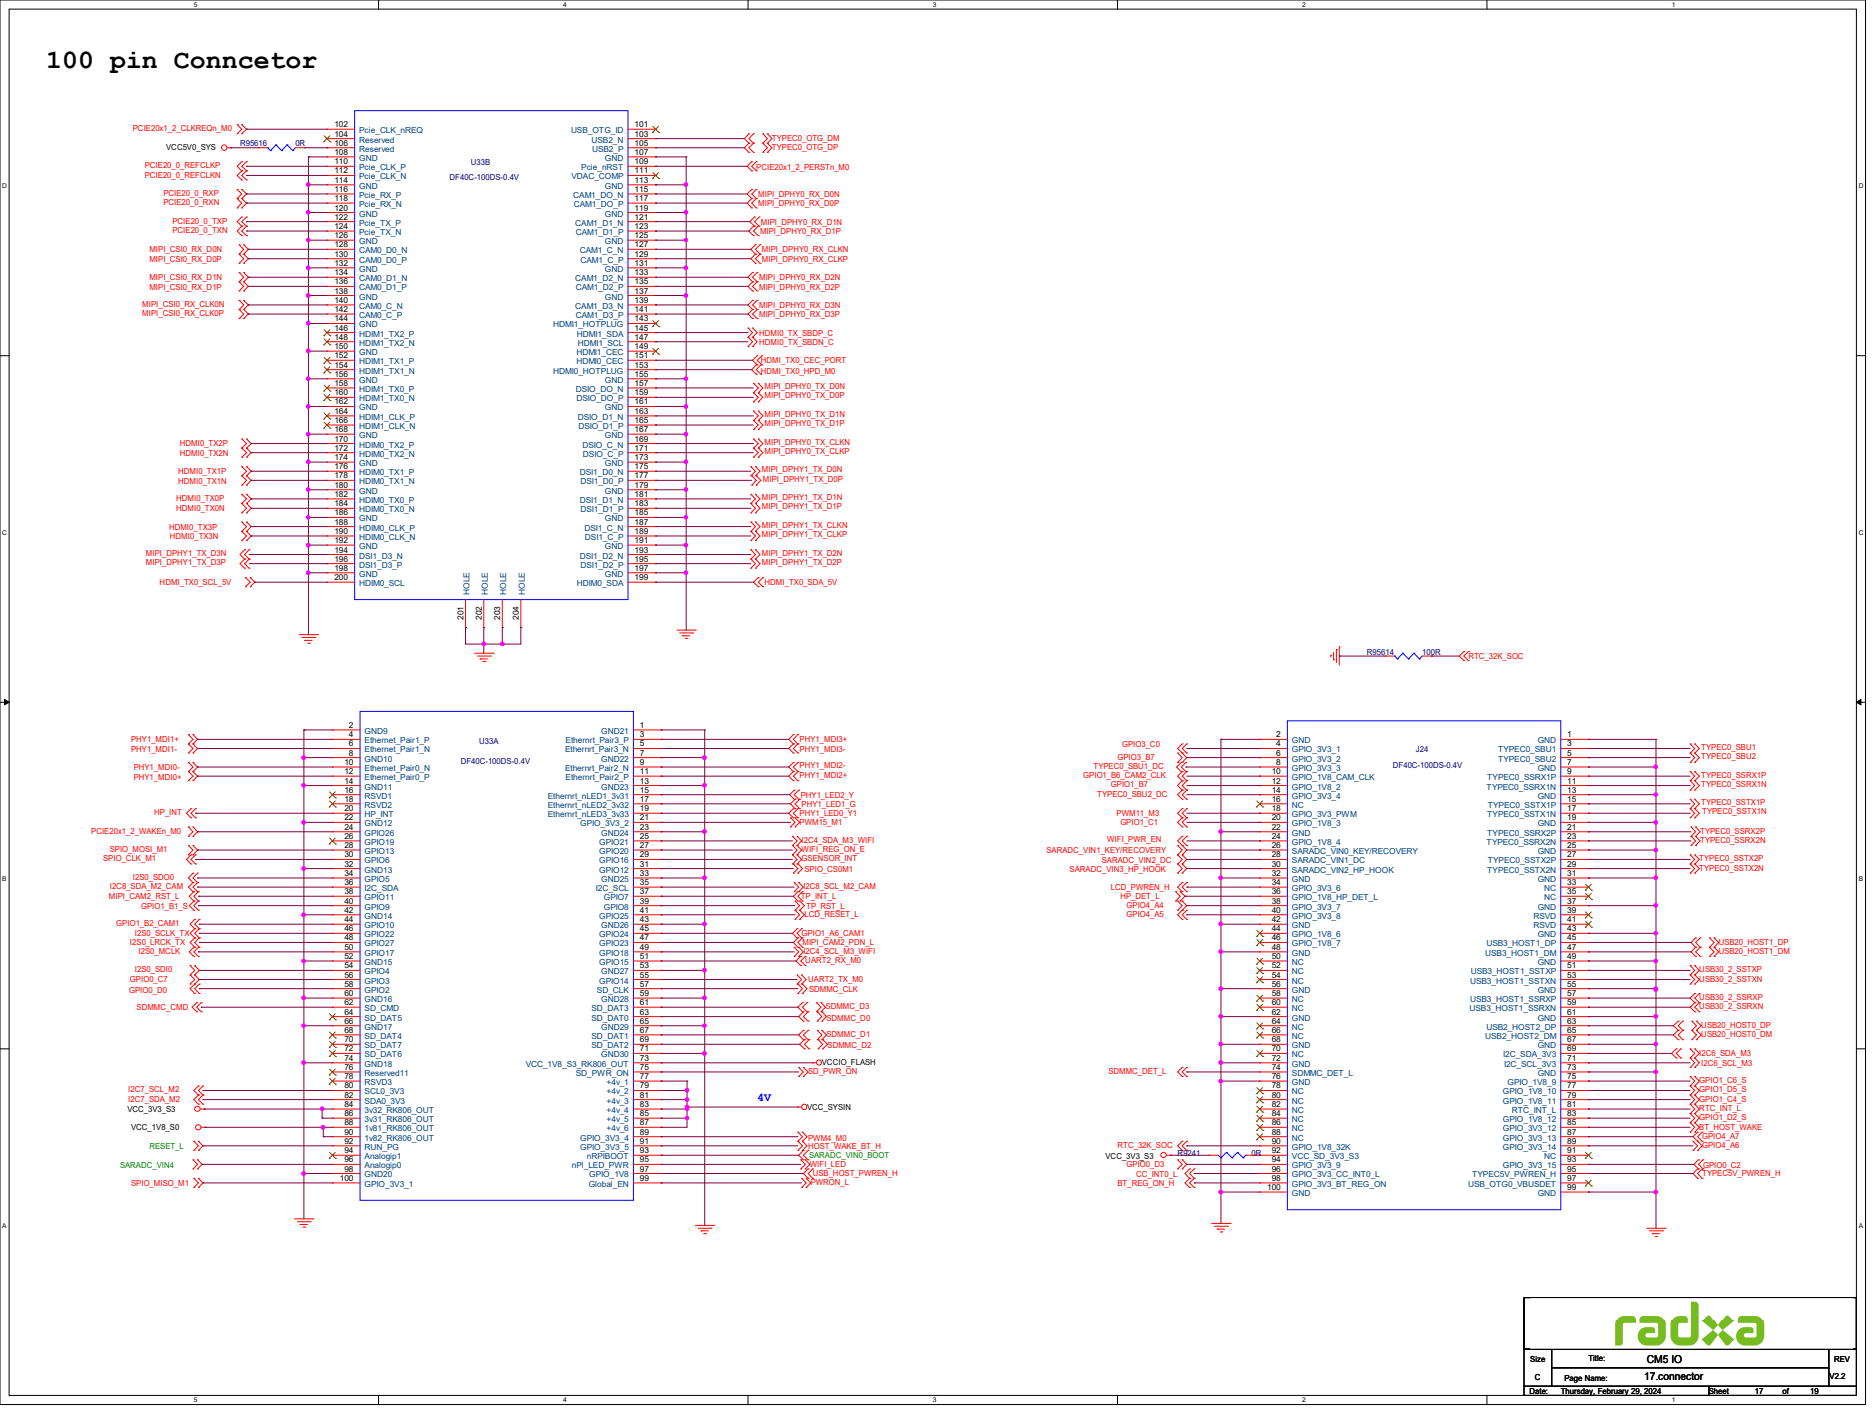
[picture p81: page 17]
SIN; CIO; CIE; MIPI_; _WIFI SPIO_MOSI_M1; WIFI_REG_ON_E; PIO; 1 I2S0_SDO0 I2C8_SDA_M2_CAM; I2C8_SCL_M2; 1 I2S0_SCLK_ T; 1 I2S0_LRCK_TX; MIPI_CAM2_PDN; L I2S0_MCLK; I2C4_SCL_M3_WIFI UART2_RX_M0 I2S0_SDI0; _VIN; WIFI_; MIS; M I2C6_SDA_M3 I2C6_SCL_M3; N I2C7_SDA_M2 I2C7_SCL_M2; Siz; Title: Page Name:; cie; SIO; DIM; HOLE 201; HOLE 202; HOLE 203; HOLE 204; 7 I2C_SDA_3V3 69 I2C_SCL_3V3 71 GND 73 GPIO_1V8_9 75 GPIO_1V8_10 77 GPIO_1V8_11 79 RTC_INT_L 81; air; 1 I2C_SDA; alo; gip; PIB; Glo

# Type C

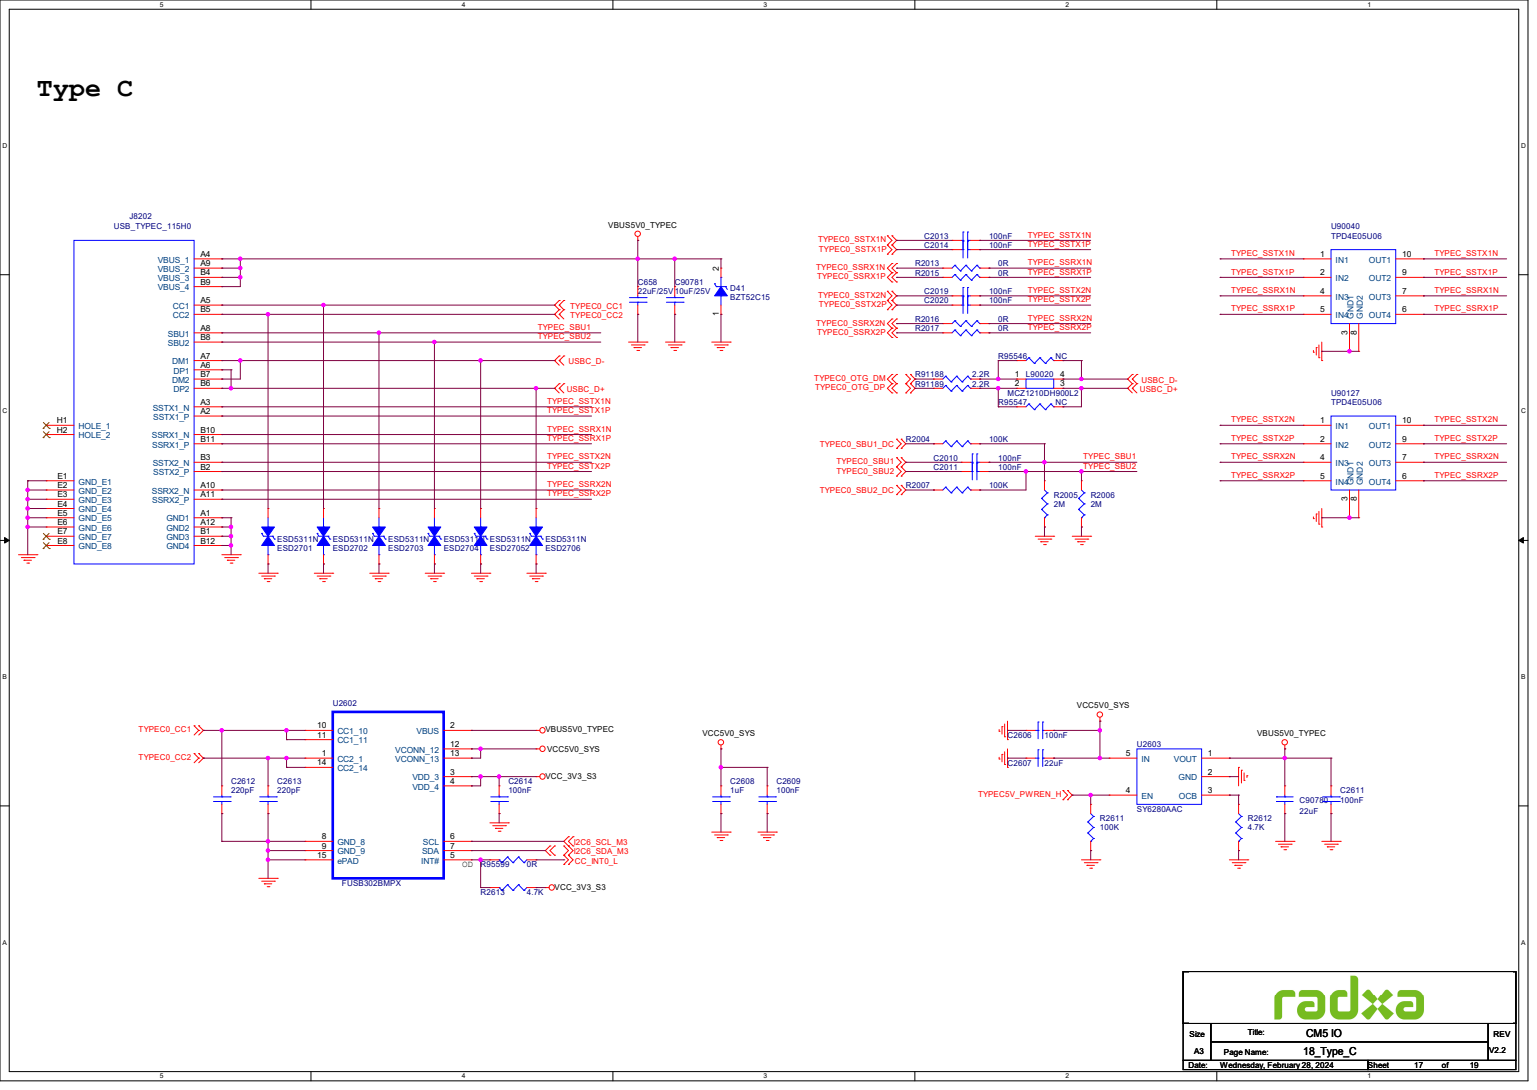
[picture p82: page 18]

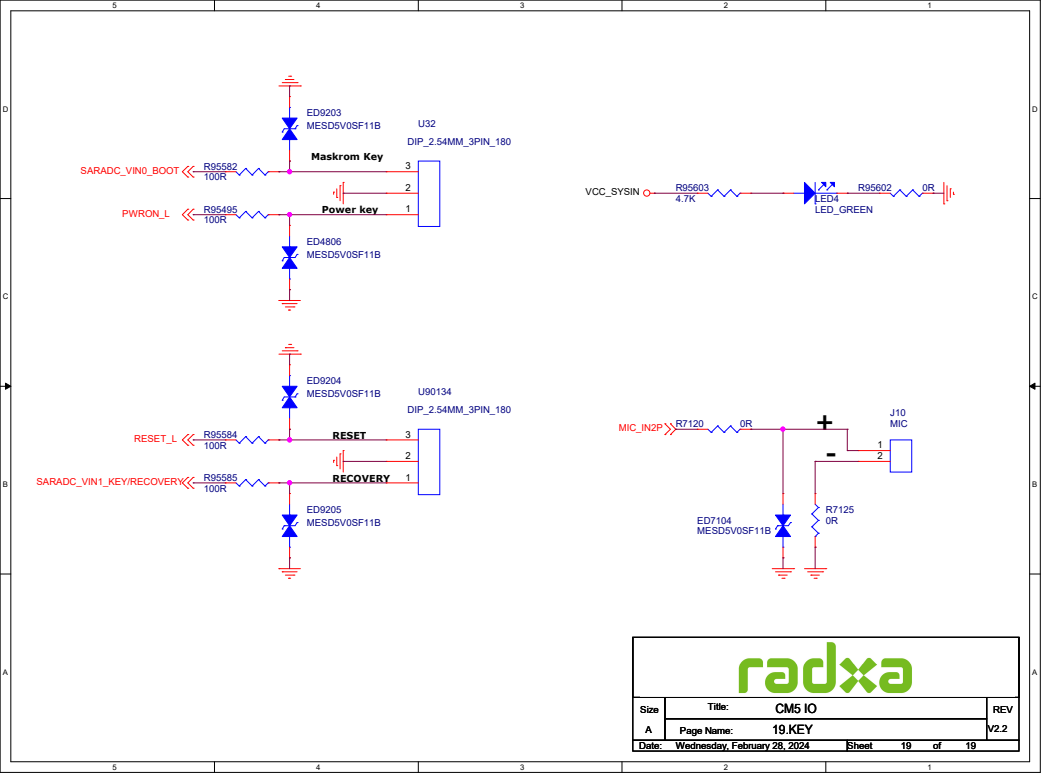
[picture p83: page 19]
Maskrom Key; Power key; RESET; RECOVERY; VCC_SYSIN; PWRON_L; SARADC_VIN0_BOOT; RESET_L; SARADC_VIN1_KEY/RECOVERY; MIC_IN2P; Size; REV; Title:; Page Name:; 19.KEY; Wednesday, February 28, 2024; ED9205 MESD5V0SF11B; U32 DIP_2.54MM_3PIN_180; ED9204 MESD5V0SF11B; ED9203 MESD5V0SF11B; ED4806 MESD5V0SF11B; U90134 DIP_2.54MM_3PIN_180; J10 MIC; ED7104 MESD5V0SF11B; LED4 LED_GREEN
