radxa/radxa-cm-projects/cm3s/radxa_cm3s_io_board/radxa_cm3s_io_board_v1510_schematic.pdf

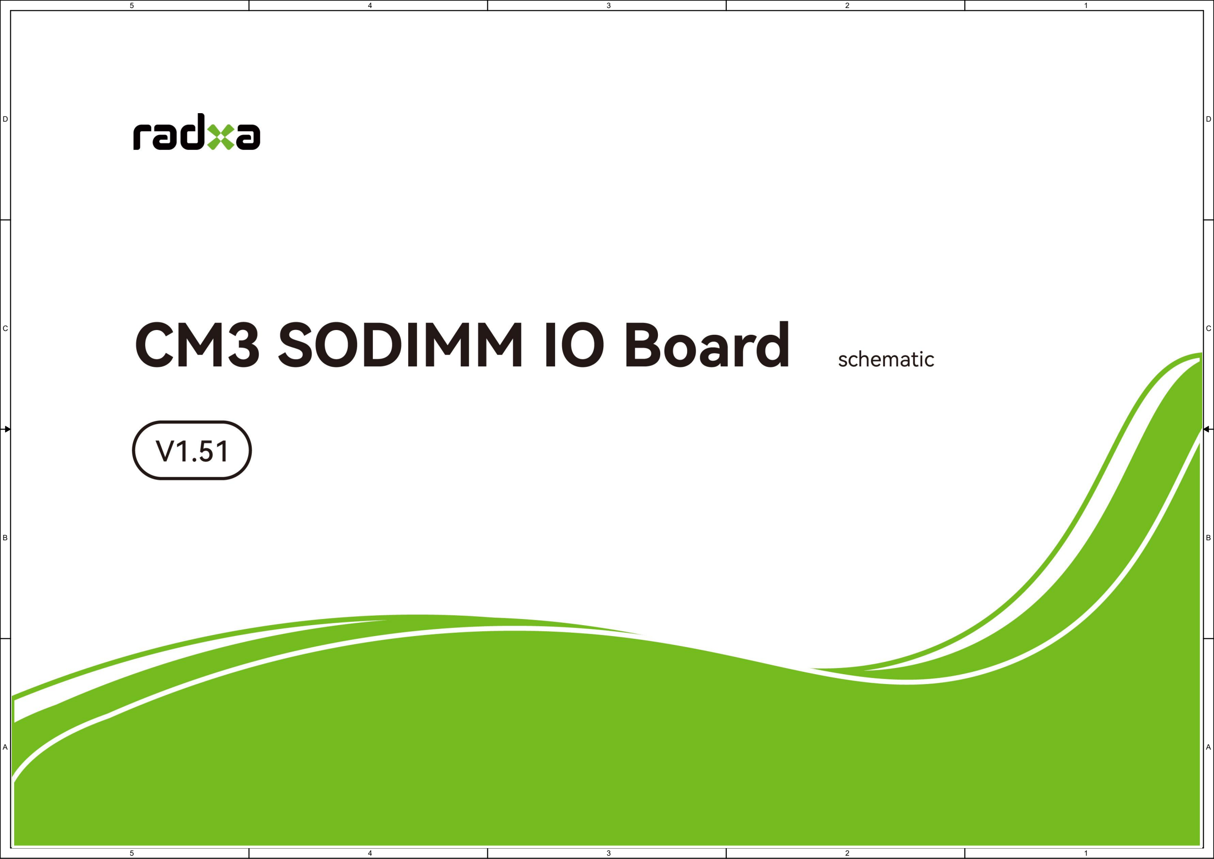
[picture p84: page 1]

55

44

33

22

11

D

D

C | C
B | B

A

A

# 01.cover

# Table of Content

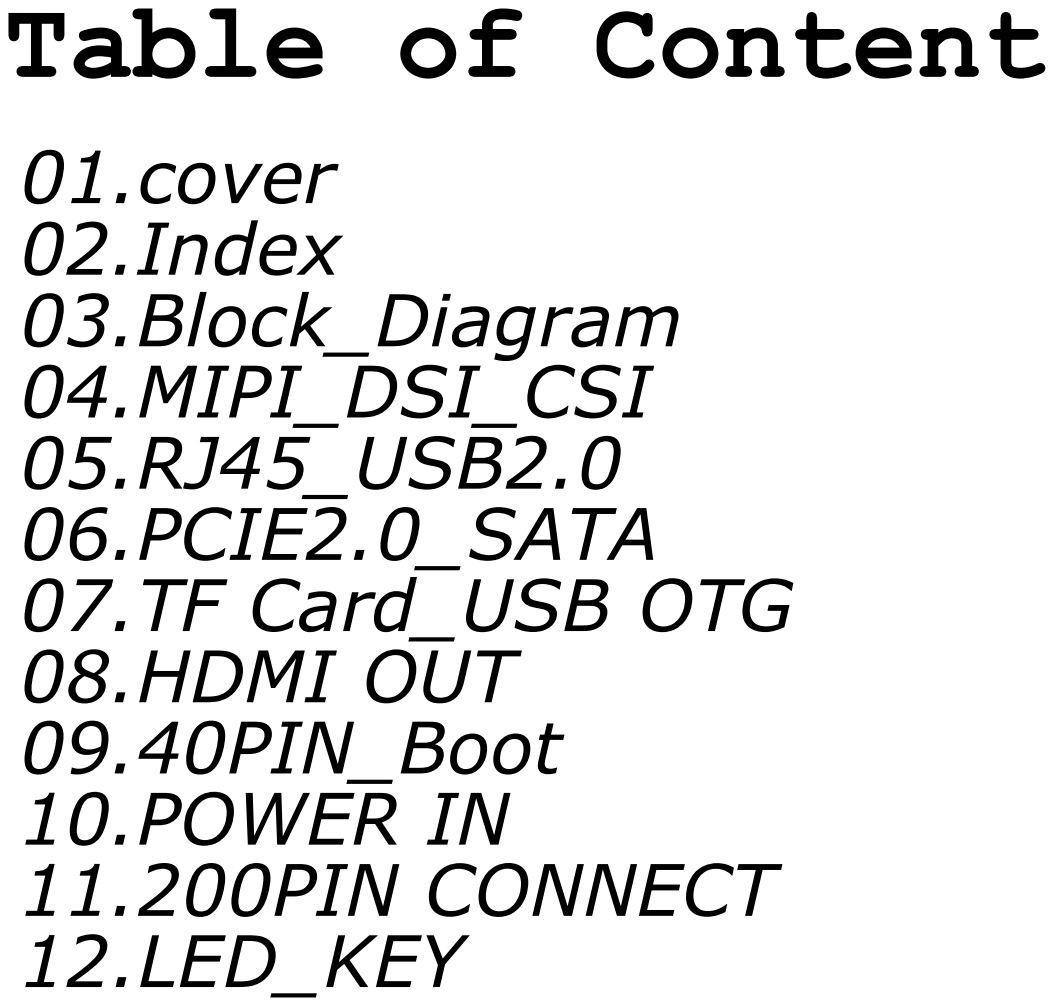
[picture p85: page 2]
02.Index 03.Block_Diagram 04.MIPI_DSI_CSI 05.RJ45_USB2.0 06.PCIE2.0_SATA 07.TF Card_USB OTG 08.HDMI OUT 09.40PIN_Boot 10.POWER IN 11.200PIN CONNECT 12.LED_KEY; Size; REV; Date:; Sheet; Title:; Page Name:; Index; Monday, March 27, 2023

CM3 SODIMM IO Board A4

# 12V_OUT 5V_OUT

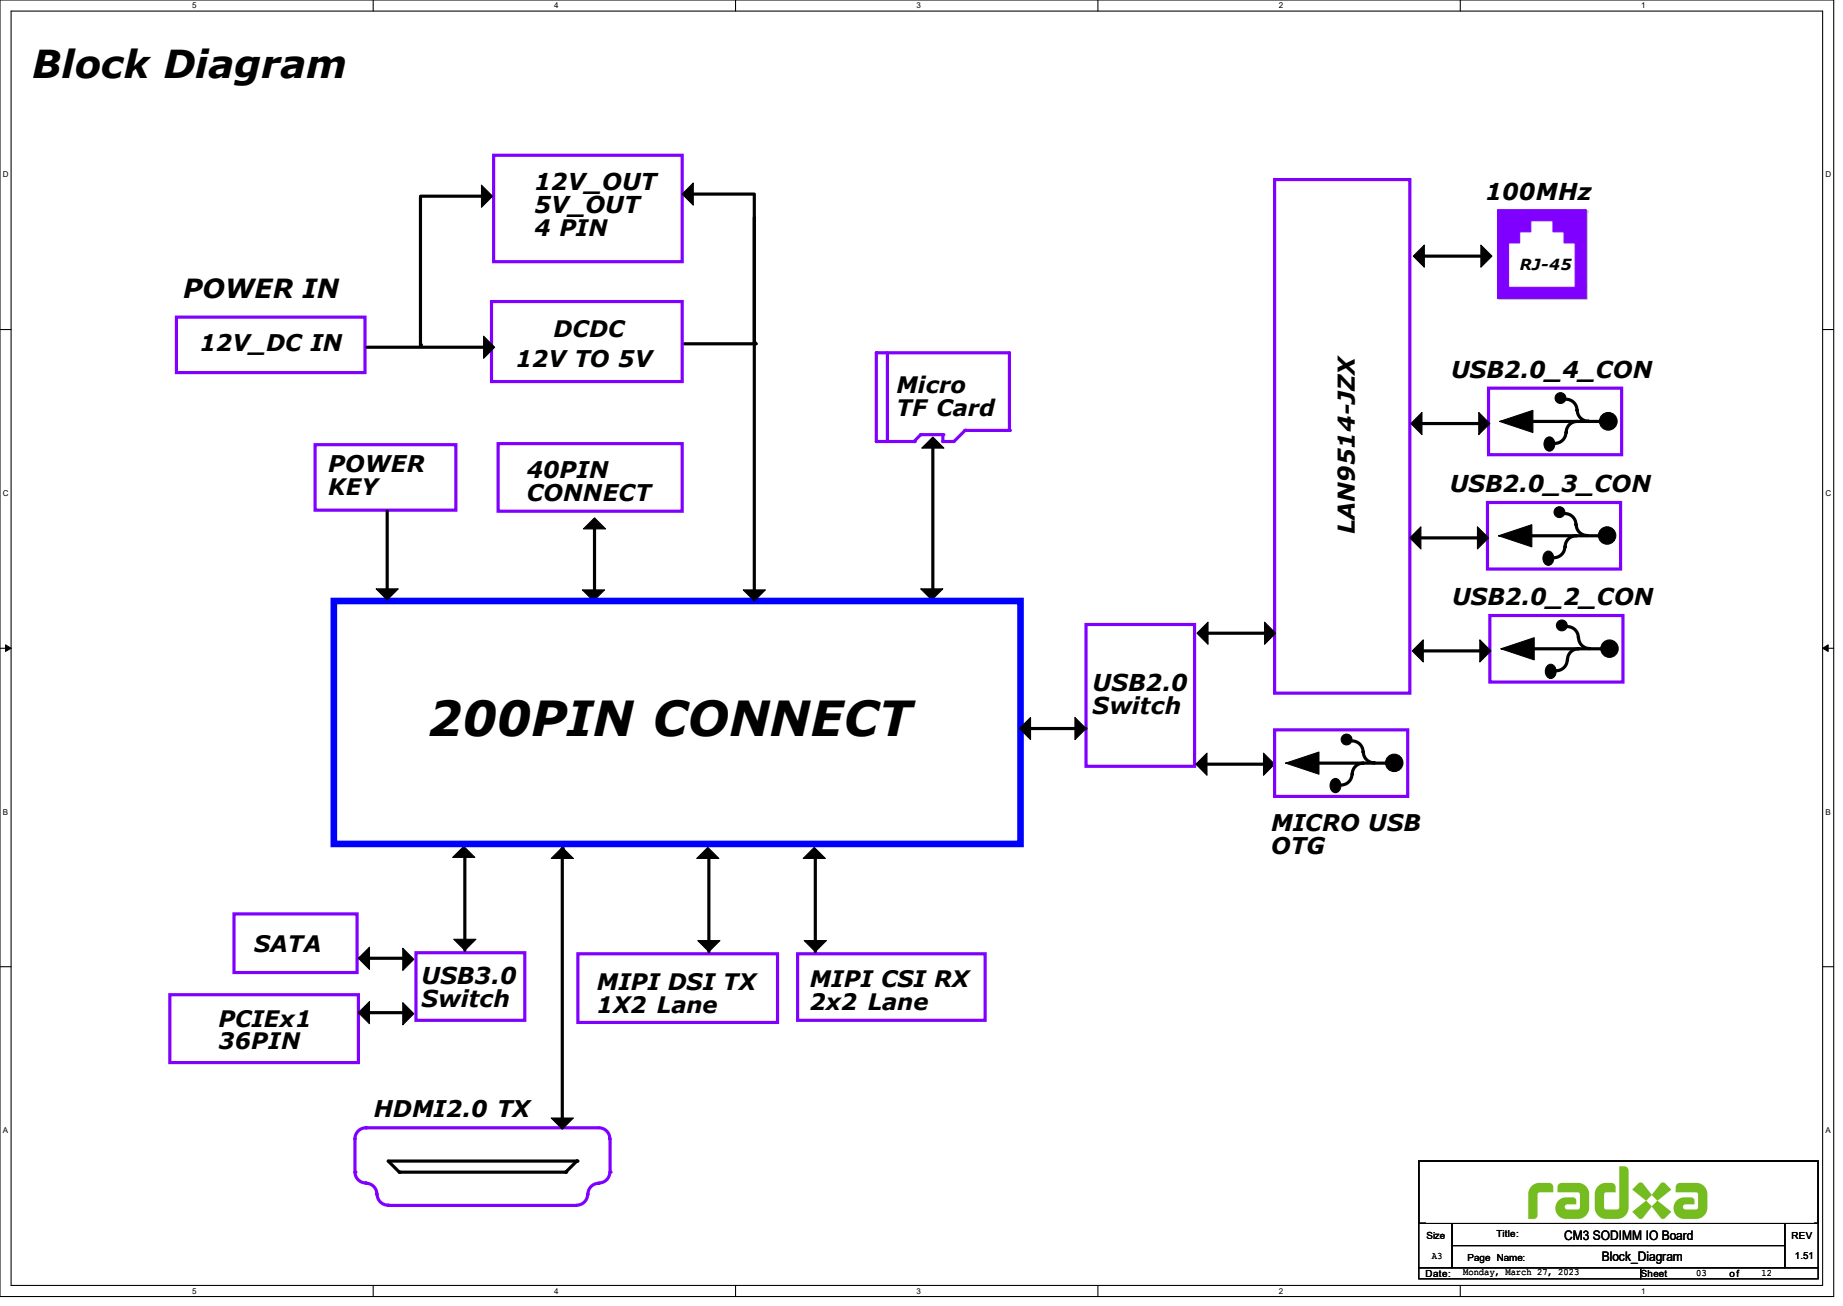
[picture p86: page 3]
A A LAN⁹⁵¹⁴⁻JZX; HDMI2.0 TX; SATA; PCIEx1 36PIN; POWER KEY; 4 PIN; 40PIN CONNECT; USB3.0 Switch; Block Diagram; 200PIN CONNECT; Micro TF Card; DCDC; POWER IN; USB2.0 Switch; MICRO USB OTG; USB2.0_2_CON; USB2.0_3_CON; USB2.0_4_CON; 100MHz; Page Name:; Block_Diagram; 1.51 CM3 SODIMM IO Board A3; Monday, March 27, 2023

MIPI DSI TX
1X2 Lane

MIPI CSI RX
2x2 Lane

# MIPI_DSI_TX 2Lanes

## VCC_3V3

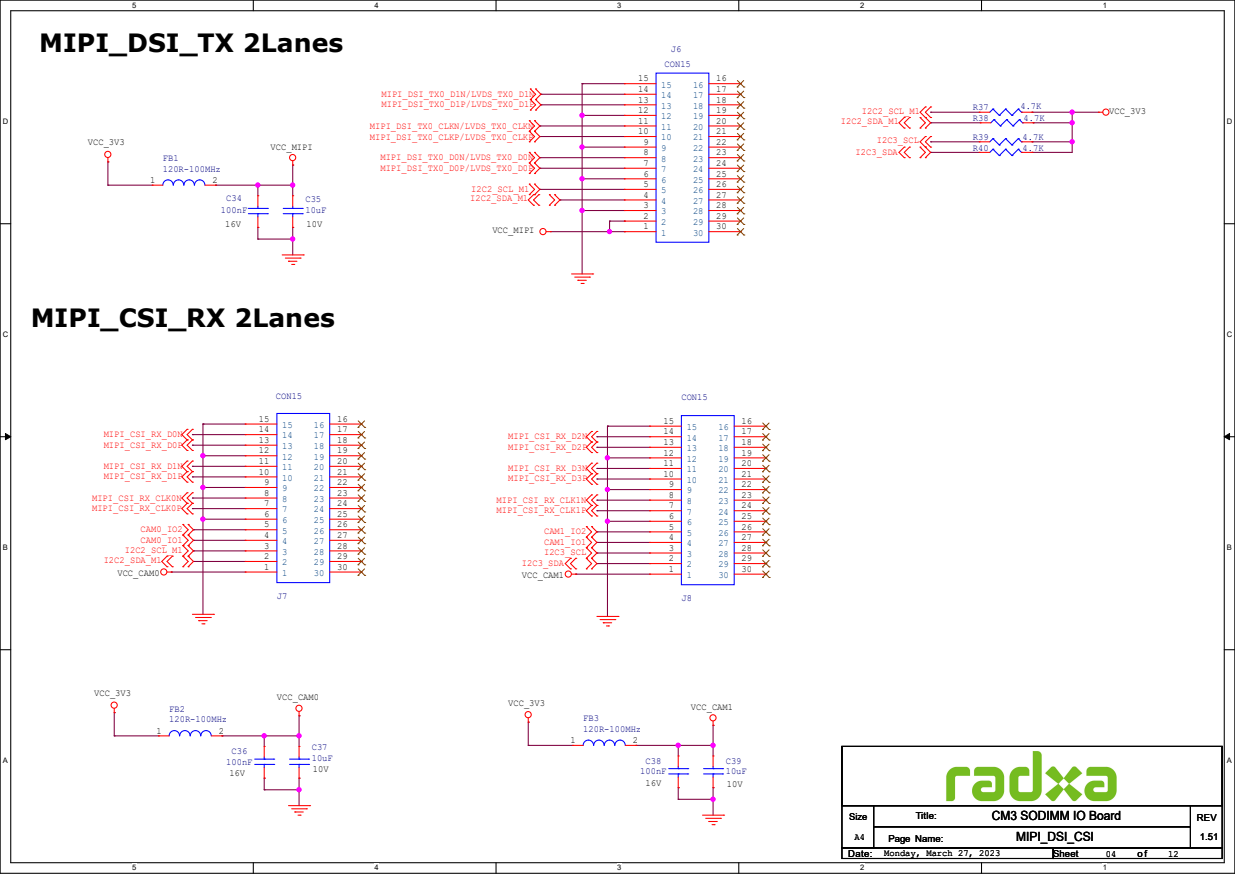
[picture p87: page 4]

# Ethernet

LAN9514-JZX VDD33IO 19 VDD33IO 27 VDD33IO 33 VDD33IO 39 VDD33IO 46 VDD18CORE 15 VDD18CORE 38 VDD18ETHPLL 48 VDD18USBPLL 62

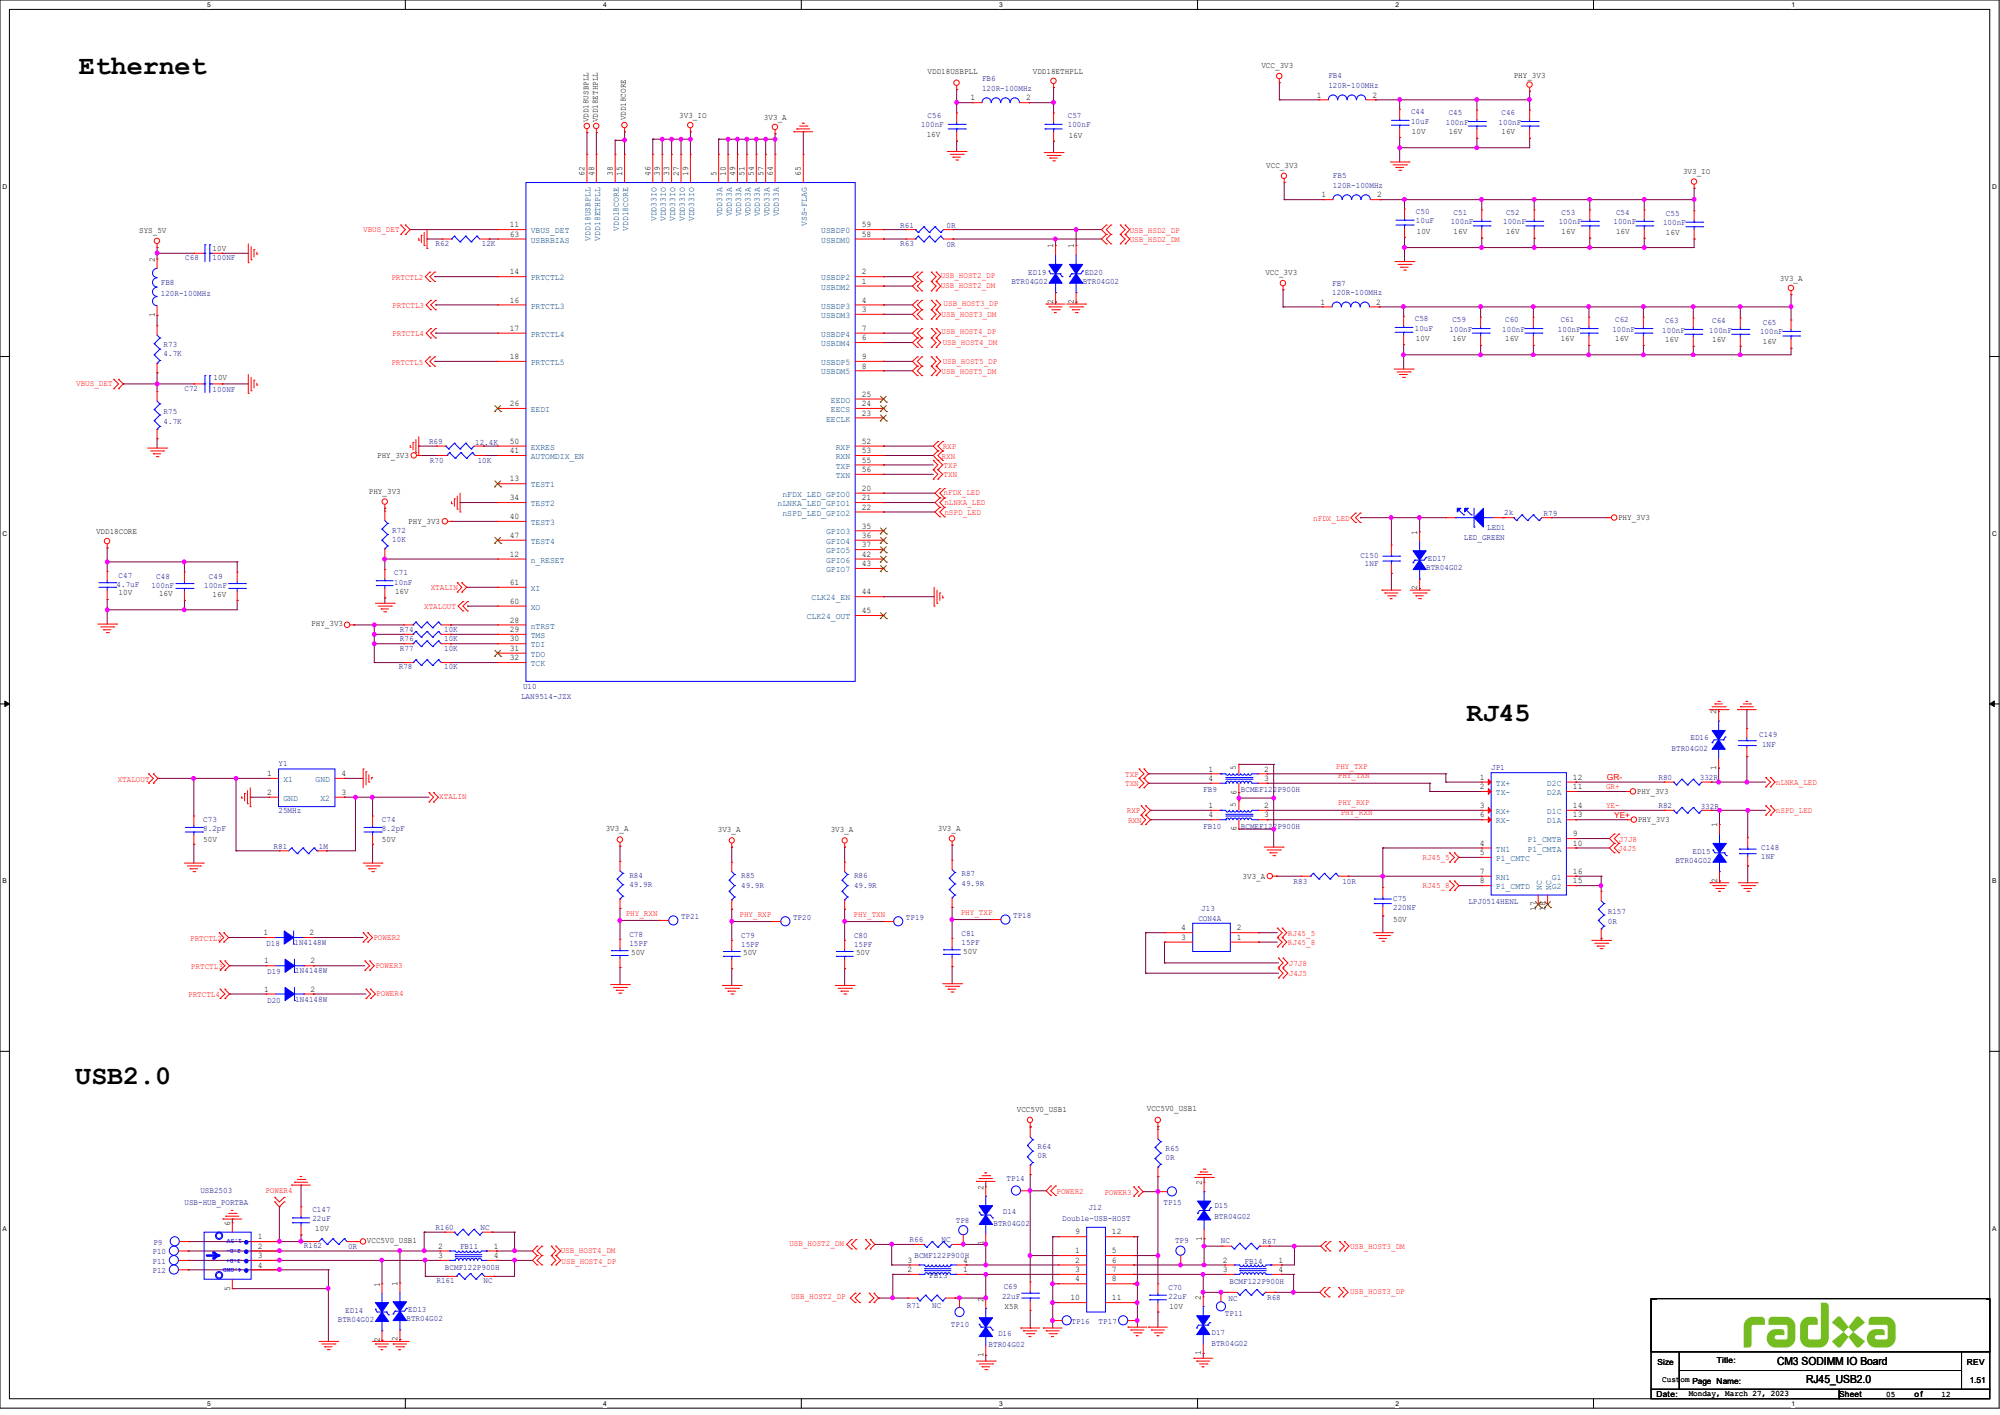
[picture p88: page 5]

# PCIE

# 5 BST

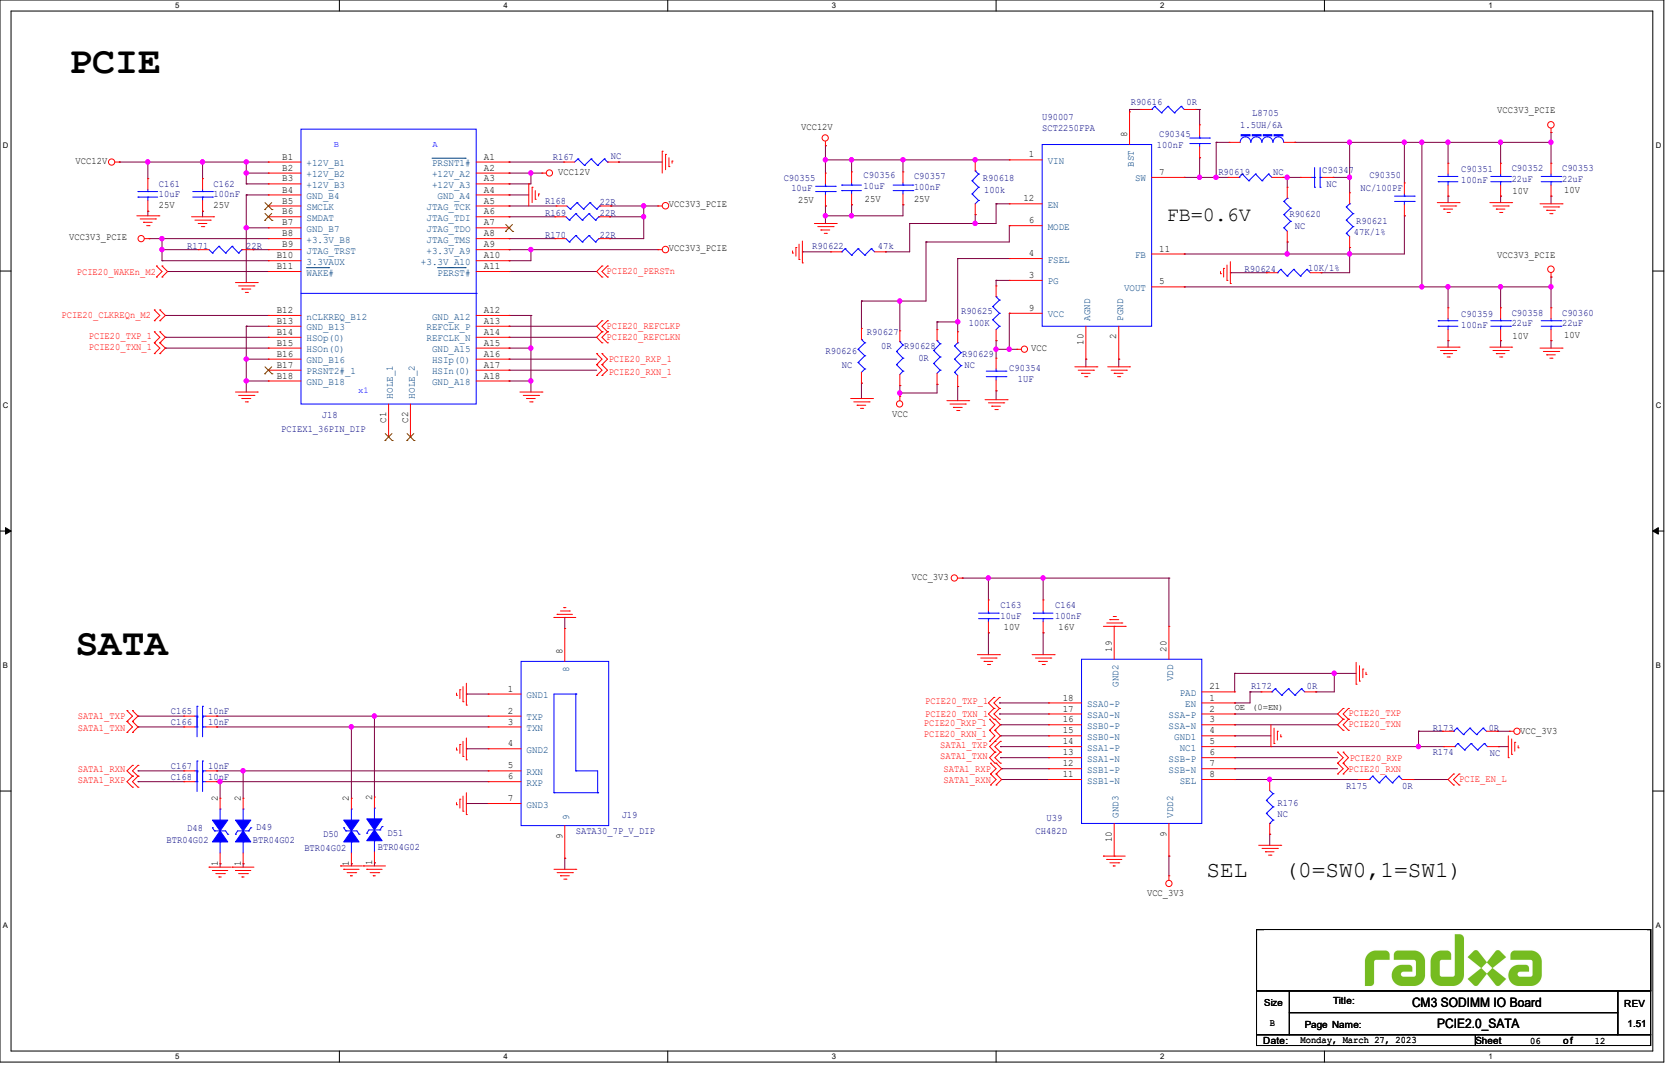
[picture p89: page 6]

# USB OTG

## VBUS

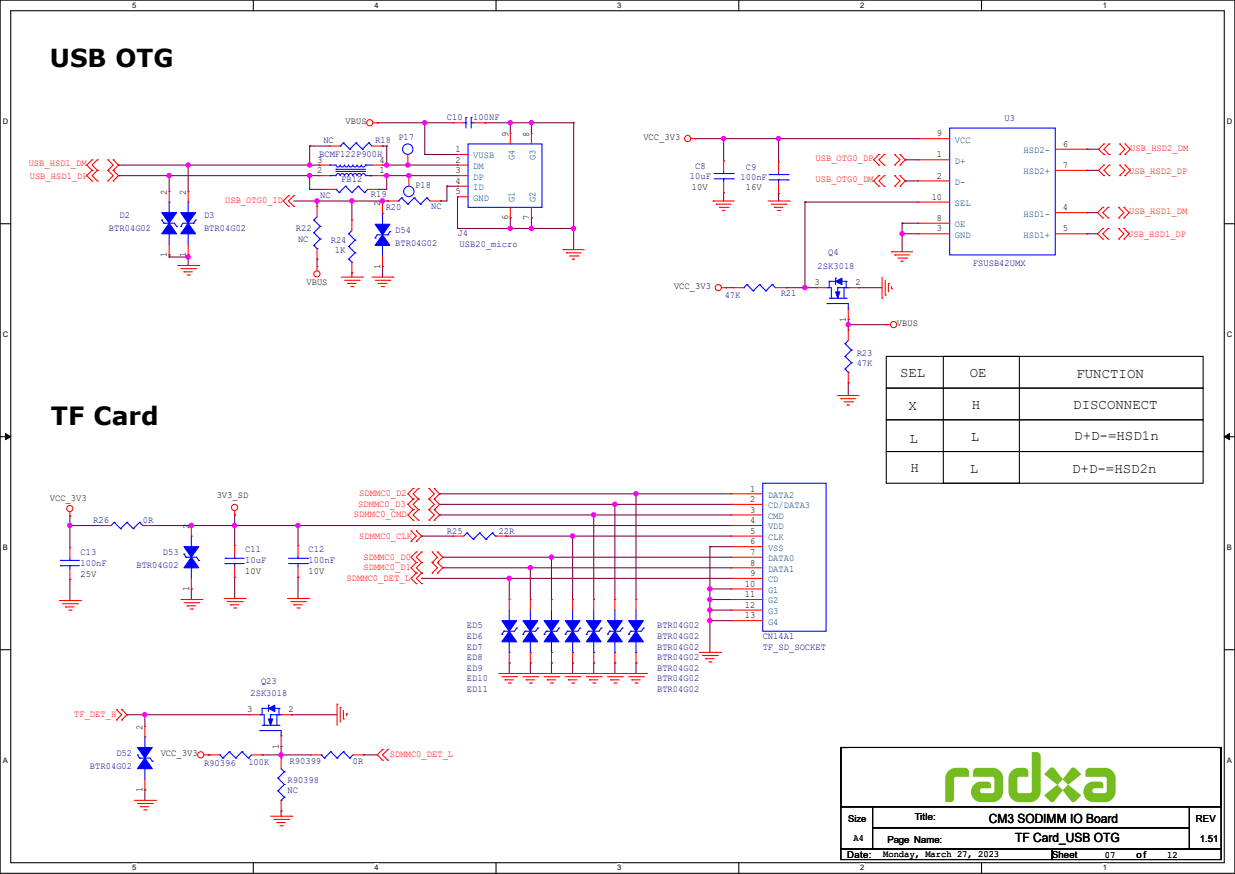
[picture p90: page 7]

# HDMI2.0 TX

## HDMI_TX2P_PORT

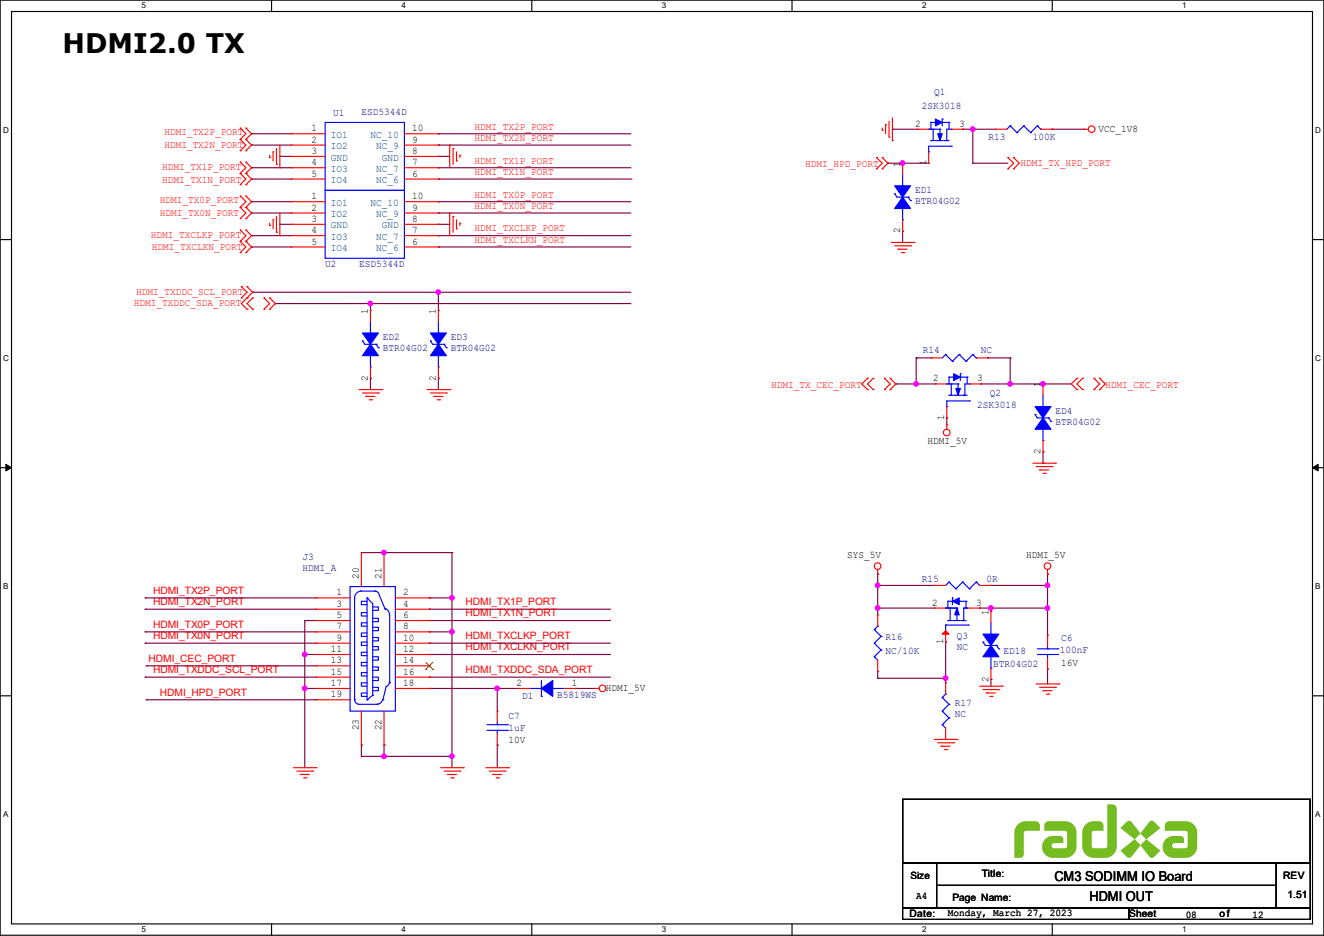
[picture p91: page 8]

VCC_3V3 | 5V_OUT

## VCC_3V3

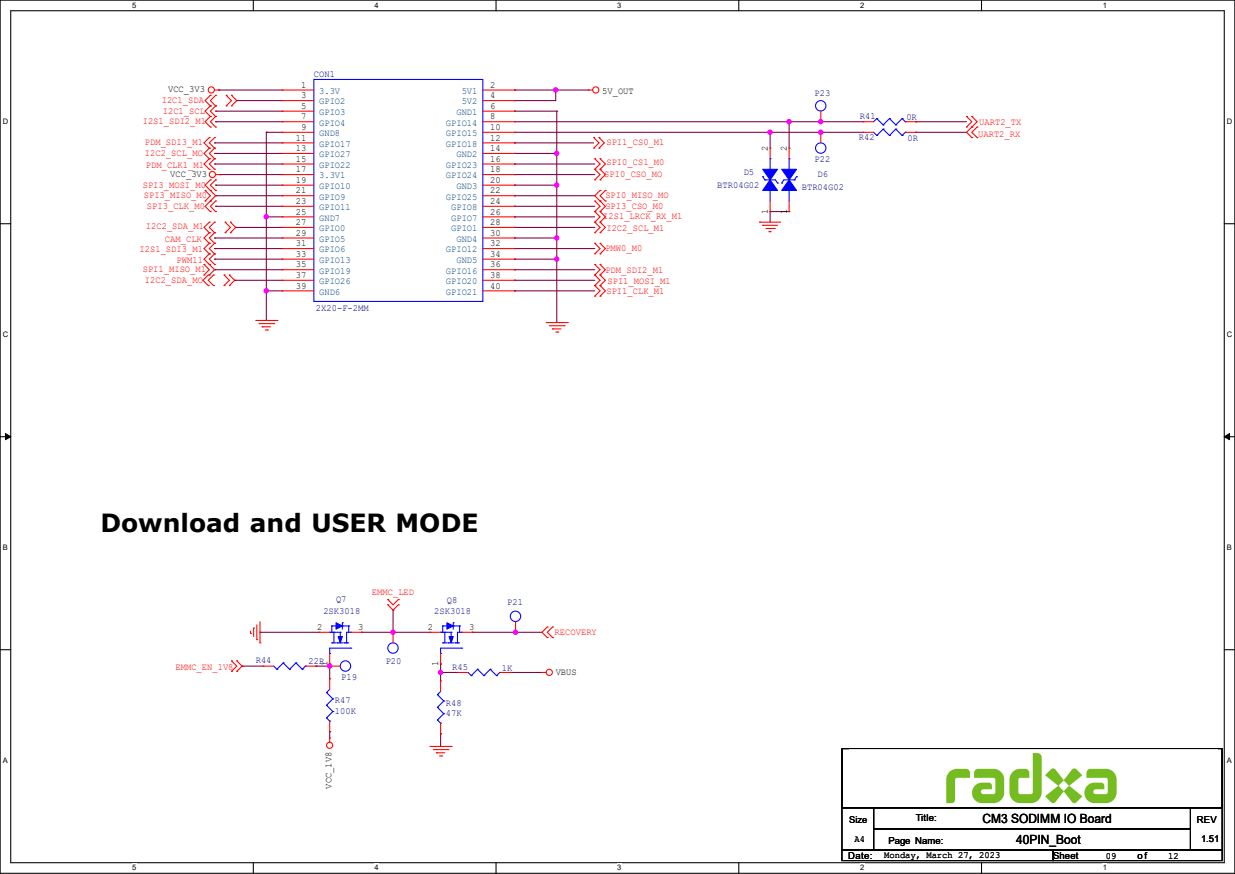
[picture p92: page 9]

Download and USER MODE

# DC 12V IN

# 1 PG

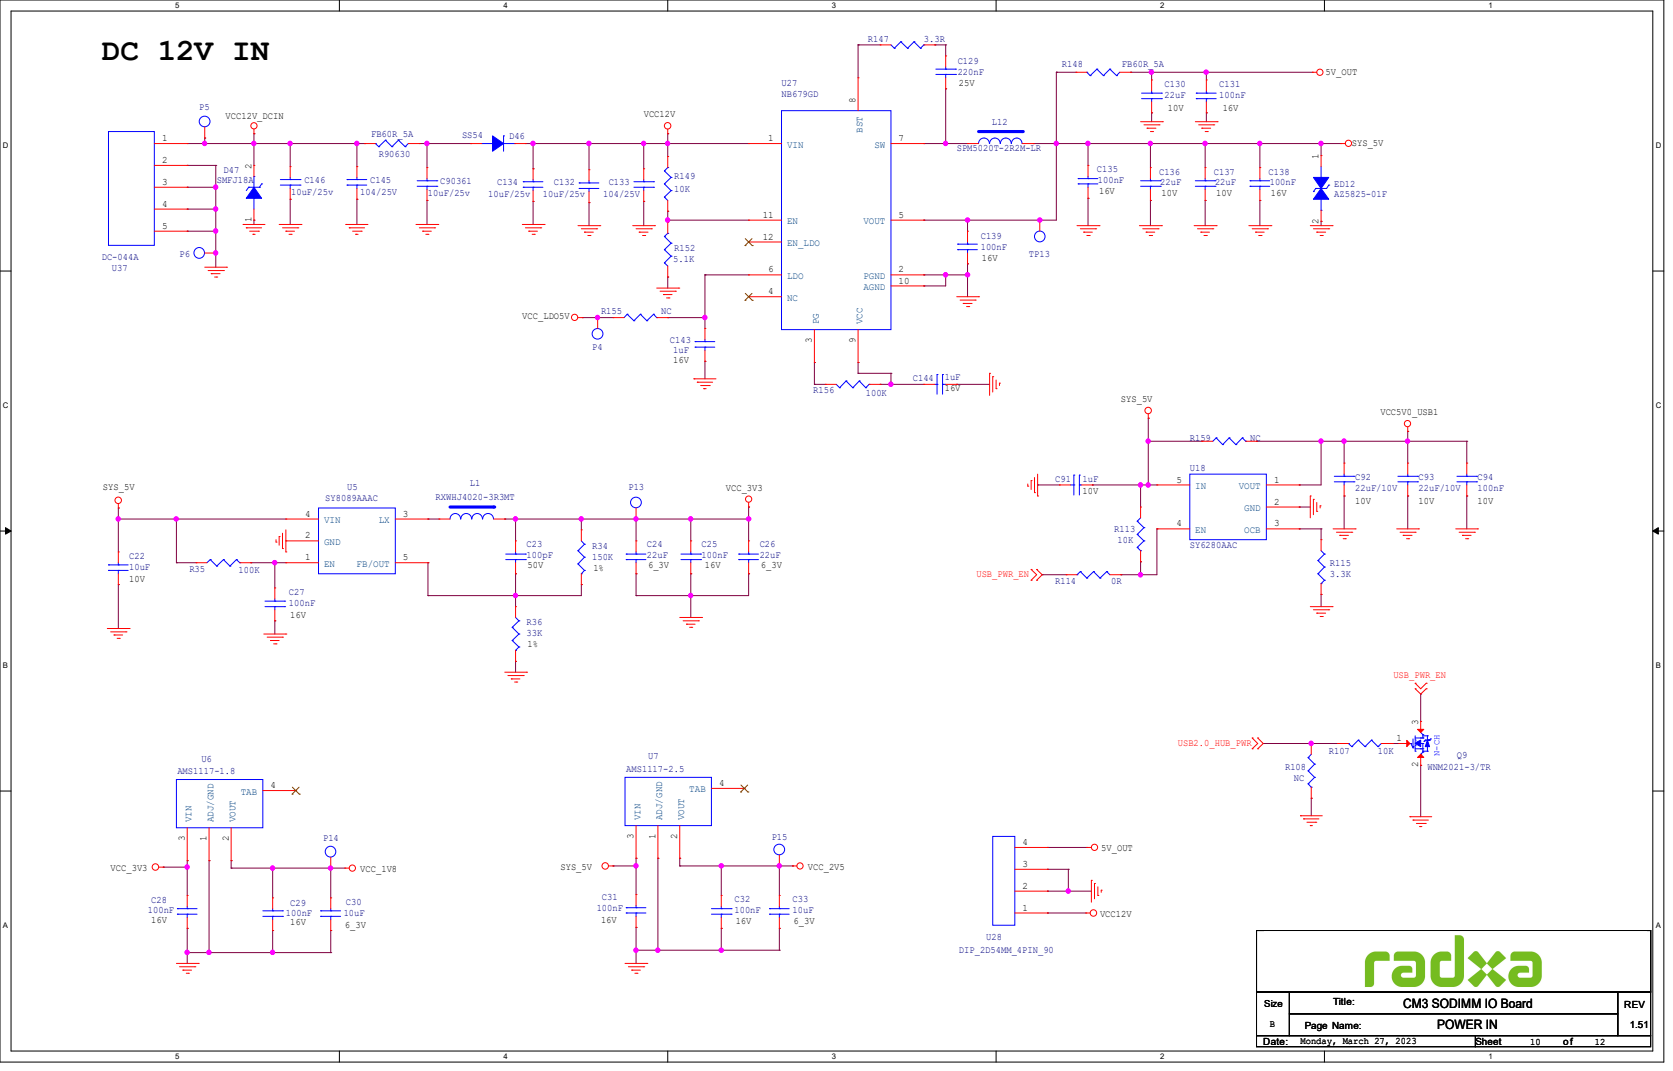
[picture p93: page 10]

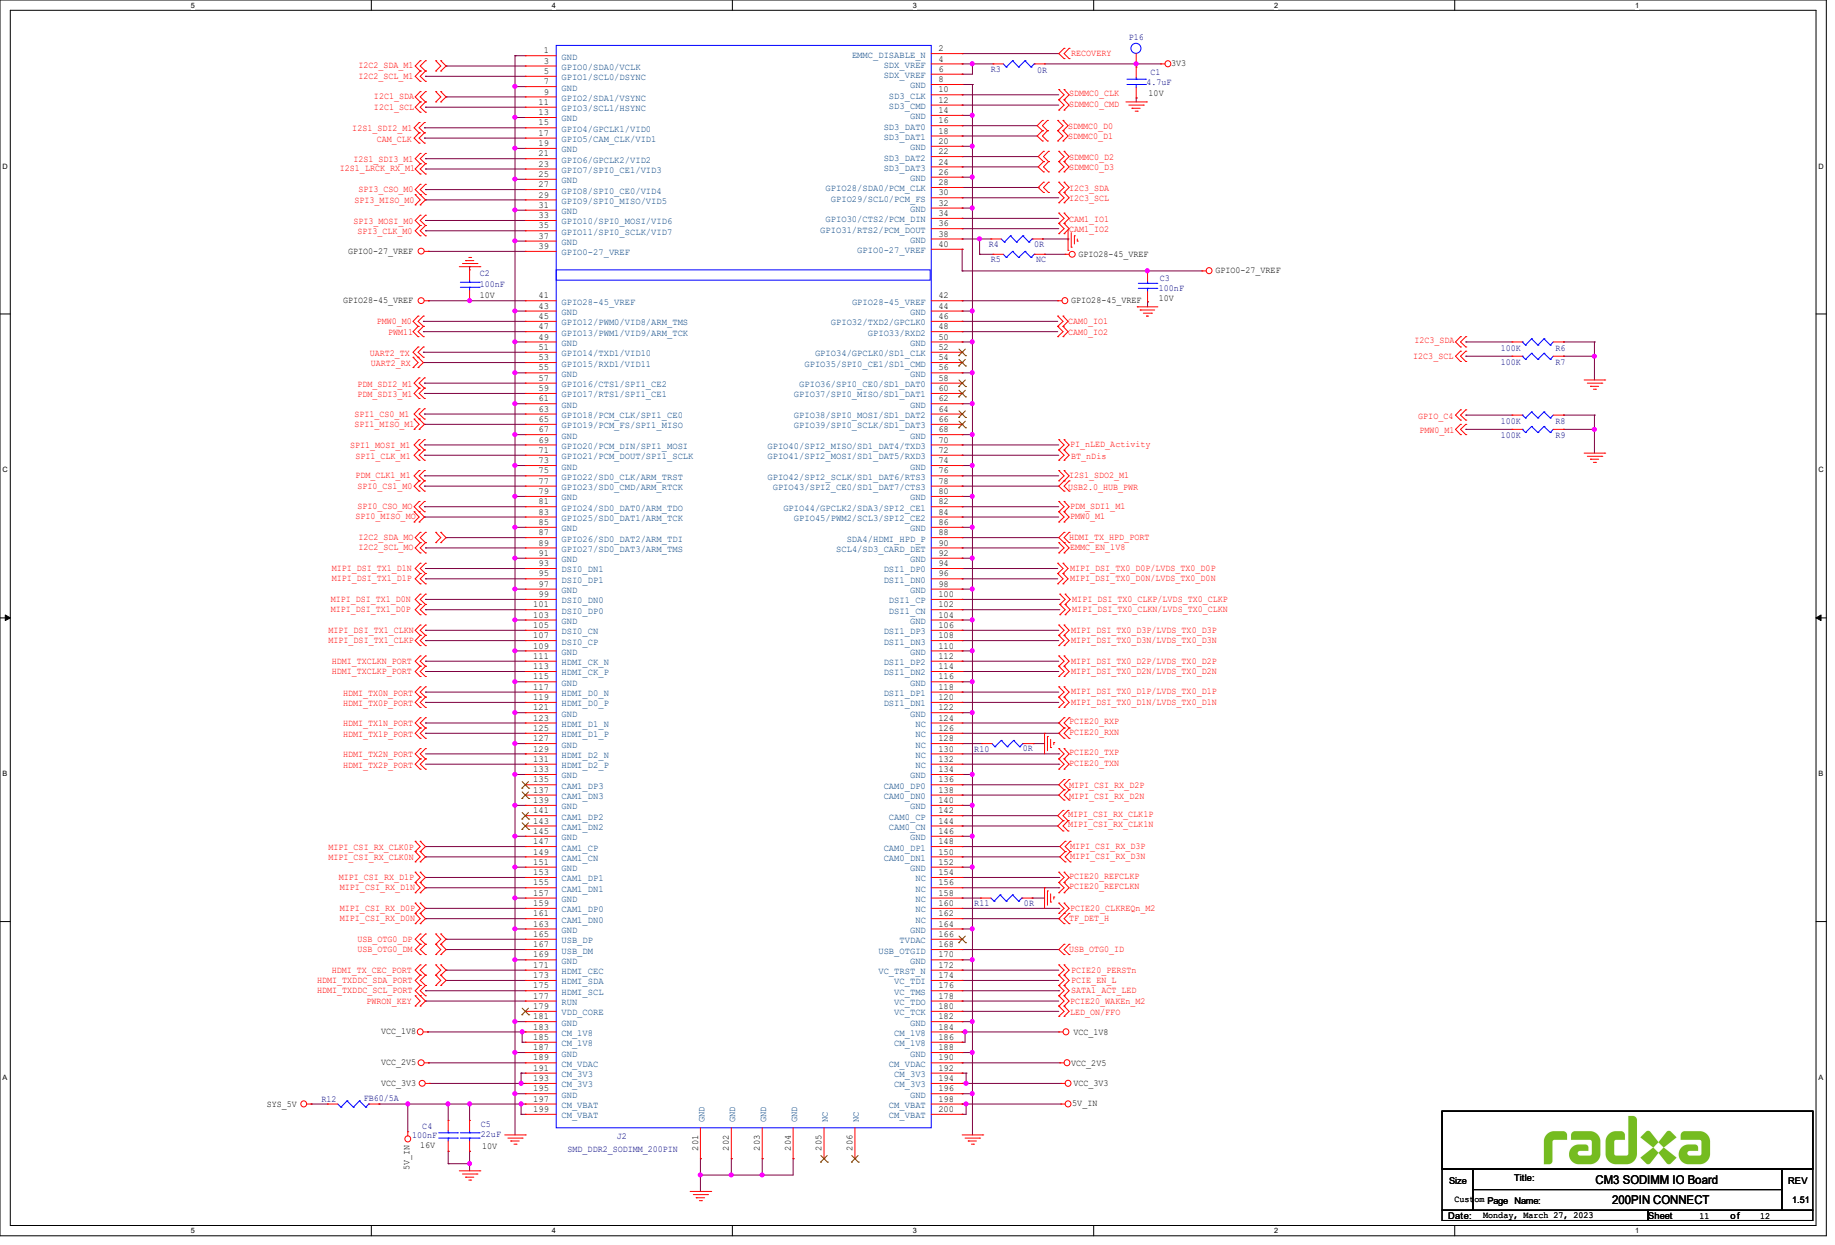
[picture p94: page 11]

200 NC 206 NC 205 GND 204 GND 203 GND 202 GND 201

## VCC_3V3

## EMMC_LED

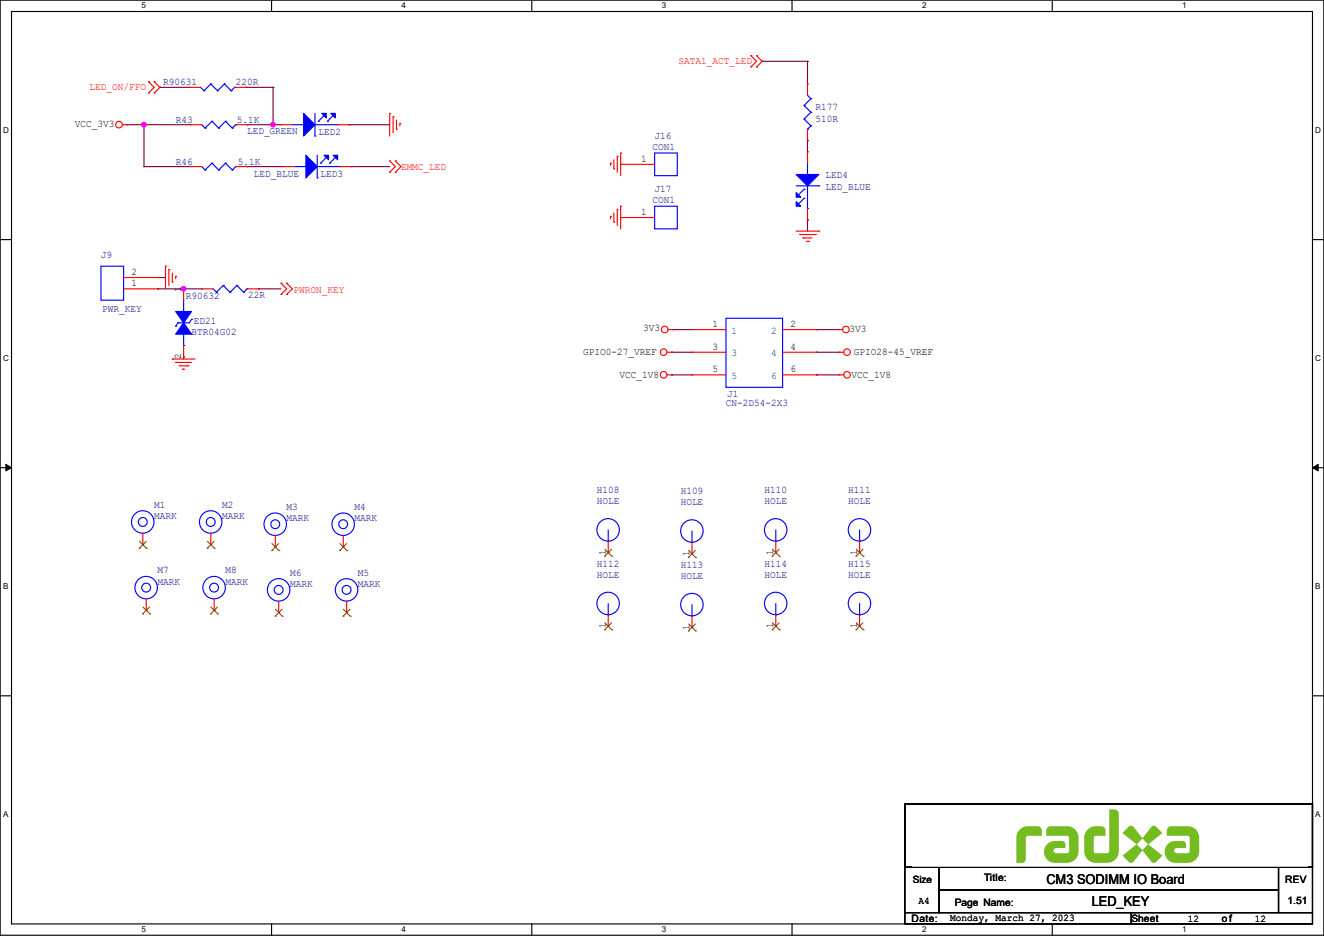
[picture p95: page 12]
