radxa/radxa-cm-projects/cm3/radxa-cm3-io-board/radxa_cm3_io_board_components_placement_map_v1330.pdf

# 12V_DC input

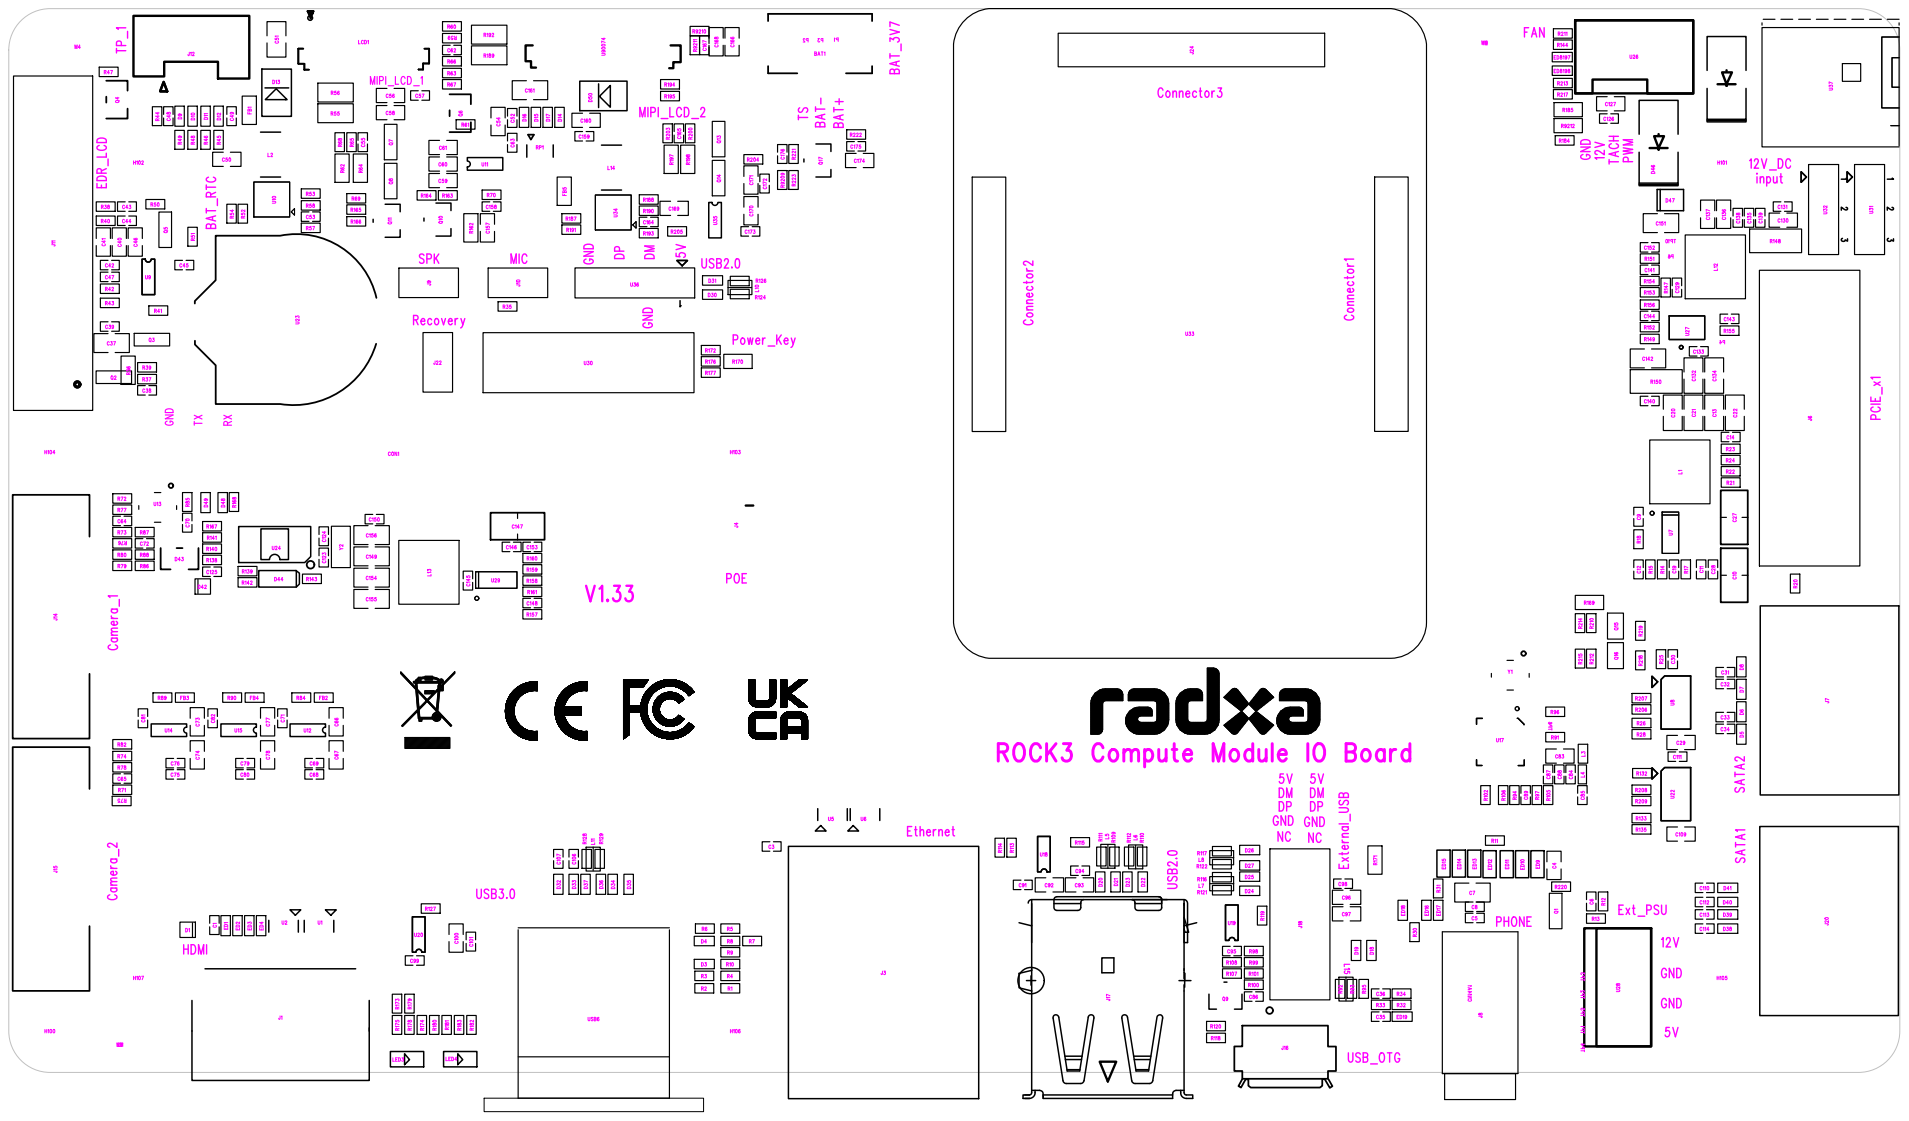
[picture p96: page 1]

ROCK3 Compute Module IO Board

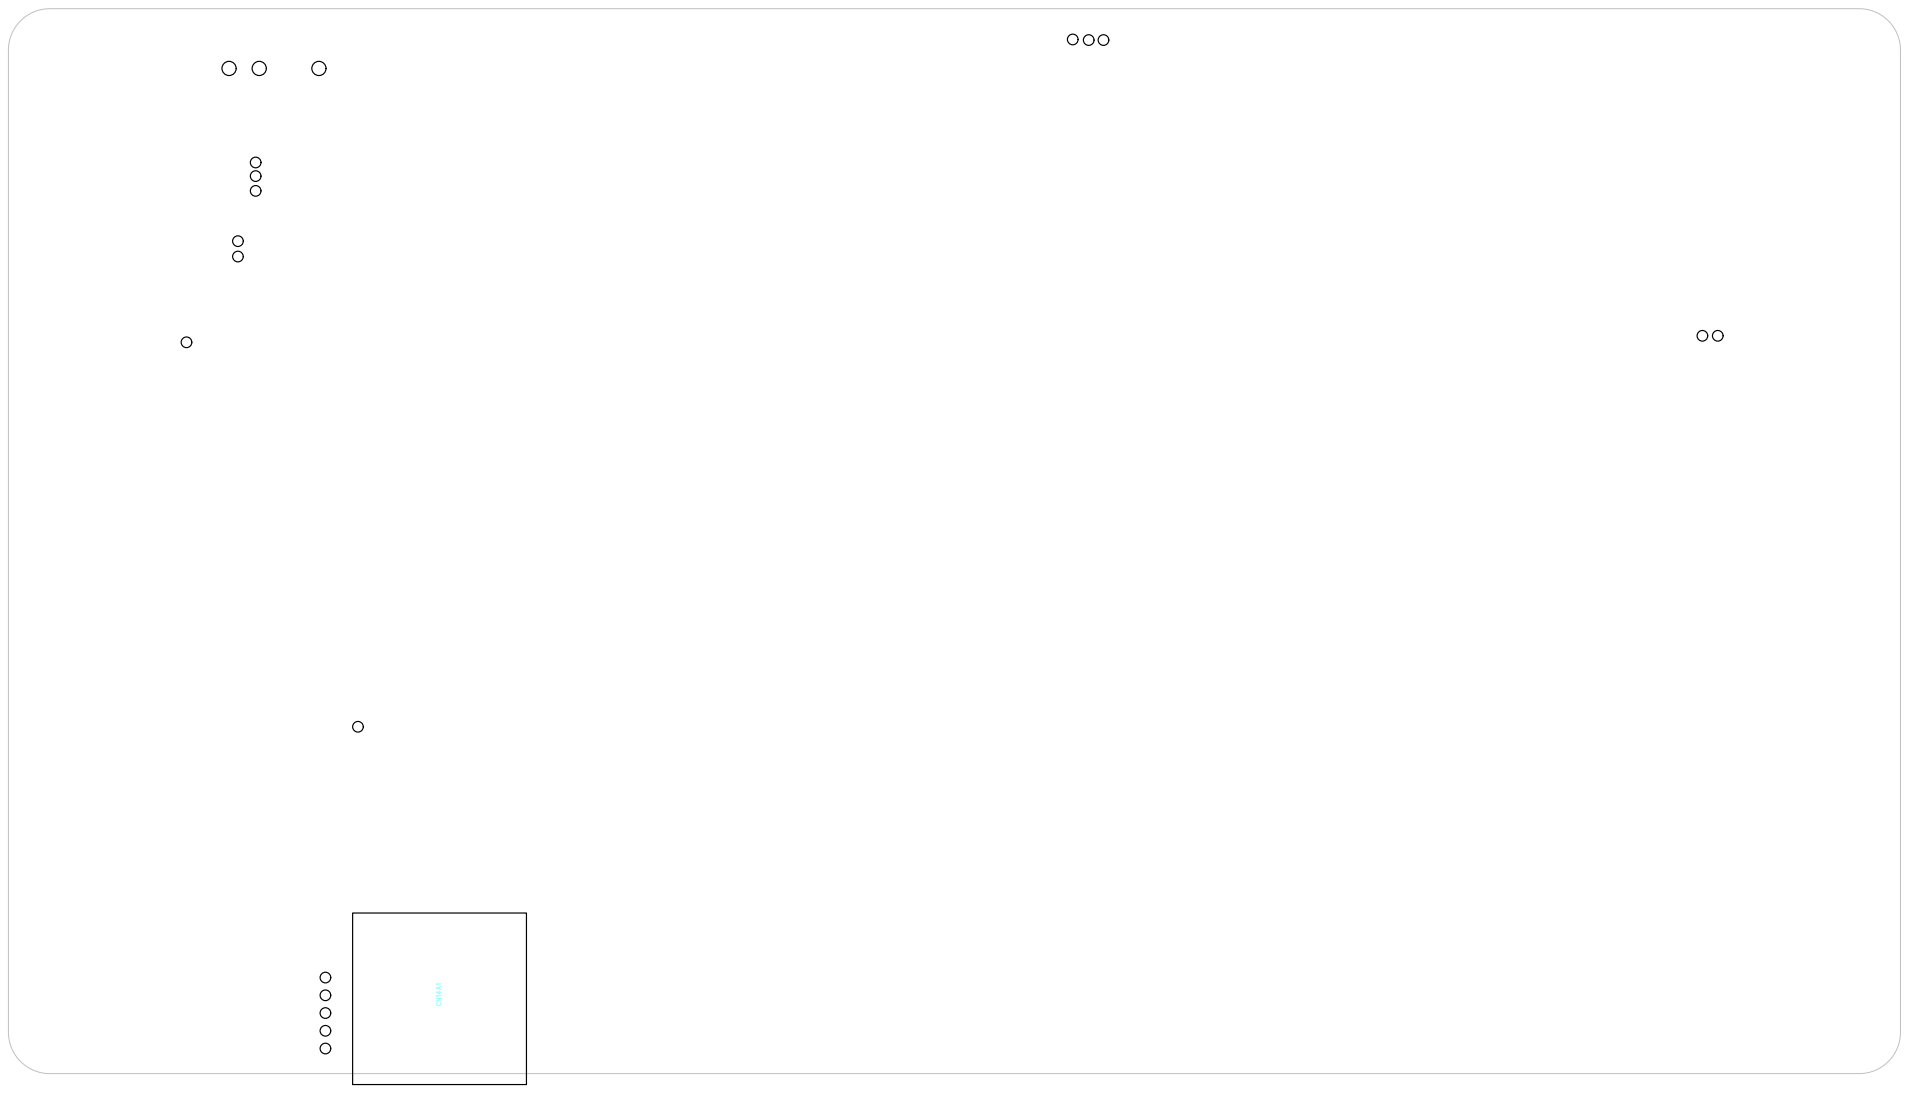
[picture p97: page 2]
