radxa/radxa-cm-projects/cm3/radxa-cm3-io-board/radxa_cm3_io_board_v1330_schematic.pdf

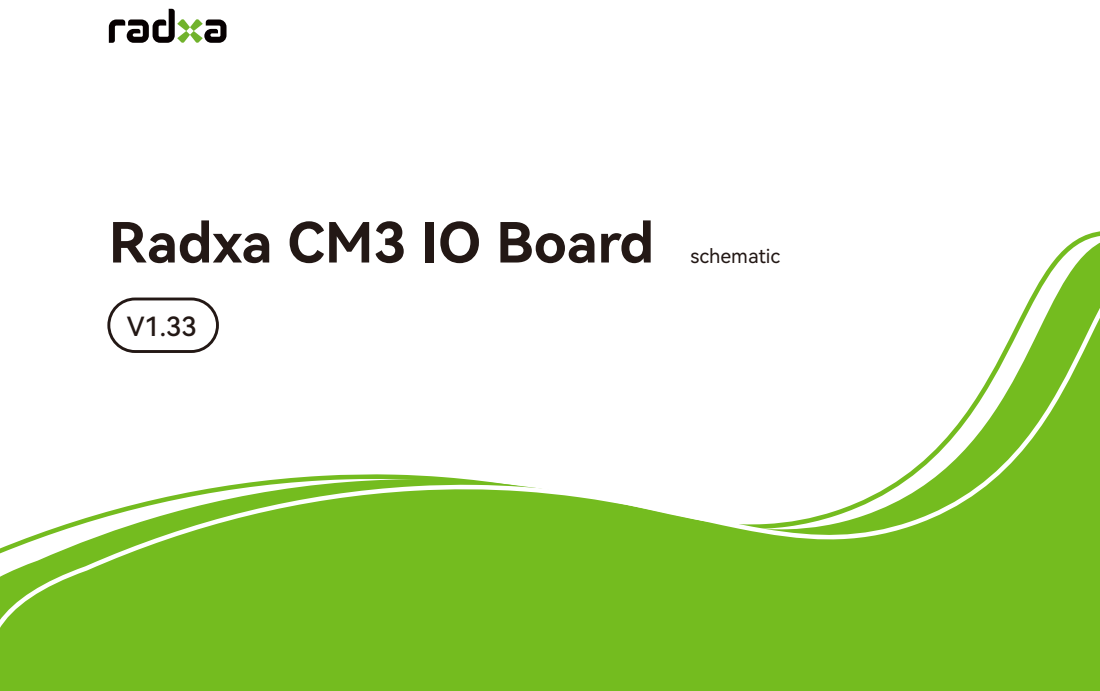
[picture p98: page 1]
schematic

Radxa CM3 IO Board

# 01.cover 02.Index

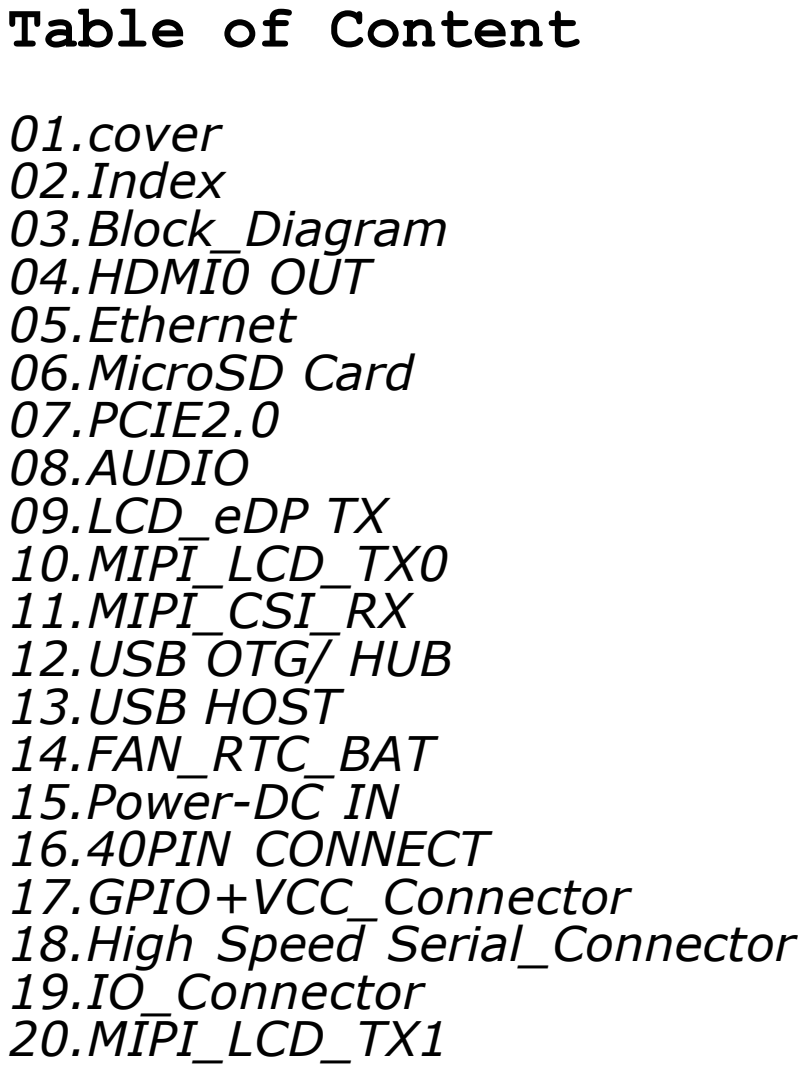
[picture p99: page 2]
03.Block_Diagram 04.HDMI0 OUT 05.Ethernet 06.MicroSD Card 07.PCIE2.0 08.AUDIO 09.LCD_eDP TX 10.MIPI_LCD_TX0 11.MIPI_CSI_RX 12.USB OTG/ HUB 13.USB HOST 14.FAN_RTC_BAT 15.Power-DC IN 16.40PIN CONNECT 17.GPIO+VCC_Connector 18.High Speed Serial_Connector 19.IO_Connector 20.MIPI_LCD_TX1; Size; REV; Date:; Sheet; Title:; Page Name:; Index; Tuesday, February 14, 2023

Table of Content

ROCK3 Compute Module IO Board A4

# 12V_OUT 5V_OUT

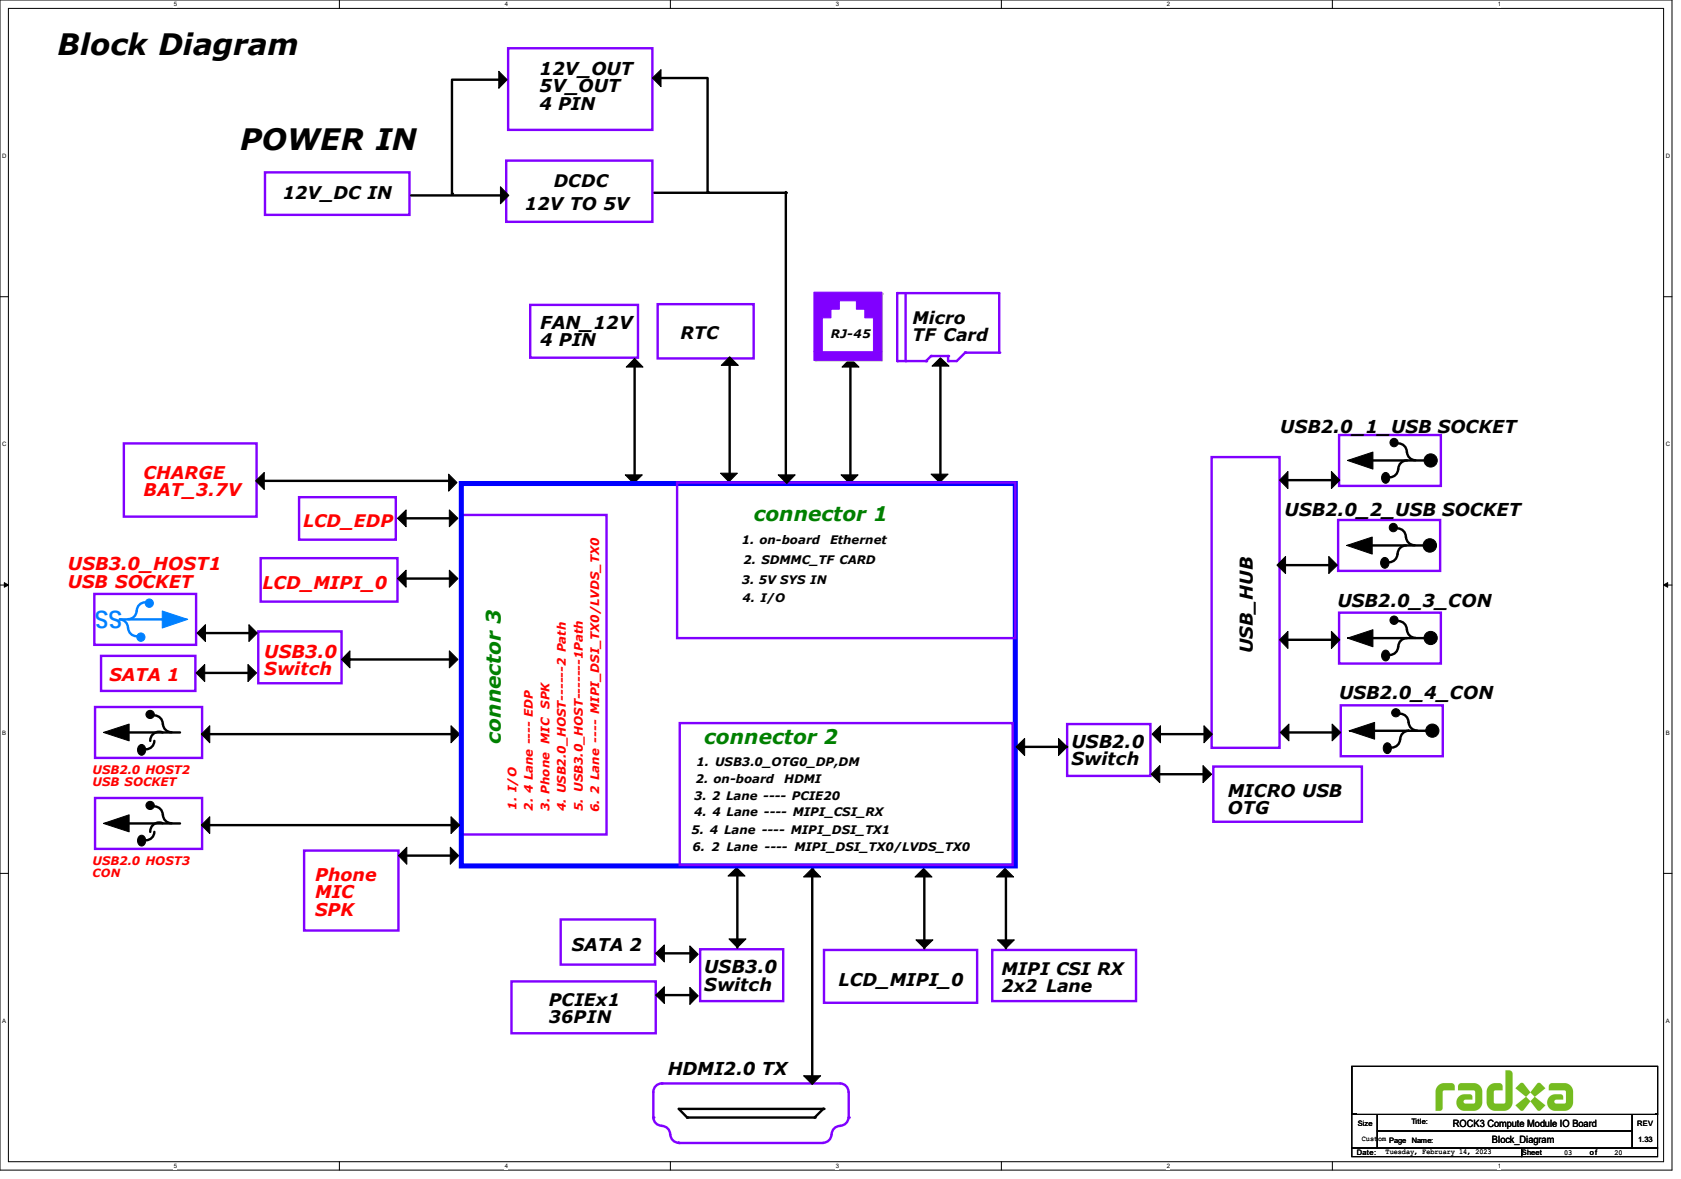
[picture p100: page 3]
A A USB_HUB; USB2.0_2_USB SOCKET; HDMI2.0 TX; SATA 2; PCIEx1 36PIN; FAN_12V 4 PIN; 4 PIN; RTC; USB2.0_3_CON; USB2.0_4_CON; USB2.0_1_USB SOCKET 1. I/O 2. 4 Lane ⁻⁻⁻⁻ EDP; 4. USB2.0_HOST⁻⁻⁻⁻⁻⁻2 Path 5. USB3.0_HOST⁻⁻⁻⁻⁻⁻⁻1Path 6. 2 Lane ⁻⁻⁻⁻ MIPI_DSI_TX⁰/LVDS_TX⁰ connector 3; 3. Phone MIC SPK; USB3.0 Switch; LCD_EDP; LCD_MIPI_0; USB3.0; SATA 1; Switch; USB3.0_HOST1 USB SOCKET; USB2.0 HOST2 USB SOCKET; Phone MIC SPK; Block Diagram; 1. USB3.0_OTG0_DP,DM; 4. 4 Lane ---- MIPI_CSI_RX; connector 1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

1. on-board Ethernet
2. SDMMC_TF CARD
3. 5V SYS IN

MIPI CSI RX
2x2 Lane

# HDMI2.0 TX

## HDMI_TX2P_PORT

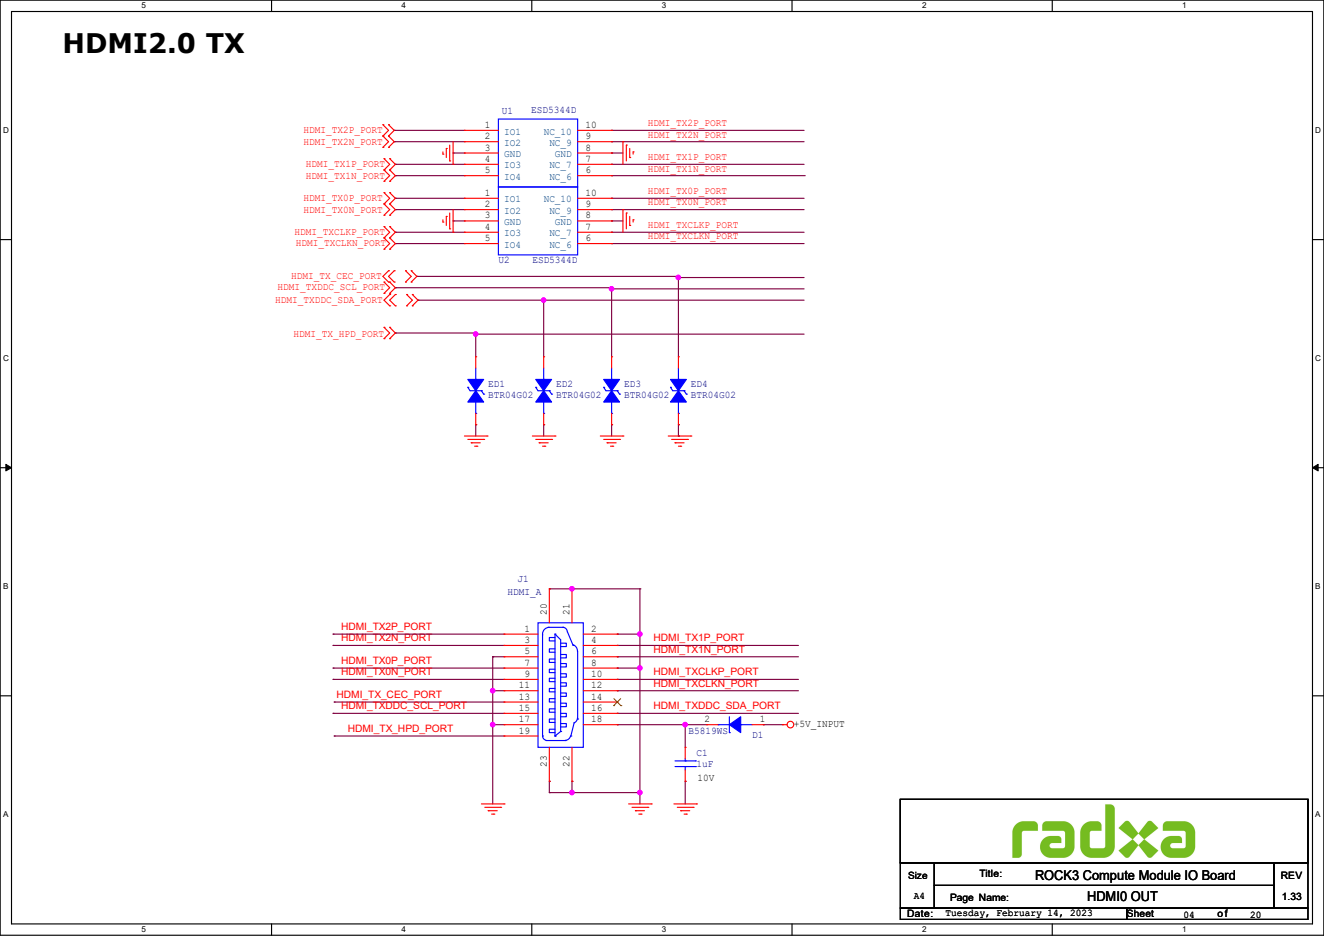
[picture p101: page 4]
HDMI_TX1P_PORT; HDMI_TX0P_PORT; HDMI_TXCLKP_PORT; HDMI_TX2N_PORT; HDMI_TX1N_PORT; HDMI_TX0N_PORT; HDMI_TXCLKN_PORT; HDMI_TX_HPD_PORT; HDMI_TX_CEC_PORT; HDMI_TXDDC_SDA_PORT; HDMI_TX2P_PORT; HDMI_TXDDC_SCL_PORT; +5V_INPUT; Page Name:; HDMI0 OUT; Tuesday, February 14, 2023; ESD5344D; GND; ED2 BTR04G02; ED4 BTR04G02; ED3 BTR04G02; ED1 BTR04G02; J1 HDMI_A

## PHY1_MDI2-

## PHY1_MDI2+

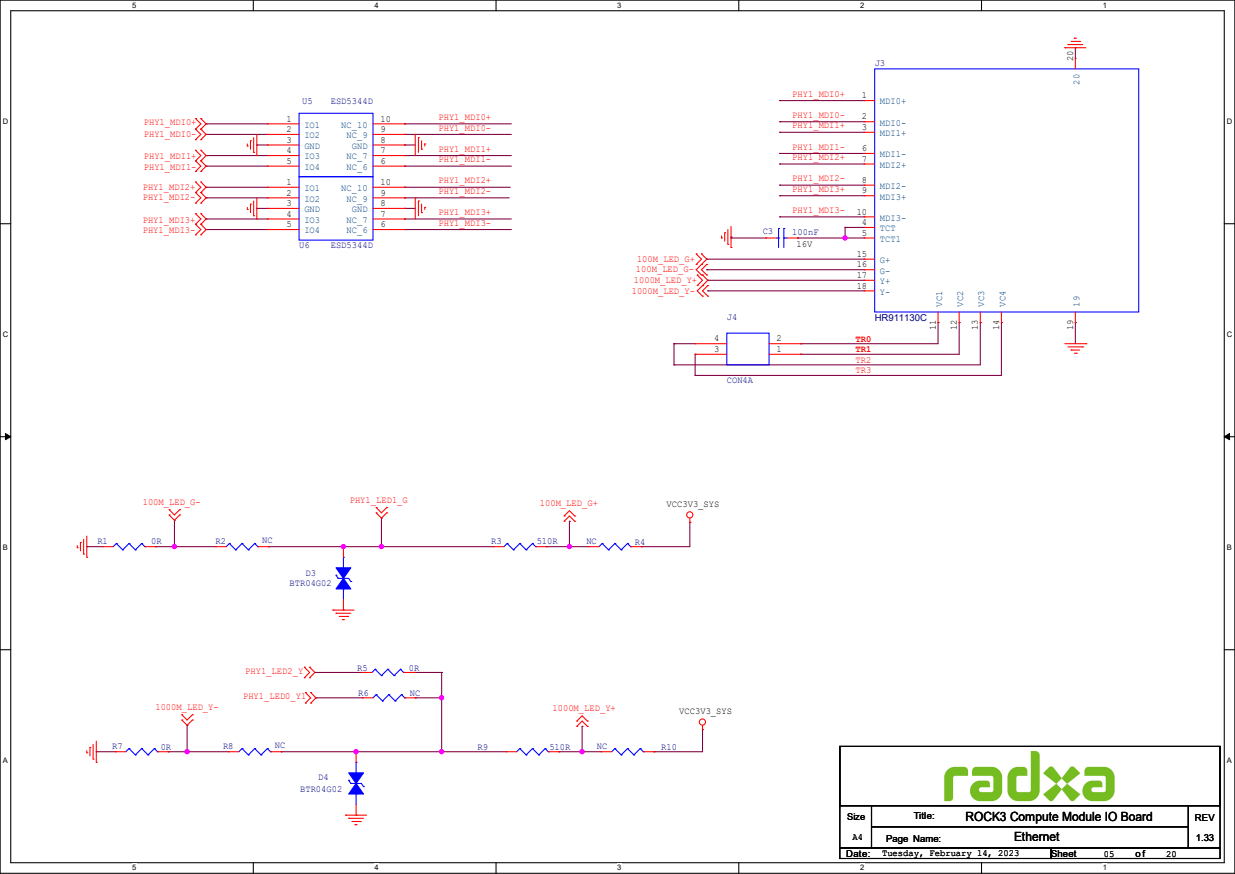
[picture p102: page 5]

# MicroSD Card

## VCC3V3_SD_1

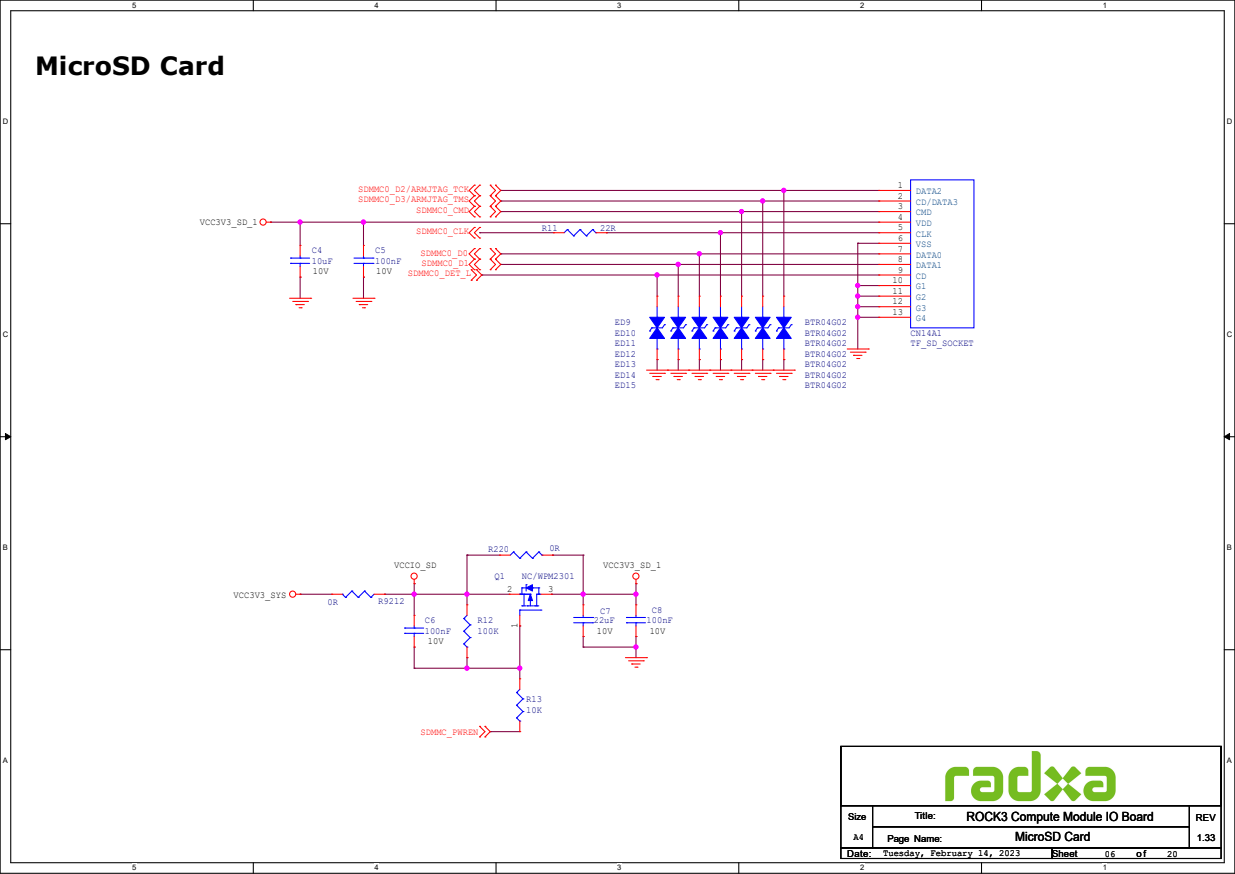
[picture p103: page 6]

## Default 3.39V

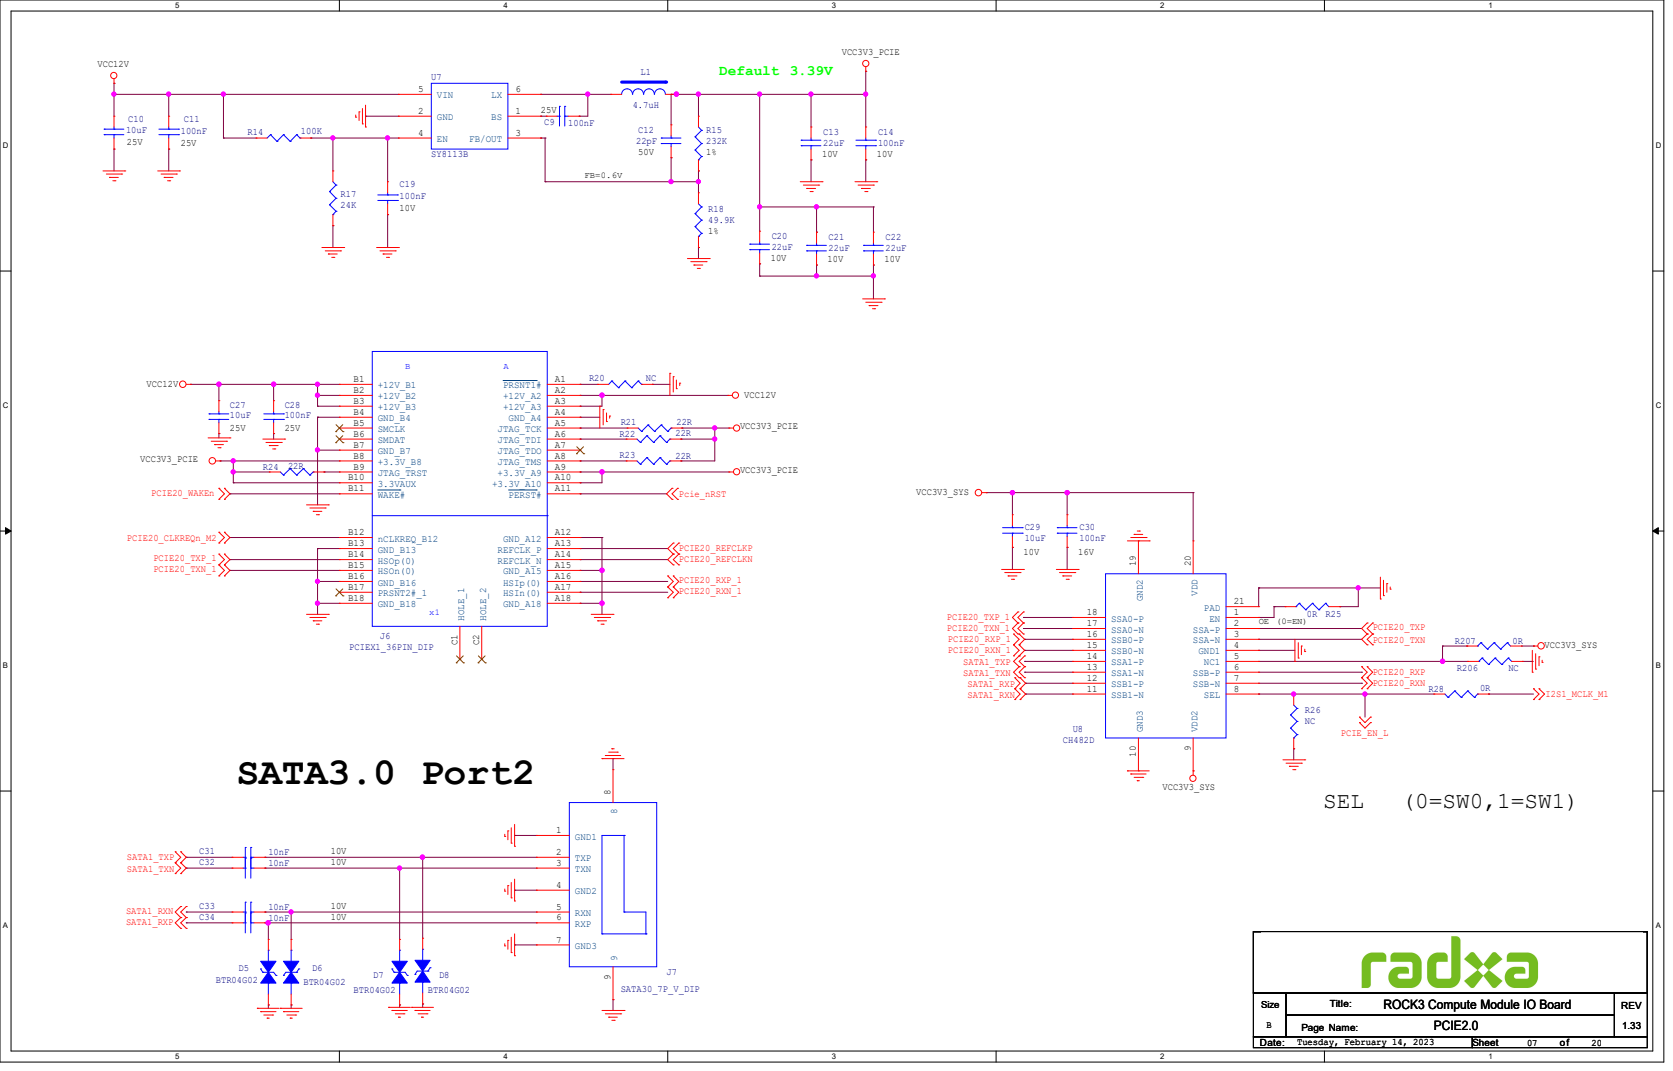
[picture p104: page 7]

TP2
TP3 | TP4 | TP5

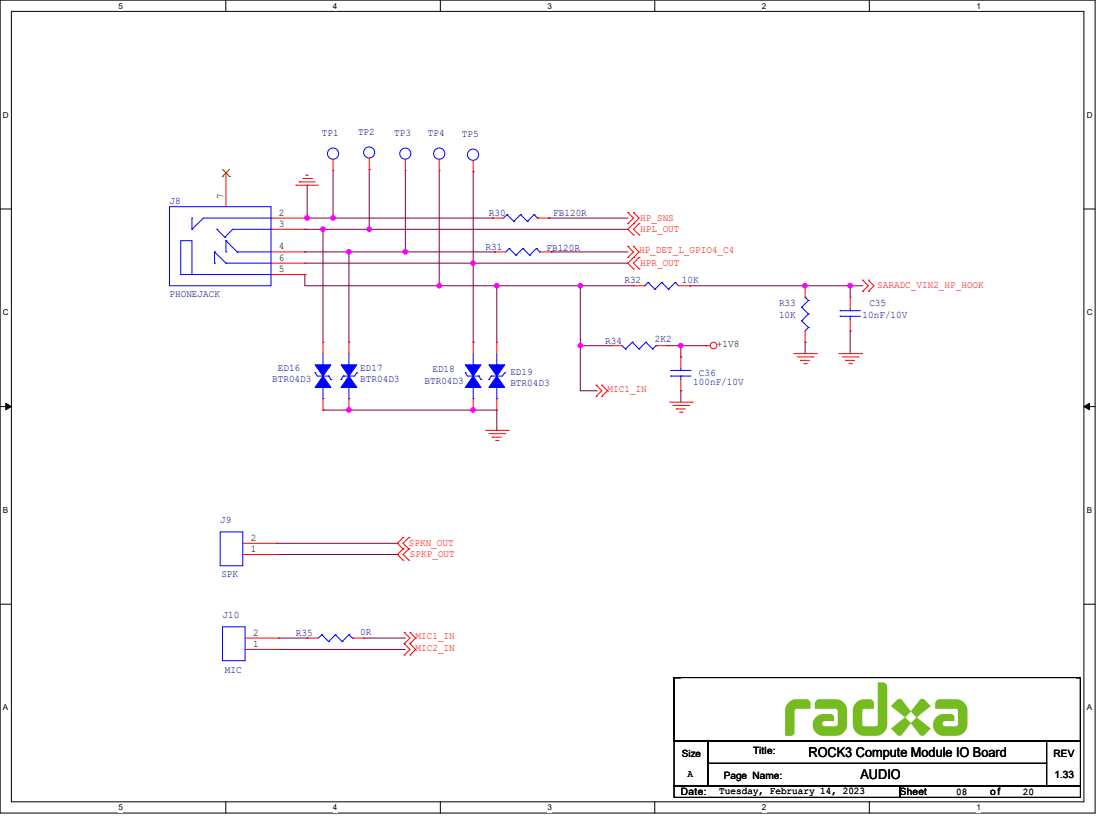
[picture p105: page 8]

ROCK3 Compute Module IO Board A

# Single-eDP LCM

## EDPTX_AUXP

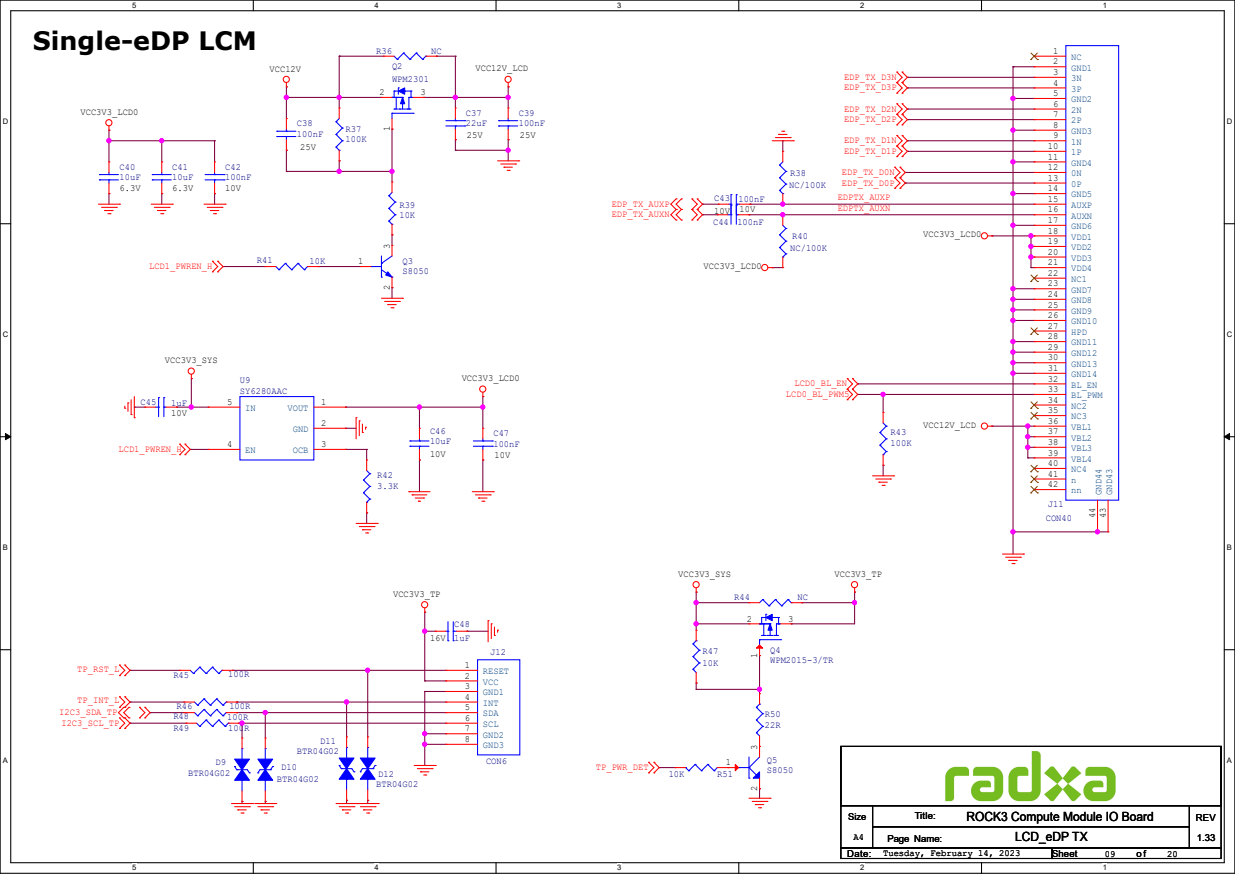
[picture p106: page 9]

# MIPI_LCD_TX0

VCC5V0_USB | VCC_LEDA1

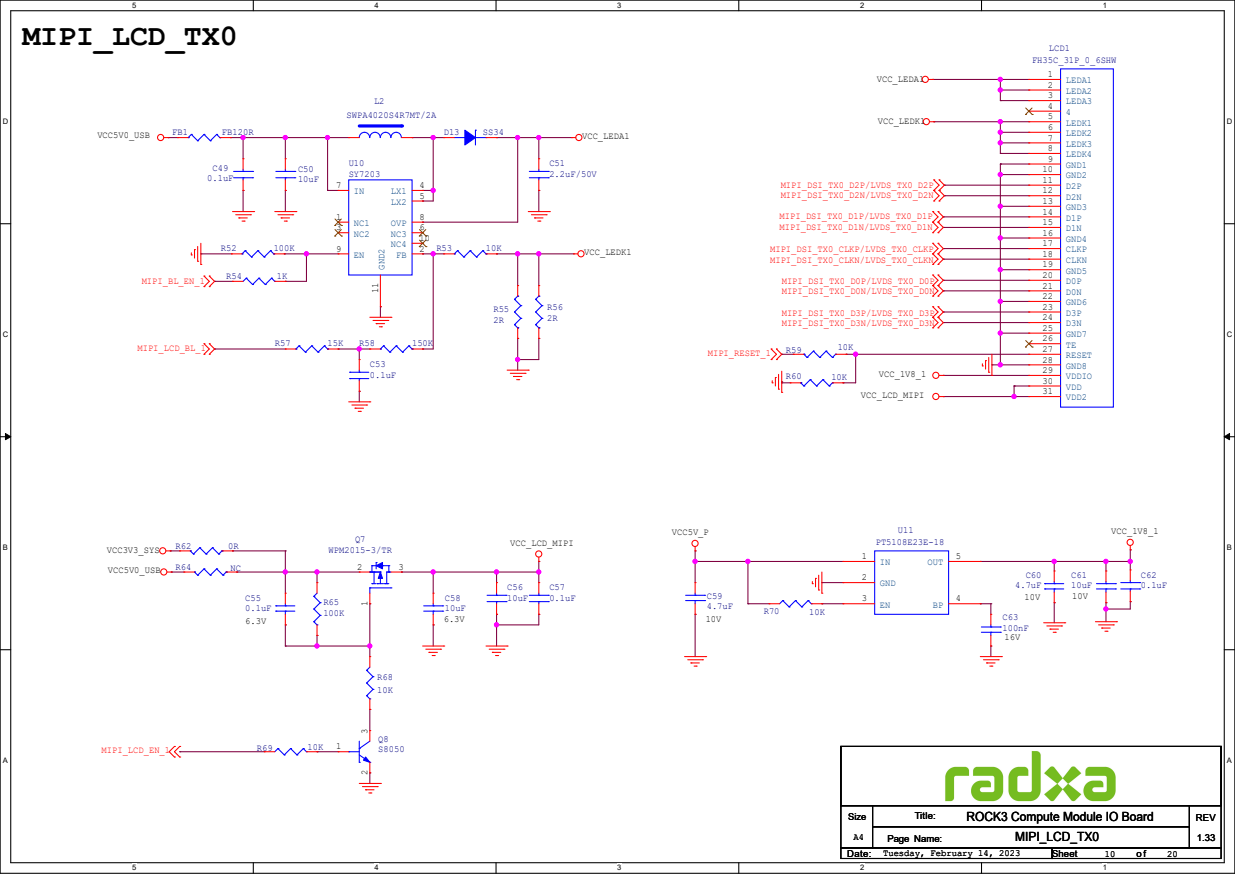
[picture p107: page 10]

MIPI_CSI_RX 2Lanes | MIPI_CSI_RX 2Lanes

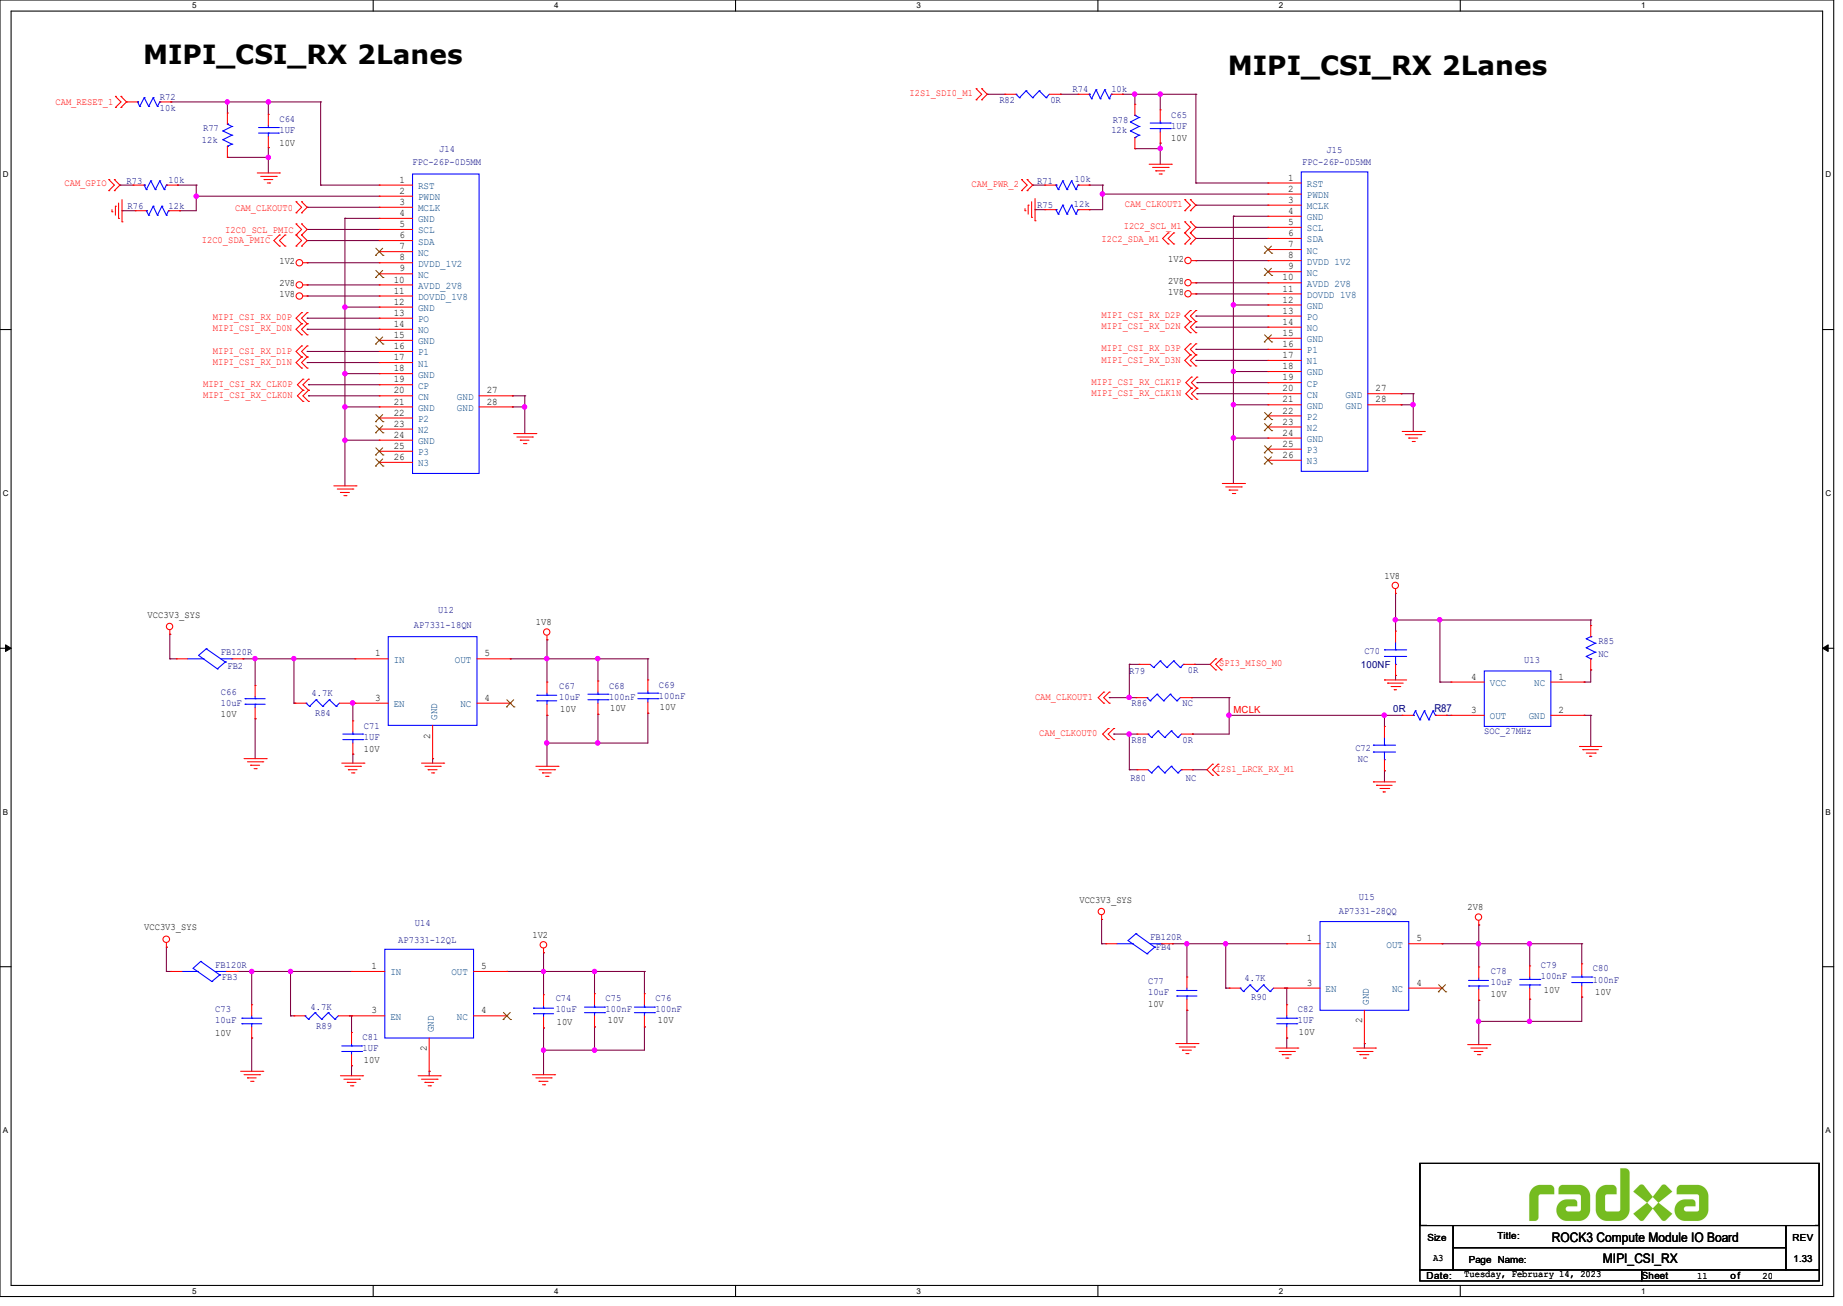
[picture p108: page 11]

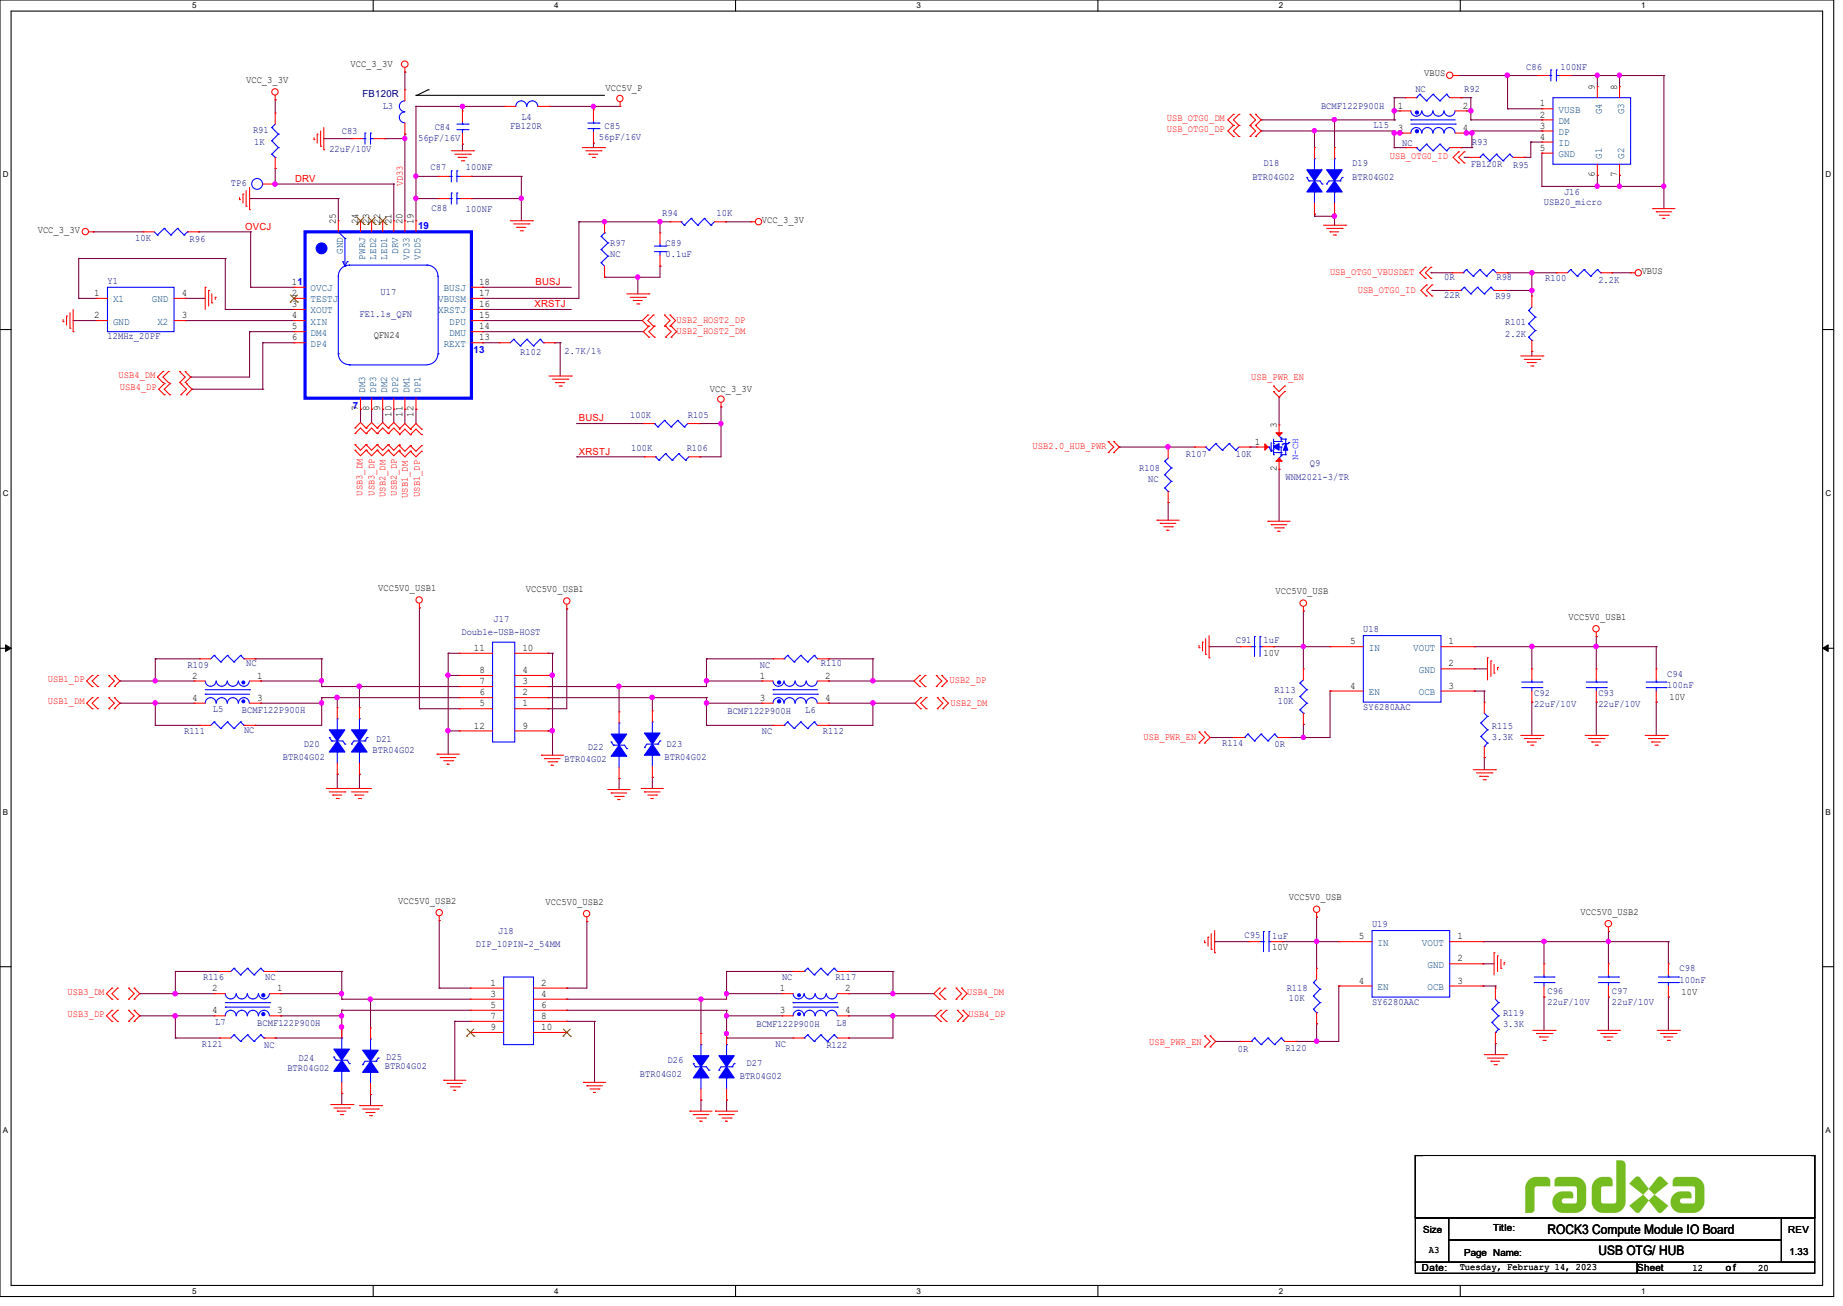
[picture p109: page 12]

# 9 SHELL1 10 SHELL2 11

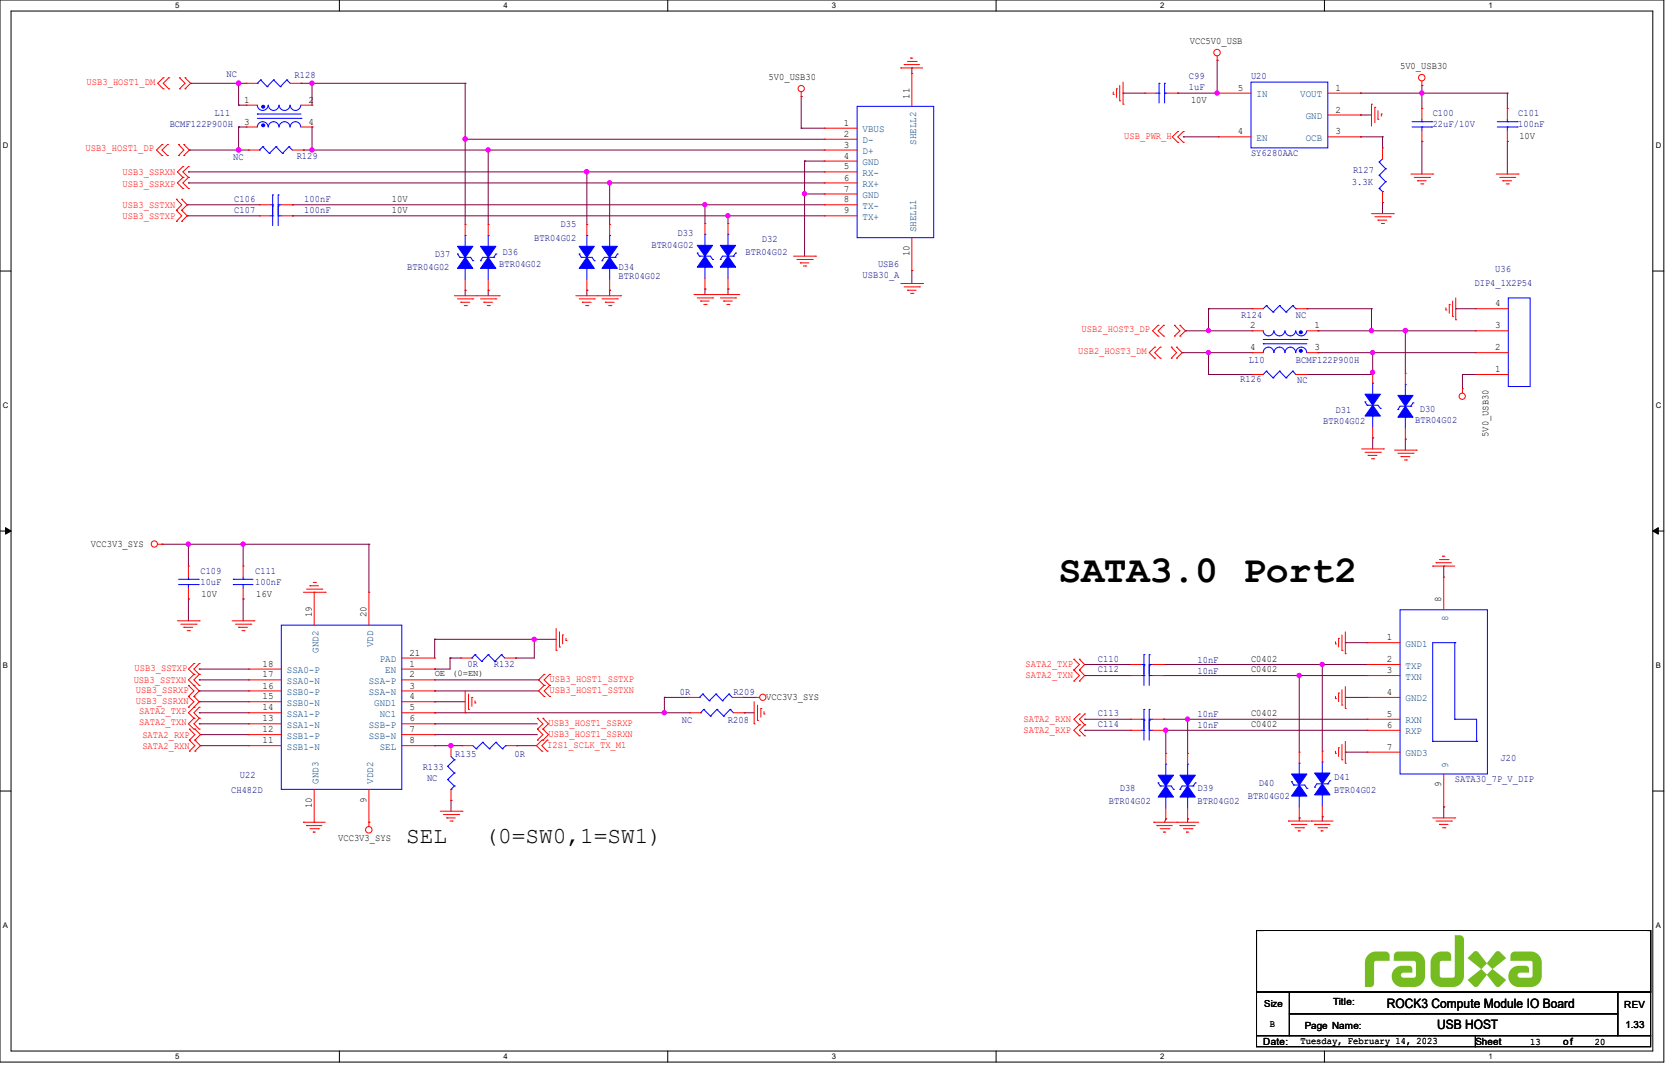
[picture p110: page 13]

## RTC_BATTERY

## VCC_RTC

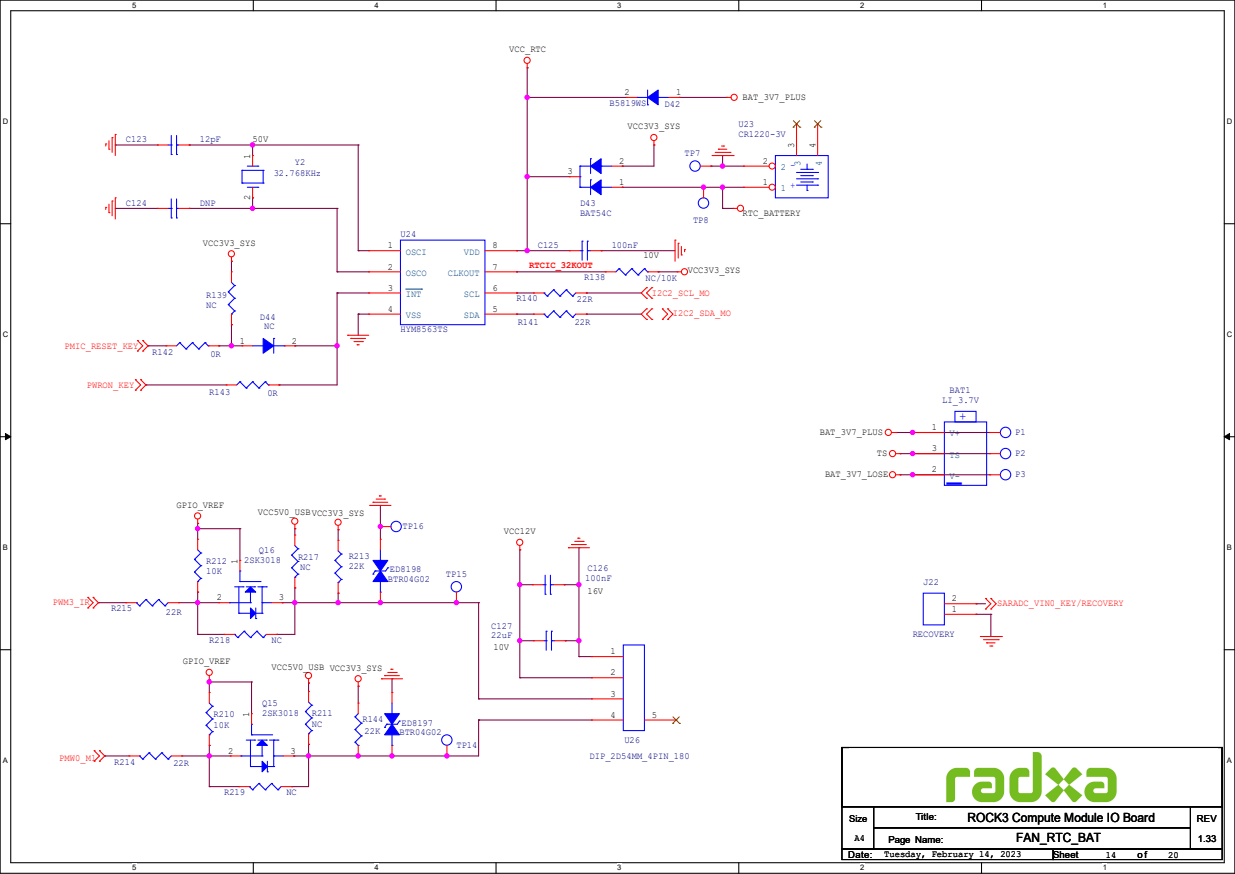
[picture p111: page 14]

# DC IN&SYSTEM Power

# 1 PG

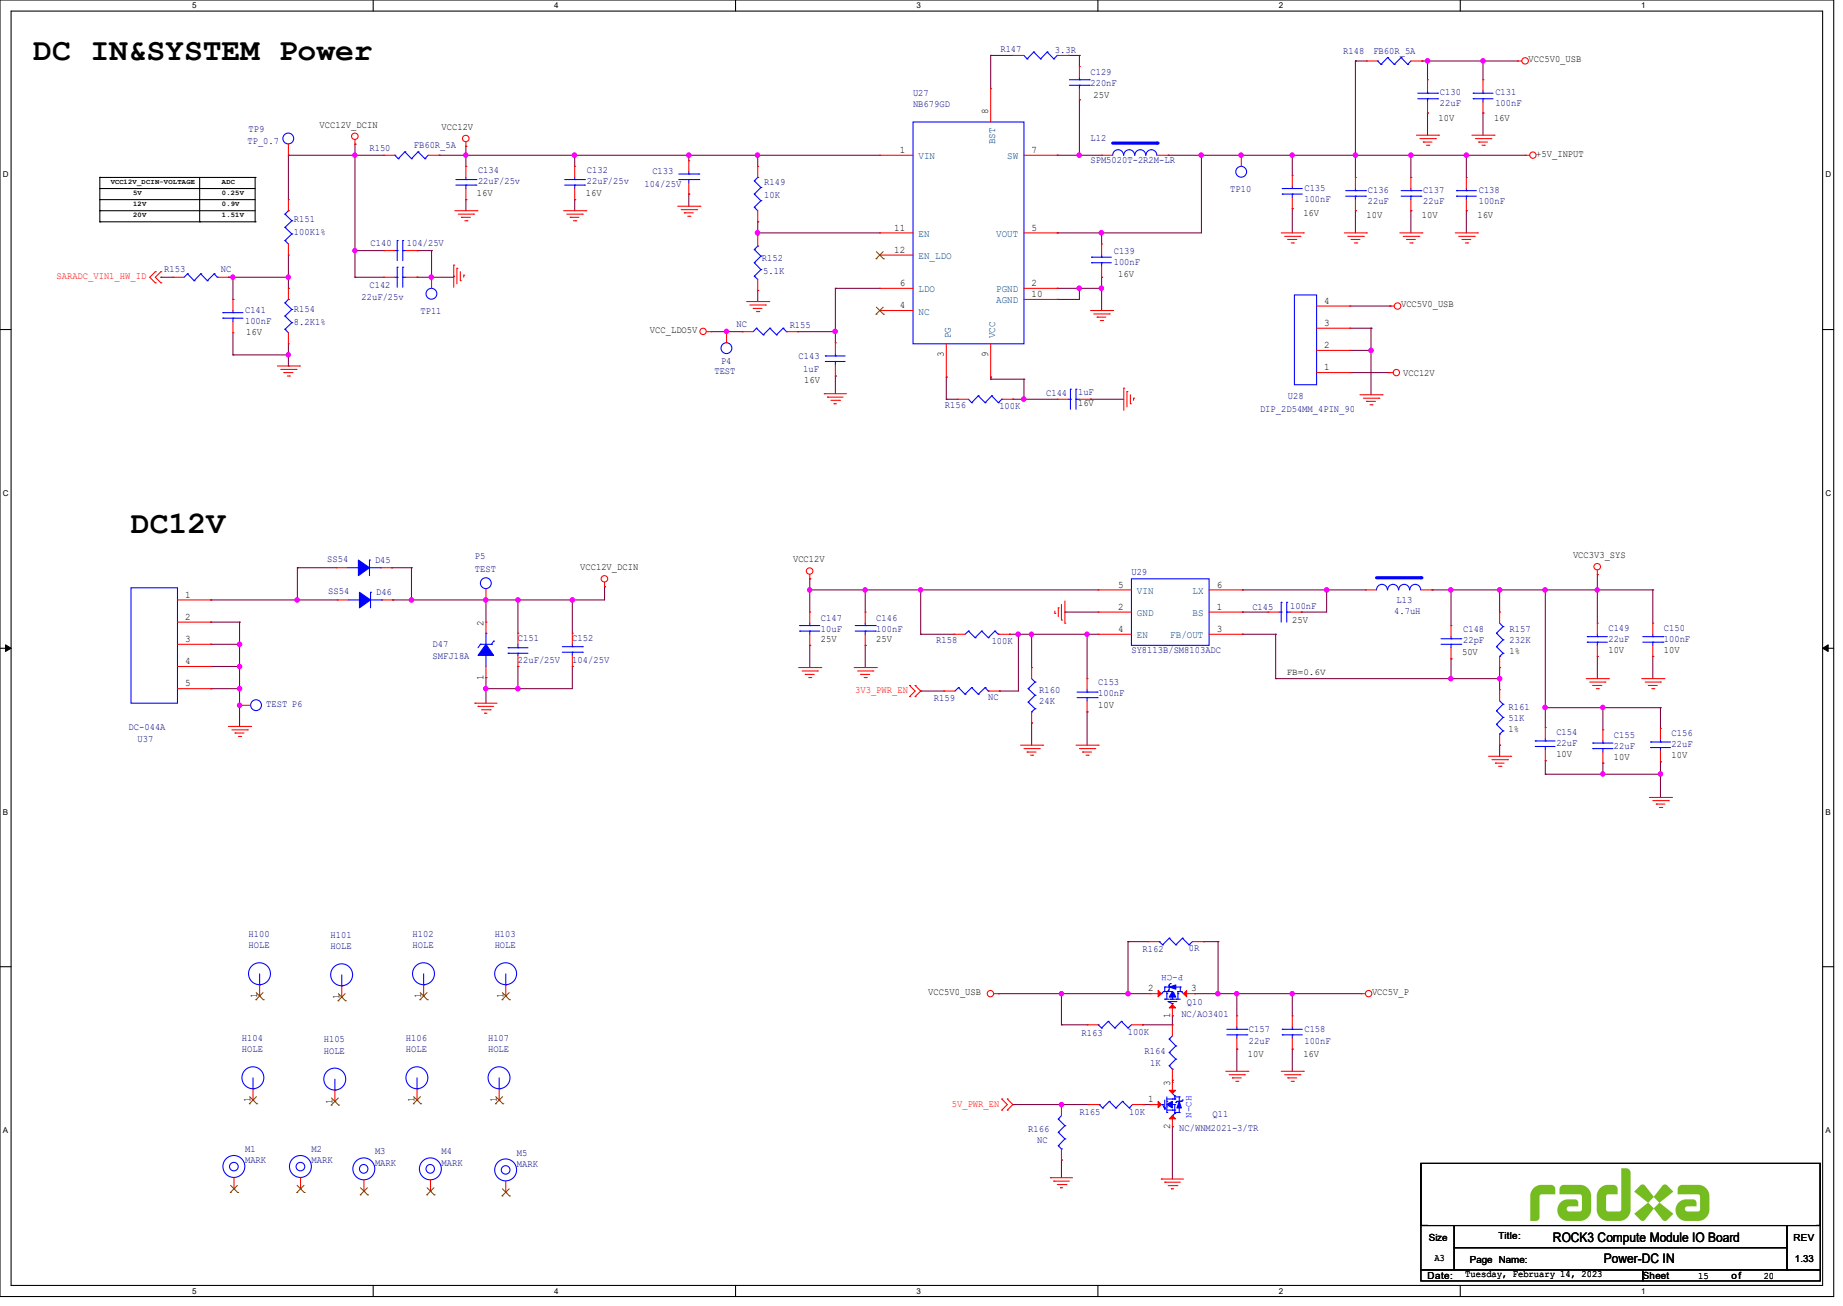
[picture p112: page 15]

VCC12V_DCIN-VOLTAGE | ADC
5V | 0.25V
12V | 0.9V
20V | 1.51V

VCC3V3_SYS | VCC5V0_USB

## VCC3V3_SYS +3V3

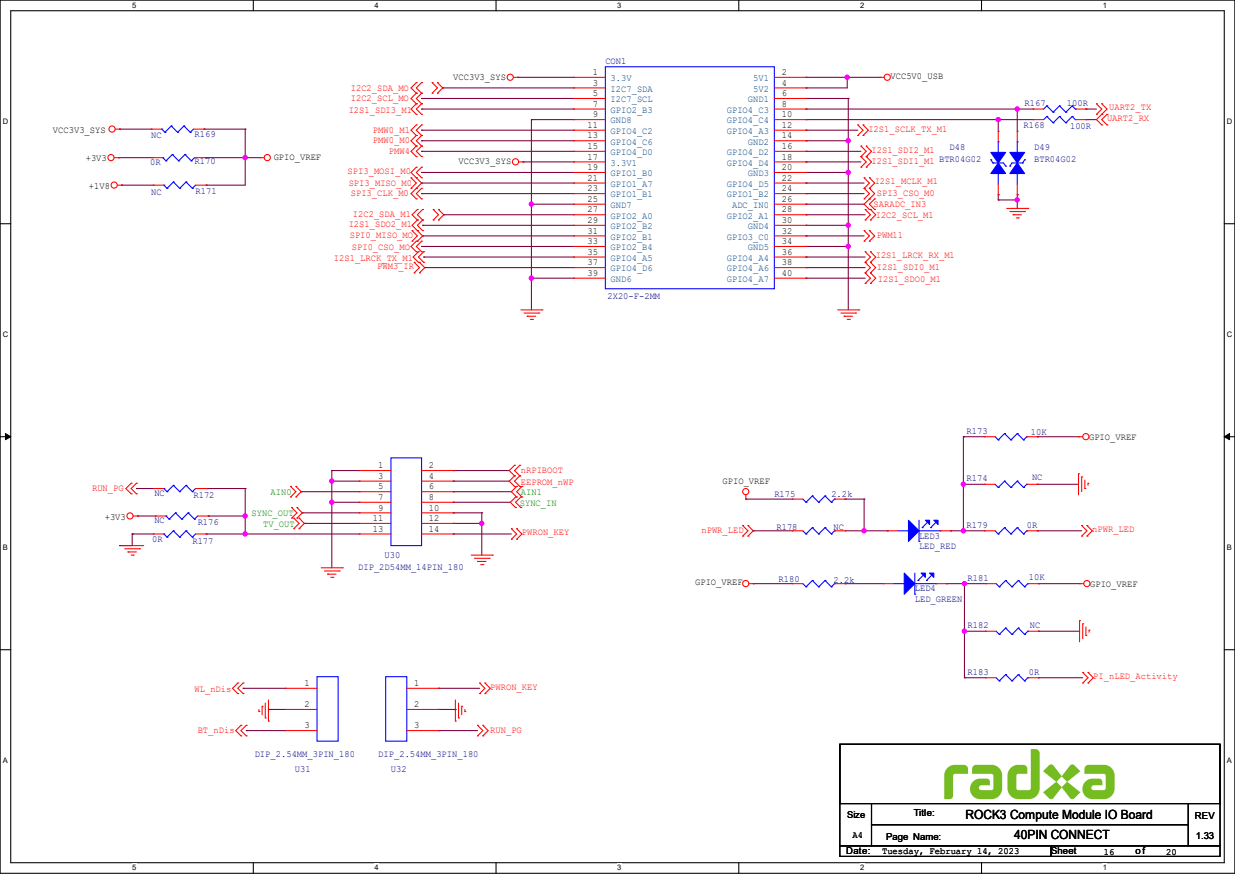
[picture p113: page 16]

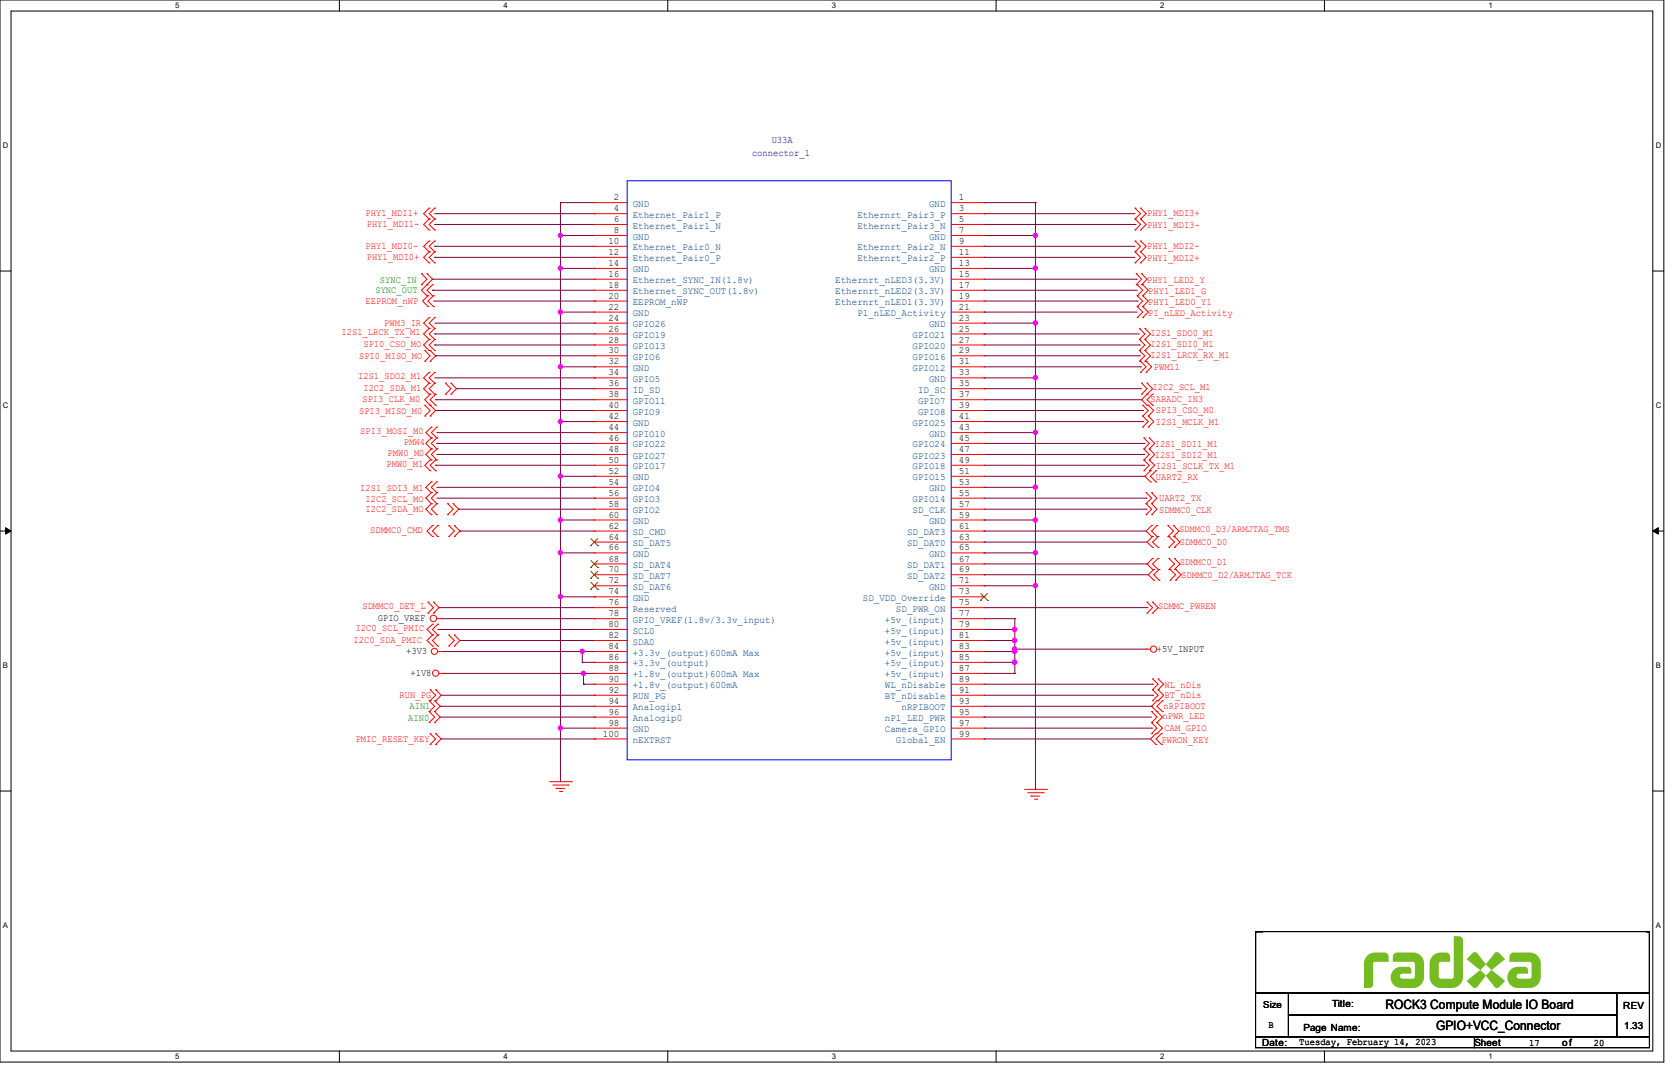
[picture p114: page 17]
GPIO_VREF; +5V_INPUT; SDMMC0_DET_L; SDMMC0_D0; SDMMC0_D1; SDMMC0_CLK; SDMMC0_D2/ARMJTAG_TCK; SDMMC0_D3/ARMJTAG_TMS; SDMMC_PWREN; UART2_TX; UART2_RX; I2S1_SCLK_TX_M1; I2C2_SCL_M1; I2S1_LRCK_TX_M1; I2S1_LRCK_RX_M1; I2S1_SDO0_M1 I2S1_SDI0_M1; SARADC_IN3; I2C0_SCL_PMIC; SPI3_MOSI_M0; SPI3_CLK_M0; SPI3_CSO_M0; PWM11; PMW4; PMW0_M1; PMW0_M0; I2S1_MCLK_M1; BT_nDis; WL_nDis; nPWR_LED; PI_nLED_Activity; PMIC_RESET_KEY; I2S1_SDO2_M1; nRPIBOOT; SYNC_IN; AIN0; AIN1; RUN_PG; PHY1_MDI1+ PHY1_MDI1-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

102 | HOLE 201 | HOLE 202 | HOLE 203 | HOLE 204

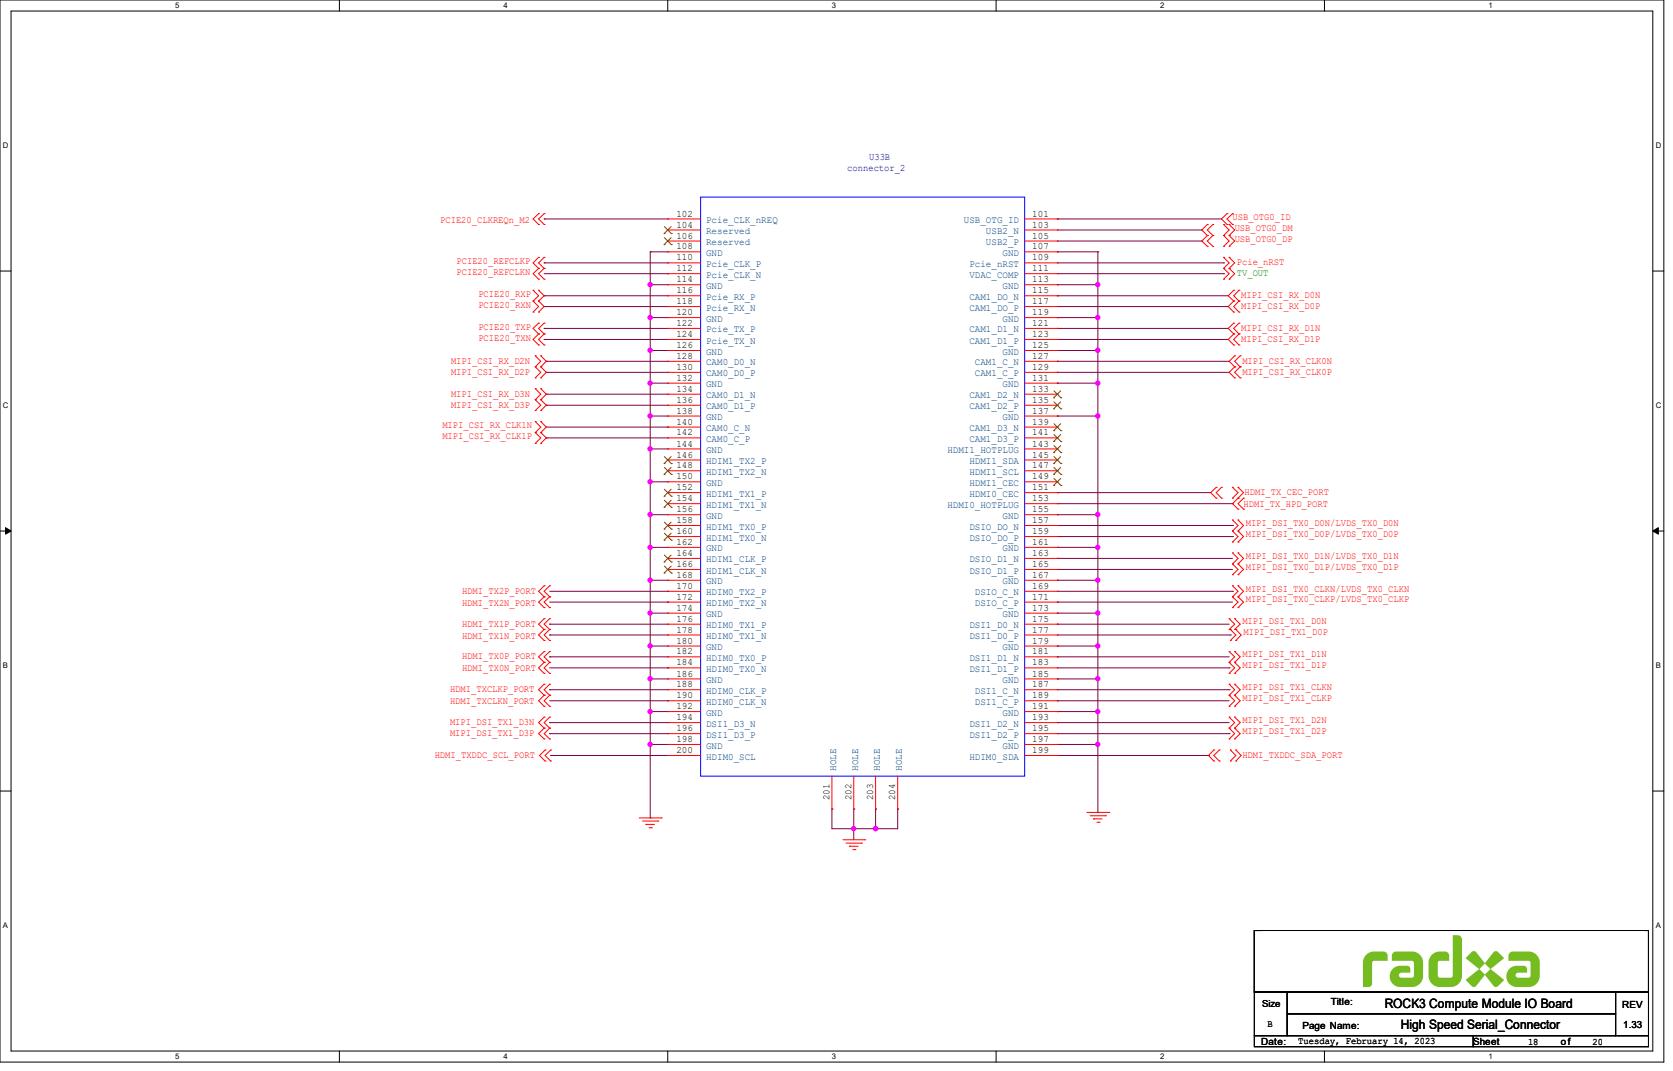
[picture p115: page 18]
USB_OTG0_DP; USB_OTG0_DM; USB_OTG0_ID; MIPI_CSI_RX_D0P; MIPI_CSI_RX_D0N; MIPI_CSI_RX_D1P; MIPI_CSI_RX_D1N; MIPI_CSI_RX_D2P; MIPI_CSI_RX_D2N; MIPI_CSI_RX_D3P; MIPI_CSI_RX_D3N; MIPI_CSI_RX_CLK0P; MIPI_CSI_RX_CLK0N; MIPI_CSI_RX_CLK1P; MIPI_CSI_RX_CLK1N; HDMI_TX_HPD_PORT; MIPI_DSI_TX0_D0P/LVDS_TX0_D0P; MIPI_DSI_TX0_D0N/LVDS_TX0_D0N; MIPI_DSI_TX0_D1P/LVDS_TX0_D1P; MIPI_DSI_TX0_D1N/LVDS_TX0_D1N; MIPI_DSI_TX0_CLKP/LVDS_TX0_CLKP; MIPI_DSI_TX0_CLKN/LVDS_TX0_CLKN; MIPI_DSI_TX1_D0P; MIPI_DSI_TX1_D0N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

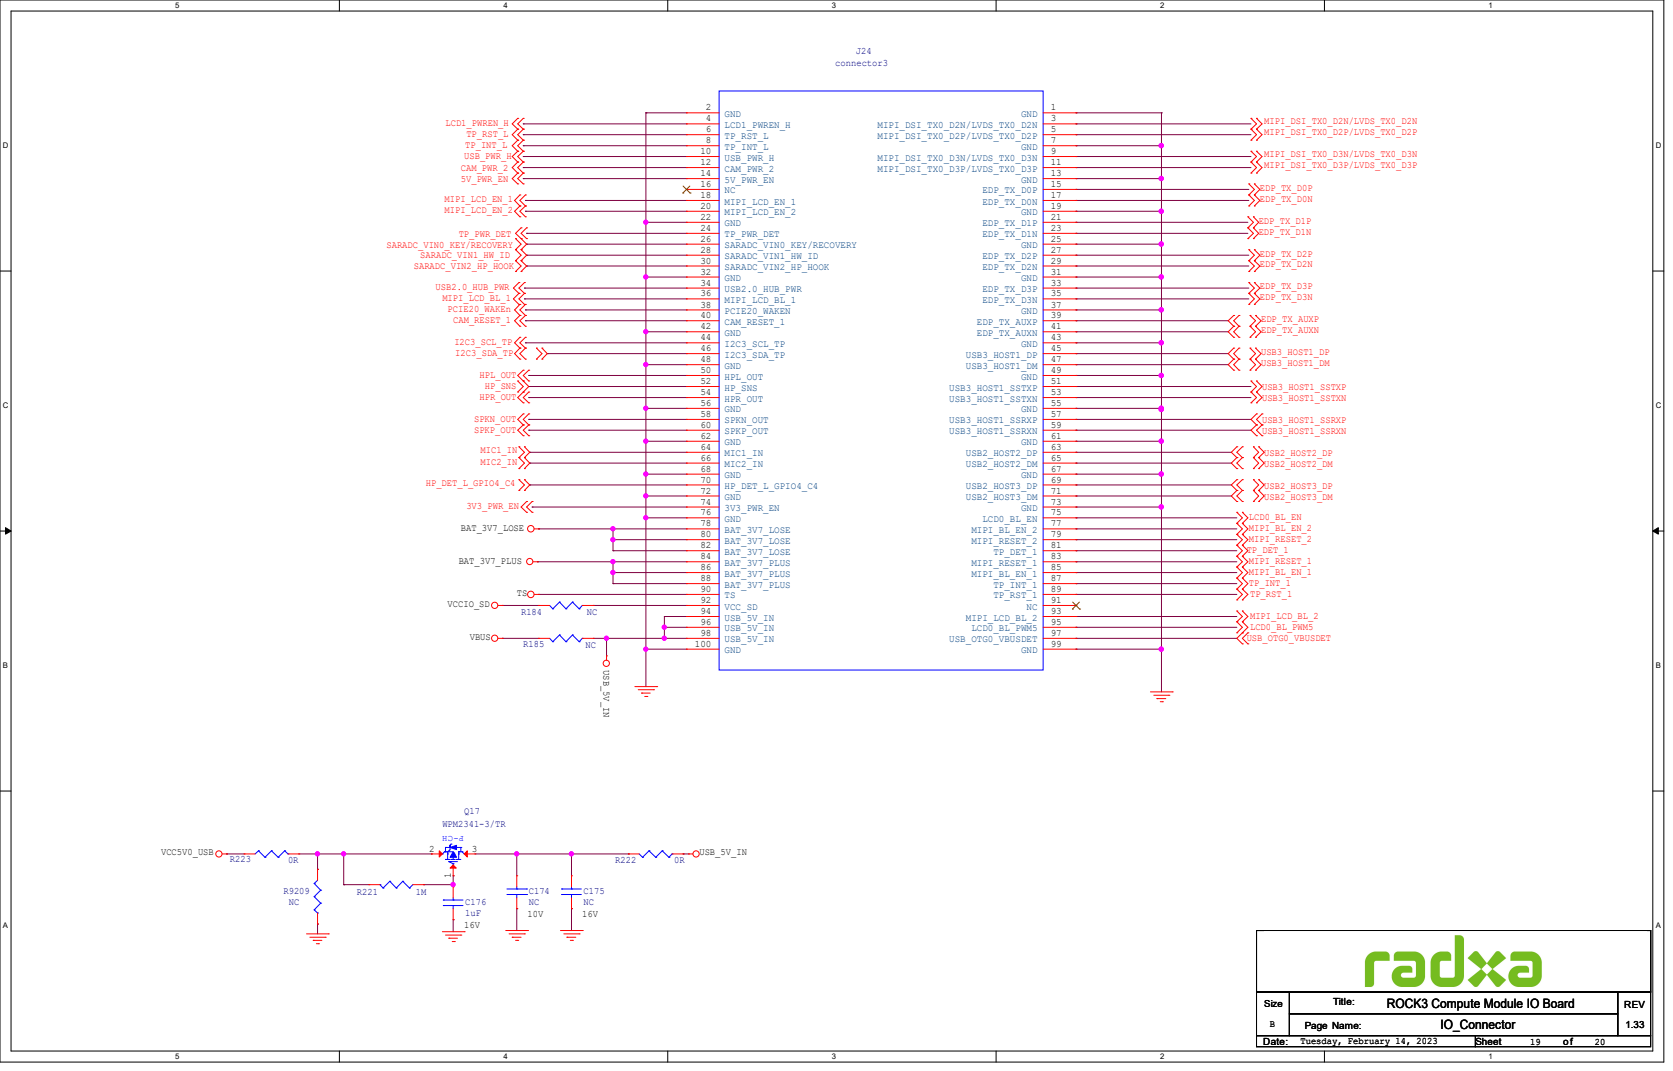
[picture p116: page 19]

# MIPI_LCD_TX1

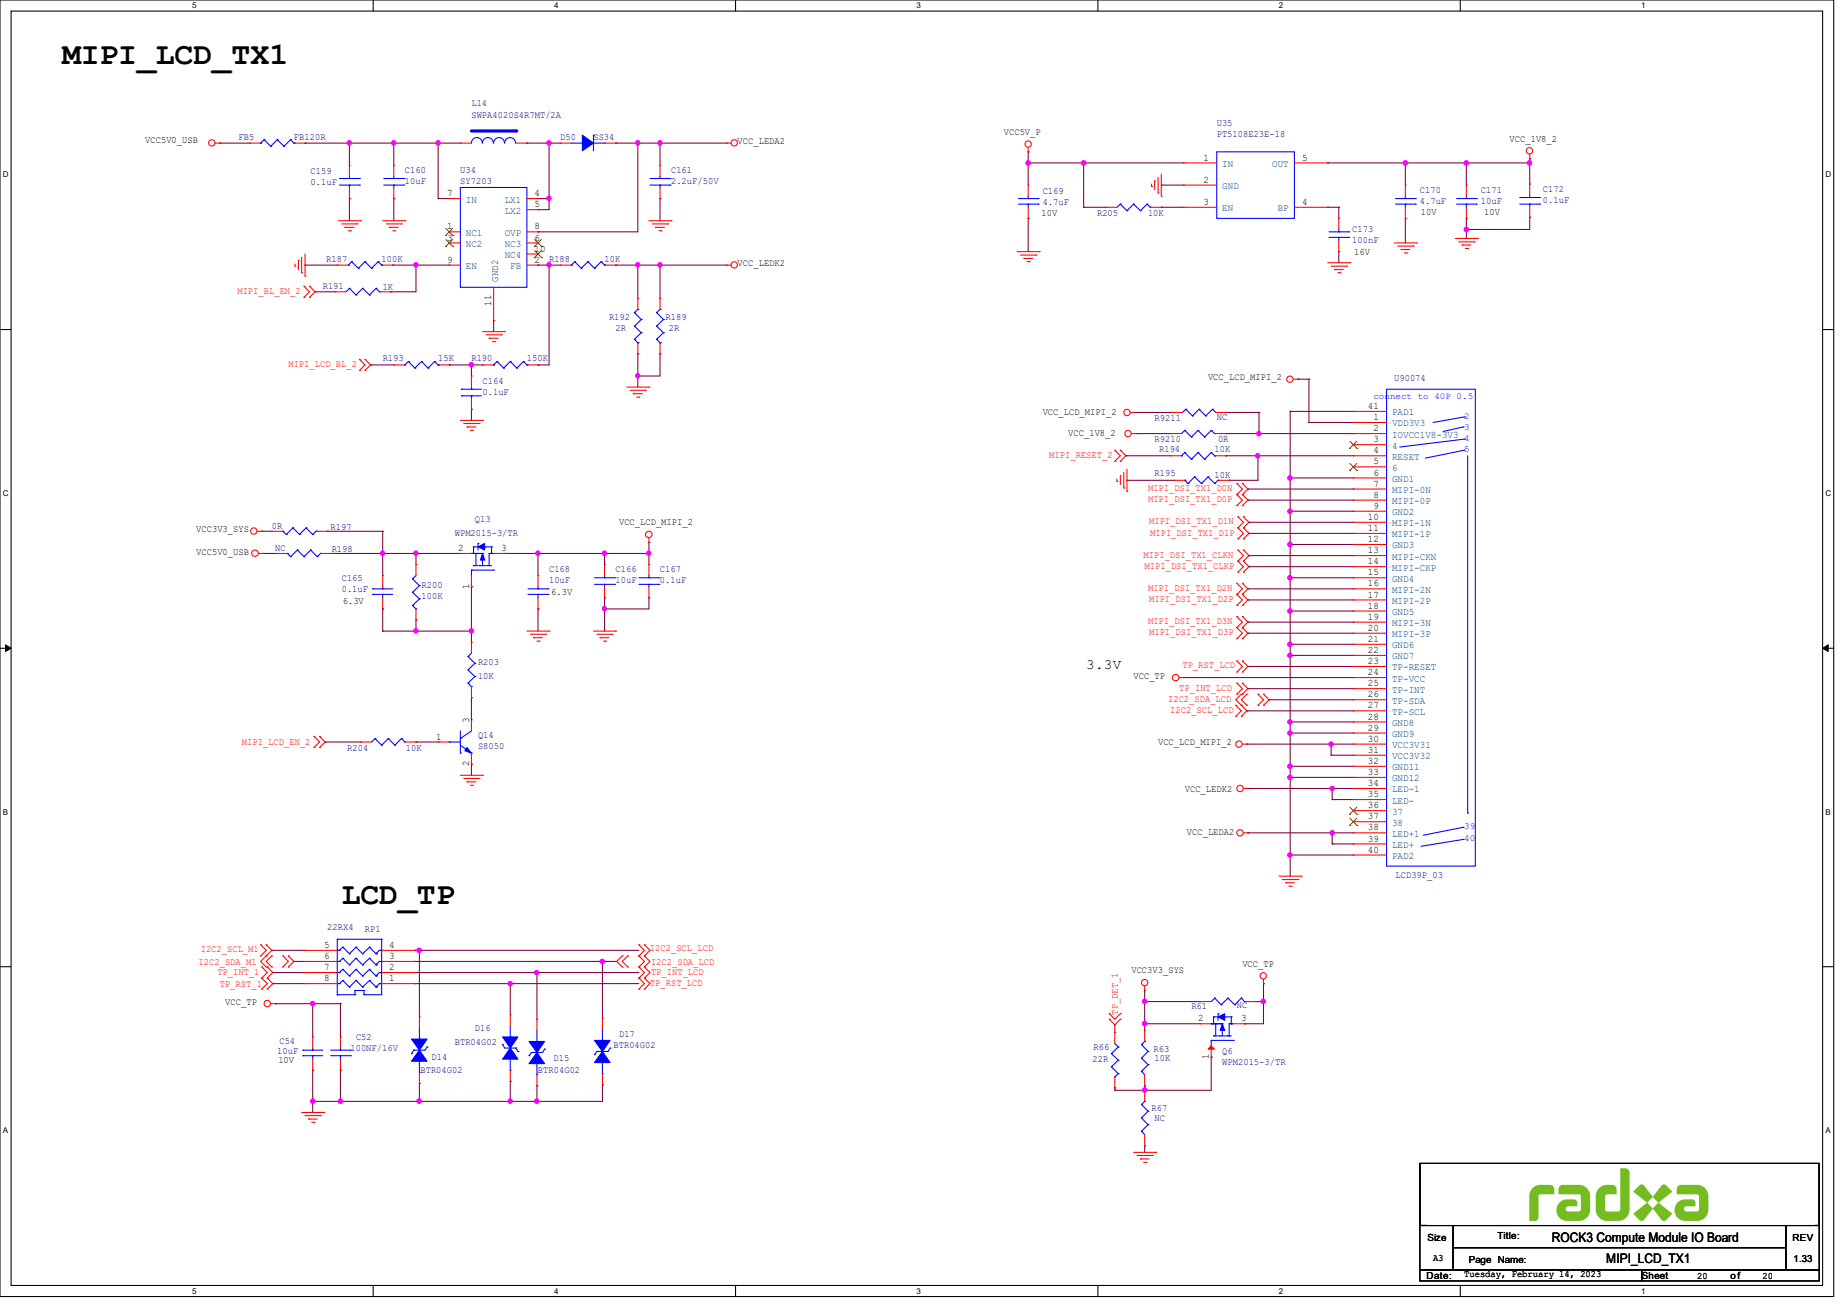
[picture p117: page 20]
