radxa/radxa-cm-projects/cm4/radxa-cm4-io-board/radxa_cm4_io_components_placement_map_v1.10.pdf

# R234 R²³²

Q16

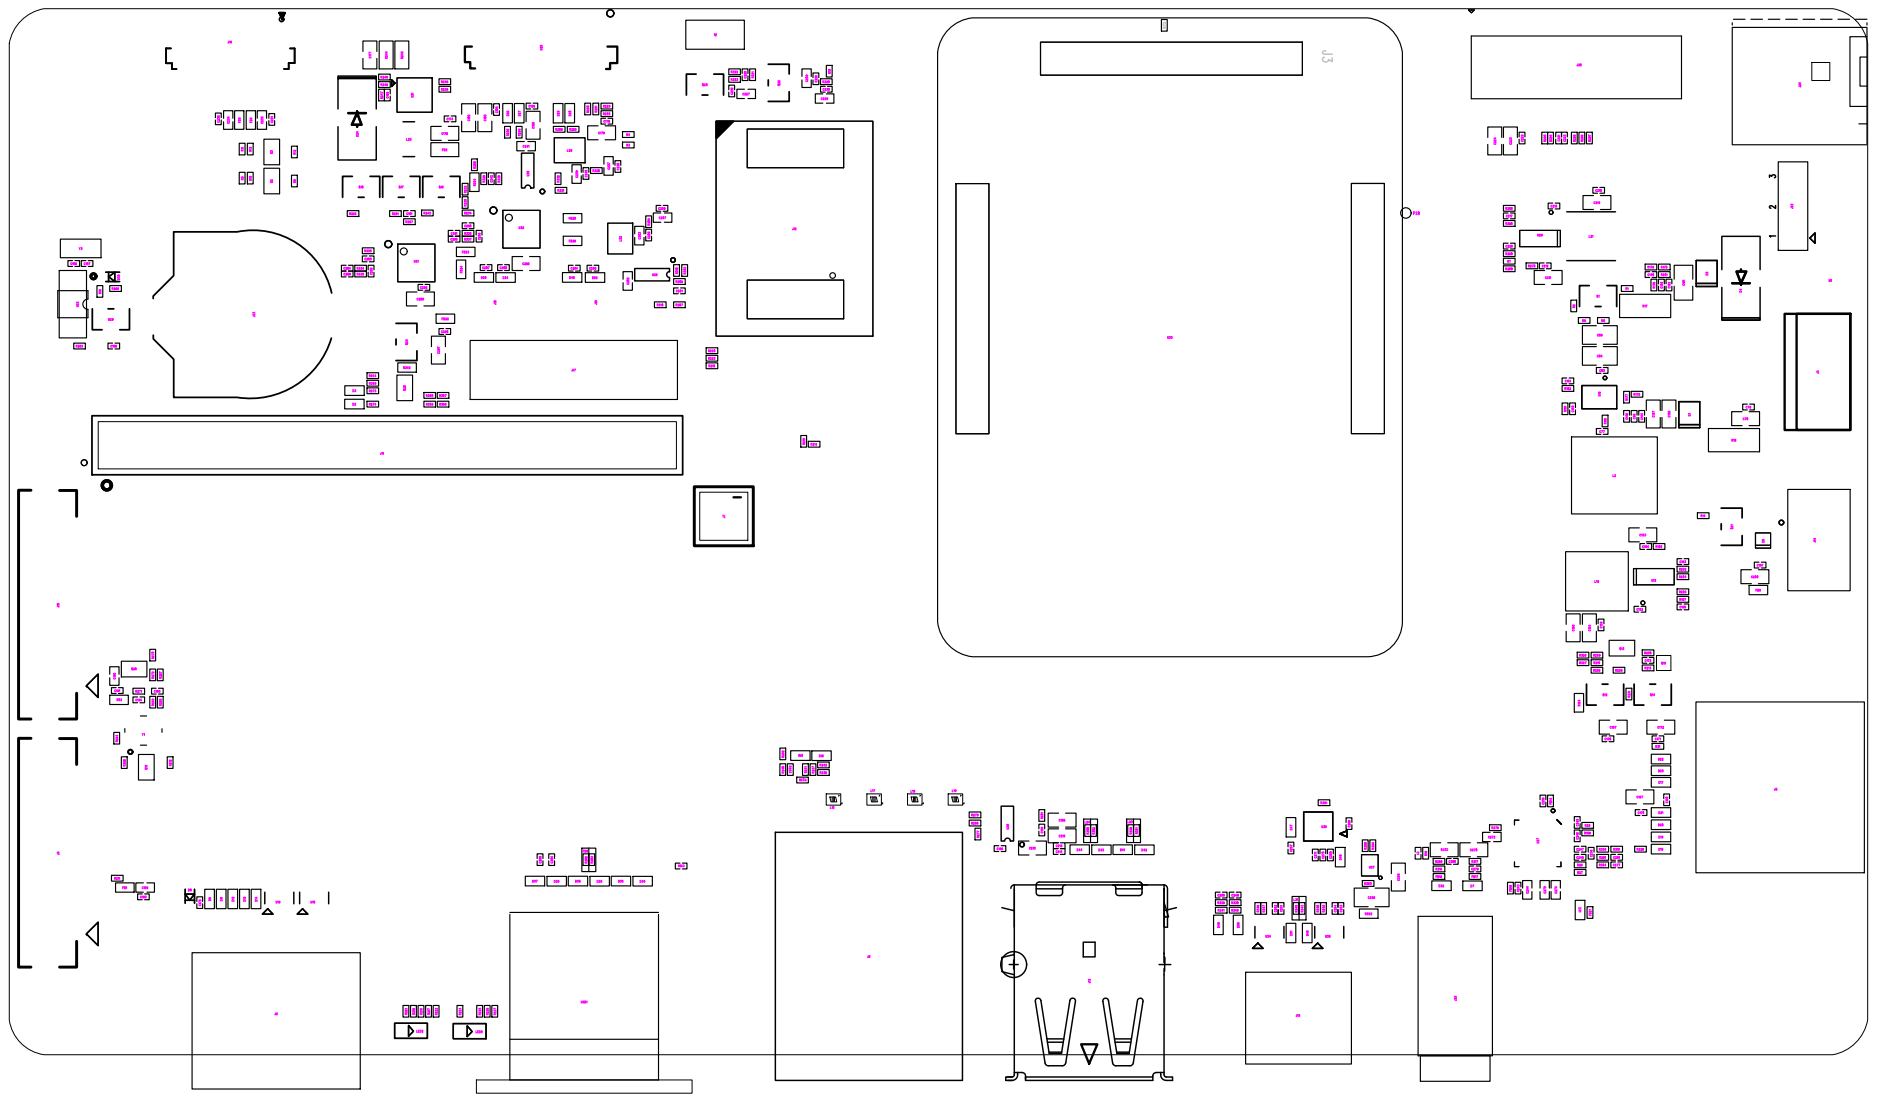
[picture p118: page 1]

U37 U³⁷xA³ U³⁷xA² U³⁷xA¹ U³⁷xB³ U³⁷xB² U³⁷xB¹ U³⁷xC³ U³⁷xC² U³⁷xC¹ U³⁷xD³ U³⁷xD² U³⁷xD¹

P20

P12

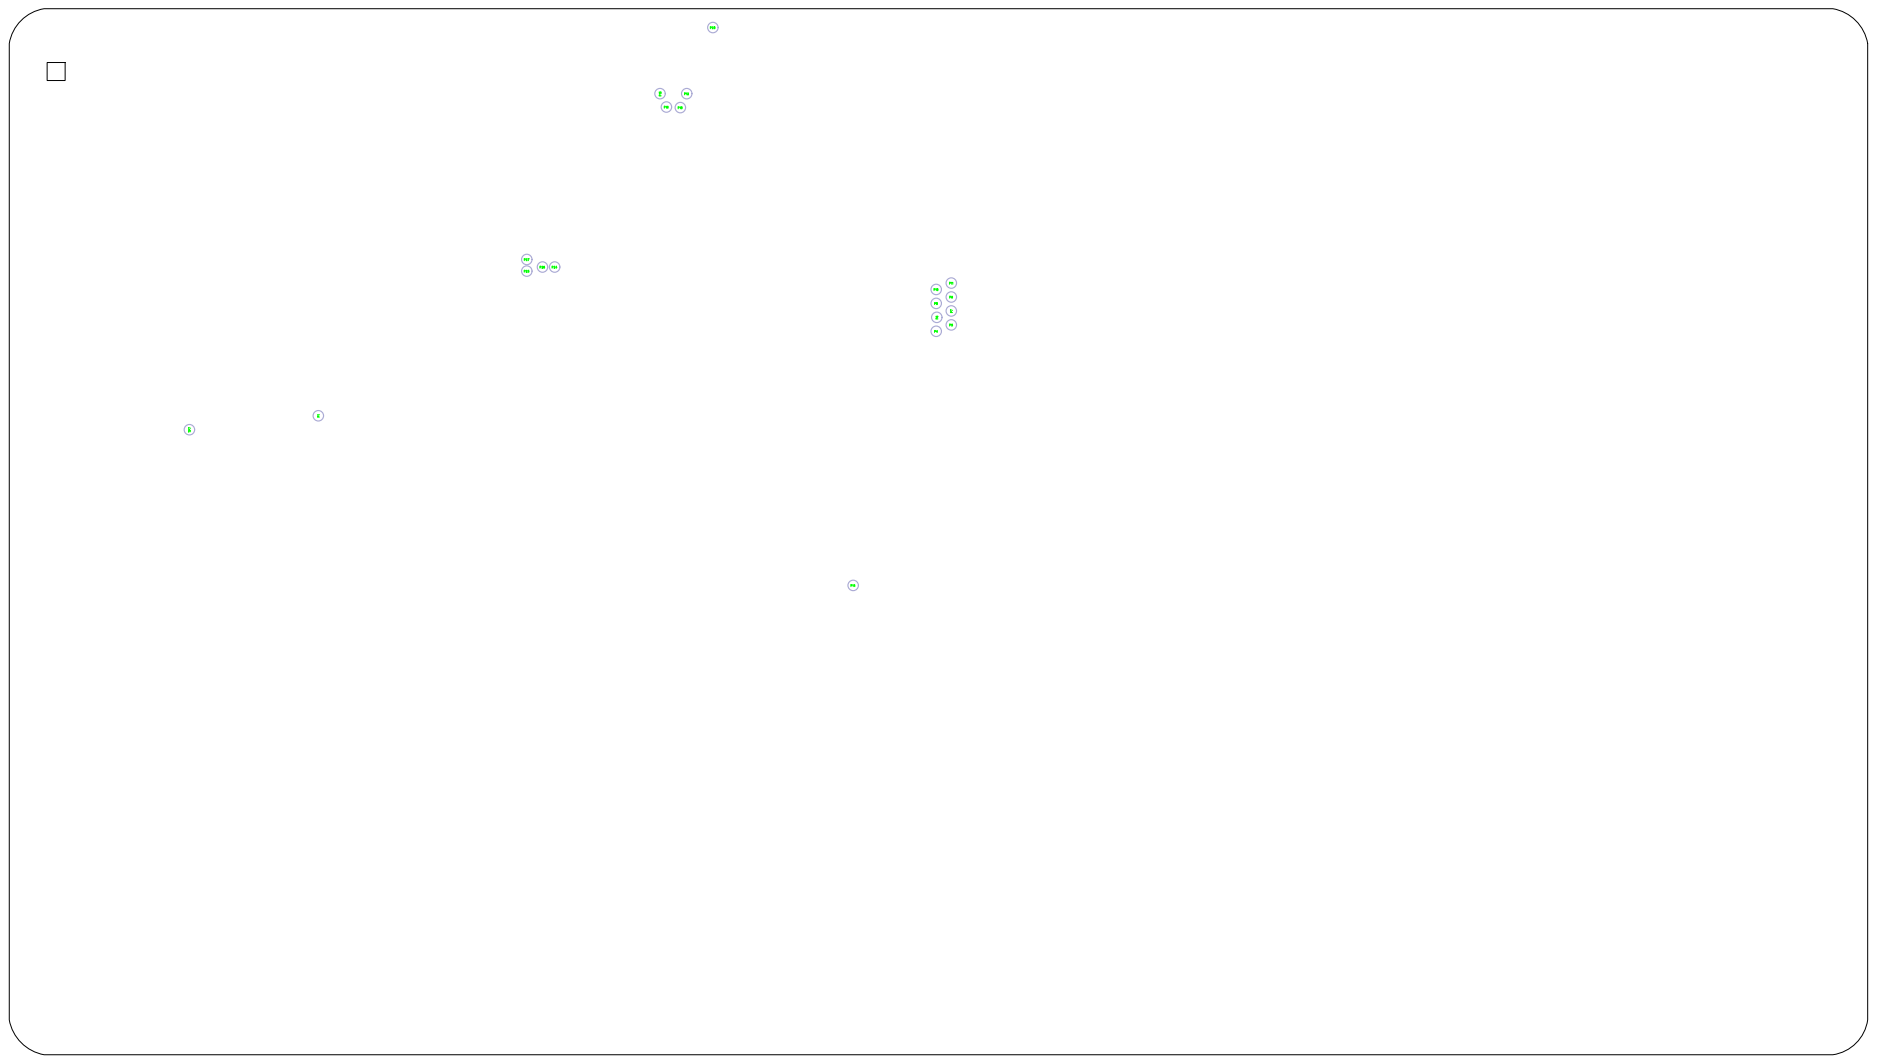
[picture p119: page 2]
