radxa/radxa-cm-projects/nx5/radxa-nx5-io-board/radxa_nx5_io_board_components_placement_map.pdf

J4

J4J4x1 J4x2 J4x3 J4x4 J4x5 J4x6 J4x7 J4x8 J4x9 J4x10 | J4x11J4x13 | J4x12 J4x14 J4x18 | J4x17 | J4x16 | J4x15 J4x20 | J4x19 J4x22 | J4x21

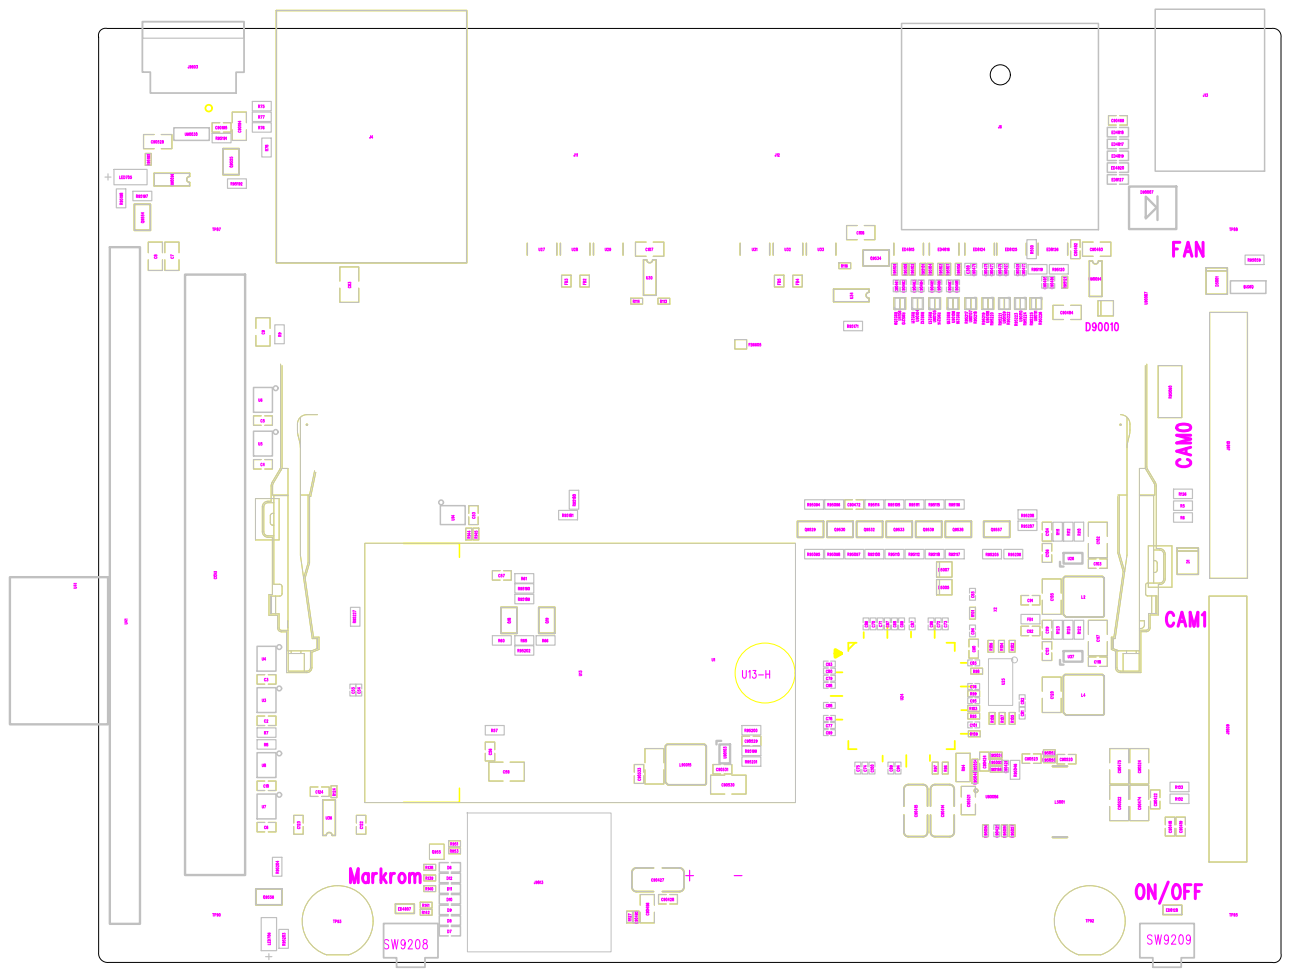
[picture p120: page 1]
