radxa/radxa-cm-projects/cm3i/radxa-cm3i-io-board/radxa_cm3i_io_board_components_placement_map_v1.4.pdf

input | RS485 | CAN | RS232

# Ethernet 1 Ethernet 0

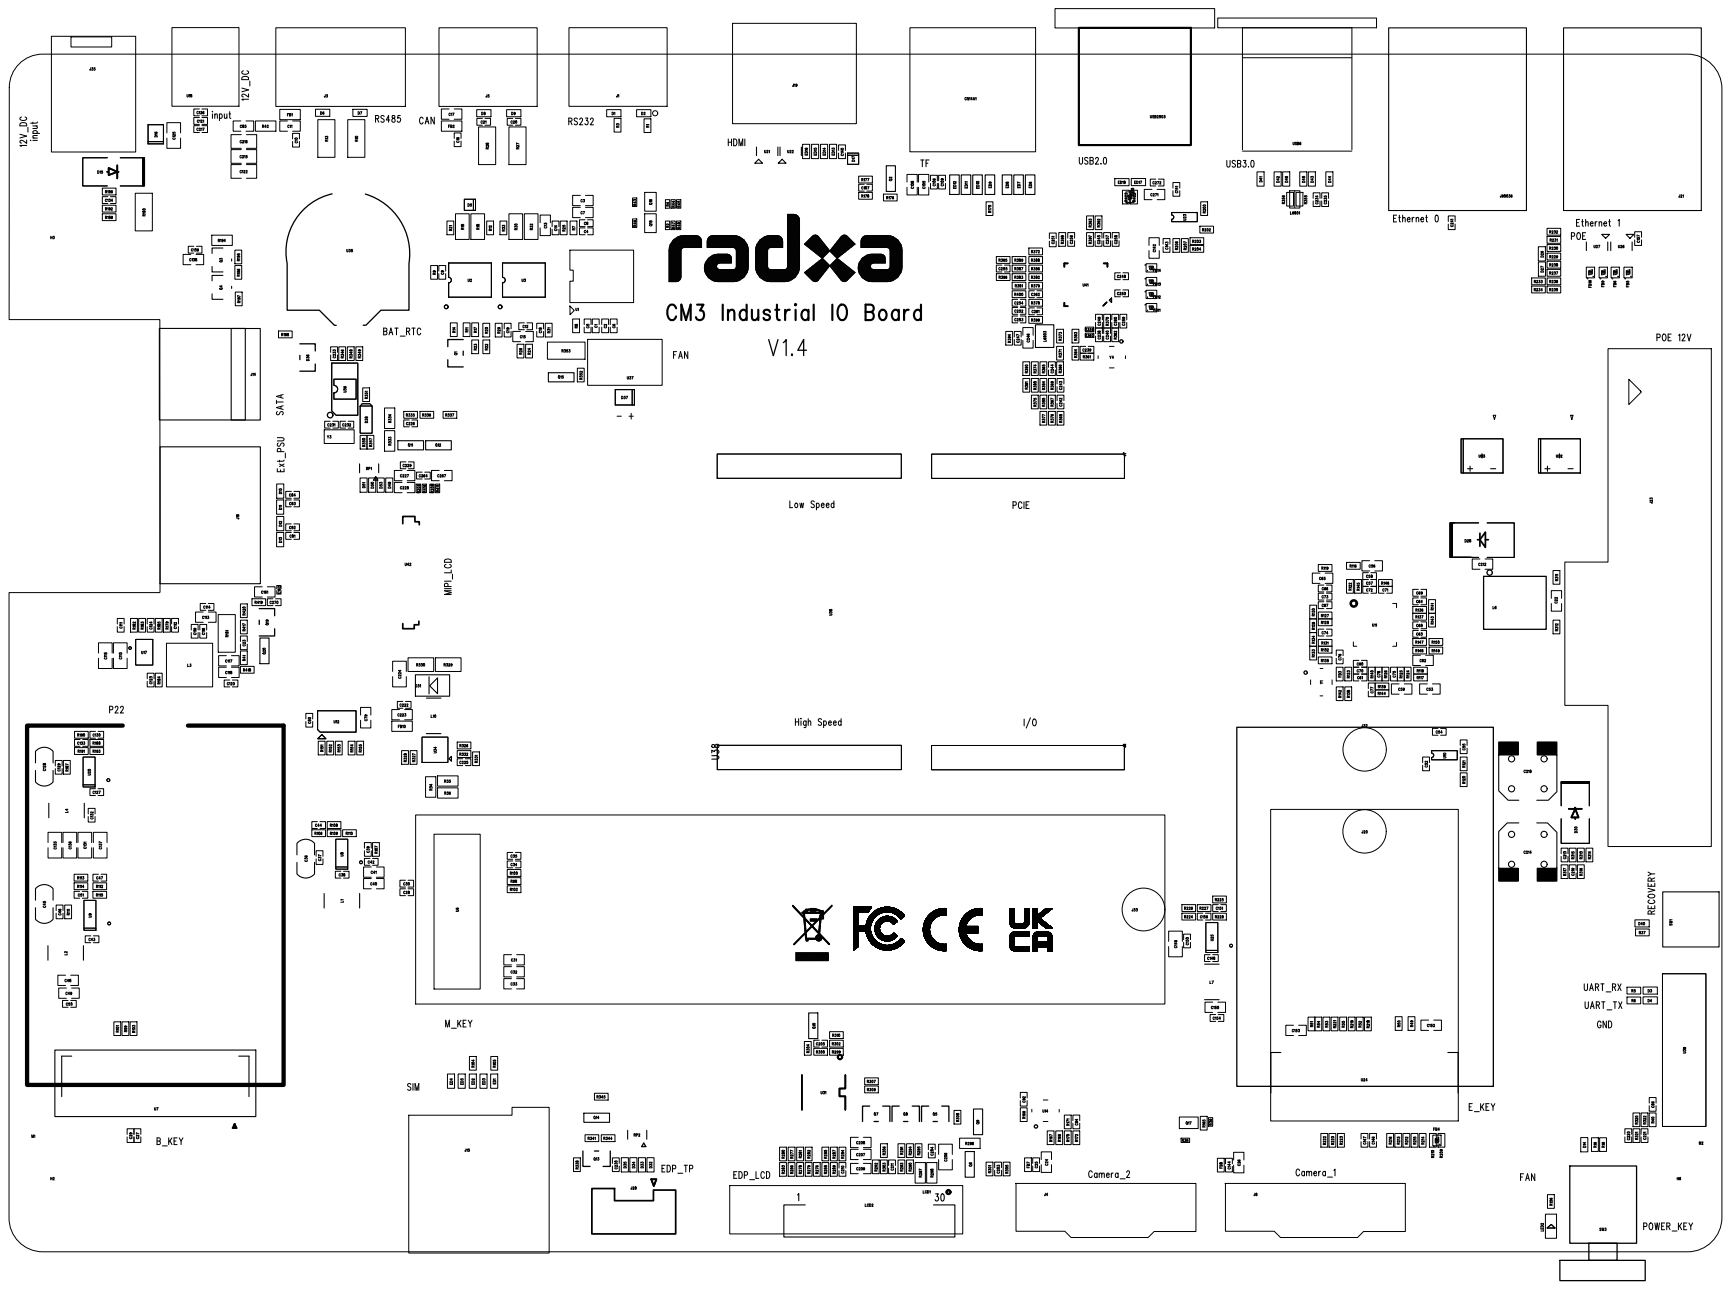
[picture p121: page 1]

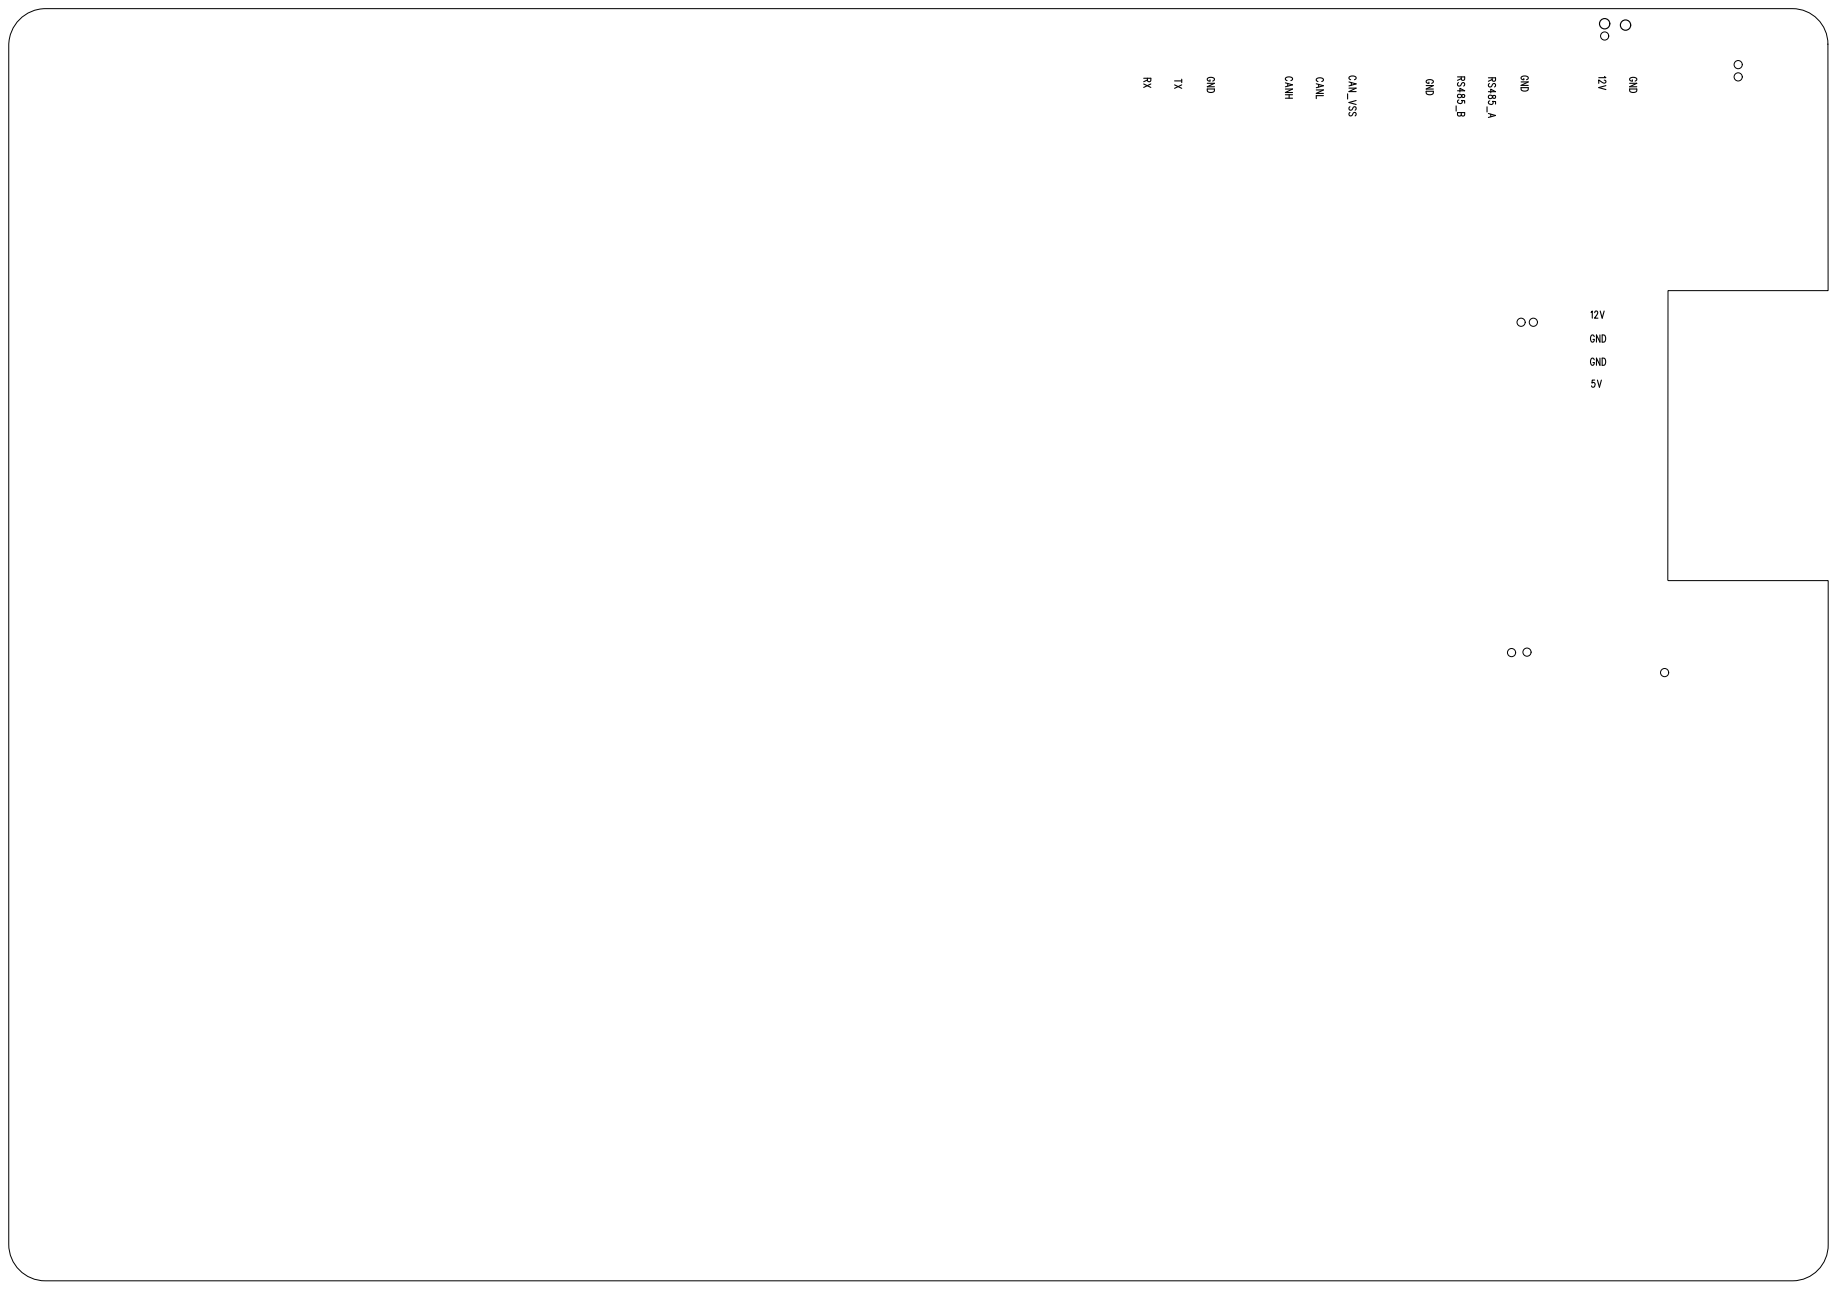
[picture p122: page 2]
