radxa/radxa-cm-projects/cm5/radxa-cm5-io-board/radxa_cm5_io_board_v2200_components_placement_map.pdf

# Camera 0

# LCD1

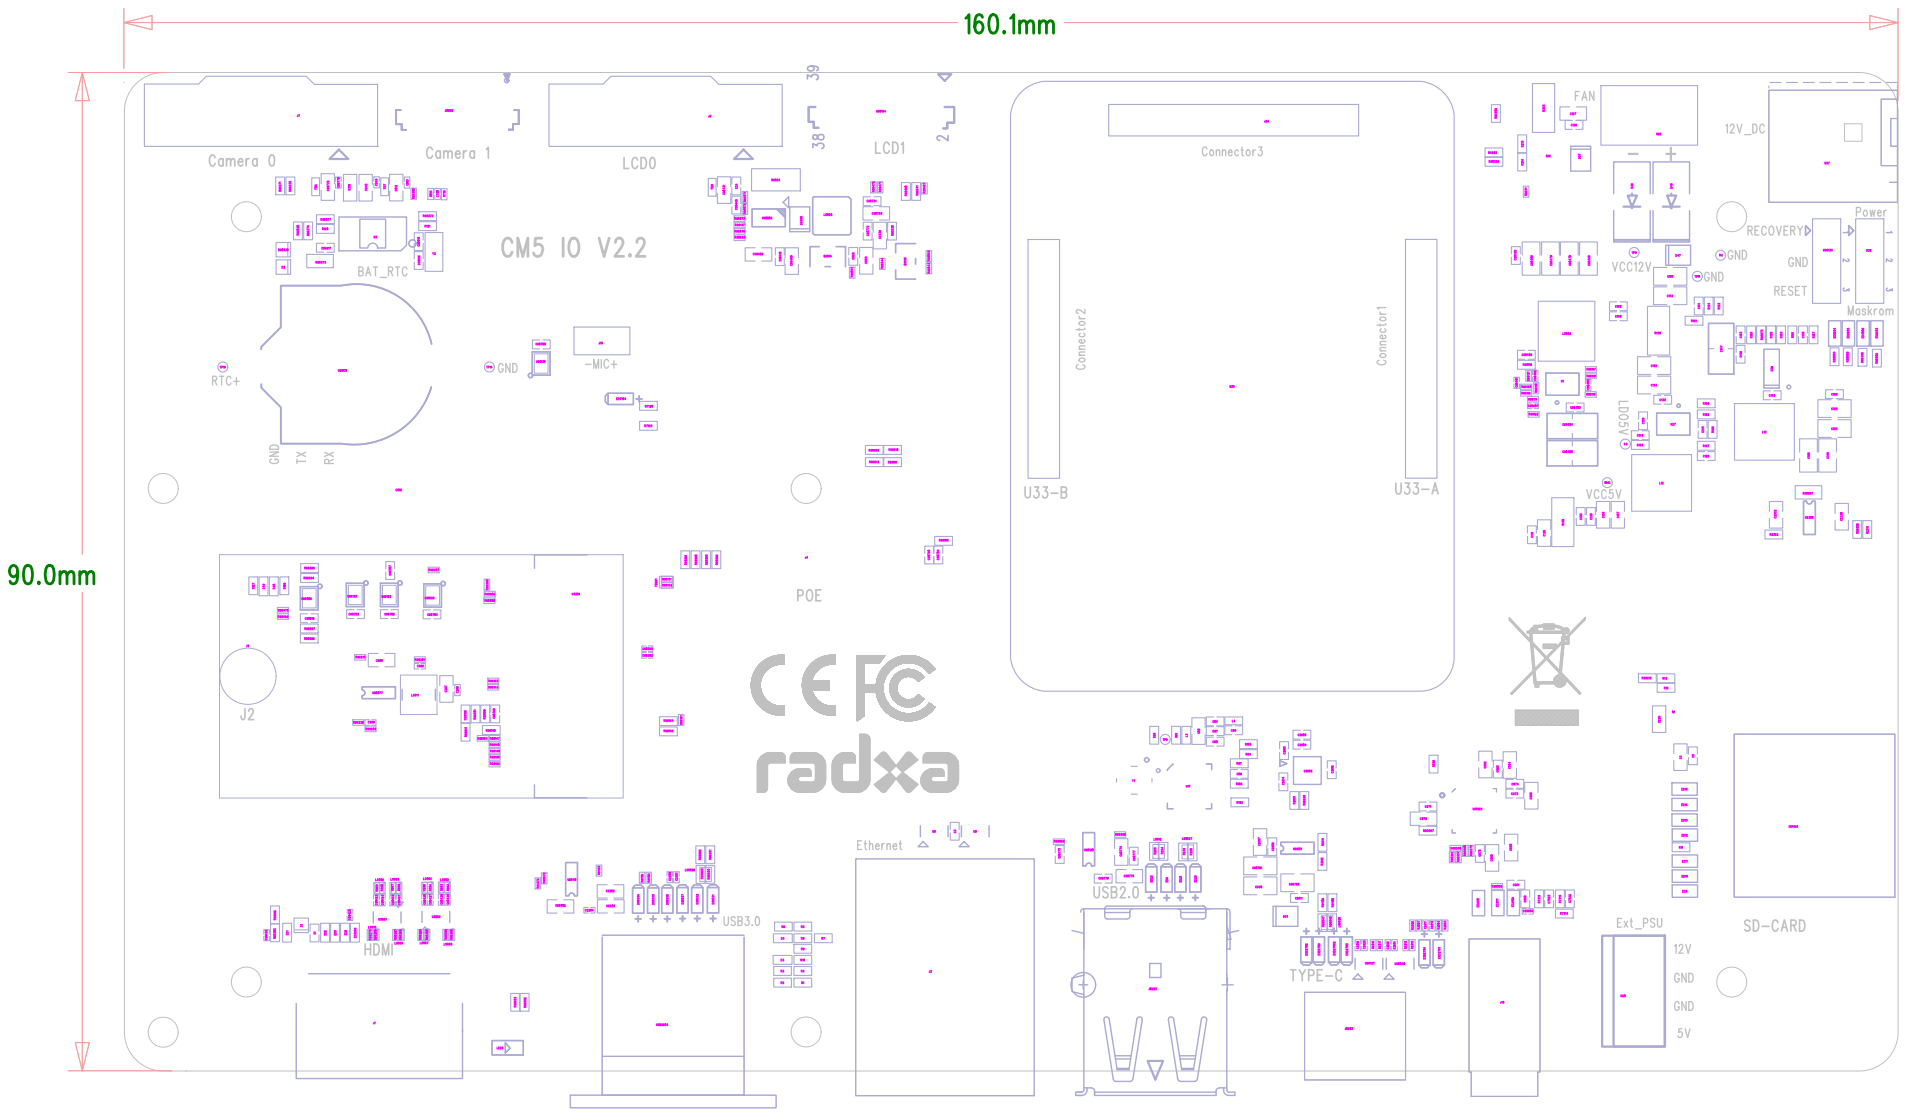
[picture p123: page 1]

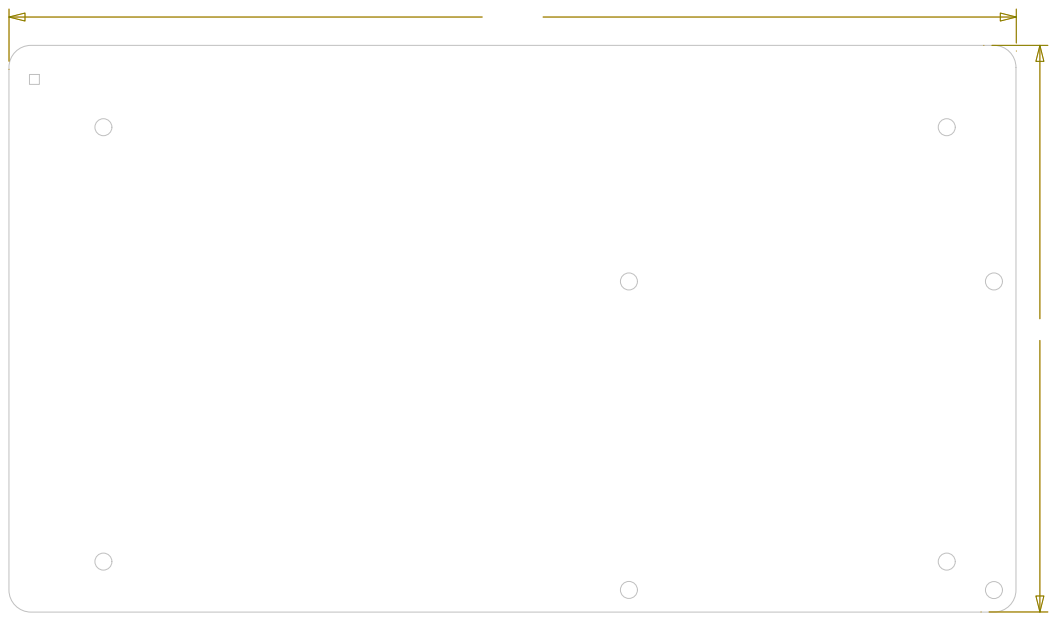
[picture p124: page 2]
CON1x39 CON1x40; CON1x37 CON1x38; CON1x35 CON1x36; CON1x33 CON1x34; CON1x31 CON1x32; CON1x29 CON1x30; CON1x27 CON1x28; CON1x25 CON1x26; CON1x23 CON1x24; CON1x21 CON1x22; CON1x19 CON1x20; CON1x17 CON1x18; CON1x15 CON1x16; CON1x13 CON1x14; CON1x11 CON1x12; CON1x9 CON1x10; CON1x7 CON1x8; CON1x5 CON1x6; CON1x3 CON1x4; CON1x1 CON1x2 CON1 J2x1 J2
