radxa/radxa-cm-projects/cm4/radxa-cm4-io-board/radxa_cm4_io_dimensions_drawing.pdf

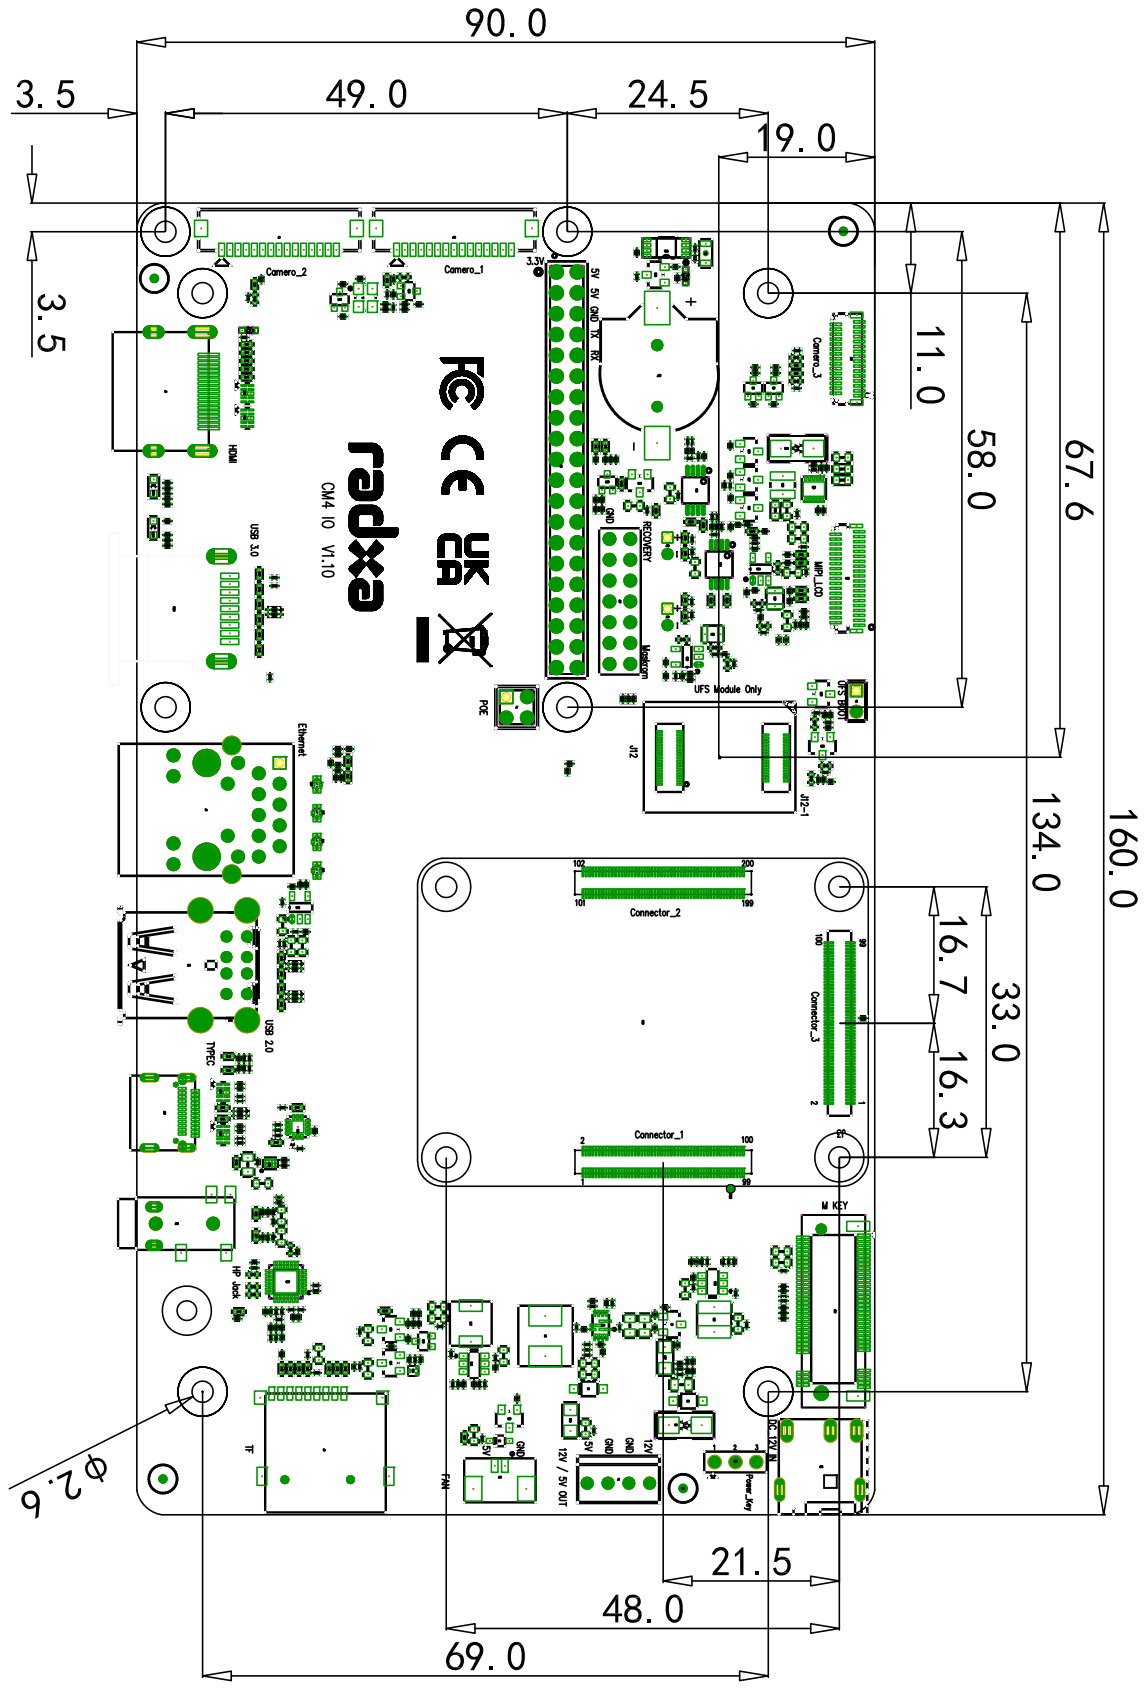
[picture p127: page 1]
