radxa/radxa-cm-projects/(list of files, drawings)

Other design files:
cm3/radxa-cm3-io-board/altium/radxa_cm3_io_board_v1330_pcb_layout.PrjPcb/radxa_cm3_io_board.PrjPcb
cm3/radxa-cm3-io-board/altium/radxa_cm3_io_board_v1330_schematic.PrjPcb/01.SchDoc
cm3/radxa-cm3-io-board/altium/radxa_cm3_io_board_v1330_schematic.PrjPcb/02.SchDoc
cm3/radxa-cm3-io-board/altium/radxa_cm3_io_board_v1330_schematic.PrjPcb/03.SchDoc
cm3/radxa-cm3-io-board/altium/radxa_cm3_io_board_v1330_schematic.PrjPcb/04.SchDoc
cm3/radxa-cm3-io-board/altium/radxa_cm3_io_board_v1330_schematic.PrjPcb/05.SchDoc
cm3/radxa-cm3-io-board/altium/radxa_cm3_io_board_v1330_schematic.PrjPcb/06.SchDoc
cm3/radxa-cm3-io-board/altium/radxa_cm3_io_board_v1330_schematic.PrjPcb/07.SchDoc
cm3/radxa-cm3-io-board/altium/radxa_cm3_io_board_v1330_schematic.PrjPcb/08.SchDoc
cm3/radxa-cm3-io-board/altium/radxa_cm3_io_board_v1330_schematic.PrjPcb/09.SchDoc
cm3/radxa-cm3-io-board/altium/radxa_cm3_io_board_v1330_schematic.PrjPcb/10.SchDoc
cm3/radxa-cm3-io-board/altium/radxa_cm3_io_board_v1330_schematic.PrjPcb/11.SchDoc
cm3/radxa-cm3-io-board/altium/radxa_cm3_io_board_v1330_schematic.PrjPcb/12.SchDoc
cm3/radxa-cm3-io-board/altium/radxa_cm3_io_board_v1330_schematic.PrjPcb/13.SchDoc
cm3/radxa-cm3-io-board/altium/radxa_cm3_io_board_v1330_schematic.PrjPcb/14.SchDoc
cm3/radxa-cm3-io-board/altium/radxa_cm3_io_board_v1330_schematic.PrjPcb/15.SchDoc
cm3/radxa-cm3-io-board/altium/radxa_cm3_io_board_v1330_schematic.PrjPcb/16.SchDoc
cm3/radxa-cm3-io-board/altium/radxa_cm3_io_board_v1330_schematic.PrjPcb/17.SchDoc
cm3/radxa-cm3-io-board/altium/radxa_cm3_io_board_v1330_schematic.PrjPcb/18.SchDoc
cm3/radxa-cm3-io-board/altium/radxa_cm3_io_board_v1330_schematic.PrjPcb/19.SchDoc
cm3/radxa-cm3-io-board/altium/radxa_cm3_io_board_v1330_schematic.PrjPcb/20.SchDoc
cm3/radxa-cm3-io-board/altium/radxa_cm3_io_board_v1330_schematic.PrjPcb/radxa_cm3_io_board_v1330.PrjPcb
cm3/radxa-cm3-io-board/altium/radxa_cm3_io_board_v1330_schematic.PrjPcb/radxa_cm3_io_board_v1330_Library.SchLib
cm3/radxa-cm3-io-board/radxa_cm3_io_board_v1330.DSN
cm3i/radxa-cm3i-io-board/altium/radxa_cm3i_io_board_pcb_layout_v1.4.PrjPcb/radxa_cm3i_io_board_v1.4.PrjPcb
cm3i/radxa-cm3i-io-board/altium/radxa_cm3i_io_board_schematic_v1.4.PrjPcb/01.SchDoc
cm3i/radxa-cm3i-io-board/altium/radxa_cm3i_io_board_schematic_v1.4.PrjPcb/02.SchDoc
cm3i/radxa-cm3i-io-board/altium/radxa_cm3i_io_board_schematic_v1.4.PrjPcb/03.SchDoc
cm3i/radxa-cm3i-io-board/altium/radxa_cm3i_io_board_schematic_v1.4.PrjPcb/04.SchDoc
cm3i/radxa-cm3i-io-board/altium/radxa_cm3i_io_board_schematic_v1.4.PrjPcb/05.SchDoc
cm3i/radxa-cm3i-io-board/altium/radxa_cm3i_io_board_schematic_v1.4.PrjPcb/06.SchDoc
cm3i/radxa-cm3i-io-board/altium/radxa_cm3i_io_board_schematic_v1.4.PrjPcb/07.SchDoc
cm3i/radxa-cm3i-io-board/altium/radxa_cm3i_io_board_schematic_v1.4.PrjPcb/08.SchDoc
cm3i/radxa-cm3i-io-board/altium/radxa_cm3i_io_board_schematic_v1.4.PrjPcb/09.SchDoc
cm3i/radxa-cm3i-io-board/altium/radxa_cm3i_io_board_schematic_v1.4.PrjPcb/10.SchDoc
cm3i/radxa-cm3i-io-board/altium/radxa_cm3i_io_board_schematic_v1.4.PrjPcb/11.SchDoc
cm3i/radxa-cm3i-io-board/altium/radxa_cm3i_io_board_schematic_v1.4.PrjPcb/12.SchDoc
cm3i/radxa-cm3i-io-board/altium/radxa_cm3i_io_board_schematic_v1.4.PrjPcb/13.SchDoc
cm3i/radxa-cm3i-io-board/altium/radxa_cm3i_io_board_schematic_v1.4.PrjPcb/14.SchDoc
cm3i/radxa-cm3i-io-board/altium/radxa_cm3i_io_board_schematic_v1.4.PrjPcb/15.SchDoc
cm3i/radxa-cm3i-io-board/altium/radxa_cm3i_io_board_schematic_v1.4.PrjPcb/16.SchDoc
cm3i/radxa-cm3i-io-board/altium/radxa_cm3i_io_board_schematic_v1.4.PrjPcb/17.SchDoc
cm3i/radxa-cm3i-io-board/altium/radxa_cm3i_io_board_schematic_v1.4.PrjPcb/18.SchDoc
cm3i/radxa-cm3i-io-board/altium/radxa_cm3i_io_board_schematic_v1.4.PrjPcb/19.SchDoc
cm3i/radxa-cm3i-io-board/altium/radxa_cm3i_io_board_schematic_v1.4.PrjPcb/20.SchDoc
cm3i/radxa-cm3i-io-board/altium/radxa_cm3i_io_board_schematic_v1.4.PrjPcb/21.SchDoc
cm3i/radxa-cm3i-io-board/altium/radxa_cm3i_io_board_schematic_v1.4.PrjPcb/22.SchDoc
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
