radxa/radxa-cm-projects/(commit log)

2021-11-08 Openwrt support
    I would like to port Openwrt on CM3 + Radxa E23 carrier board
2021-11-09 Requesting a board
2022-01-04 Add Radxa CM3 IO board design files
    [CM3_IO_V1.1_20211208.DSN]
2022-04-21 add exported Altime Designer project
    [01.SchDoc, 02.SchDoc, 03.SchDoc, 04.SchDoc, 05.SchDoc, 06.SchDoc, 07.SchDoc, 08.SchDoc]
2022-05-21 Add project for Robot-T500 (#27)
    Our next project will be based in the PI CM4, which is difficult to get stock of.
    And the Rock chips extra power will make a difference.
    This will our product more versatile and offer better application performance for Android and .NET
2022-05-21 Steward Camera (#25)
    * added steward camera.
    * updated steward camera description.
2022-05-21 Making the case for an OpenPlotter installation on the Radxa CM3 (#19)
2022-06-01 H264/H265 HDMI Video Encoder (#30)
    * Update README.md
    * Update README.md
    * Update README.md
2023-04-05 Add Radxa E25 carrier board design files
    [Radxa_E25_V1.4_20220119.PrjPcb, Radxa_E25_V14_20220117.DSN]
2023-05-07 Add T6x-FSBoard (#41)
    Drop-in replacement motherboard for 15.4 inch T61 / 14.1 inch 4:3 T61 + 14/15 inch T60.
    Currently designed for Radxa CM3/CM5 only, because of the SATA and USB3 capability. This might change in the future.
    First prototype (with limited capability) is close to getting sent out for PCB production.
    The idea is to have an m.2 slot for WiFi, and use the built-in NIC for onboard ethernet.
    Designing is around 40-50% done. Will open source the design (probably under the GPL) once the project is completed.
    Once the Radxa CM5 comes out, I will test that on this project too.
2023-11-27 Add each CM folders for its own projects file
    [01.SchDoc, 02.SchDoc, 03.SchDoc, 04.SchDoc, 05.SchDoc, 06.SchDoc, 07.SchDoc, 08.SchDoc]
2023-12-28 update radxa cm3 io board v1330 (#45)
    * update radxa cm3 io board v1330
    * simplify docs
    [01.SchDoc, 02.SchDoc, 03.SchDoc, 04.SchDoc, 05.SchDoc, 06.SchDoc, 07.SchDoc, 08.SchDoc]
2024-03-13 cm5: added cm5 io board v2200 design file
    [01_COVER.SchDoc, 02_INDEX.SchDoc, 03_Block.SchDoc, 04_HDMII_TX.SchDoc, 05_Ethernet.SchDoc, 06_MicroSD_Card.SchDoc, 07_PCIE_WIFI.SchDoc, 08_AUDIO.SchDoc]
2024-03-13 cm3s: added cm3s io board v1510 design files
    [01.SchDoc, 02.SchDoc, 03.SchDoc, 04.SchDoc, 05.SchDoc, 06.SchDoc, 07.SchDoc, 08.SchDoc]
2024-03-13 cm5: added cm5 io board README
2024-03-27 cm3i: added radxa cm3i io board design files (#52)
    * cm3i: added radxa cm3i io board design files
    * cm3i: delete DS_Store files
    * added the io board pictures
    * README: add cm3i io board
    * README: add cm3i io board
    [01.SchDoc, 02.SchDoc, 03.SchDoc, 04.SchDoc, 05.SchDoc, 06.SchDoc, 07.SchDoc, 08.SchDoc]
2024-05-16 cm3s: modified info and added ad file declaration
    [01.SchDoc, 02.SchDoc, 03.SchDoc, 04.SchDoc, 05.SchDoc, 06.SchDoc, 07.SchDoc, 08.SchDoc]
2024-05-16 nx5: added nx5 io board
    [01.SchDoc, 02.SchDoc, 03.SchDoc, 04.SchDoc, 05.SchDoc, 06.SchDoc, 07.SchDoc, 08.SchDoc]
2025-09-02 feat:add cm4 io board and modify mEdge series to nx series (#57)
    [02 Table of Content.SchDoc, 03 Block_Diagram.SchDoc, 04 TYPEC.SchDoc, 05 UFS.SchDoc, 06 Audio-CODEC.SchDoc, 07 Audio SPK.SchDoc, 08 VCC-Connetor.SchDoc, 09 High Speed-Connector.SchDoc]
2025-09-02 feat: add cm4 io board bom xlsx and adjust cm4 io board file location (#58)
    * feat:add cm4 io board and modify mEdge series to nx series
    * feat: add cm4 io board bom xlsx
    * fix: adjust cm4 io board file location
    [radxa_cm4_io_2d_dxf_bottom_v1.10.dxf, radxa_cm4_io_bom_v1.10.xlsx]
